cetola/reform-next-mirror/images/reform-next-cad-overview-ports.png

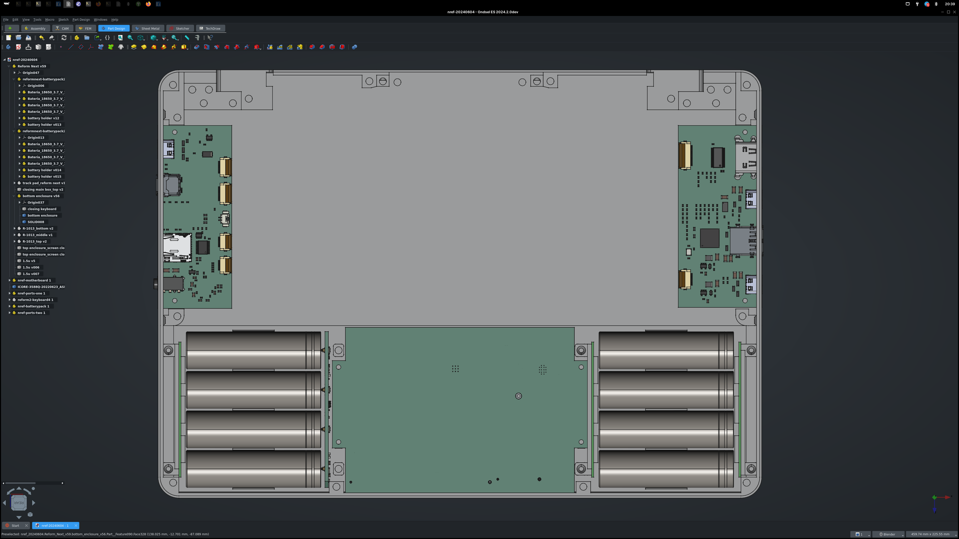
images/reform-next-cad-overview-ports.png
