cetola/reform-next-mirror/images/reform-next-ports-three-iso.png

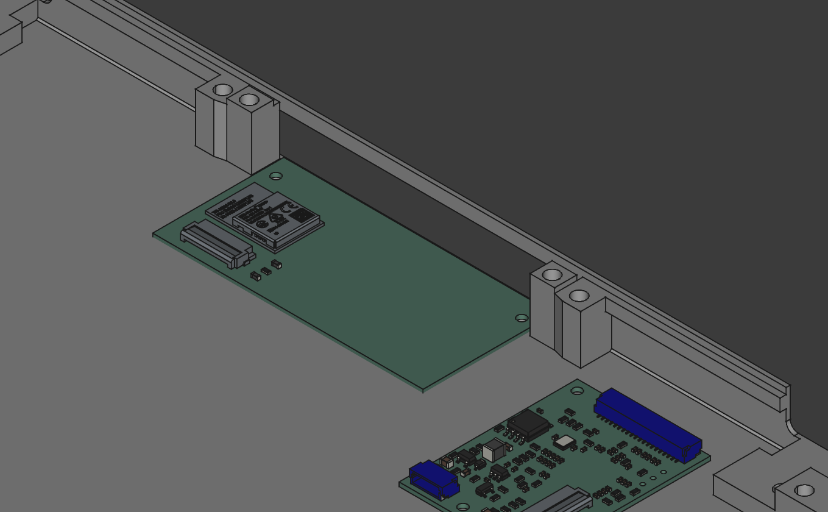
images/reform-next-ports-three-iso.png
