cetola/reform-next-mirror/images/reform-next-ports-two-with-kb.png

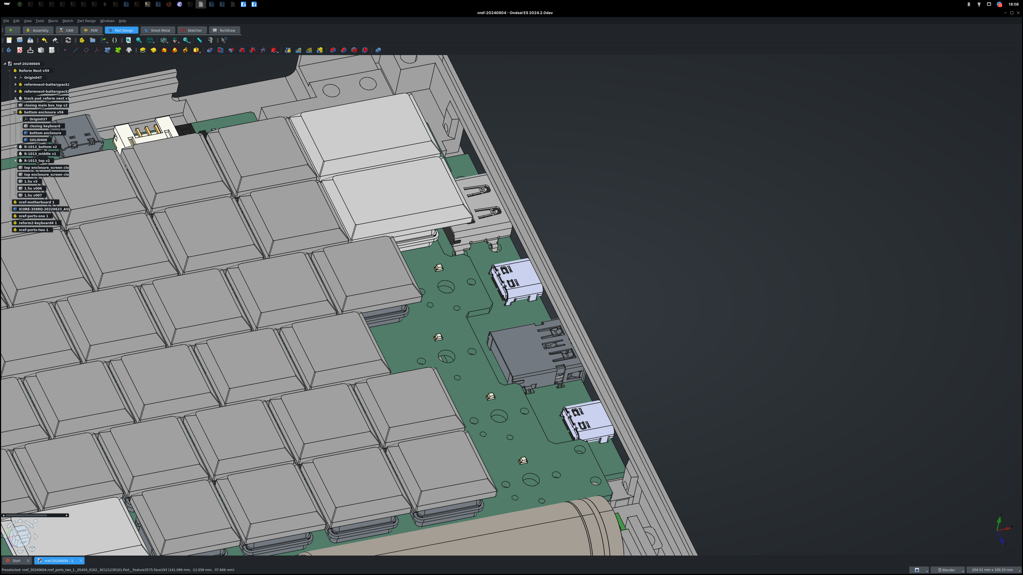
images/reform-next-ports-two-with-kb.png
