cetola/reform-next-mirror/nref-batterypack-v3/footprints/nref-battback-d1.png

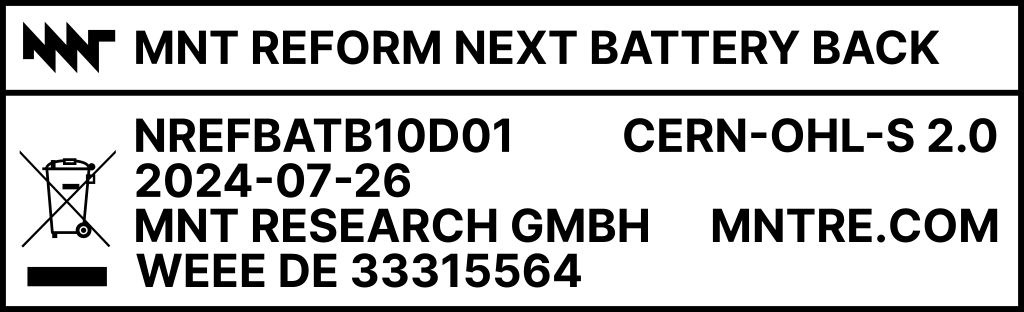
nref-batterypack-v3/footprints/nref-battback-d1.png
