cetola/reform-next-mirror/nref-batterypack-v3/footprints/nref-batttop-d3.png

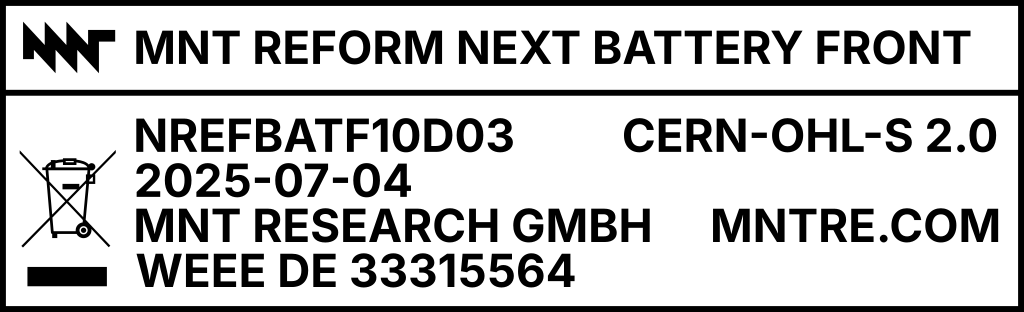
nref-batterypack-v3/footprints/nref-batttop-d3.png
