cetola/reform-next-mirror/reform-next-render.jpg

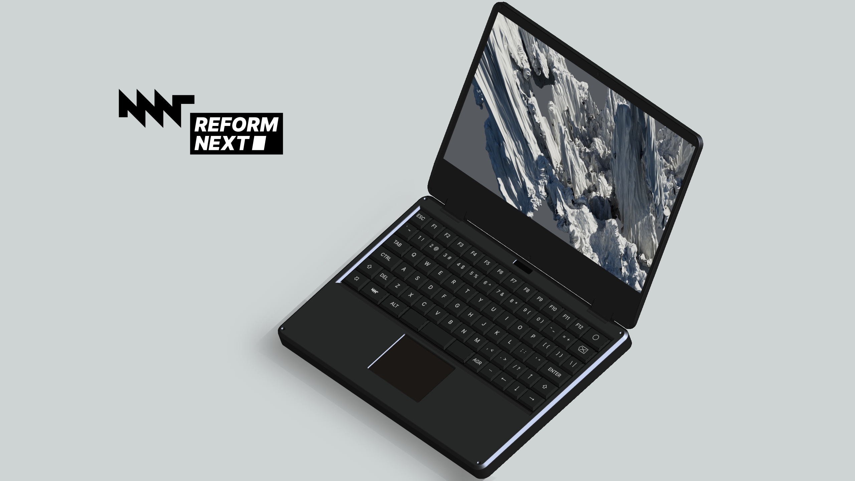
reform-next-render.jpg
