cetola/reform-next-mirror/case-proto-20240129/nref-case-20240201-assembly.FCStd

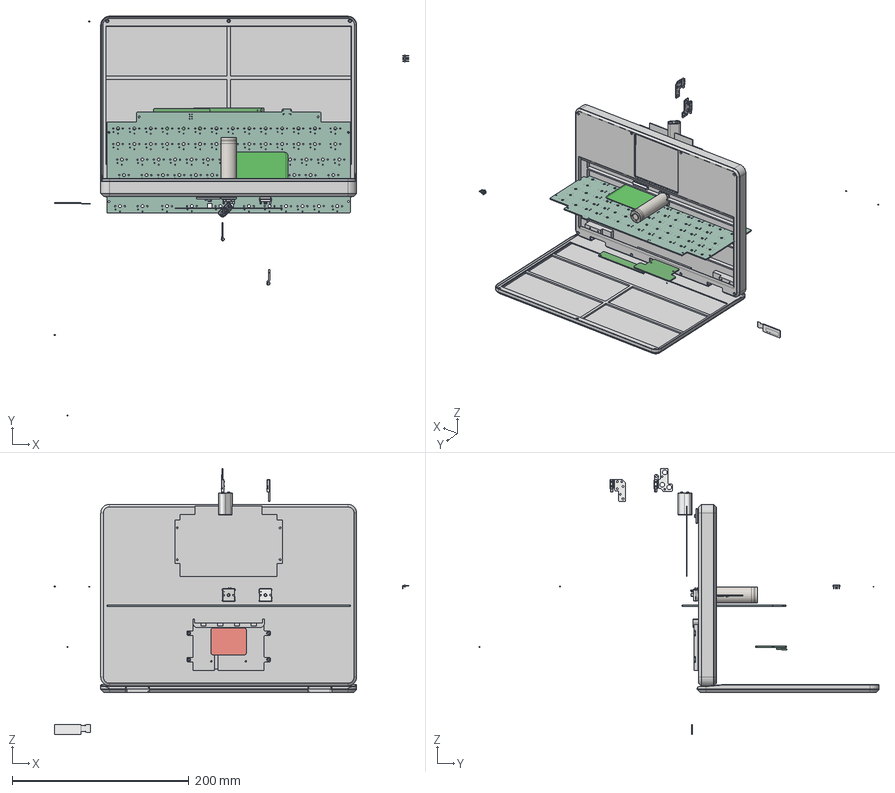
[picture p42: CAD file, 2024-02-22]
case-proto-20240129/nref-case-20240201-assembly.FCStd
402.3 x 452.9 x 301.7 mm
U-QFN-P0.5-7X7-48:1
sms-zz-219-r-1013-k:1
sms-zz-219-r-1013-k:002
sms-zz-219-r-1013-k:003
plastic battery hoder v5:1
battery pck pcb v4:1
trackingpad support_cnc:1
glass (1):1
GLUE AZOTEQ:1
GLUE SLA:1
C-0402:1
C-0603:1
R-0603:1
closing keyboard:1
bottom enclosure:1
top enclosure_screen closing v8:1
top enclosure_screen closing back v5:1
reform next motherboard v6:1
SOLID107 v1:1
COMPOUND019 v2:1
reform2-keyboard3 PCB:1
