cetola/reform-next-mirror/case-proto-20240129/bottom enclosure_2024.01.29.stl

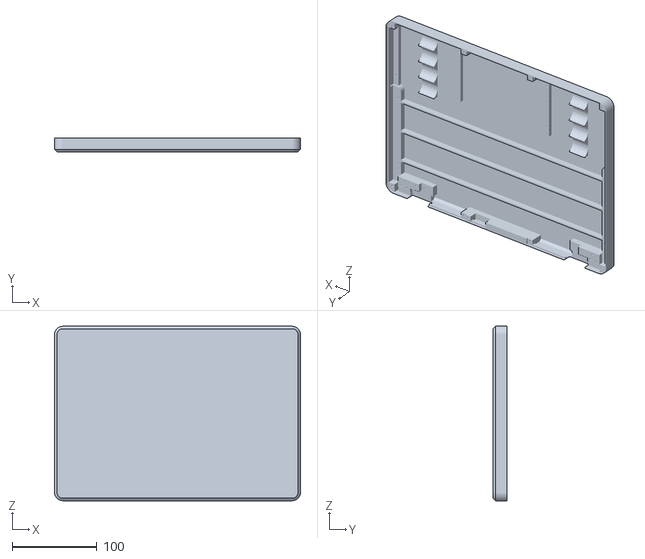
[picture p43: CAD file, 2024-02-22]
case-proto-20240129/bottom enclosure_2024.01.29.stl
290.0 x 16.5 x 205.8
