cetola/reform-next-mirror/hdmi-edp2/3d-models/SM06B-SRSS-TB.STEP

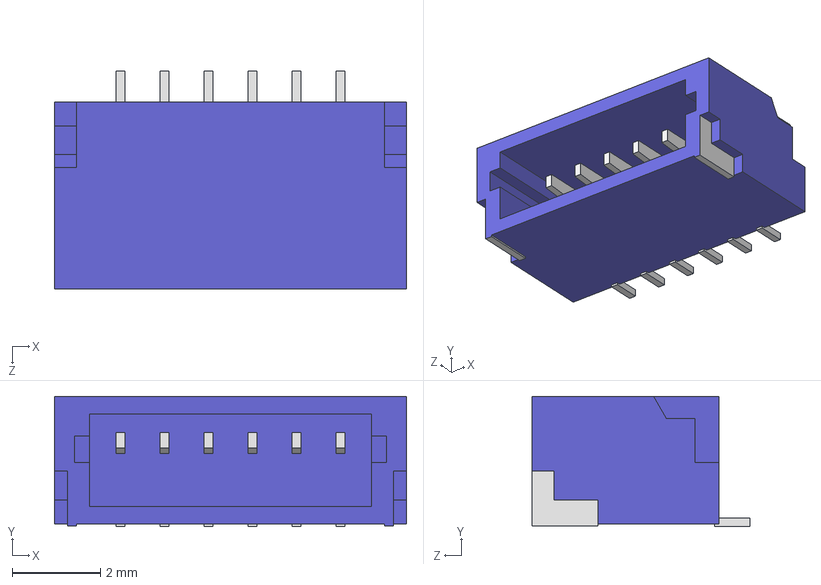
[picture p44: CAD file, 2024-04-29]
hdmi-edp2/3d-models/SM06B-SRSS-TB.STEP
8.00 x 2.96 x 4.95 mm
