cetola/reform-next-mirror/nref-batterypack-v3/3d-models/BAT-SMD_MY-FJ-115.step

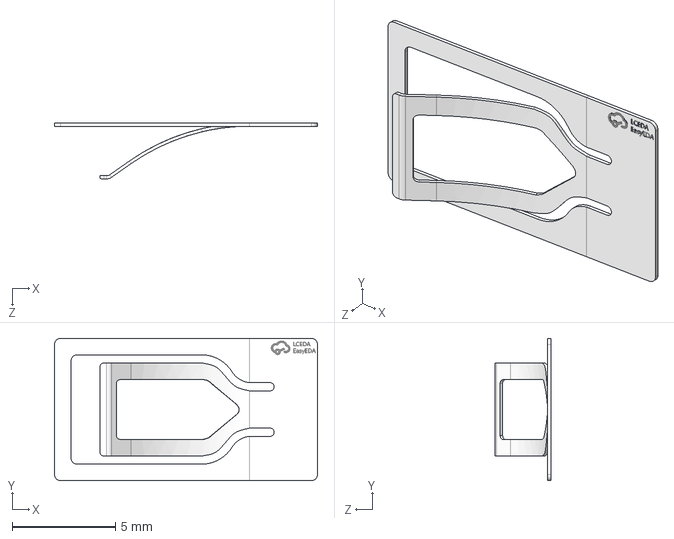
[picture p45: CAD file, 2026-09-02]
nref-batterypack-v3/3d-models/BAT-SMD_MY-FJ-115.step
12.7 x 6.90 x 2.70 mm
