cetola/reform-next-mirror/nref-camera-adapter/3d-models/SM20B-SRSS-TB.STEP

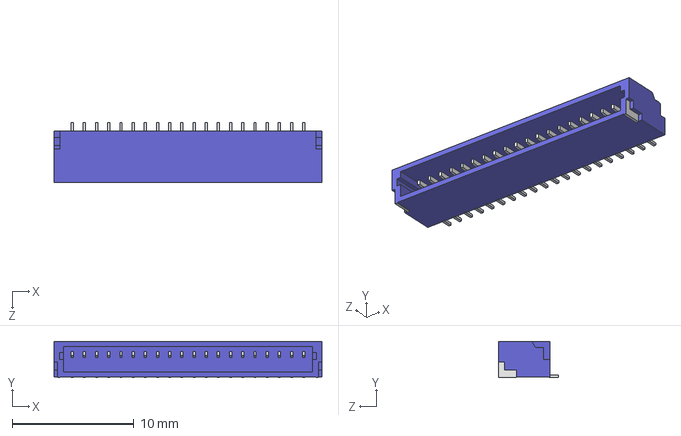
[picture p46: CAD file, 2024-04-29]
nref-camera-adapter/3d-models/SM20B-SRSS-TB.STEP
22.0 x 2.96 x 4.95 mm
