cetola/reform-next-mirror/nref-camera/3dmodels/PW0014A.stp

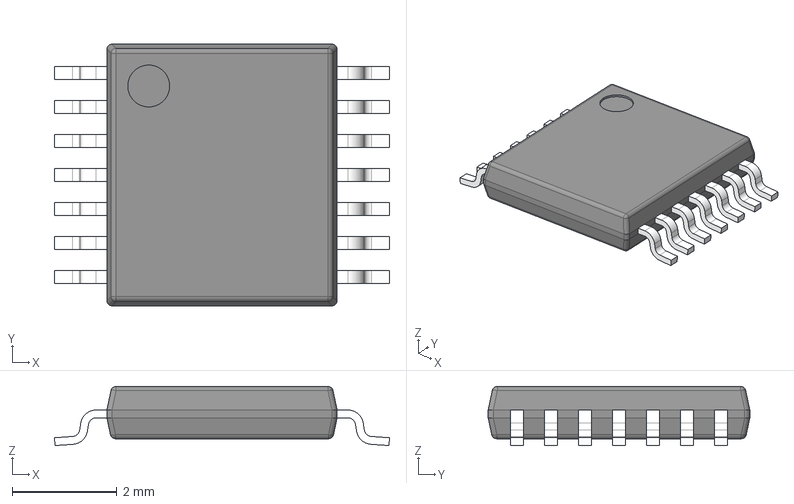
[picture p47: CAD file, 2024-08-22]
nref-camera/3dmodels/PW0014A.stp
6.40 x 5.00 x 1.13 mm
BODY-TSSOP
LEAD-TSSOP x 14
PIN1
