cetola/reform-next-mirror/nref-motherboard/3d-models/BQ25792/Part.step

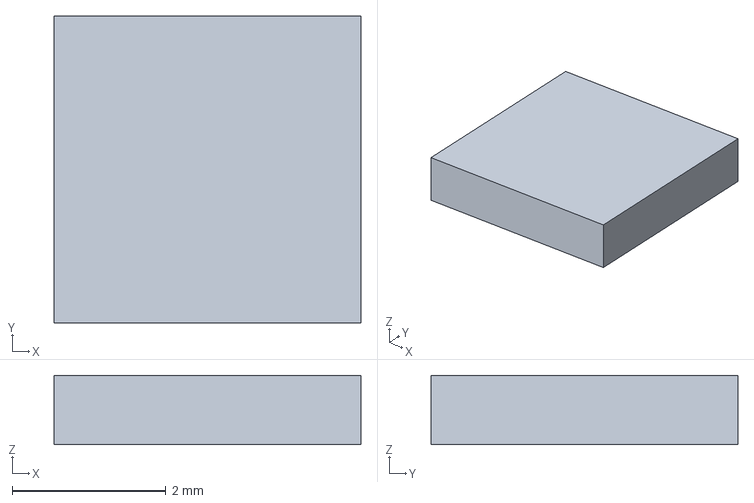
[picture p48: CAD file, 2025-02-27]
nref-motherboard/3d-models/BQ25792/Part.step
4.00 x 4.00 x 0.9 mm
