cetola/reform-next-mirror/nref-motherboard/3d-models/SM03B-SRSS-TB_LF__SN_.stp

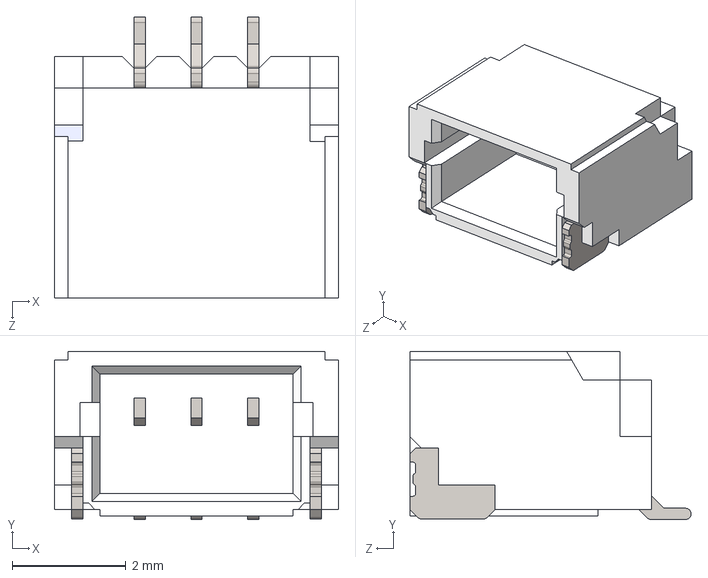
[picture p49: CAD file, 2026-05-07]
nref-motherboard/3d-models/SM03B-SRSS-TB_LF__SN_.stp
5.00 x 2.96 x 4.95 mm
