cetola/reform-next-mirror/nref-ports-one/3d-models/HX5084NLT.stp

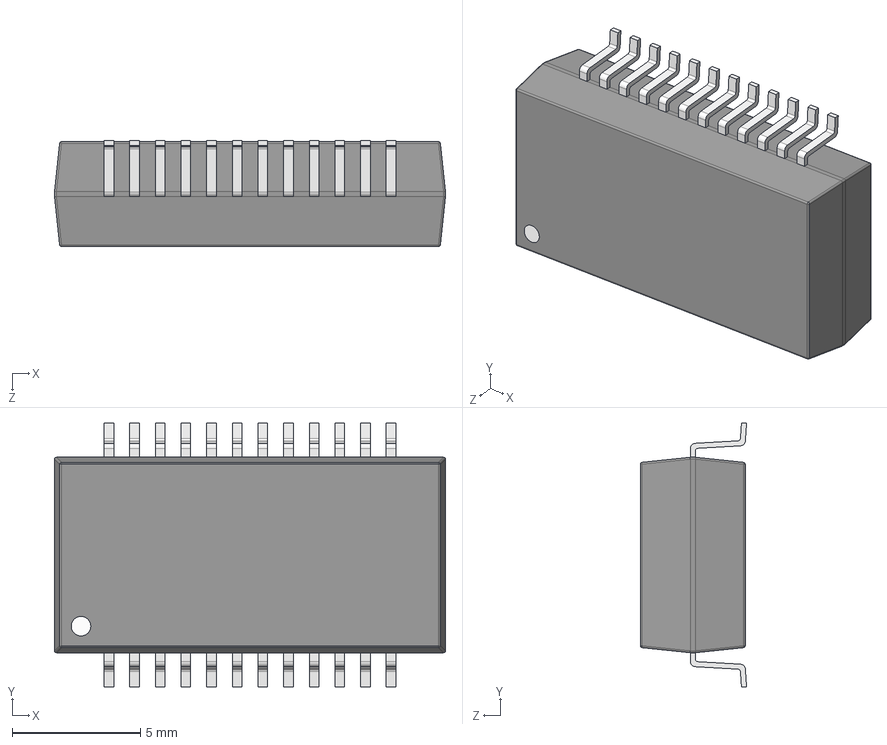
[picture p50: CAD file, 2026-09-02]
nref-ports-one/3d-models/HX5084NLT.stp
15.2 x 10.3 x 4.14 mm
