cetola/reform-next-mirror/nref-ports-two/3d-models/USB-A-SMD_HC-USB3.0-C225-P.step

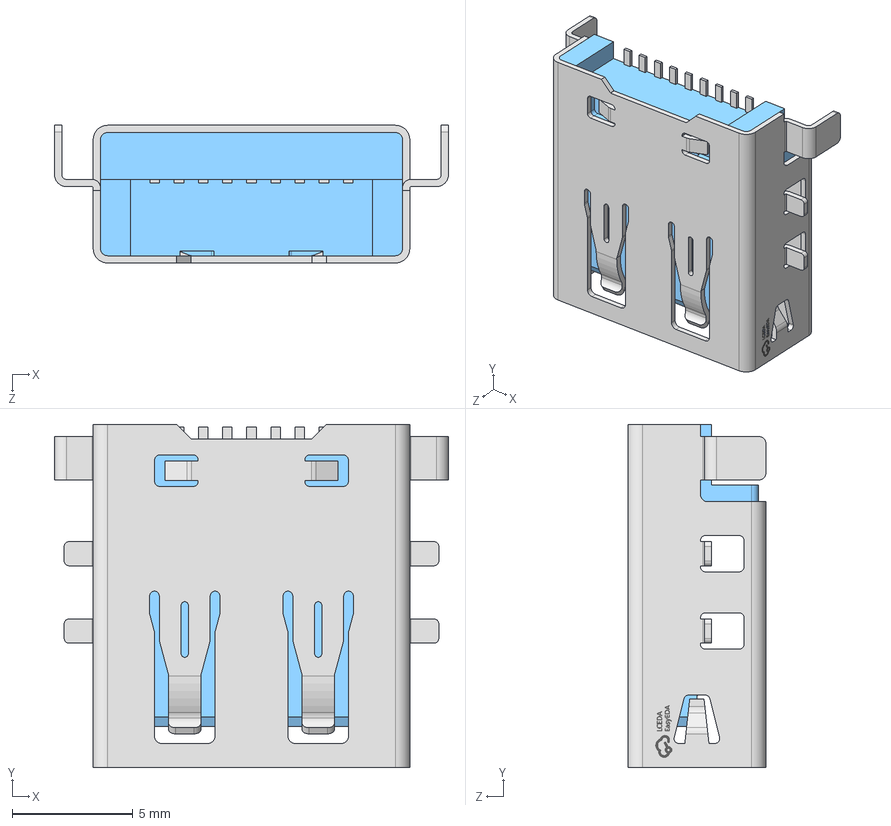
[picture p51: CAD file, 2026-07-24]
nref-ports-two/3d-models/USB-A-SMD_HC-USB3.0-C225-P.step
16.3 x 14.2 x 5.71 mm
