cetola/reform-next-mirror/nref-trackpad-mount/nref-20260419-hexplug.stl

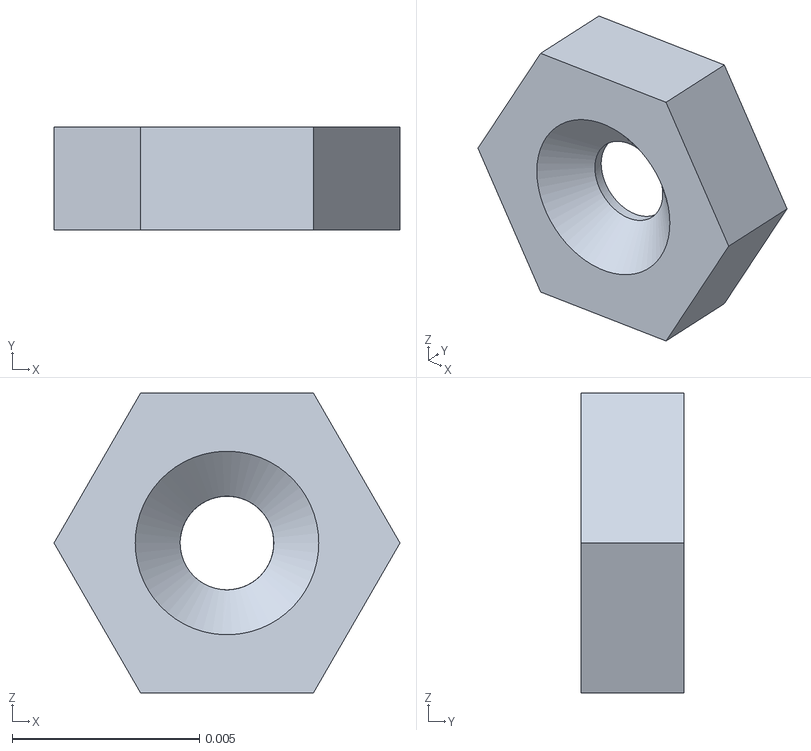
[picture p52: CAD file, 2026-08-20]
nref-trackpad-mount/nref-20260419-hexplug.stl
0.00924 x 0.00275 x 0.008
