cetola/reform-next-mirror/nref-trackpad/3d-models/nref_keycap_2024.08.20.step

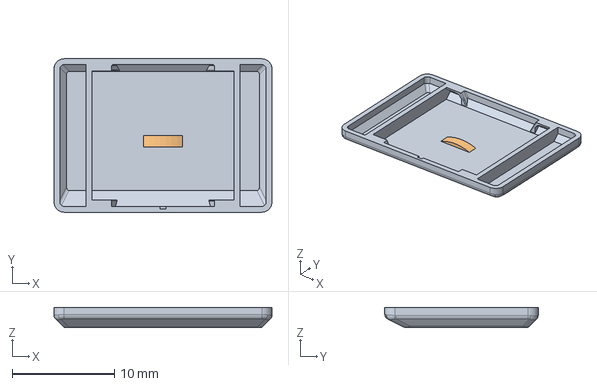
[picture p53: CAD file, 2024-08-22]
nref-trackpad/3d-models/nref_keycap_2024.08.20.step
21.3 x 15.0 x 2.00 mm
