cetola/reform-next-mirror/nref-trackpad/nref-trackpad-mount-20241202.stl

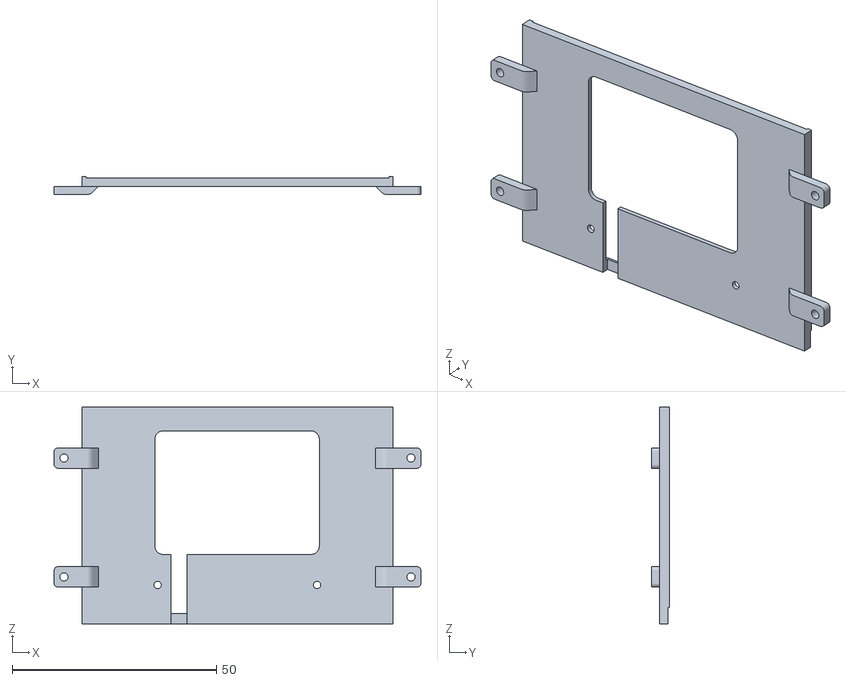
[picture p54: CAD file, 2024-12-27]
nref-trackpad/nref-trackpad-mount-20241202.stl
89.8 x 4.44 x 53.1
