cetola/reform-next-mirror/nref-usb3-redriver/3d-models/RGE0024C.stp

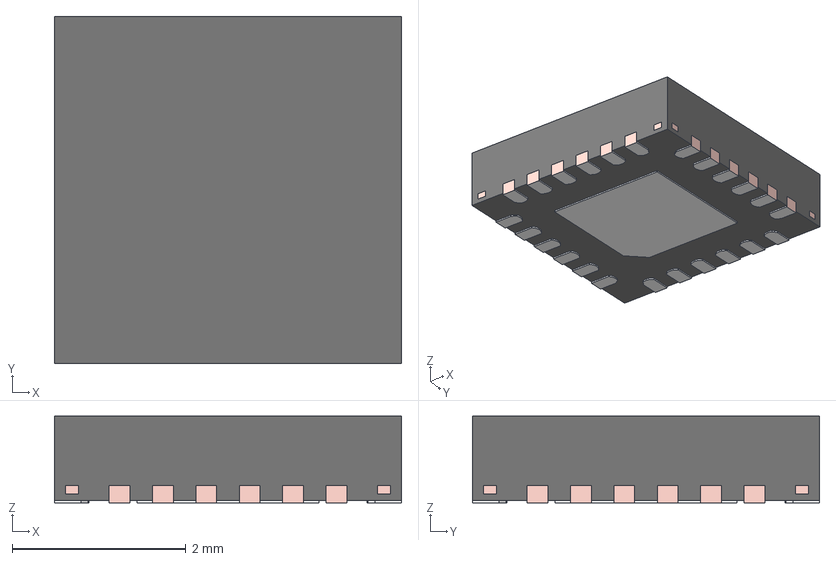
[picture p55: CAD file, 2025-09-24]
nref-usb3-redriver/3d-models/RGE0024C.stp
4.00 x 4.00 x 1.00 mm
FRAME
