cetola/reform-next-mirror/nref-wifi-m2/3d-models/User Library-PCIe_M_2_Key-E_2230_RF.STEP

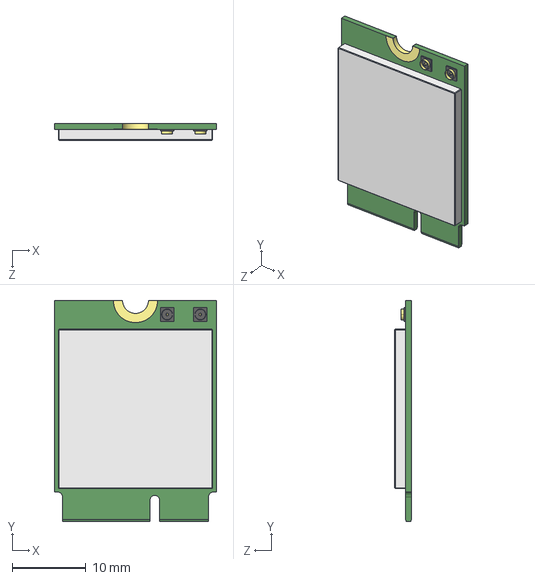
[picture p56: CAD file, 2025-09-24]
nref-wifi-m2/3d-models/User Library-PCIe_M_2_Key-E_2230_RF.STEP
22.0 x 30.0 x 2.30 mm
