cetola/reform-next-mirror/nref-batterypack-v3/3d-models/2036-3-57-15-00-00-03-0.stp

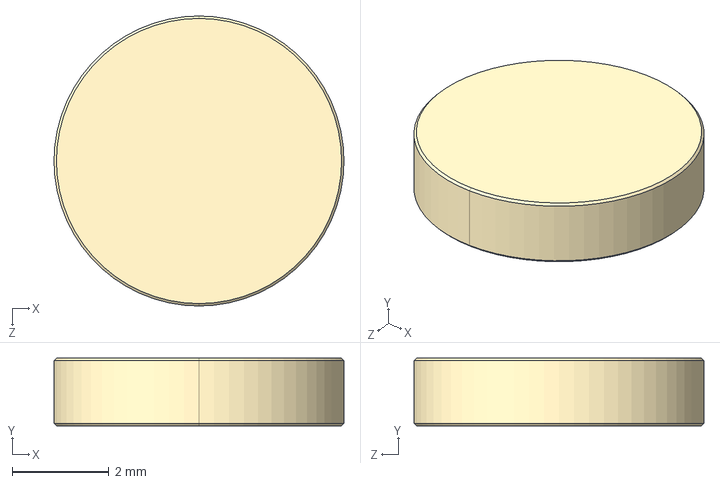
[picture p58: CAD file, 2026-09-02]
nref-batterypack-v3/3d-models/2036-3-57-15-00-00-03-0.stp
5.99 x 1.40 x 5.99 mm
