cetola/reform-next-mirror/nref-camera/3dmodels/WLCSP-6_2x3_0.8x1.2mm.STEP

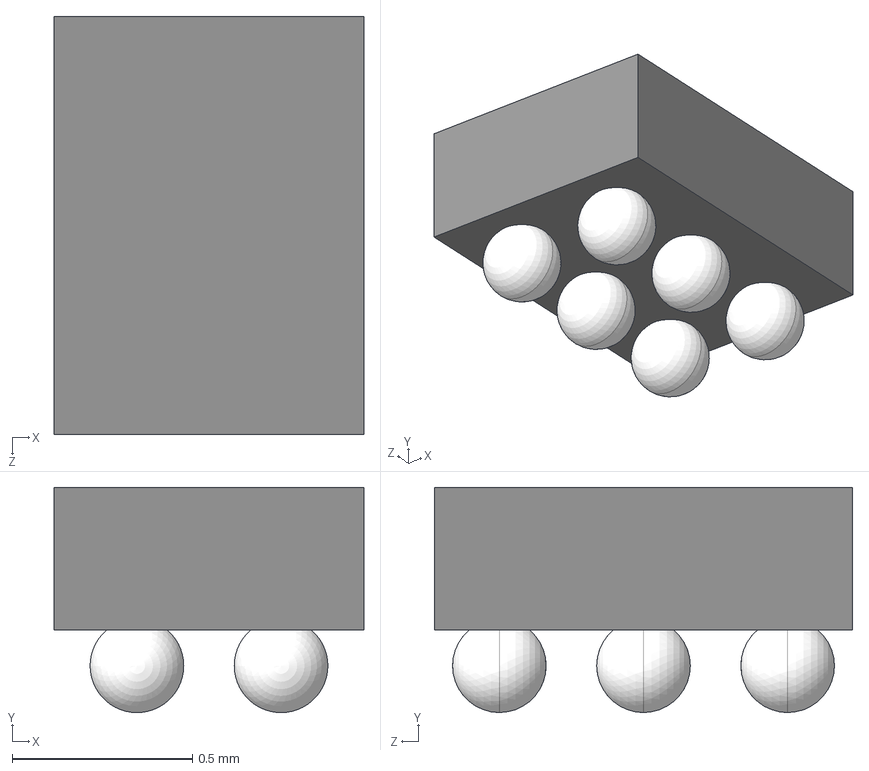
[picture p59: CAD file, 2024-08-15]
nref-camera/3dmodels/WLCSP-6_2x3_0.8x1.2mm.STEP
0.86 x 0.625 x 1.16 mm
