cetola/reform-next-mirror/nref-motherboard/3d-models/SM04B-SRSS-TB.STEP

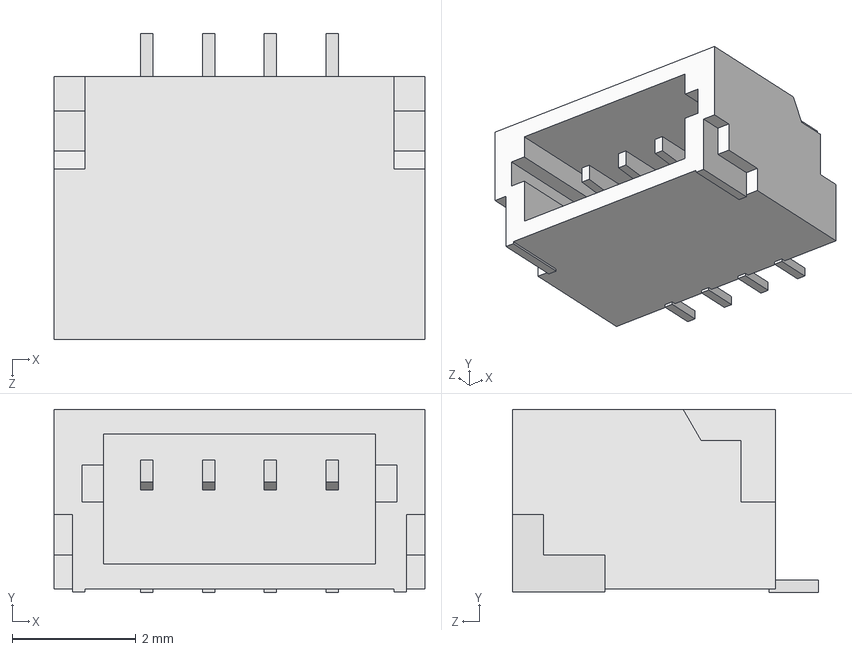
[picture p60: CAD file, 2026-05-07]
nref-motherboard/3d-models/SM04B-SRSS-TB.STEP
6.00 x 2.96 x 4.95 mm
