cetola/reform-next-mirror/nref-ports-two/3d-models/FPC-SMD_L15.6-W5.4-H2.0-AFC07-S20ECC-00.step

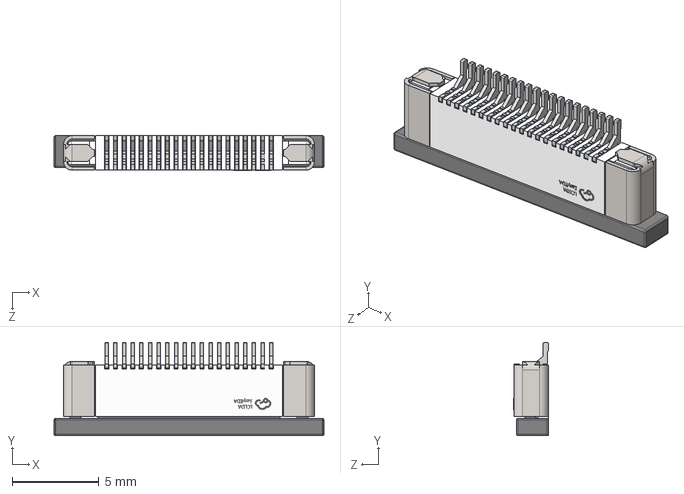
[picture p61: CAD file, 2026-07-24]
nref-ports-two/3d-models/FPC-SMD_L15.6-W5.4-H2.0-AFC07-S20ECC-00.step
15.6 x 5.40 x 2.01 mm
