cetola/reform-next-mirror/nref-wifi-m2/3d-models/c-2199119-4-c-3d.stp

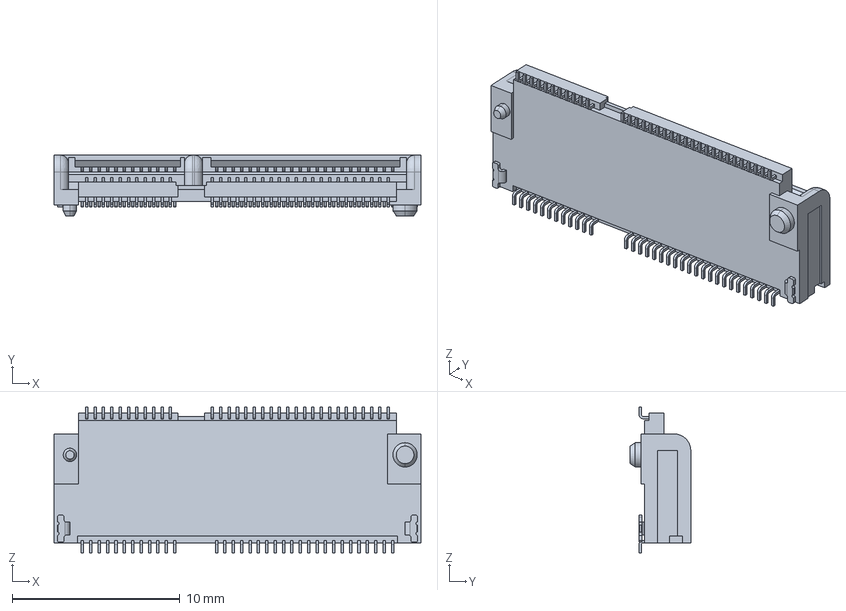
[picture p62: CAD file, 2025-09-24]
nref-wifi-m2/3d-models/c-2199119-4-c-3d.stp
21.9 x 3.62 x 8.70 mm
