cetola/reform-next-mirror/nref-batterypack-v3/3d-models/L4CA0612LR015FNR.stp

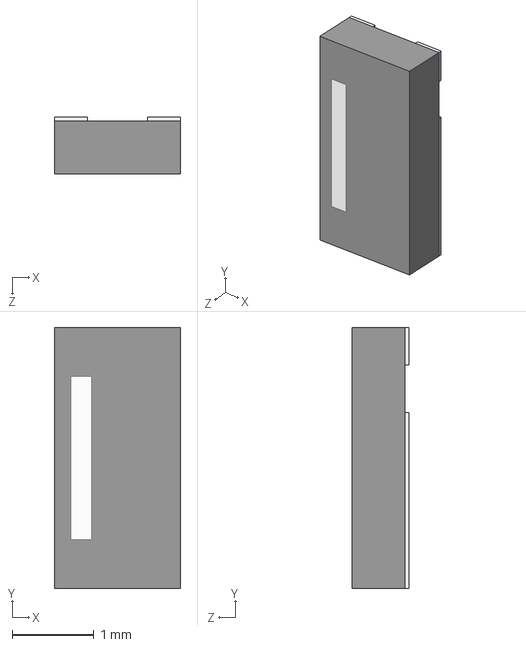
[picture p64: CAD file, 2025-09-24]
nref-batterypack-v3/3d-models/L4CA0612LR015FNR.stp
1.55 x 3.20 x 0.7 mm
