cetola/reform-next-mirror/nref-camera/3dmodels/K3D-DX07S024WJ3-V2_JAE_Proprietary.STEP

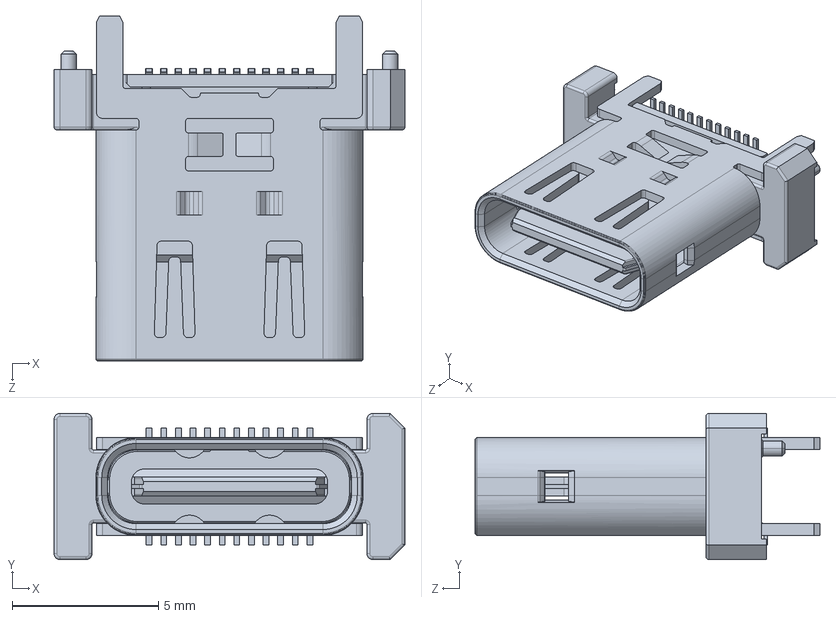
[picture p65: CAD file, 2024-08-15]
nref-camera/3dmodels/K3D-DX07S024WJ3-V2_JAE_Proprietary.STEP
12.0 x 5.00 x 11.8 mm
