cetola/reform-next-mirror/nref-ports-one/3d-models/PCA9557RGVR.stp

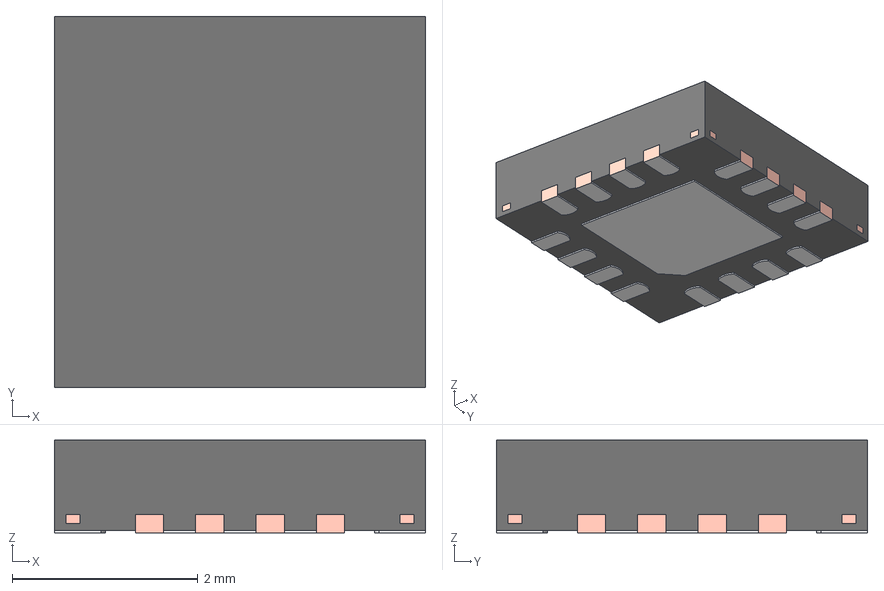
[picture p66: CAD file, 2025-11-12]
nref-ports-one/3d-models/PCA9557RGVR.stp
4.00 x 4.00 x 1.00 mm
FRAME
PIN1_AREA
