cetola/reform-next-mirror/nref-ports-two/3d-models/SFV20R-2STE1HLF.step

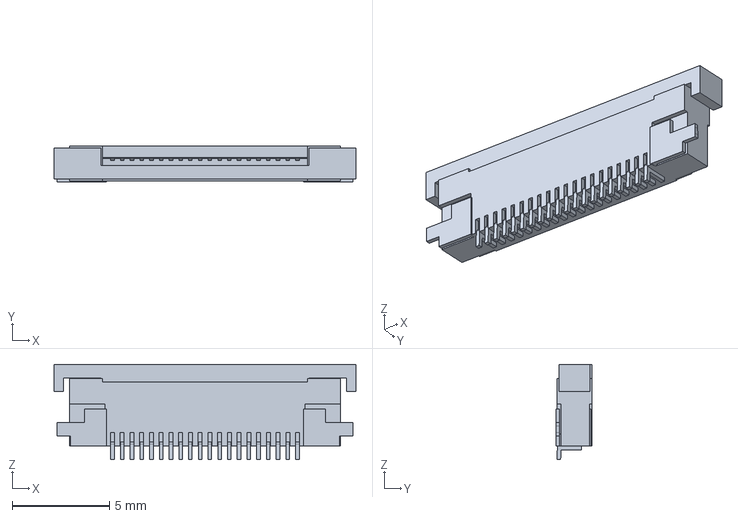
[picture p67: CAD file, 2025-11-19]
nref-ports-two/3d-models/SFV20R-2STE1HLF.step
15.5 x 1.87 x 4.90 mm
