cetola/reform-next-mirror/nref-batterypack-v3/3d-models/S1741-46R.stp

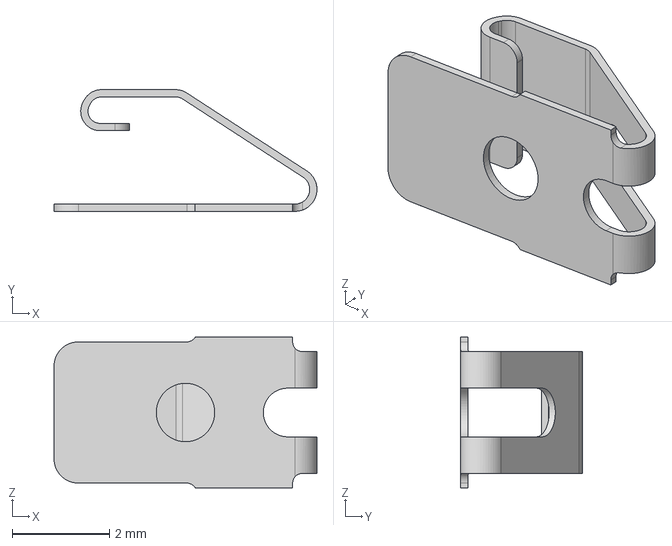
[picture p68: CAD file, 2025-09-24]
nref-batterypack-v3/3d-models/S1741-46R.stp
5.40 x 2.50 x 3.10 mm
