cetola/reform-next-mirror/nref-camera/3dmodels/YFP4.step

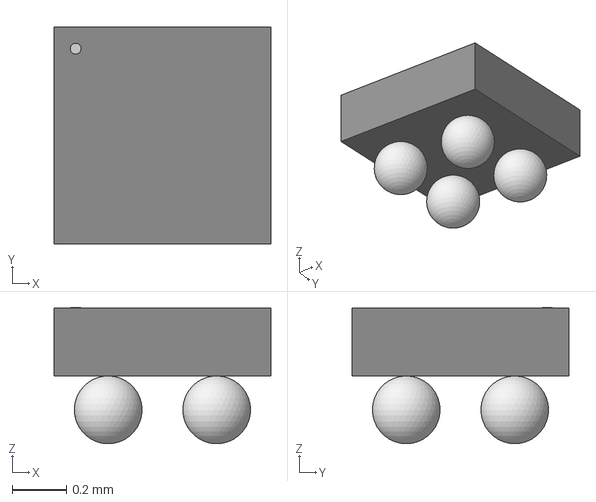
[picture p69: CAD file, 2024-08-15]
nref-camera/3dmodels/YFP4.step
0.8 x 0.8 x 0.503 mm
