cetola/reform-next-mirror/nref-motherboard/3d-models/AOTA-B201610S3R3-101-T.stp

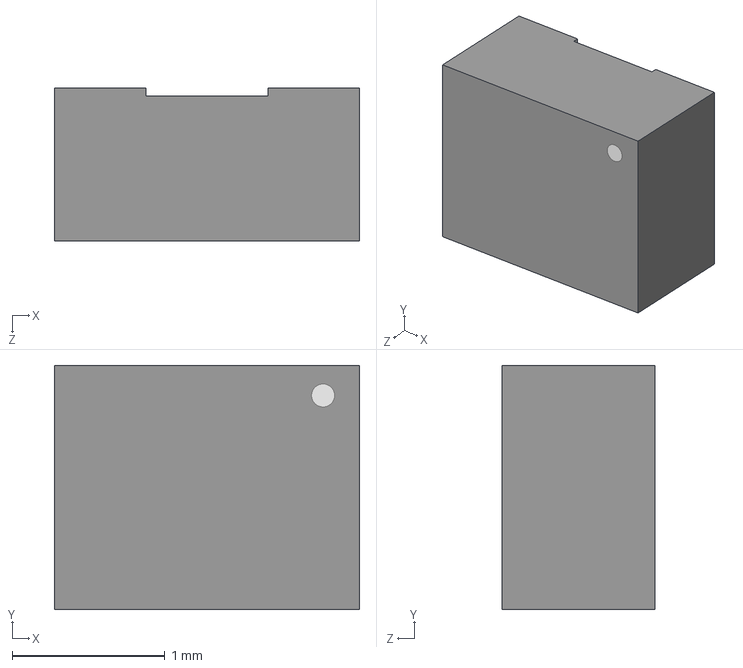
[picture p70: CAD file, 2026-05-07]
nref-motherboard/3d-models/AOTA-B201610S3R3-101-T.stp
2.00 x 1.60 x 1.00 mm
