cetola/reform-next-mirror/nref-ports-one/3d-models/B3U-3000P--3DModel-STEP-56544.STEP

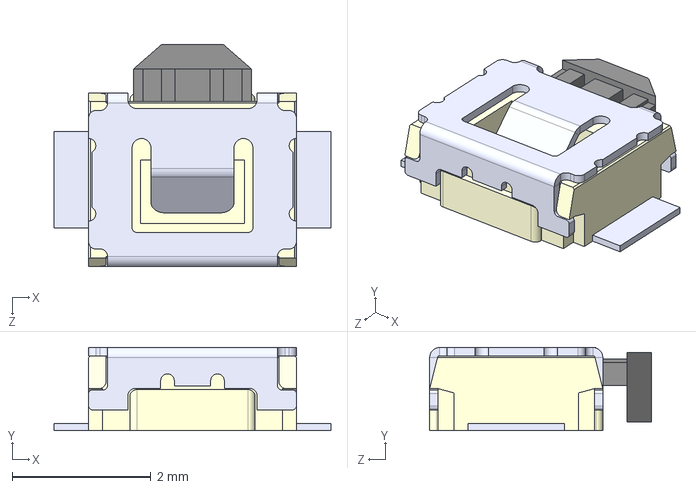
[picture p71: CAD file, 2025-10-31]
nref-ports-one/3d-models/B3U-3000P--3DModel-STEP-56544.STEP
4.00 x 1.20 x 3.20 mm
