cetola/reform-next-mirror/nref-ports-two/3d-models/EQCO5X31C0-I_6NX.stp

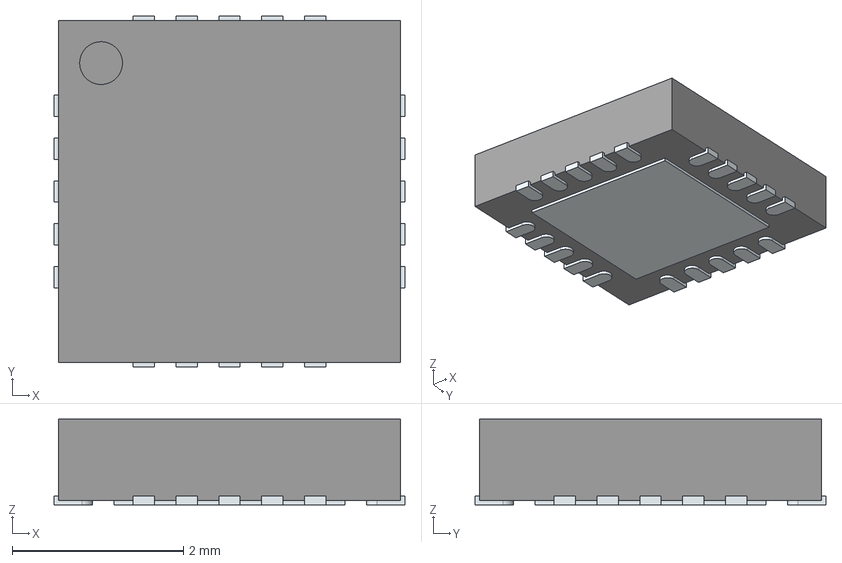
[picture p72: CAD file, 2025-10-31]
nref-ports-two/3d-models/EQCO5X31C0-I_6NX.stp
4.10 x 4.10 x 1.00 mm
ThermalPin
PinsArrayLR
PinsArrayTB
