cetola/reform-next-mirror/case-proto-20240129/top enclosure_screen closing back_2024.01.29.stl

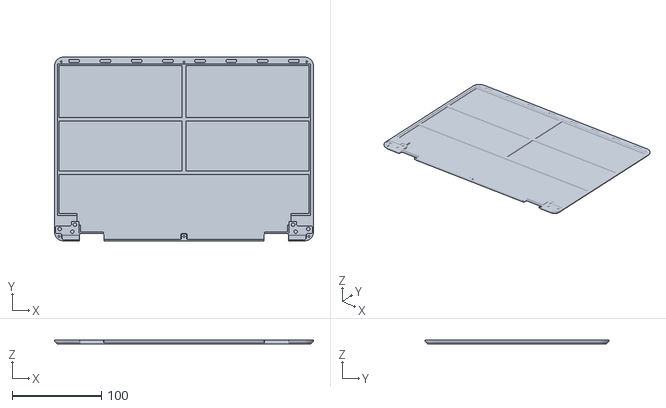
[picture p73: CAD file, 2024-02-22]
case-proto-20240129/top enclosure_screen closing back_2024.01.29.stl
290.0 x 205.8 x 4.50
