cetola/reform-next-mirror/nref-camera/3dmodels/Nexperia-WLCSP5_2-1-2_0.77x1.17mm.step

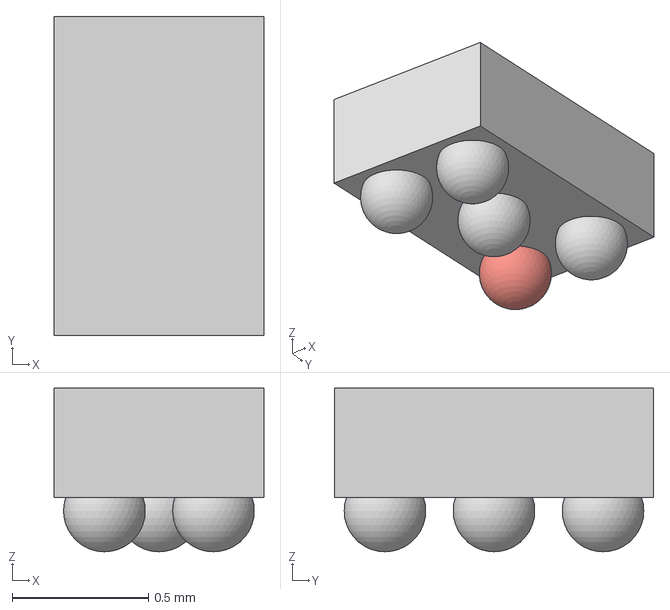
[picture p74: CAD file, 2024-08-15]
nref-camera/3dmodels/Nexperia-WLCSP5_2-1-2_0.77x1.17mm.step
0.77 x 1.17 x 0.6 mm
