cetola/reform-next-mirror/nref-motherboard/3d-models/SSD.STEP

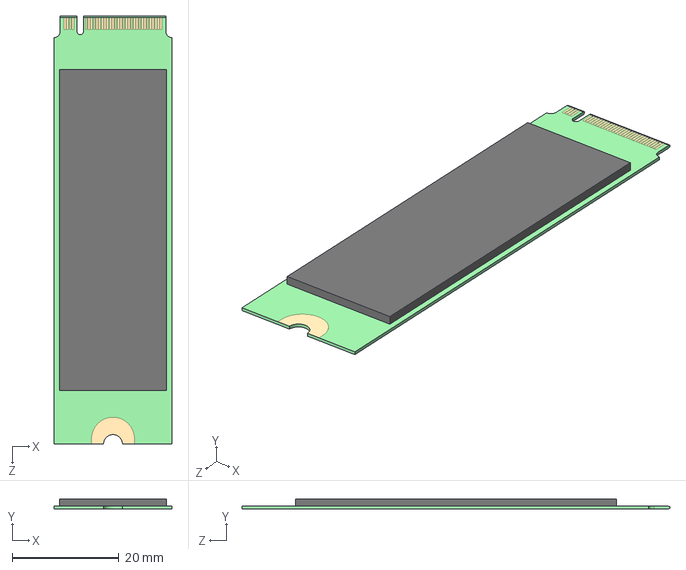
[picture p75: CAD file, 2026-05-07]
nref-motherboard/3d-models/SSD.STEP
22.0 x 1.86 x 80.0 mm
