cetola/reform-next-mirror/nref-ports-one/3d-models/YBG0028_TEX.step

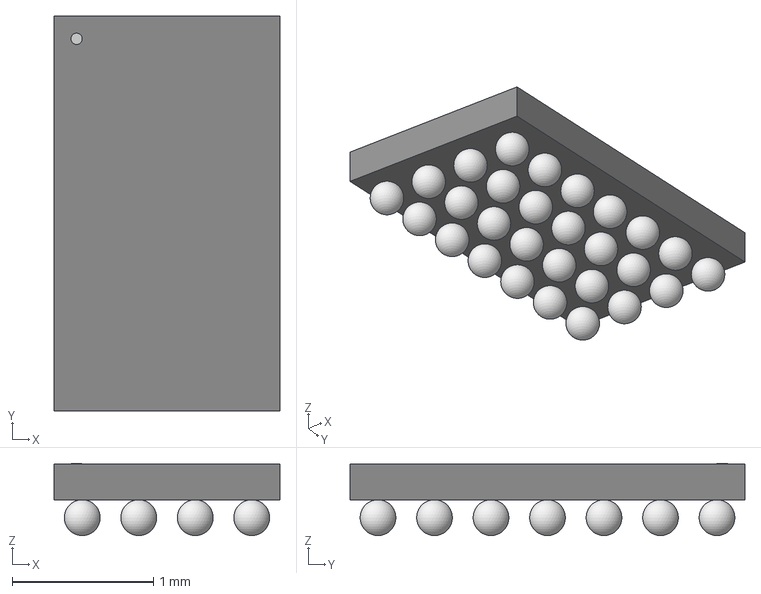
[picture p76: CAD file, 2025-10-31]
nref-ports-one/3d-models/YBG0028_TEX.step
1.60 x 2.79 x 0.511 mm
