cetola/reform-next-mirror/nref-ports-two/3d-models/HD3SS3220IRNHT.step

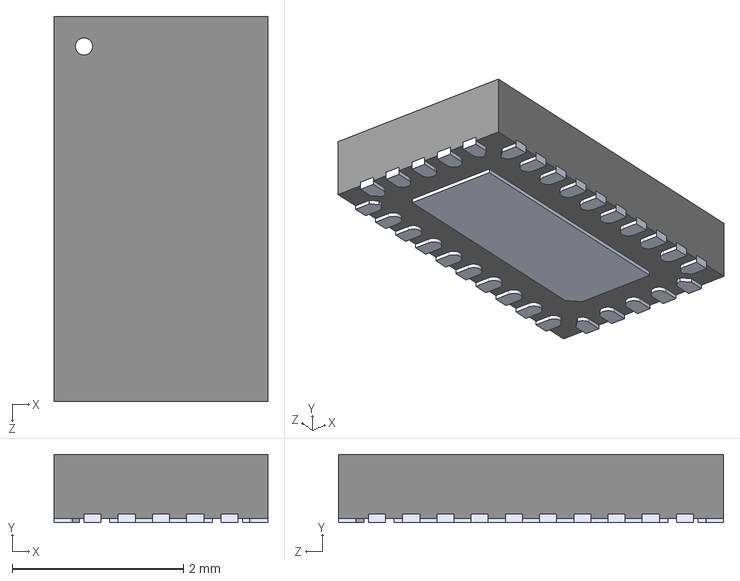
[picture p77: CAD file, 2024-06-14]
nref-ports-two/3d-models/HD3SS3220IRNHT.step
2.50 x 0.8 x 4.50 mm
