cetola/reform-next-mirror/case-proto-20240129/closing keyboard_2024.01.29.stl

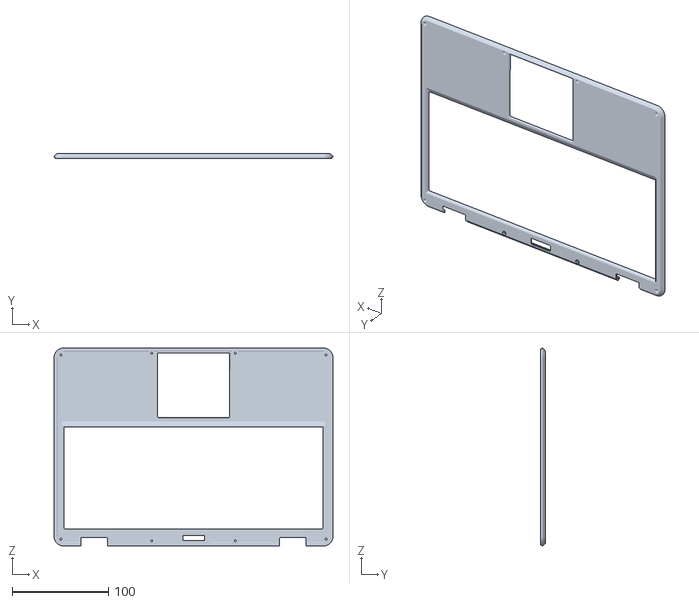
[picture p78: CAD file, 2024-02-22]
case-proto-20240129/closing keyboard_2024.01.29.stl
290.0 x 5.00 x 205.8
