cetola/reform-next-mirror/nref-batterypack-v3/3d-models/S70-332002045R.stp

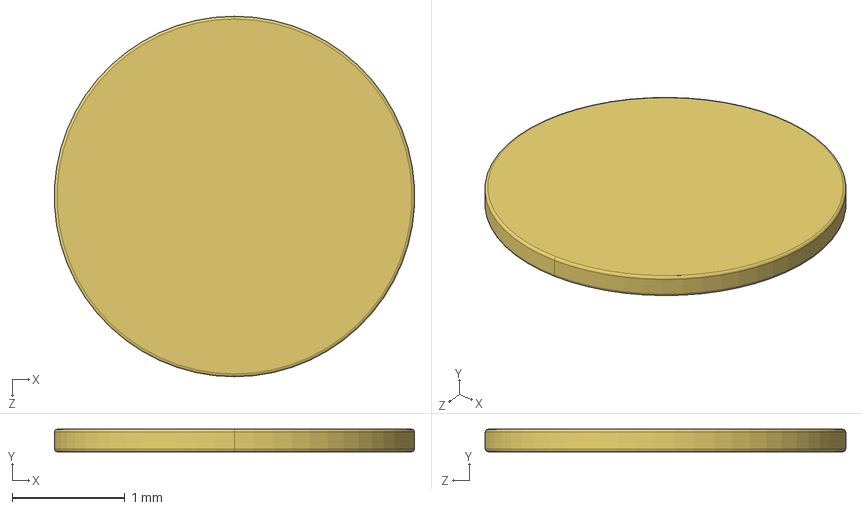
[picture p79: CAD file, 2025-09-24]
nref-batterypack-v3/3d-models/S70-332002045R.stp
3.20 x 0.2 x 3.20 mm
