cetola/reform-next-mirror/nref-camera/3dmodels/CYUSB3064-BZXI.STEP

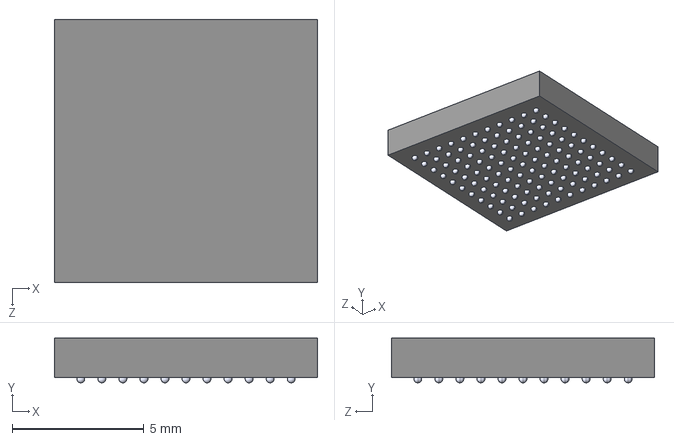
[picture p80: CAD file, 2024-08-15]
nref-camera/3dmodels/CYUSB3064-BZXI.STEP
10.0 x 1.70 x 10.0 mm
