cetola/reform-next-mirror/nref-ports-one/3d-models/RKS0020A.stp

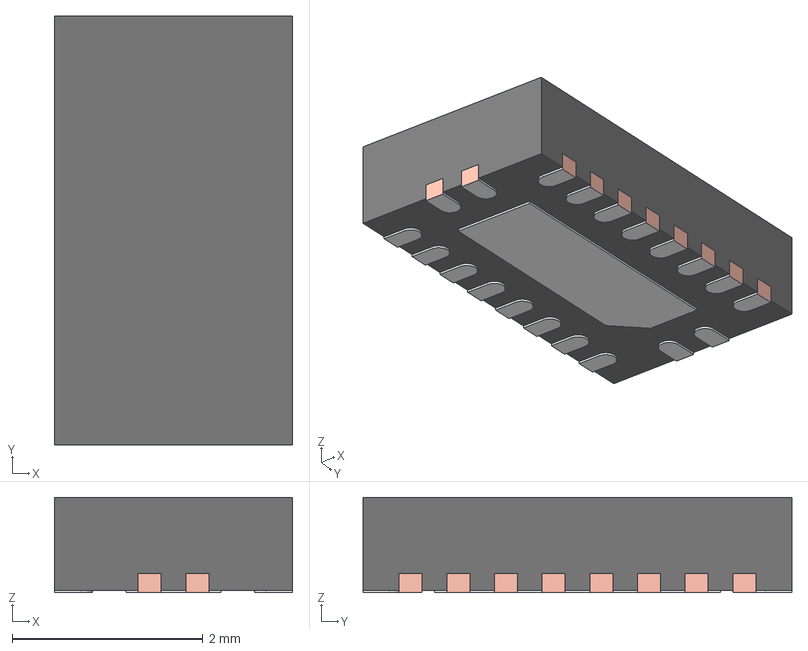
[picture p82: CAD file, 2024-08-15]
nref-ports-one/3d-models/RKS0020A.stp
2.50 x 4.50 x 1.00 mm
BODY-QFN
FRAME-RKS0020A
PIN1-ID
