cetola/reform-next-mirror/nref-ports-two/3d-models/HD09-19-MSMT-TR.stp

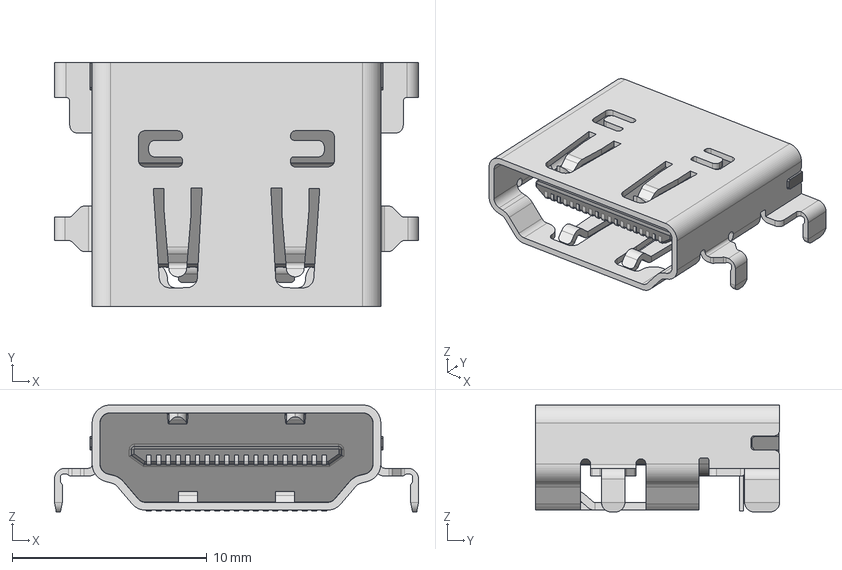
[picture p83: CAD file, 2024-06-11]
nref-ports-two/3d-models/HD09-19-MSMT-TR.stp
18.7 x 12.6 x 5.50 mm
