cetola/reform-next-mirror/nref-batterypack-v3/3d-models/BM07B-SRSS-TB.STEP

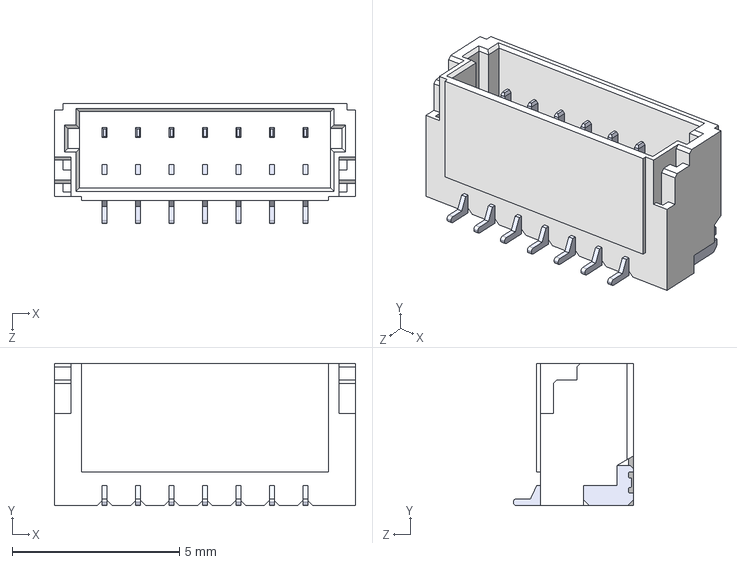
[picture p84: CAD file, 2025-09-24]
nref-batterypack-v3/3d-models/BM07B-SRSS-TB.STEP
9.00 x 4.25 x 3.60 mm
