cetola/reform-next-mirror/nref-camera/3dmodels/USB4115-03-C.stp

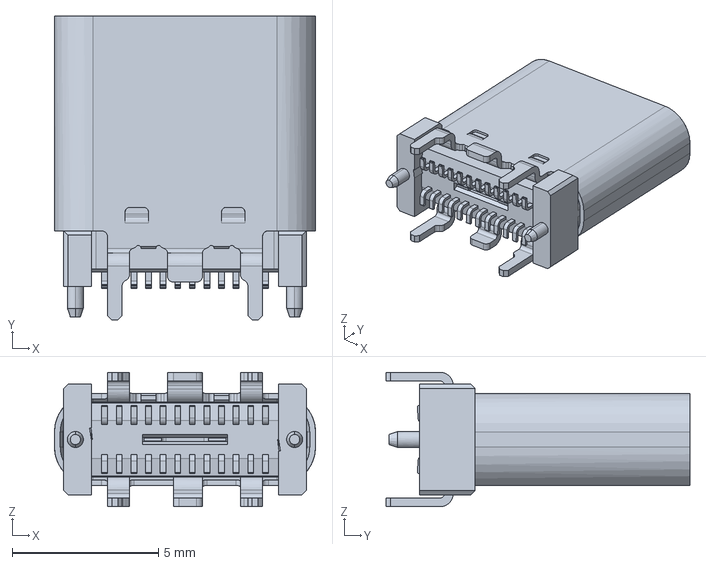
[picture p85: CAD file, 2024-08-15]
nref-camera/3dmodels/USB4115-03-C.stp
8.94 x 10.4 x 4.60 mm
