cetola/reform-next-mirror/nref-motherboard/3d-models/SM02B-SRSS-TB.STEP

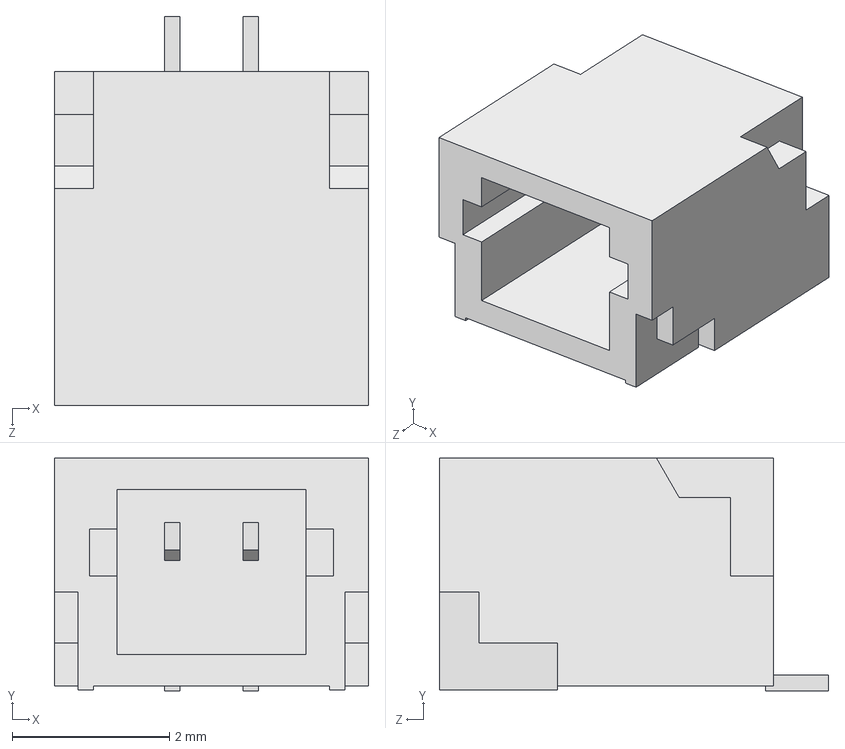
[picture p86: CAD file, 2026-05-07]
nref-motherboard/3d-models/SM02B-SRSS-TB.STEP
4.00 x 2.96 x 4.95 mm
