cetola/reform-next-mirror/nref-ports-one/3d-models/FUSB302BMPX.STEP

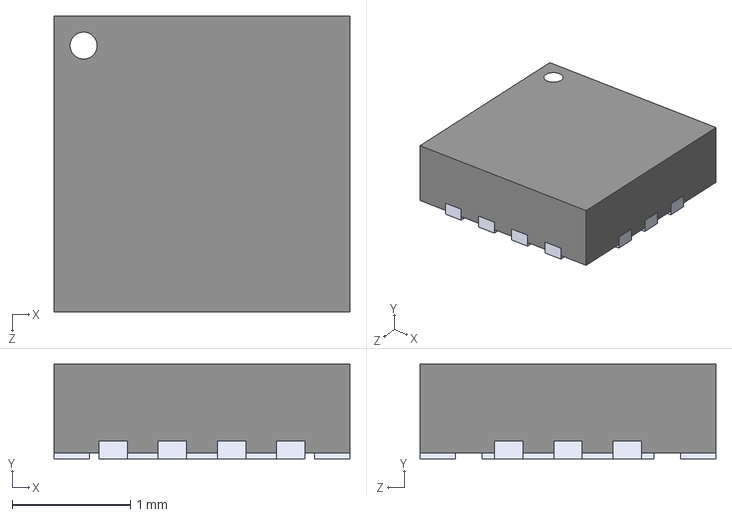
[picture p87: CAD file, 2024-06-14]
nref-ports-one/3d-models/FUSB302BMPX.STEP
2.50 x 0.8 x 2.50 mm
