cetola/reform-next-mirror/nref-ports-two/3d-models/CUI_DEVICES_SJ-43614-SMT-TR.step

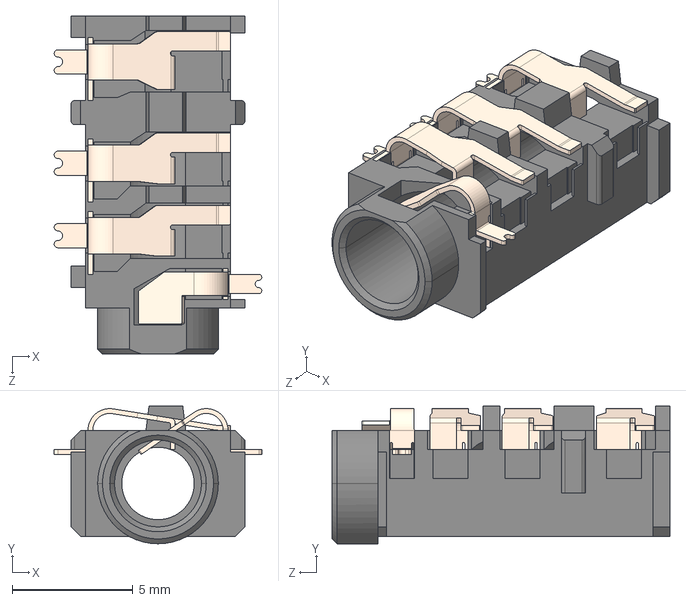
[picture p88: CAD file, 2024-06-11]
nref-ports-two/3d-models/CUI_DEVICES_SJ-43614-SMT-TR.step
8.60 x 5.70 x 14.0 mm
