cetola/reform-next-mirror/nref-motherboard/3d-models/SSD-2280-D2-M-B.STEP

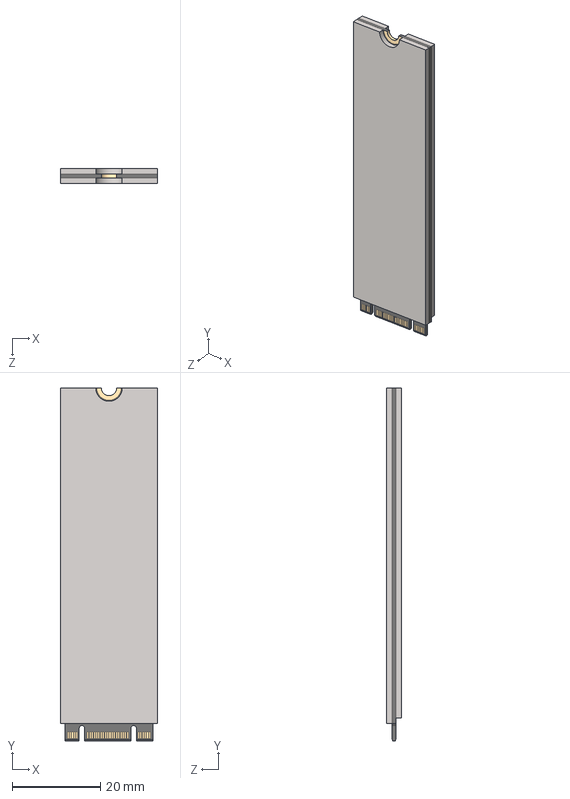
[picture p89: CAD file, 2026-05-07]
nref-motherboard/3d-models/SSD-2280-D2-M-B.STEP
22.0 x 80.0 x 3.50 mm
