cetola/reform-next-mirror/nref-ports-two/3d-models/CUI_DEVICES_SJ2-3593D-SMT-TR.step

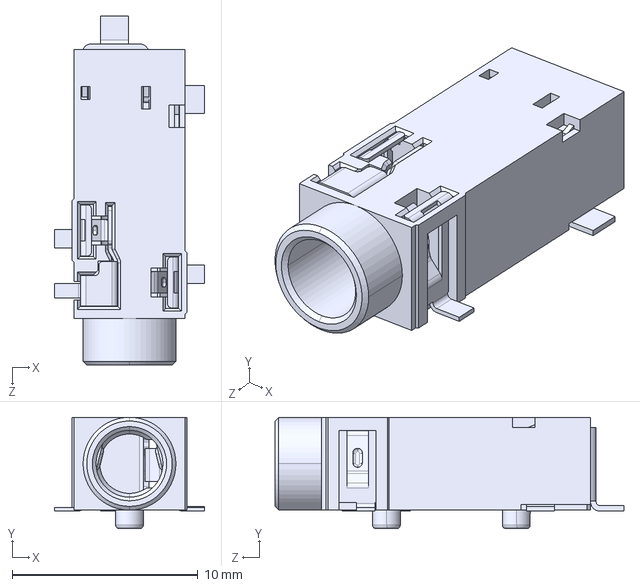
[picture p90: CAD file, 2024-06-11]
nref-ports-two/3d-models/CUI_DEVICES_SJ2-3593D-SMT-TR.step
8.10 x 6.00 x 18.8 mm
