cetola/reform-next-mirror/nref-camera/3dmodels/BGA_1R1YKAR_TEX.step

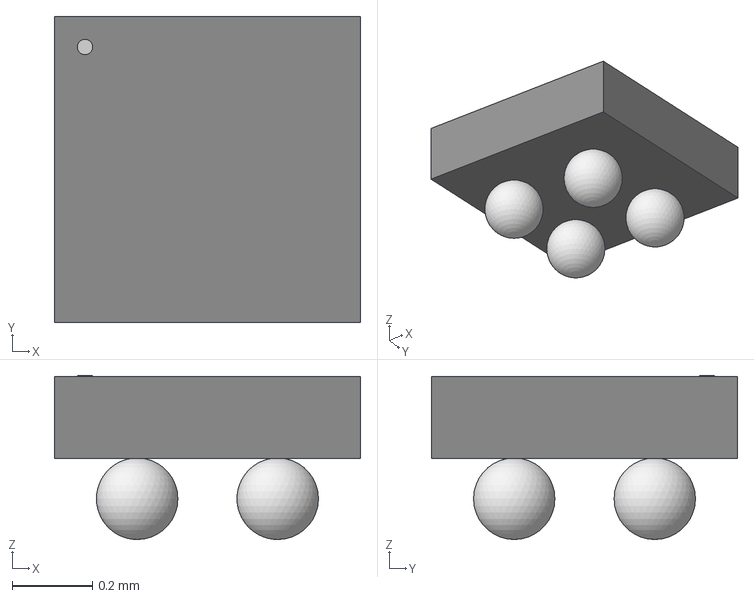
[picture p91: CAD file, 2024-08-15]
nref-camera/3dmodels/BGA_1R1YKAR_TEX.step
0.762 x 0.762 x 0.409 mm
