cetola/reform-next-mirror/nref-motherboard/3d-models/SM09B-SRSS-TB.STEP

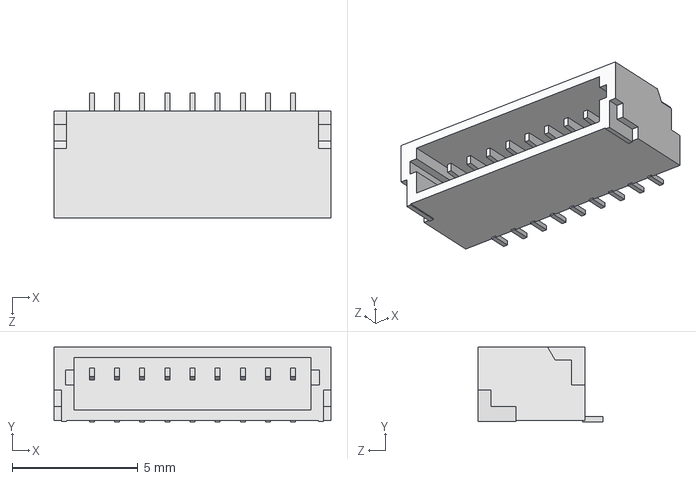
[picture p92: CAD file, 2026-05-07]
nref-motherboard/3d-models/SM09B-SRSS-TB.STEP
11.0 x 2.96 x 4.95 mm
