cetola/reform-next-mirror/nref-ports-two/3d-models/DM3AT-SF-PEJM5.stp

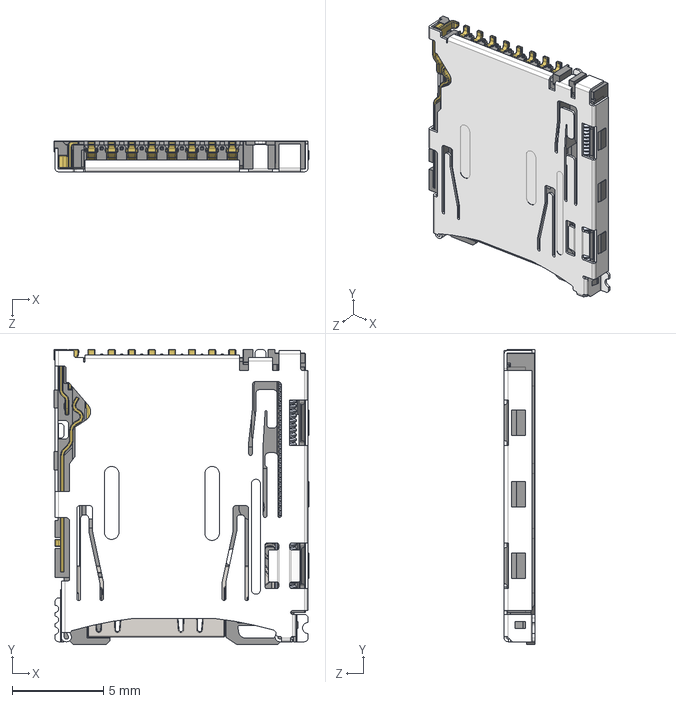
[picture p93: CAD file, 2024-06-11]
nref-ports-two/3d-models/DM3AT-SF-PEJM5.stp
13.9 x 16.2 x 1.68 mm
