cetola/reform-next-mirror/nref-batterypack-v3/3d-models/S7131-45R.stp

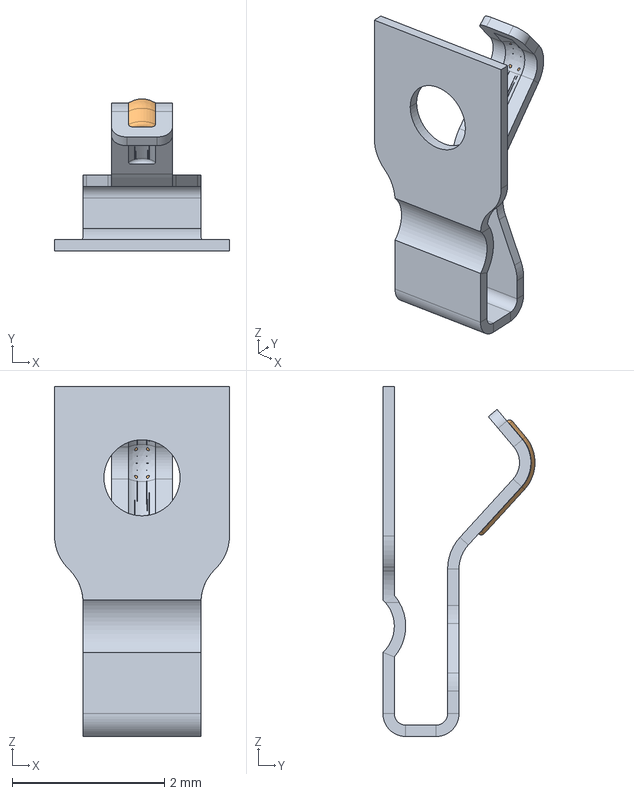
[picture p94: CAD file, 2024-02-22]
nref-batterypack-v3/3d-models/S7131-45R.stp
2.30 x 2.00 x 4.60 mm
