cetola/reform-next-mirror/nref-camera/3dmodels/YZP6.step

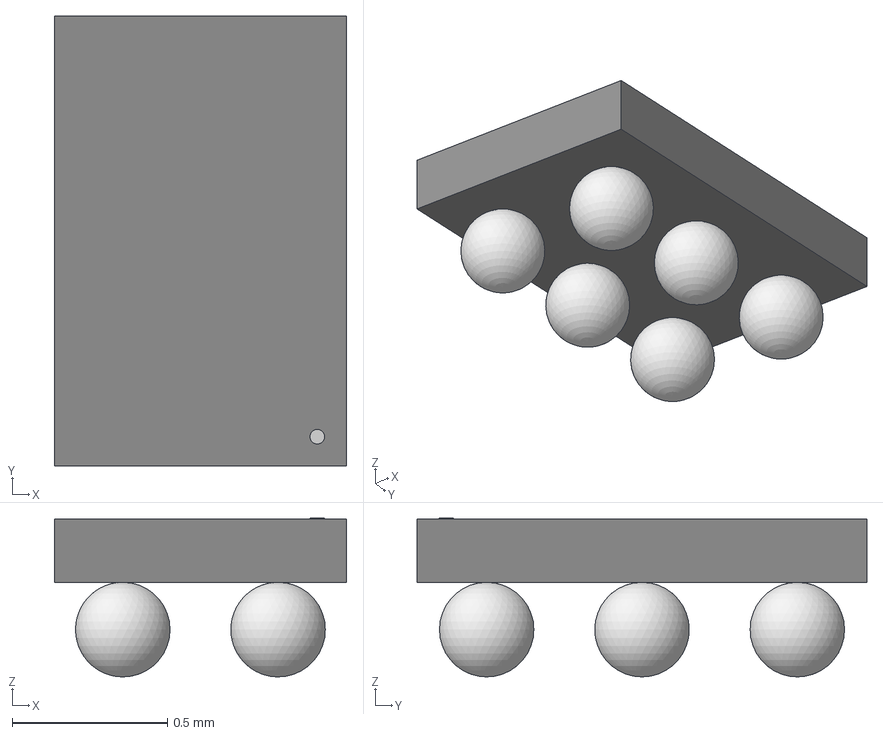
[picture p95: CAD file, 2024-08-15]
nref-camera/3dmodels/YZP6.step
0.94 x 1.45 x 0.511 mm
