cetola/reform-next-mirror/nref-motherboard/3d-models/RP2350_QFN60.step

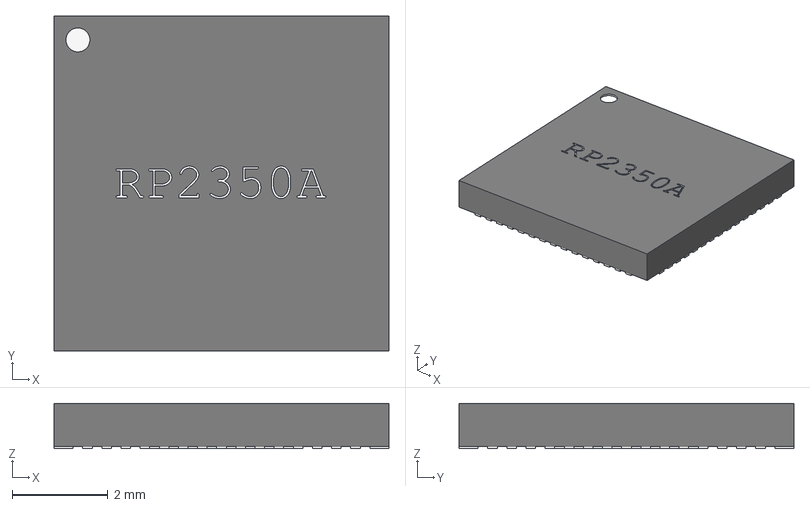
[picture p96: CAD file, 2025-03-06]
nref-motherboard/3d-models/RP2350_QFN60.step
7.00 x 7.00 x 0.95 mm
