cetola/reform-next-mirror/nref-ports-one/3d-models/IND_TAIYO_NRH3012_TAY.step

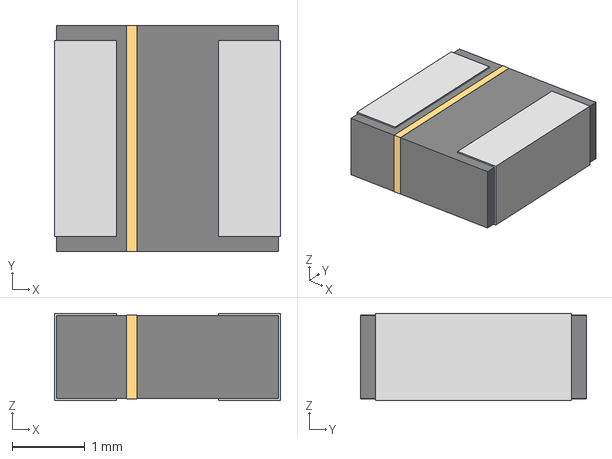
[picture p97: CAD file, 2024-02-22]
nref-ports-one/3d-models/IND_TAIYO_NRH3012_TAY.step
3.10 x 3.10 x 1.19 mm
