cetola/reform-next-mirror/nref-camera/3dmodels/ECS-1618.STEP

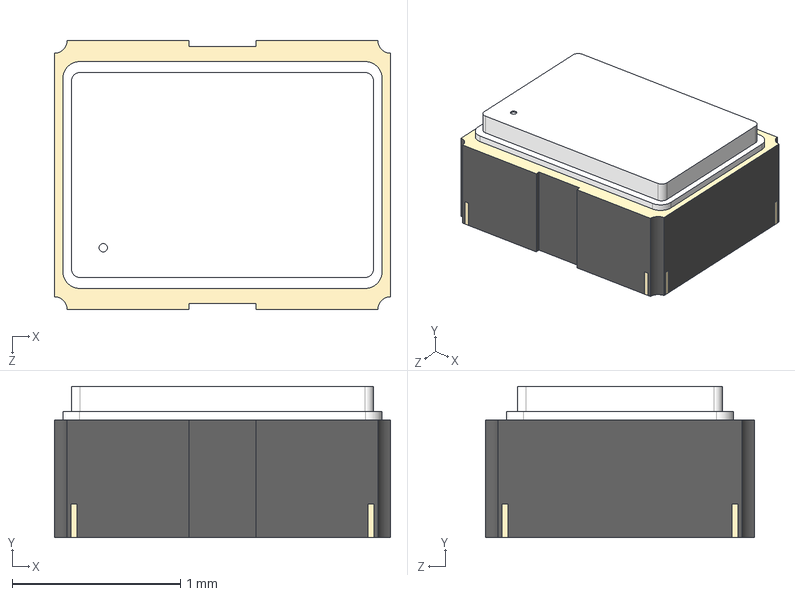
[picture p98: CAD file, 2024-08-15]
nref-camera/3dmodels/ECS-1618.STEP
2.00 x 0.9 x 1.60 mm
