cetola/reform-next-mirror/nref-motherboard/3d-models/EAST1616RGBA3.step

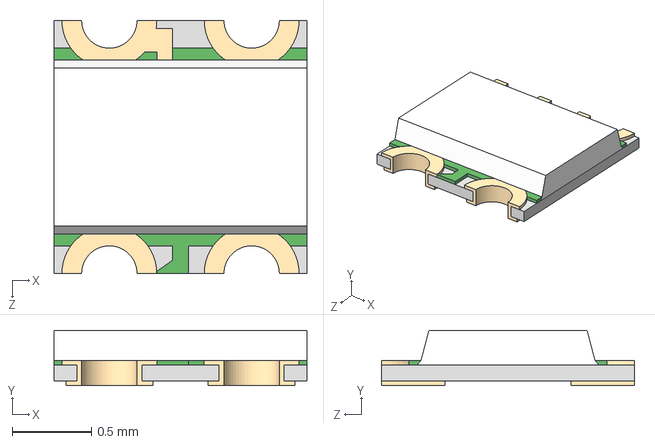
[picture p99: CAD file, 2025-03-06]
nref-motherboard/3d-models/EAST1616RGBA3.step
1.60 x 0.35 x 1.60 mm
