cetola/reform-next-mirror/nref-ports-one/3d-models/TLV320AIC3100IRHBR.STEP

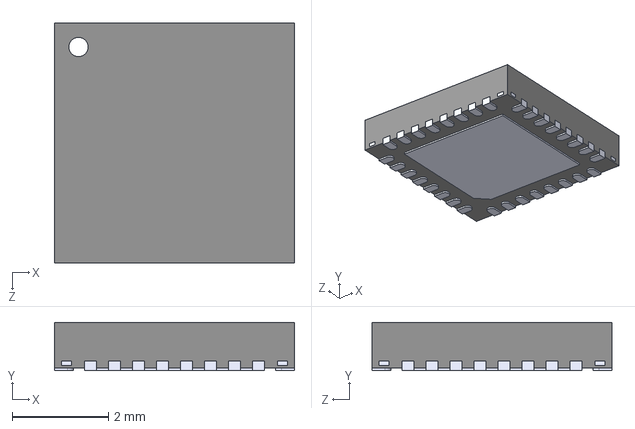
[picture p100: CAD file, 2024-02-22]
nref-ports-one/3d-models/TLV320AIC3100IRHBR.STEP
5.00 x 1.00 x 5.00 mm
