cetola/reform-next-mirror/nref-camera/3dmodels/WLCSP-8_1.58x1.63x0.35mm_Layout3x5_P0.35x0.4mm_Ball0.25mm_Pad0.25mm_NSMD.step

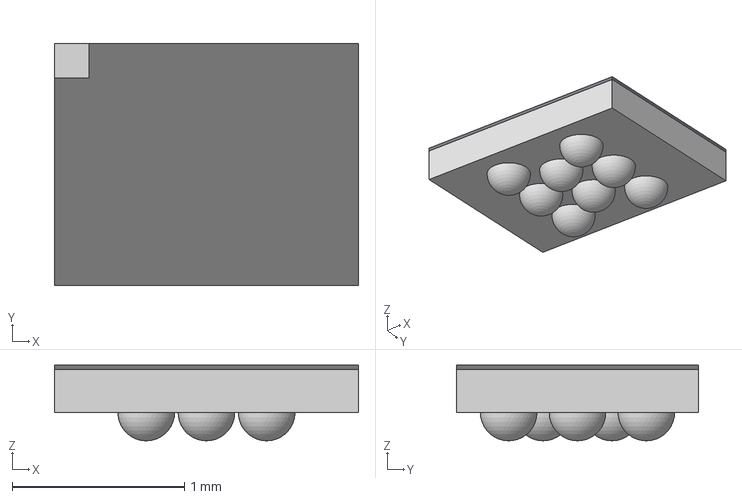
[picture p101: CAD file, 2024-08-15]
nref-camera/3dmodels/WLCSP-8_1.58x1.63x0.35mm_Layout3x5_P0.35x0.4mm_Ball0.25mm_Pad0.25mm_NSMD.step
1.77 x 1.40 x 0.44 mm
