cetola/reform-next-mirror/nref-ports-two/3d-models/WE-692122030100.stp

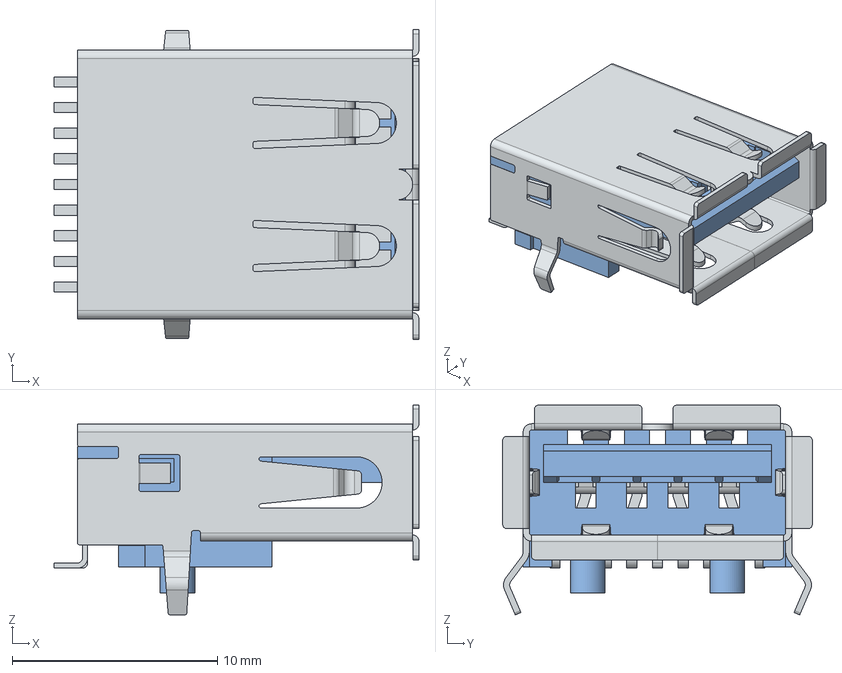
[picture p102: CAD file, 2024-05-27]
nref-ports-two/3d-models/WE-692122030100.stp
17.8 x 15.1 x 10.2 mm
pin1
pin3
pin7 x 2
pin2
pin4
pin5
pin6 x 2
Shielding
Housing
