cetola/reform-next-mirror/nref-camera/3dmodels/DQN0004A.stp

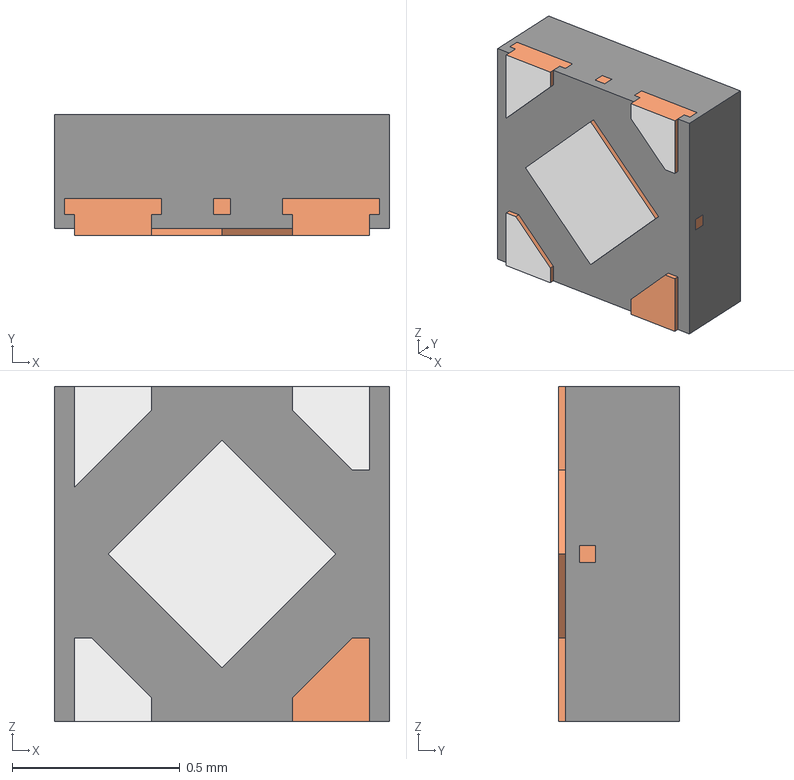
[picture p103: CAD file, 2024-08-15]
nref-camera/3dmodels/DQN0004A.stp
1.00 x 0.36 x 1.00 mm
MOLD-SNB04A
FRAME-SNB04A
