cetola/reform-next-mirror/nref-motherboard/3d-models/SM12B-SRSS-TB.STEP

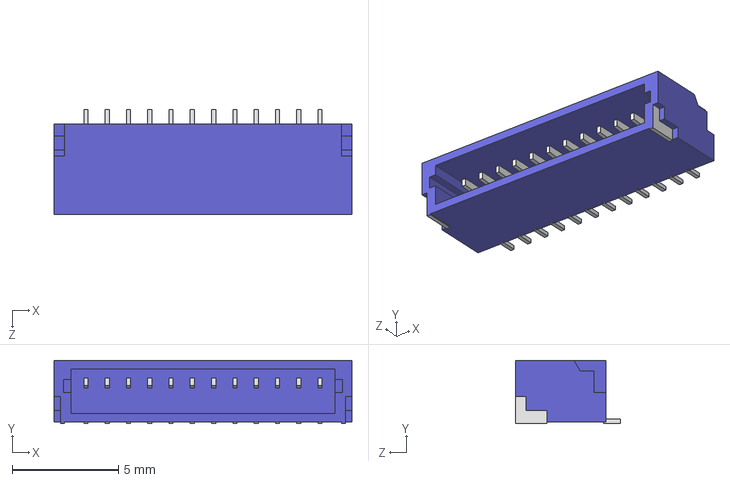
[picture p104: CAD file, 2024-04-29]
nref-motherboard/3d-models/SM12B-SRSS-TB.STEP
14.0 x 2.96 x 4.95 mm
