cetola/reform-next-mirror/nref-ports-two/3d-models/CM2020-00TR--3DModel-STEP-56544.STEP

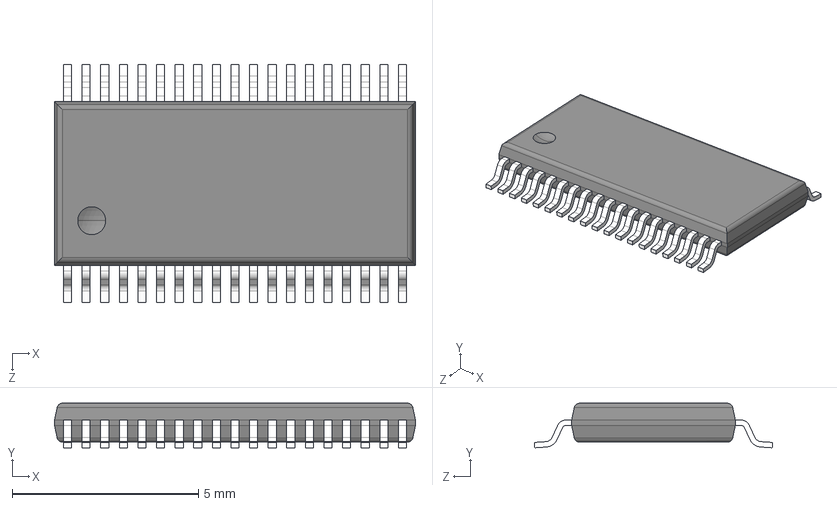
[picture p105: CAD file, 2024-02-22]
nref-ports-two/3d-models/CM2020-00TR--3DModel-STEP-56544.STEP
9.70 x 1.20 x 6.40 mm
