cetola/reform-next-mirror/nref-motherboard/3d-models/SM10B-SRSS-TB.STEP

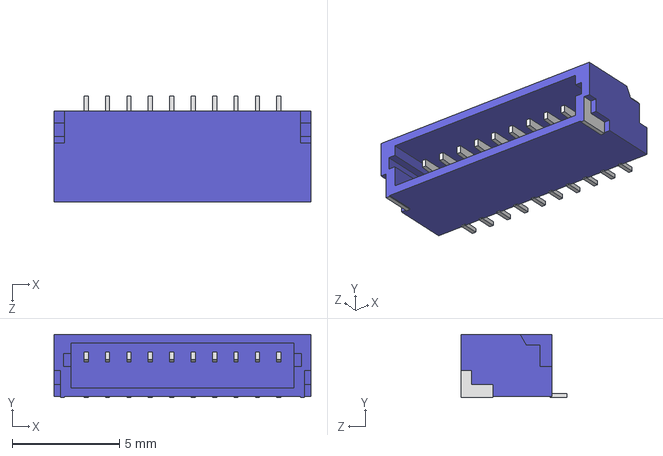
[picture p106: CAD file, 2024-04-29]
nref-motherboard/3d-models/SM10B-SRSS-TB.STEP
12.0 x 2.96 x 4.95 mm
