cetola/reform-next-mirror/nref-motherboard/3d-models/USB2412-DZK.step

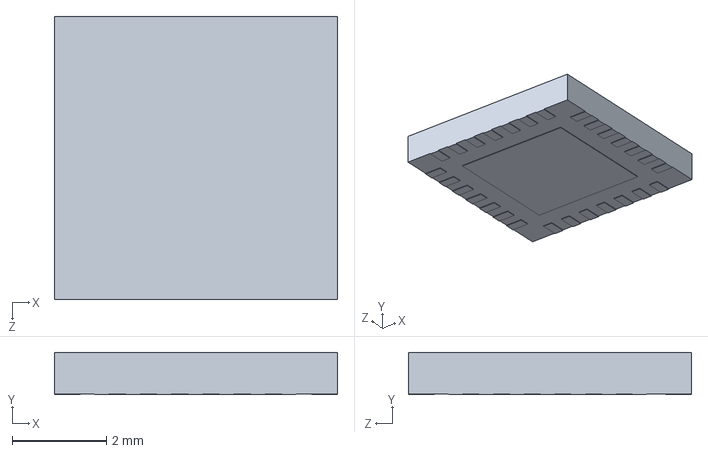
[picture p107: CAD file, 2024-04-29]
nref-motherboard/3d-models/USB2412-DZK.step
6.00 x 0.9 x 6.00 mm
