cetola/reform-next-mirror/nref-motherboard/3d-models/FH12-20S-0.5SH.stp

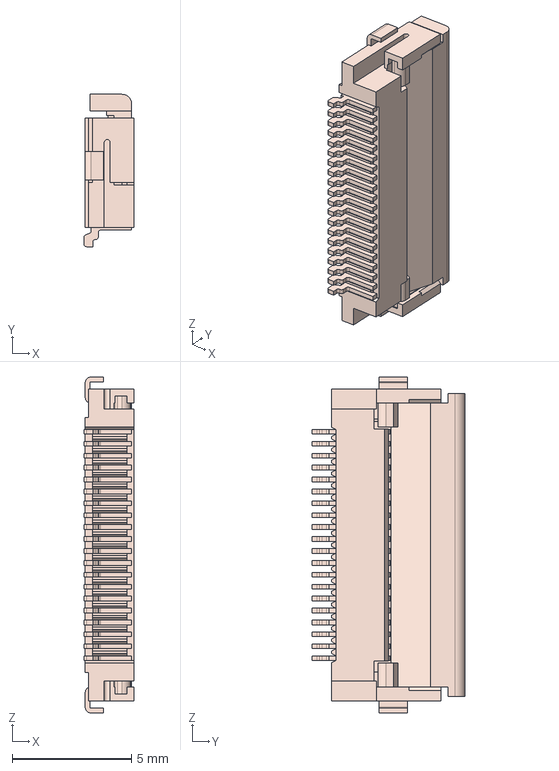
[picture p108: CAD file, 2024-04-29]
nref-motherboard/3d-models/FH12-20S-0.5SH.stp
2.10 x 6.40 x 14.1 mm
