cetola/reform-next-mirror/nref-motherboard/3d-models/FH12-14S-0.5SH.stp

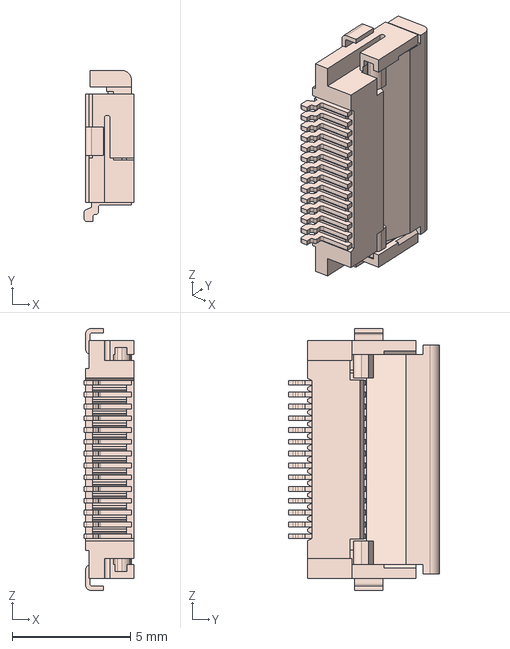
[picture p109: CAD file, 2024-04-29]
nref-motherboard/3d-models/FH12-14S-0.5SH.stp
2.10 x 6.40 x 11.1 mm
