cetola/reform-next-mirror/nref-motherboard/3d-models/FH12-12S-0.5SH.stp

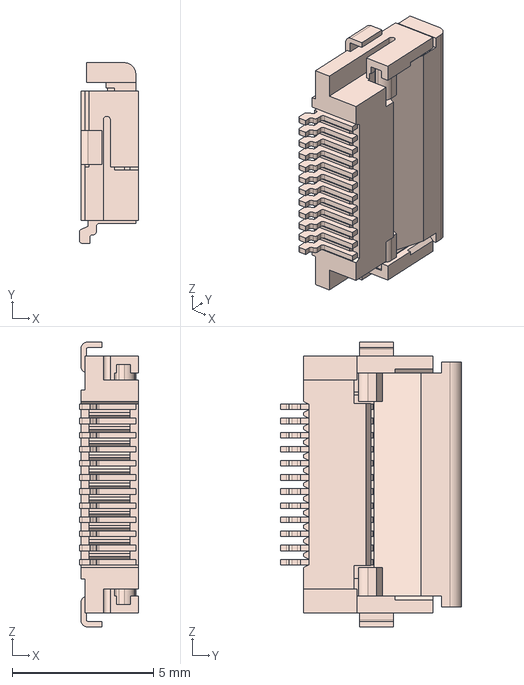
[picture p111: CAD file, 2024-04-29]
nref-motherboard/3d-models/FH12-12S-0.5SH.stp
2.10 x 6.40 x 10.1 mm
