cetola/reform-next-mirror/nref-motherboard/3d-models/S9B-PH-SM4-TB.stp

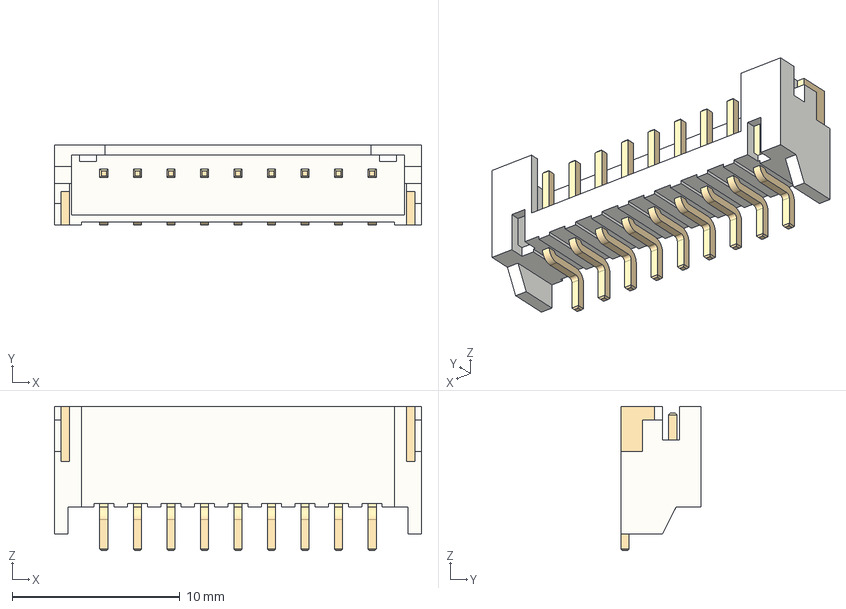
[picture p112: CAD file, 2024-02-22]
nref-motherboard/3d-models/S9B-PH-SM4-TB.stp
21.9 x 4.80 x 8.60 mm
