cetola/reform-next-mirror/nref-motherboard/3d-models/CUI_SJ-43516-SMT-TR.step

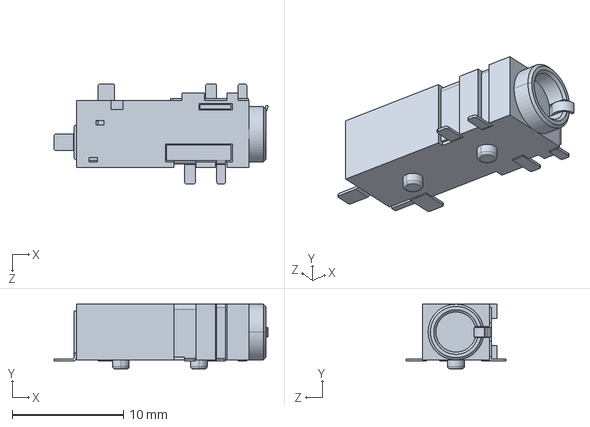
[picture p113: CAD file, 2024-02-22]
nref-motherboard/3d-models/CUI_SJ-43516-SMT-TR.step
19.2 x 5.80 x 9.00 mm
