cetola/reform-next-mirror/nref-motherboard/3d-models/c-2199337-5-a-3d.stp

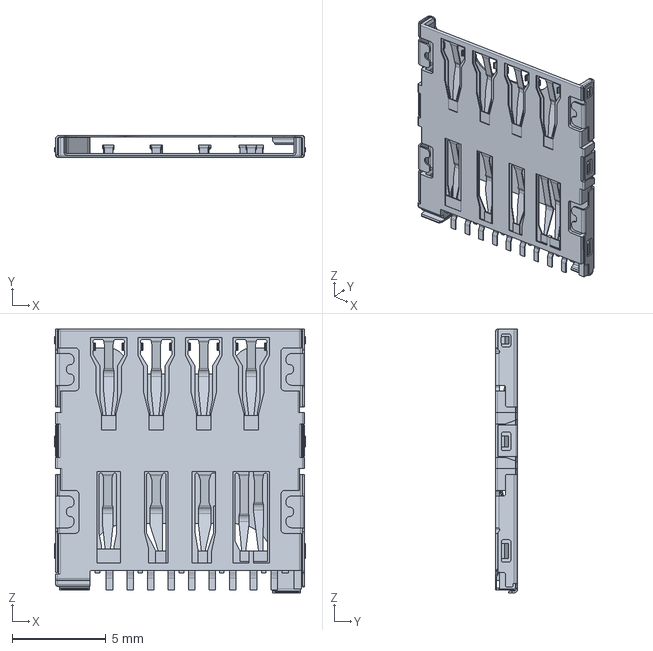
[picture p114: CAD file, 2024-02-22]
nref-motherboard/3d-models/c-2199337-5-a-3d.stp
13.4 x 1.20 x 14.1 mm
