cetola/reform-next-mirror/nref-motherboard/3d-models/keystone-PN54.STEP

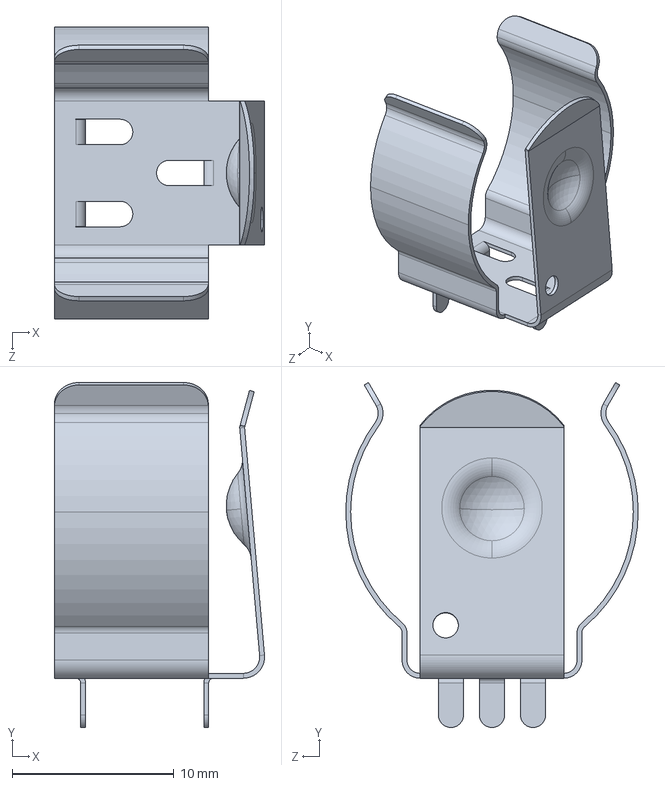
[picture p115: CAD file, 2024-02-22]
nref-motherboard/3d-models/keystone-PN54.STEP
13.0 x 21.4 x 18.1 mm
