cetola/reform-next-mirror/nref-motherboard/3d-models/c-1717254-1-d1-3d.stp

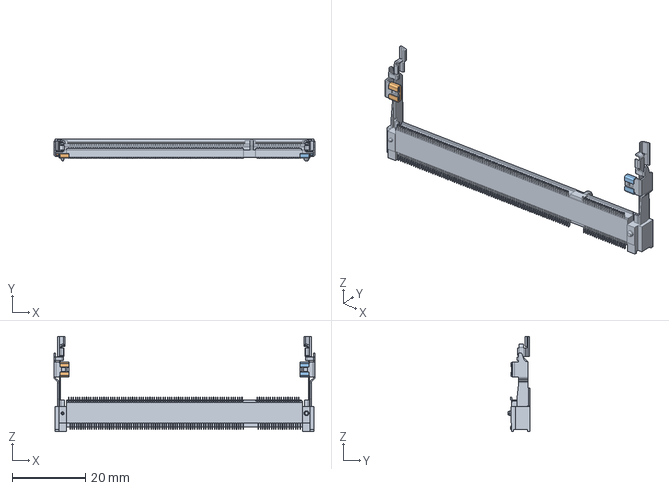
[picture p117: CAD file, 2024-02-22]
nref-motherboard/3d-models/c-1717254-1-d1-3d.stp
71.5 x 5.90 x 26.0 mm
