cetola/reform-next-mirror/nref-motherboard/3d-models/19-337-R6GHBHC-A01-2T.STEP

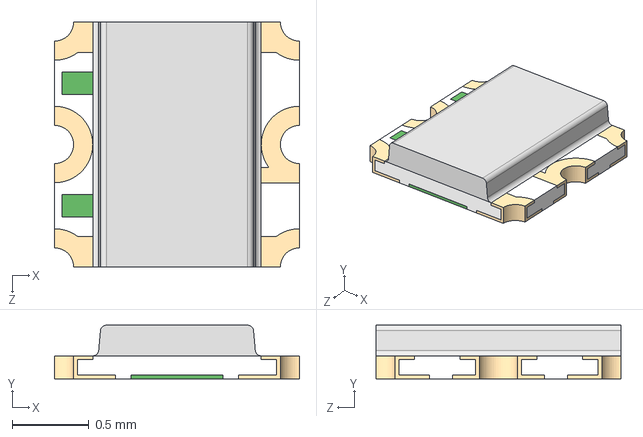
[picture p118: CAD file, 2024-02-22]
nref-motherboard/3d-models/19-337-R6GHBHC-A01-2T.STEP
1.60 x 0.35 x 1.60 mm
