cetola/reform-next-mirror/nref-motherboard/3d-models/KMR221GLFS.step

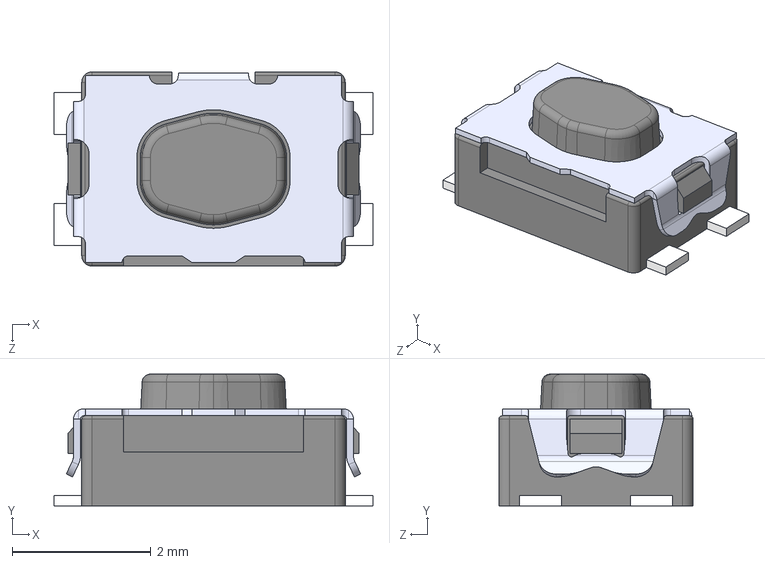
[picture p119: CAD file, 2024-02-22]
nref-motherboard/3d-models/KMR221GLFS.step
4.60 x 1.90 x 2.80 mm
