cetola/reform-next-mirror/nref-motherboard/3d-models/c-1-2199230-5-b2-3d.stp

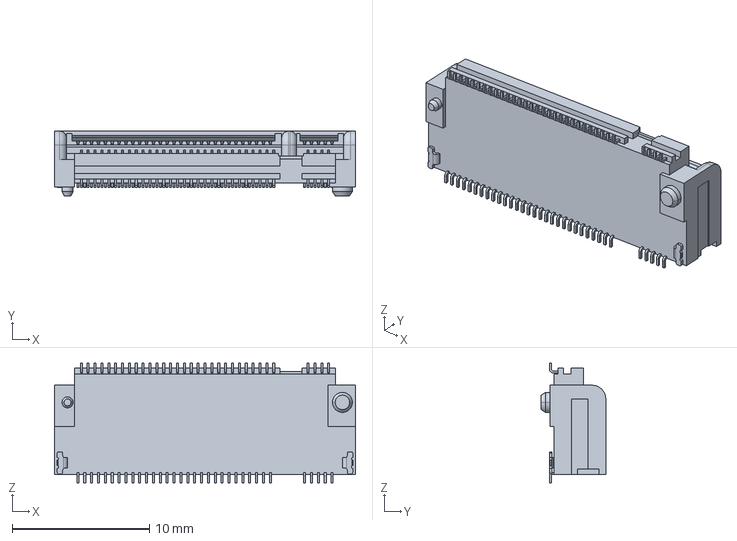
[picture p120: CAD file, 2024-02-22]
nref-motherboard/3d-models/c-1-2199230-5-b2-3d.stp
21.9 x 4.70 x 8.70 mm
