cetola/reform-next-mirror/nref-motherboard/3d-models/SM02B-SRSS-TB-LF--SN---3DModel-STEP-56544.STEP

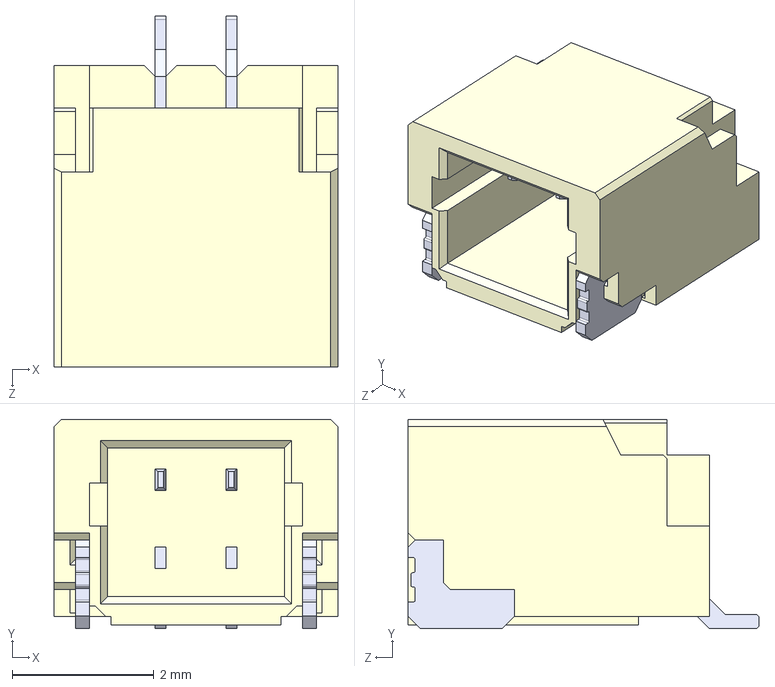
[picture p122: CAD file, 2024-02-22]
nref-motherboard/3d-models/SM02B-SRSS-TB-LF--SN---3DModel-STEP-56544.STEP
4.00 x 2.95 x 4.95 mm
