cetola/reform-next-mirror/nref-motherboard/3d-models/IHLP4040DZ (2.2-100uH).STEP

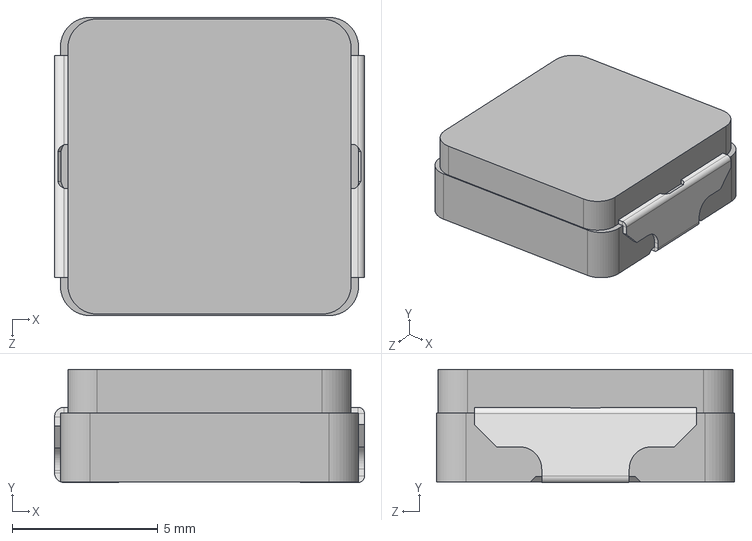
[picture p123: CAD file, 2024-02-22]
nref-motherboard/3d-models/IHLP4040DZ (2.2-100uH).STEP
10.6 x 3.87 x 10.2 mm
