cetola/reform-next-mirror/nref-motherboard/3d-models/DM3CS-SF.stp

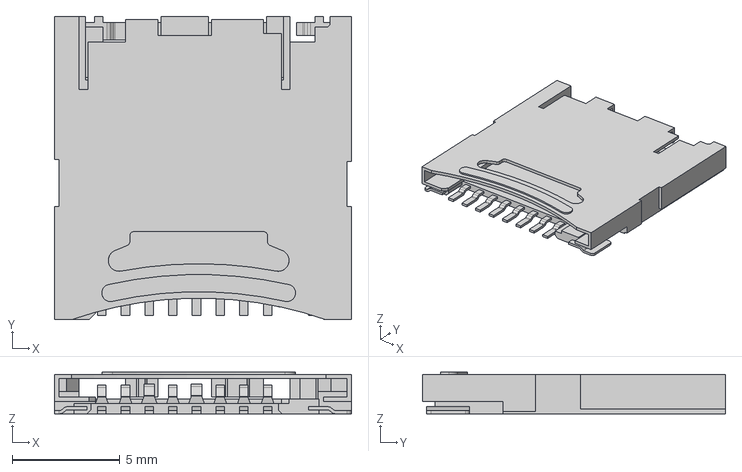
[picture p124: CAD file, 2024-02-22]
nref-motherboard/3d-models/DM3CS-SF.stp
13.8 x 14.1 x 1.93 mm
