cetola/reform-next-mirror/nref-motherboard/3d-models/SON95P300X300X80-7N.step

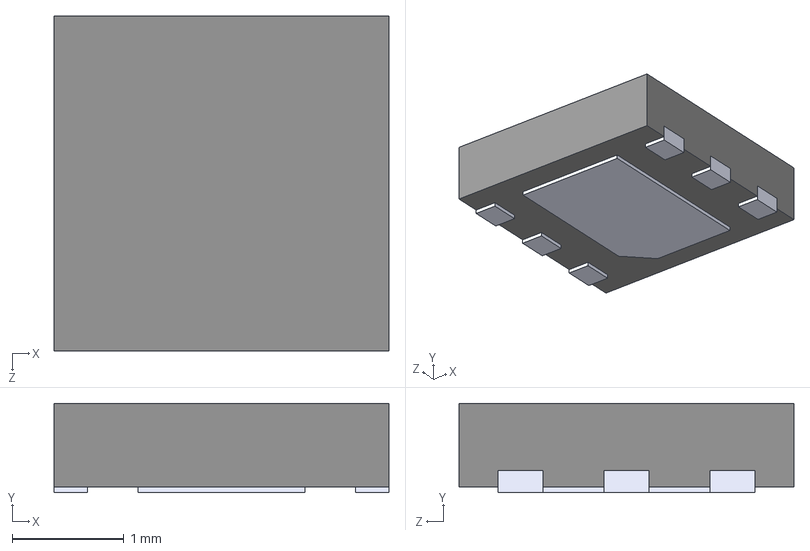
[picture p126: CAD file, 2024-02-22]
nref-motherboard/3d-models/SON95P300X300X80-7N.step
3.00 x 0.8 x 3.00 mm
