cetola/reform-next-mirror/nref-motherboard/3d-models/SOD-128.step

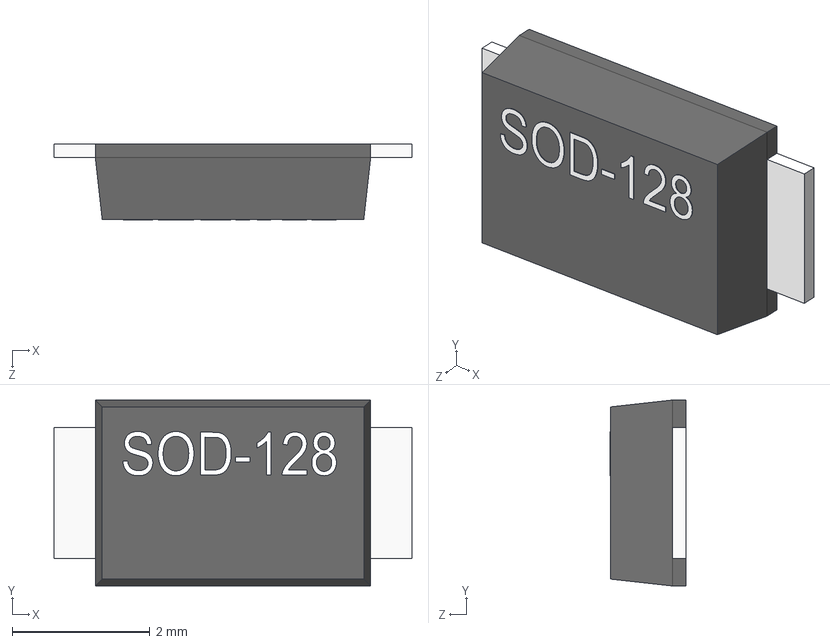
[picture p127: CAD file, 2024-02-22]
nref-motherboard/3d-models/SOD-128.step
5.20 x 2.70 x 1.11 mm
