cetola/reform-next-mirror/nref-motherboard/3d-models/SM05B-SRSS-TB(LF)(SN)--3DModel-STEP-418109.STEP

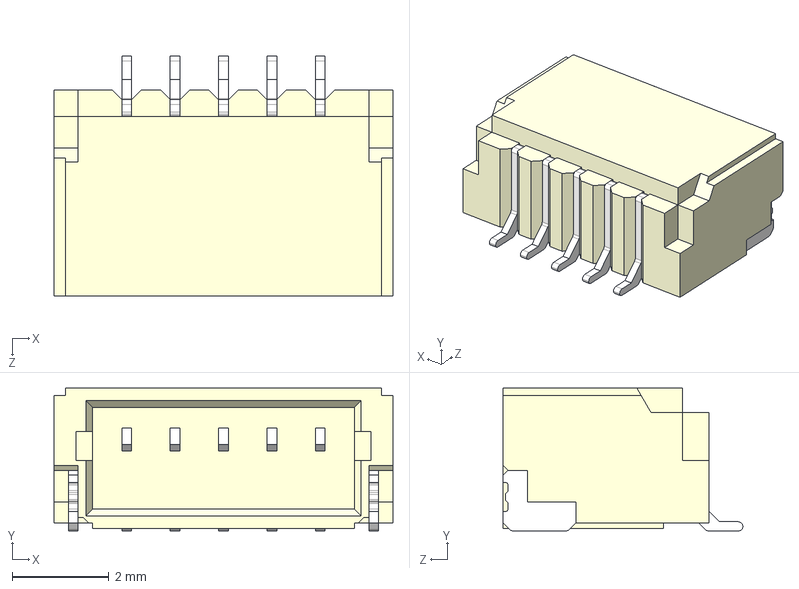
[picture p128: CAD file, 2024-02-22]
nref-motherboard/3d-models/SM05B-SRSS-TB(LF)(SN)--3DModel-STEP-418109.STEP
7.00 x 2.95 x 4.95 mm
