cetola/reform-next-mirror/nref-motherboard/3d-models/User Library-VQFN-100 12X12 40P.STEP

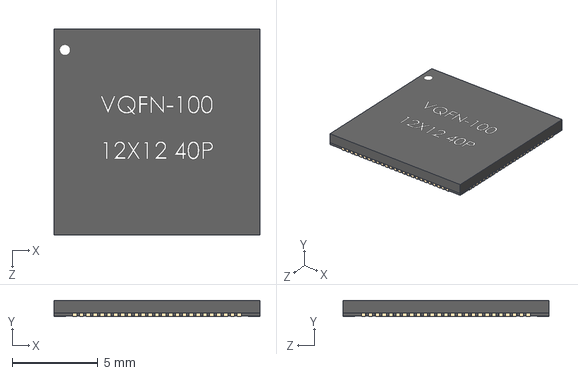
[picture p129: CAD file, 2024-02-22]
nref-motherboard/3d-models/User Library-VQFN-100 12X12 40P.STEP
12.0 x 0.951 x 12.0 mm
