cetola/reform-next-mirror/nref-motherboard/3d-models/TYPE-C-31-M-12--3DModel-STEP-56544.STEP

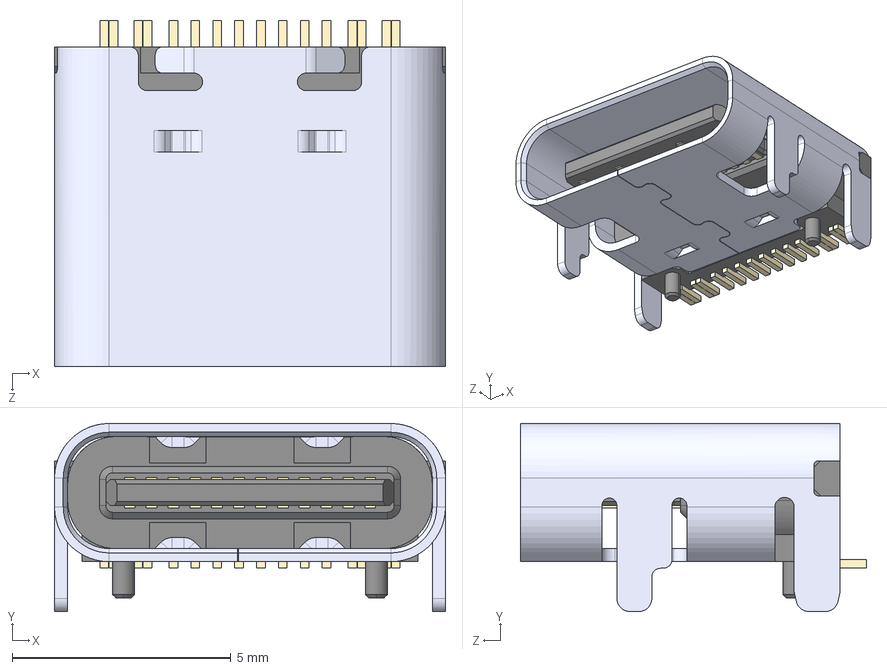
[picture p130: CAD file, 2024-02-22]
nref-motherboard/3d-models/TYPE-C-31-M-12--3DModel-STEP-56544.STEP
8.94 x 4.30 x 7.90 mm
