cetola/reform-next-mirror/nref-motherboard/3d-models/HTQFP-80.stp

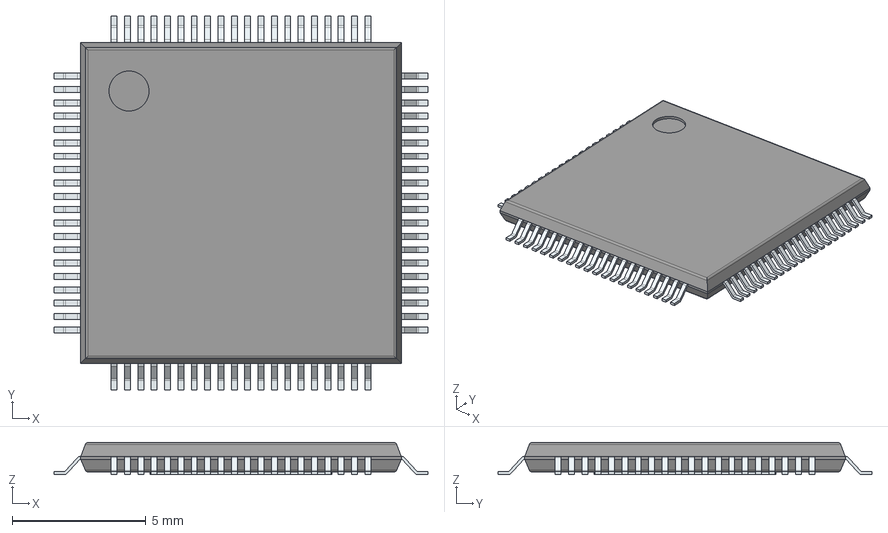
[picture p131: CAD file, 2024-02-22]
nref-motherboard/3d-models/HTQFP-80.stp
14.0 x 14.0 x 1.20 mm
PinsArrayLR
PinsArrayTB
ThermalPad
