cetola/reform-next-mirror/nref-motherboard/3d-models/3-2328724-1.step

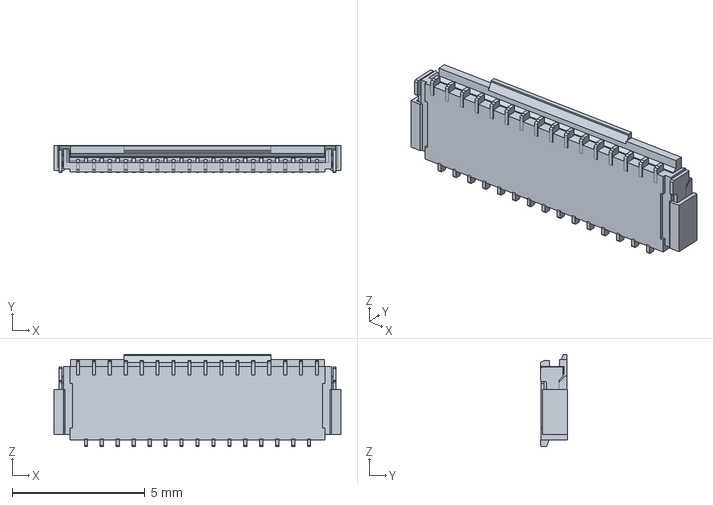
[picture p133: CAD file, 2024-02-22]
nref-motherboard/3d-models/3-2328724-1.step
10.8 x 1.00 x 3.48 mm
