cetola/reform-next-mirror/nref-motherboard/3d-models/Amphenol_-_12401548E4#2A.step

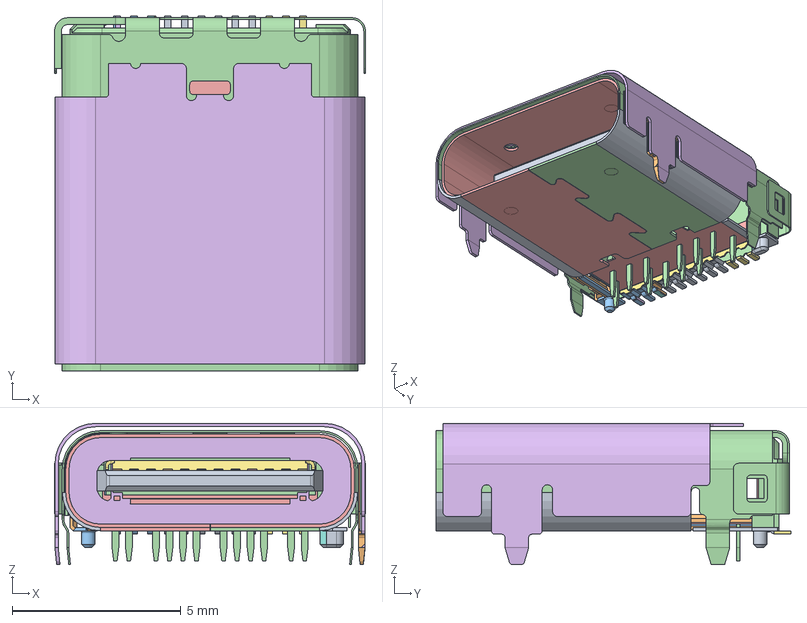
[picture p134: CAD file, 2024-02-22]
nref-motherboard/3d-models/Amphenol_-_12401548E4#2A.step
9.20 x 10.5 x 4.18 mm
