cetola/reform-next-mirror/nref-motherboard/3d-models/SRP6060FA-100M.stp

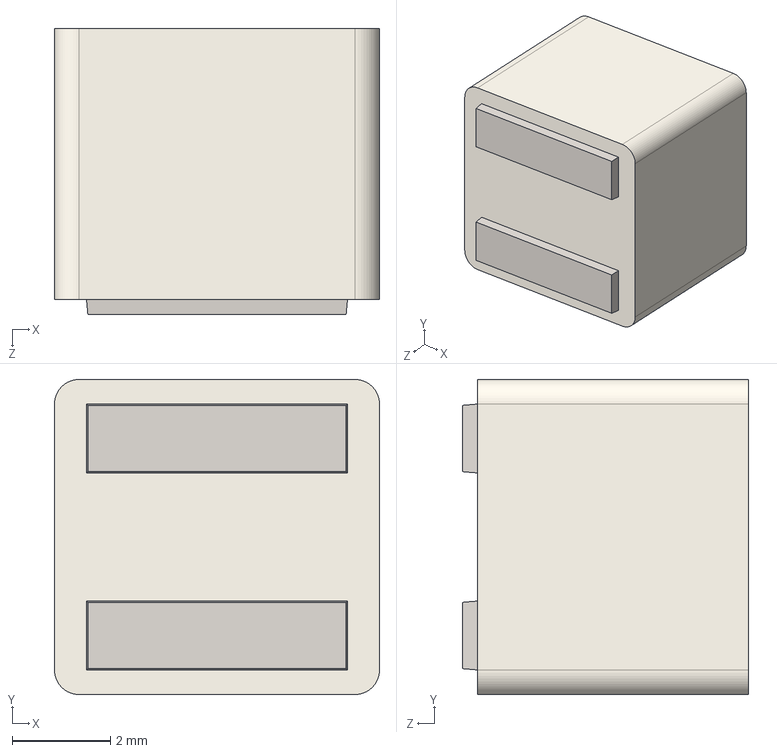
[picture p135: CAD file, 2024-02-22]
nref-motherboard/3d-models/SRP6060FA-100M.stp
6.60 x 6.40 x 5.80 mm
