cetola/reform-next-mirror/nref-motherboard/3d-models/FH12-33S-0.5SH.stp

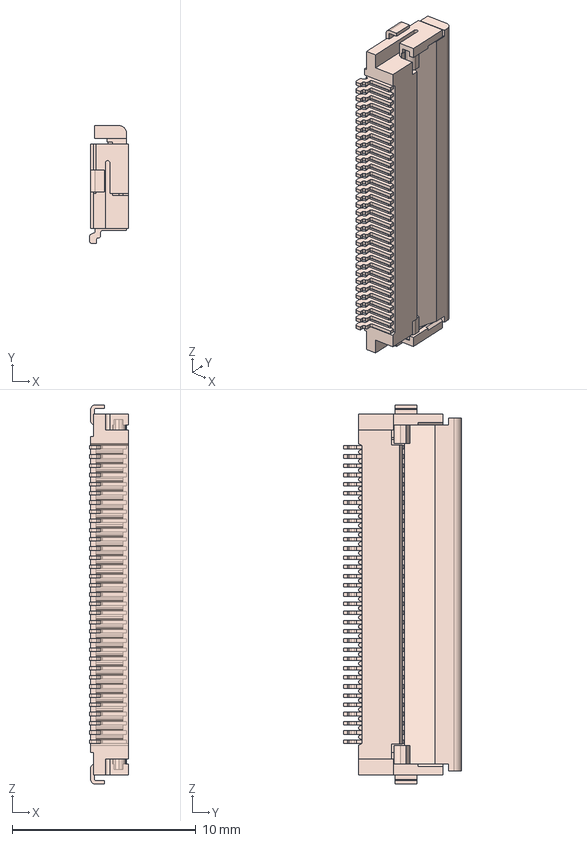
[picture p136: CAD file, 2024-02-22]
nref-motherboard/3d-models/FH12-33S-0.5SH.stp
2.10 x 6.40 x 20.6 mm
