cetola/reform-next-mirror/nref-motherboard/3d-models/ssfv33r_1stlf.stp

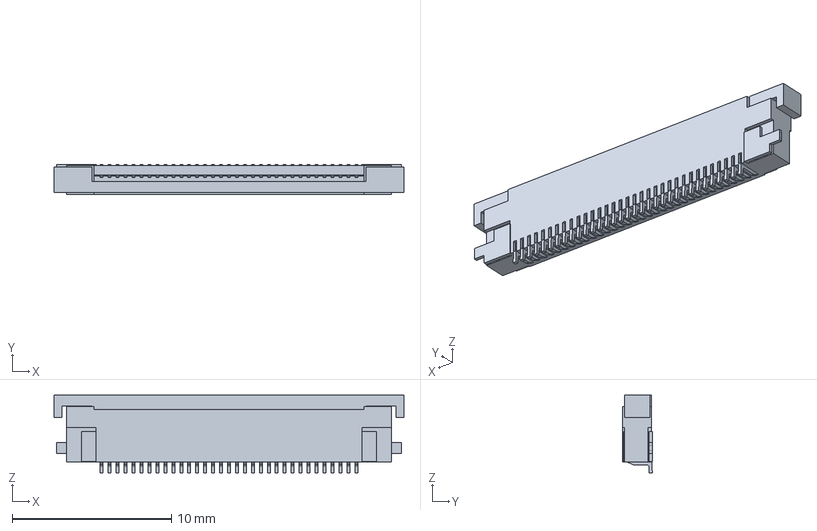
[picture p137: CAD file, 2024-02-22]
nref-motherboard/3d-models/ssfv33r_1stlf.stp
22.0 x 1.87 x 4.90 mm
