cetola/reform-next-mirror/nref-motherboard/3d-models/MP23ABS1TR.obj

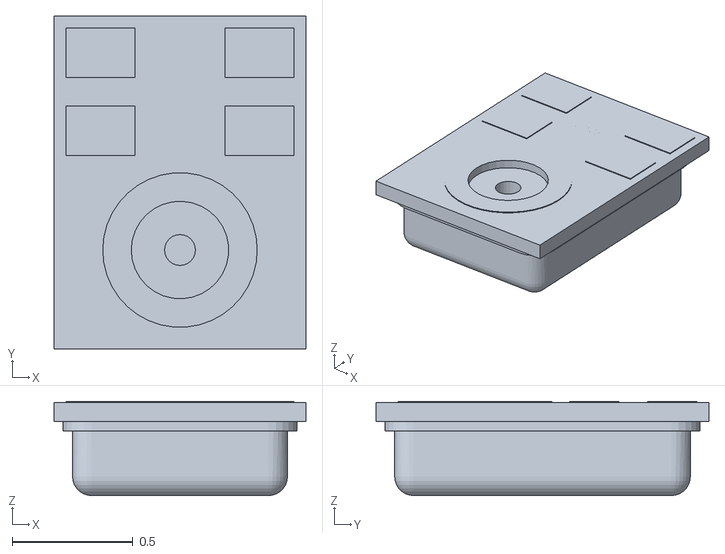
[picture p138: CAD file, 2024-02-22]
nref-motherboard/3d-models/MP23ABS1TR.obj
1.04 x 1.38 x 0.39
