cetola/reform-next-mirror/nref-motherboard/3d-models/BK-879.STEP

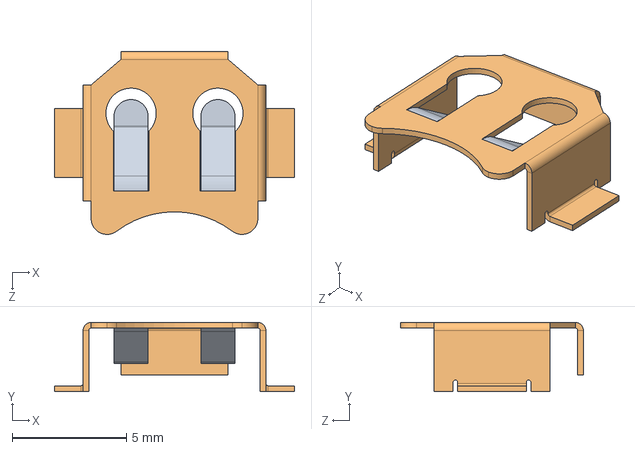
[picture p139: CAD file, 2024-02-22]
nref-motherboard/3d-models/BK-879.STEP
10.5 x 3.02 x 8.00 mm
