cetola/reform-next-mirror/nref-motherboard/3d-models/S4B-PH-SM4-TB.stp

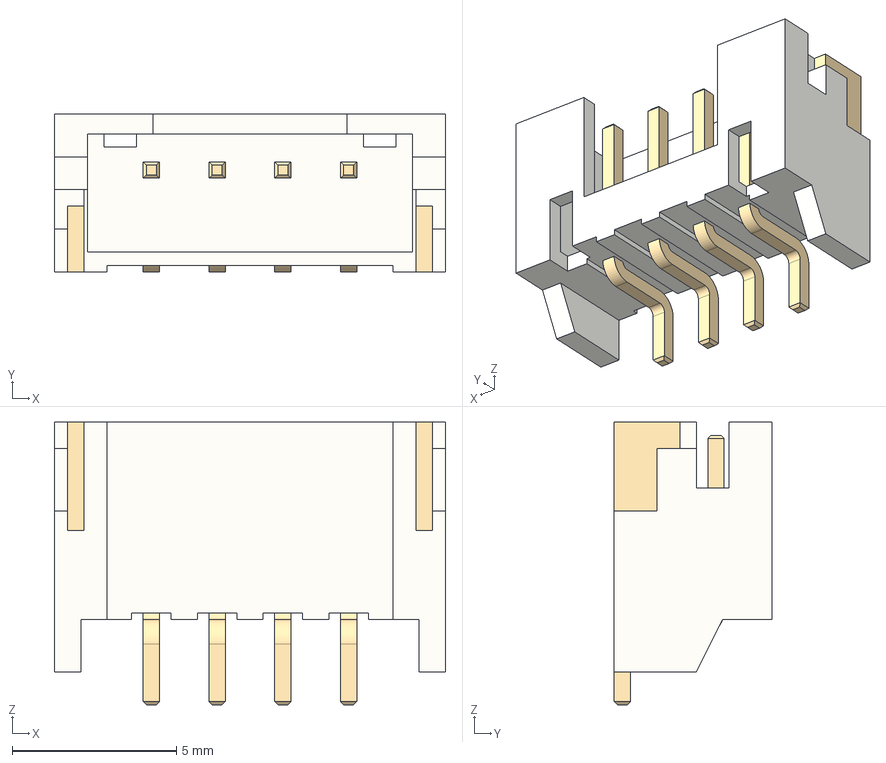
[picture p140: CAD file, 2024-02-22]
nref-motherboard/3d-models/S4B-PH-SM4-TB.stp
11.9 x 4.80 x 8.60 mm
