cetola/reform-next-mirror/nref-motherboard/3d-models/SM04B-SRSS-TB(LF)(SN)--3DModel-STEP-56544.STEP

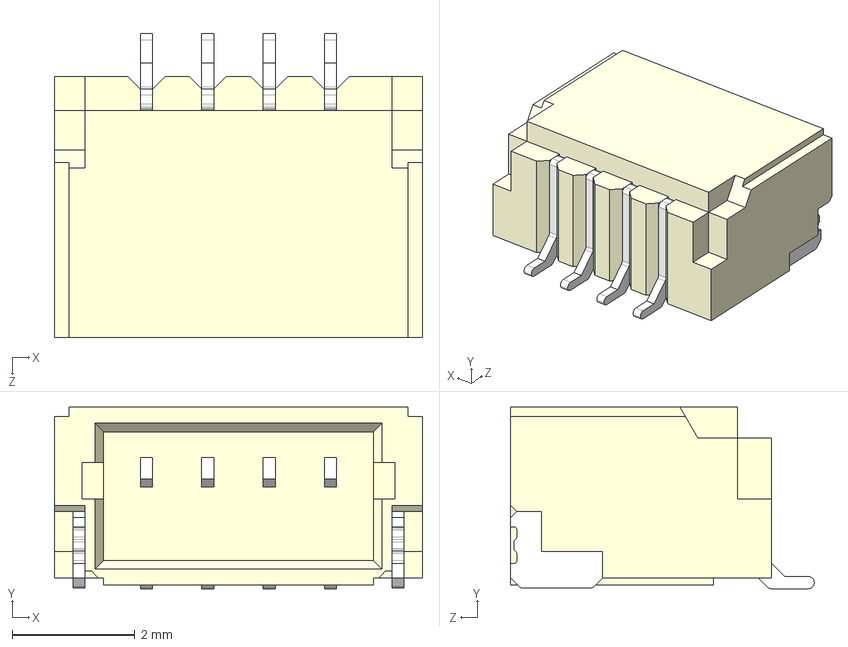
[picture p141: CAD file, 2024-02-22]
nref-motherboard/3d-models/SM04B-SRSS-TB(LF)(SN)--3DModel-STEP-56544.STEP
6.00 x 2.96 x 4.95 mm
