cetola/reform-next-mirror/nref-motherboard/3d-models/DM3AT-SF-PEJM5--3DModel-STEP-56544.STEP

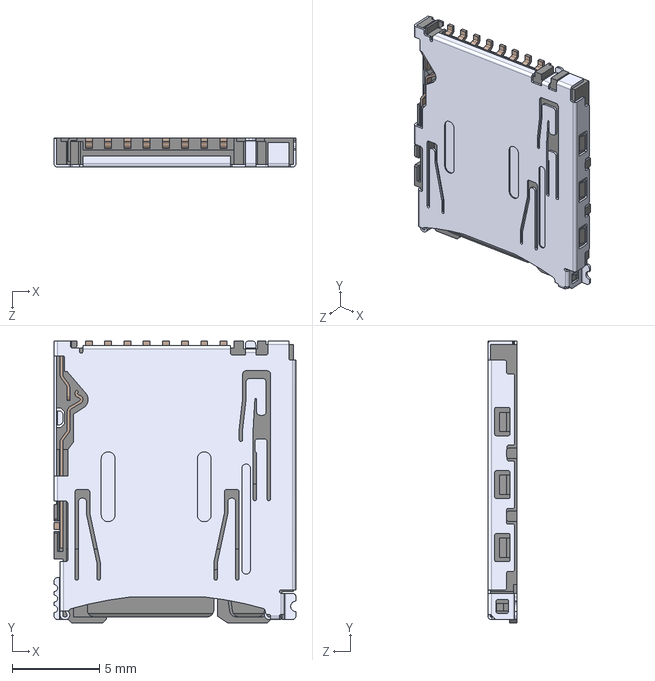
[picture p142: CAD file, 2024-02-22]
nref-motherboard/3d-models/DM3AT-SF-PEJM5--3DModel-STEP-56544.STEP
13.8 x 16.2 x 1.68 mm
