cetola/reform-next-mirror/nref-motherboard/3d-models/3215-crystal.step

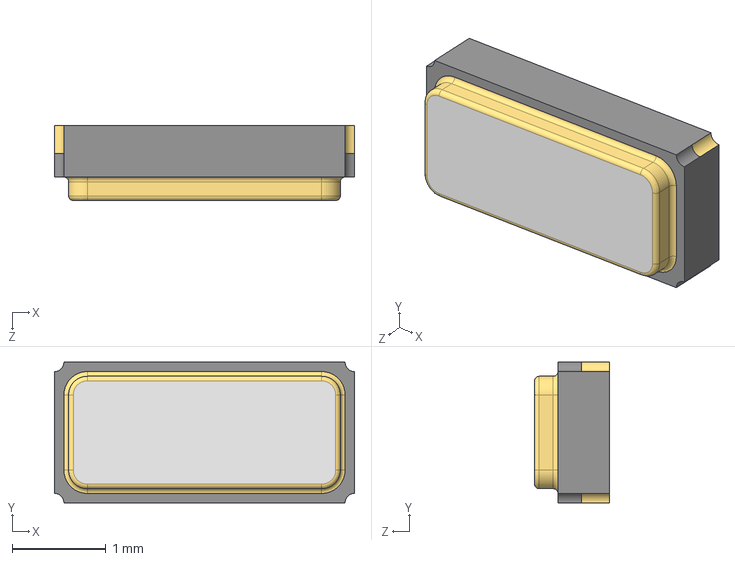
[picture p143: CAD file, 2024-02-22]
nref-motherboard/3d-models/3215-crystal.step
3.20 x 1.50 x 0.8 mm
