cetola/reform-next-mirror/nref-motherboard/3d-models/NVMFD5C446NT1G.step

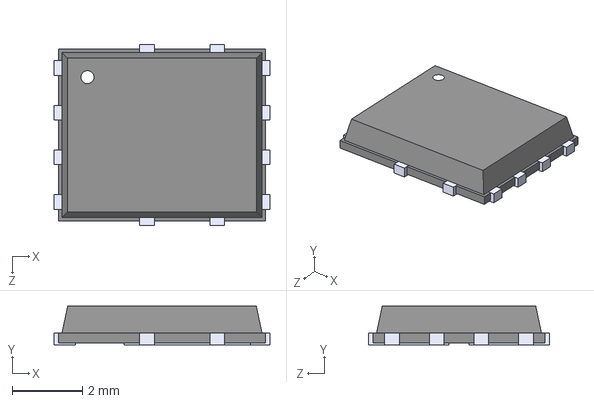
[picture p144: CAD file, 2024-02-22]
nref-motherboard/3d-models/NVMFD5C446NT1G.step
6.15 x 1.10 x 5.15 mm
