cetola/reform-next-mirror/nref-motherboard/3d-models/p36-2.stp

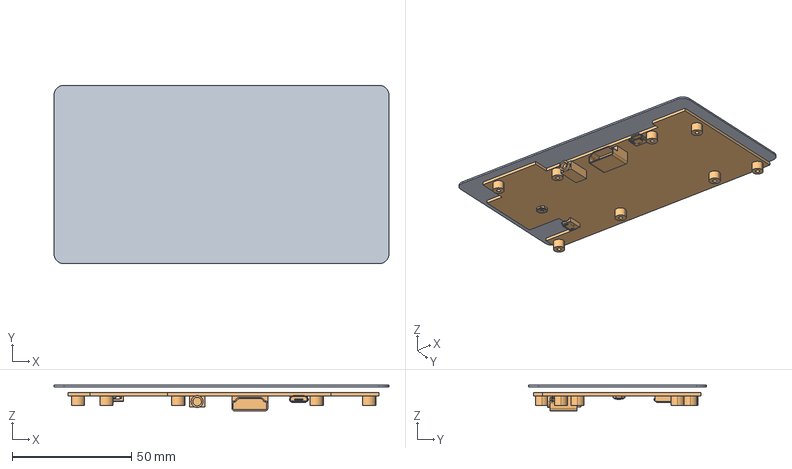
[picture p145: CAD file, 2024-02-22]
nref-motherboard/3d-models/p36-2.stp
140.4 x 74.8 x 10.8 mm
