cetola/reform-next-mirror/nref-motherboard/3d-models/JXD-G2406S.obj

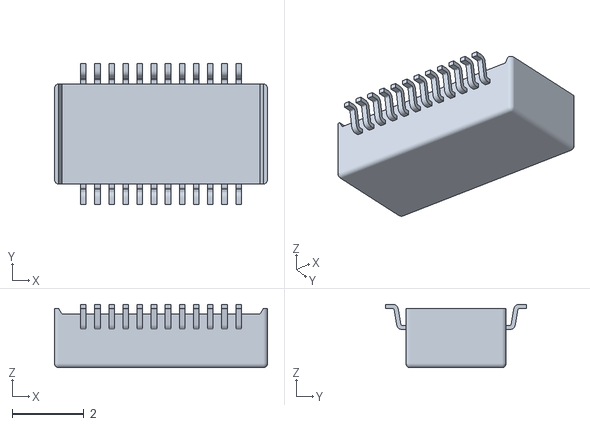
[picture p146: CAD file, 2024-02-22]
nref-motherboard/3d-models/JXD-G2406S.obj
5.94 x 3.94 x 1.77
