cetola/reform-next-mirror/(list of files, cad)

Other CAD files:
nref-motherboard/3d-models/SM06B-SRSS-TB.STEP
nref-wifi-m2/3d-models/c-2199119-7-c-3d.stp
nref-ports-one/3d-models/SM02B-SRSS-TB.STEP
nref-ports-one/3d-models/SM09B-SRSS-TB.STEP
nref-batterypack-v3/3d-models/SM07B-SRSS-TB.STEP
nref-motherboard/3d-models/C-1-2199230-5-blk.step
nref-motherboard/3d-models/DM3CS-SFb.stp
hdmi-edp2/3d-models/467650301.stp
nref-batterypack-v3/3d-models/18650-d18mm.step
nref-batterypack-v3/3d-models/BQ76905RGRR.step
nref-batterypack-v3/3d-models/BQ76922RSNR.stp
nref-batterypack-v3/3d-models/CSD87501L.stp
nref-batterypack-v3/3d-models/s1741-46r.stp
nref-batterypack/3d-models/s7271-45r.stp
nref-camera/3dmodels/68712414522 (rev1).stp
nref-motherboard/3d-models/10102166A812A.stp
nref-motherboard/3d-models/1747981-1.step
nref-motherboard/3d-models/2199230-5.step
nref-motherboard/3d-models/480995701.stp
nref-motherboard/3d-models/679105700.stp
nref-motherboard/3d-models/78800-0001.step
nref-motherboard/3d-models/9774010243R.stp
nref-motherboard/3d-models/BQ25756RRVR.step
nref-motherboard/3d-models/LM62460QRPHRQ1.step
nref-ports-one/3d-models/634108150321.step
nref-ports-two/3d-models/09452812561.stp
nref-ports-two/3d-models/105450-0101.step
nref-ports-two/3d-models/692121230100.step
nref-ports-two/3d-models/7498111120R.step
nref-usb3-redriver/3d-models/48393-0001.stp
nref-usb3-redriver/3d-models/692121230100.stp
nref-usb3-redriver/3d-models/692122030100.stp
nref-wifi-m2/3d-models/TPS62086RLTR.step
