cetola/reform-next-mirror/nref-cables/MNT24082901.pdf

# ROHS Compliant

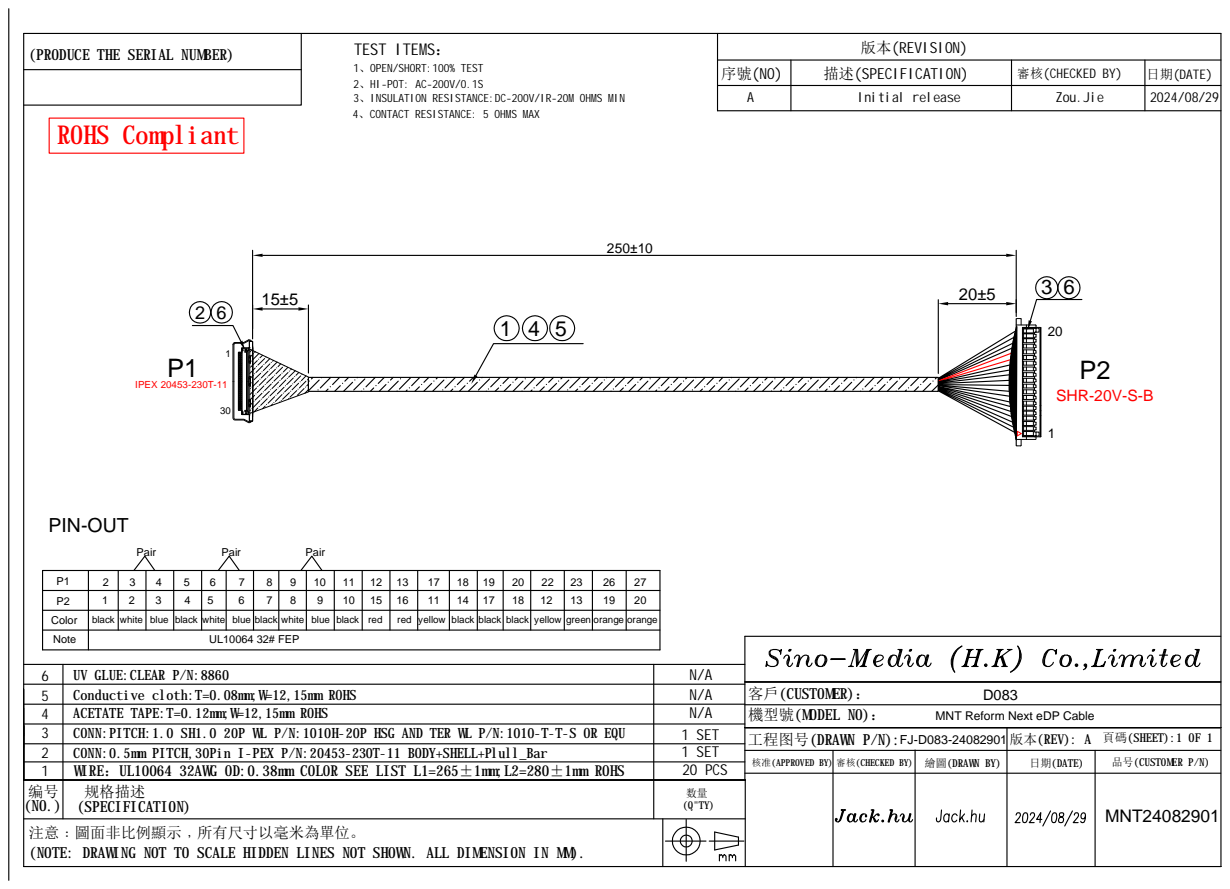
[picture p147: page 1]
PIN-OUT; Color; Pair; black; white; blue; red; yellow; green; orange; SHR-20V-S-B; IPEX 20453-230T-11; 描述(SPECIFICATION); 版本(REVISION); 審核(CHECKED BY); 日期(DATE); Initial release; Zou.Jie; TEST ITEMS：; Note; UL10064 32# FEP

(PRODUCE THE SERIAL NUMBER)

1、OPEN/SHORT:100% TEST
2、HI-POT: AC-200V/0.1S
3、INSULATION RESISTANCE:DC-200V/IR-20M OHMS MIN
4、CONTACT RESISTANCE: 5 OHMS MAX

6 UV GLUE:CLEAR P/N:8860 5 4 ACETATE TAPE:T=0.12mm;W=12,15mm ROHS | Conductive cloth:T=0.08mm;W=12,15mm ROHS | N/A N/A N/A

客戶(CUSTOMER)：
機型號(MODEL NO)：
工程图号(DRAWN P/N):

MNT Reform Next eDP Cable

3 2 1 | CONN:PITCH:1.0 SH1.0 20P WL P/N:1010H-20P HSG AND TER WL P/N:1010-T-T-S OR EQU WIRE：UL10064 32AWG OD:0.38mm COLOR SEE LIST L1=265±1mm;L2=280±1mm ROHS | 1 SET 1 SET 20 PCS
核准(APPROVED BY) 審核(CHECKED BY) | 繪圖(DRAWN BY) 日期(DATE) | 品号(CUSTOMER P/N) CONN:0.5mm PITCH,30Pin I-PEX P/N:20453-230T-11 BODY+SHELL+Plull_Bar

版本(REV): A 頁碼(SHEET):1 OF 1

编号 规格描述 (NO.) (SPECIFICATION) | | 数量 (Q"TY)

MNT24082901

注意﹕圖面非比例顯示﹐所有尺寸以毫米為單位。 (NOTE: DRAWING NOT TO SCALE HIDDEN LINES NOT SHOWN. ALL DIMENSION IN MM).
