cetola/reform-next-mirror/nref-cables/FJ-MNT-24092502.pdf

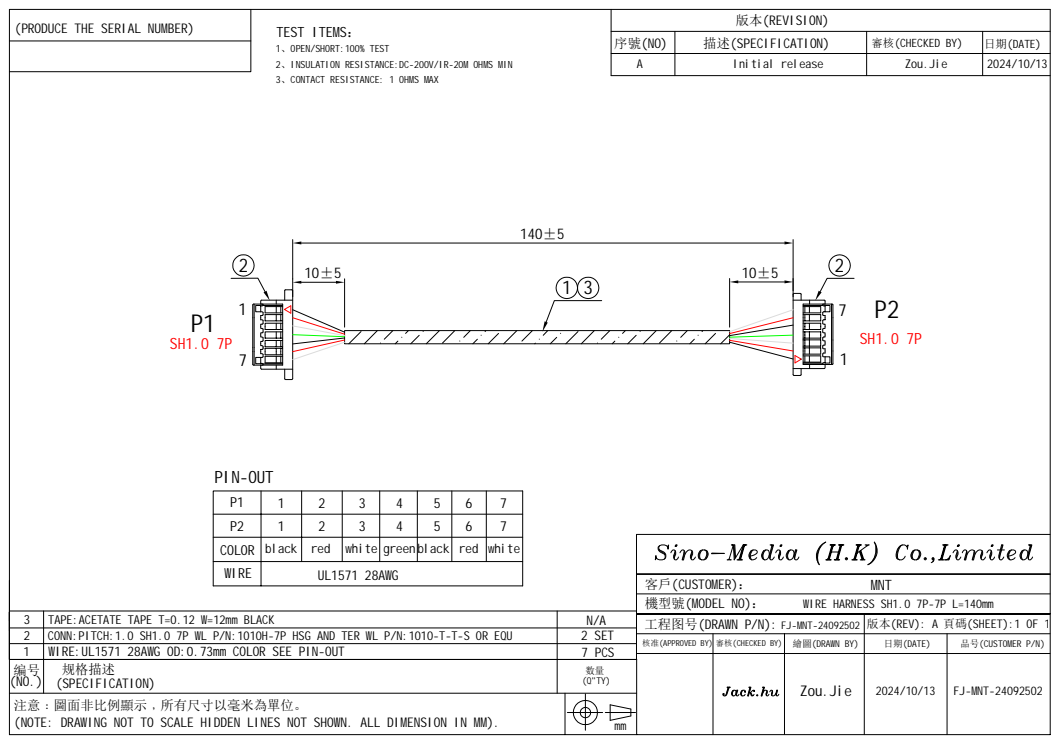
[picture p149: page 1]
(NOTE: DRAWING NOT TO SCALE HIDDEN LINES NOT SHOWN. ALL DIMENSION IN MM).; MNT; 描述(SPECIFICATION); 版本(REVISION); 審核(CHECKED BY); 日期(DATE); Initial release; Zou.Jie; WIRE HARNESS SH1.0 7P-7P L=140mm; PIN-OUT; WIRE; COLOR; black; UL1571 28AWG; red; white; green

(PRODUCE THE SERIAL NUMBER)

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

客戶(CUSTOMER)：
機型號(MODEL NO)：

3 TAPE:ACETATE TAPE T=0.12 W=12mm BLACK 2 1 | | N/A 2 SET 7 PCS | 工程图号(DRAWN P/N): FJ-MNT-24092502 版本(REV): A 頁碼(SHEET):1 OF 1
核准(APPROVED BY) 審核(CHECKED BY) | 繪圖(DRAWN BY) 日期(DATE) | 品号(CUSTOMER P/N) CONN:PITCH:1.0 SH1.0 7P WL P/N:1010H-7P HSG AND TER WL P/N:1010-T-T-S OR EQU WIRE:UL1571 28AWG OD:0.73mm COLOR SEE PIN-OUT

编号 规格描述 (NO.) (SPECIFICATION) | 数量 (Q"TY)

Zou.Jie 2024/10/13 | FJ-MNT-24092502

注意﹕圖面非比例顯示﹐所有尺寸以毫米為單位。
