cetola/reform-next-mirror/nref-cables/FJ-MNT-24092508-2pin-batt-95mm.pdf

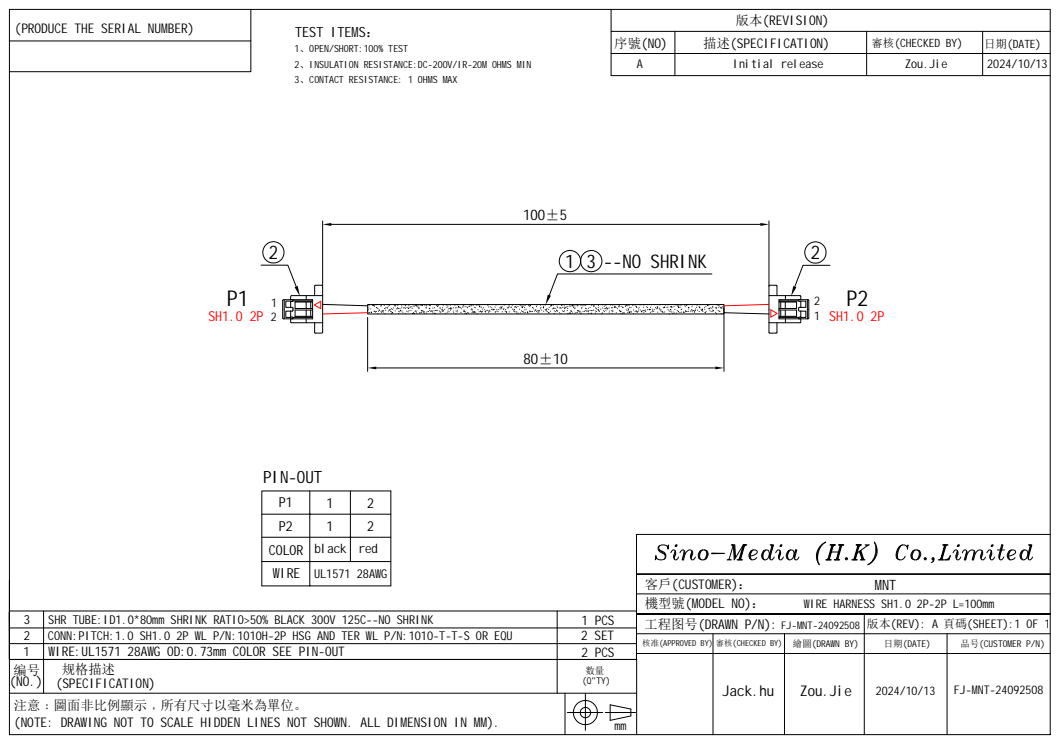
[picture p152: page 1]
(NOTE: DRAWING NOT TO SCALE HIDDEN LINES NOT SHOWN. ALL DIMENSION IN MM).; MNT; 描述(SPECIFICATION); 版本(REVISION); 審核(CHECKED BY); 日期(DATE); Initial release; Zou.Jie; WIRE HARNESS SH1.0 2P-2P L=100mm; PIN-OUT; WIRE; COLOR; black; UL1571 28AWG; red; 3、CONTACT RESISTANCE: 1 OHMS MAX; --NO SHRINK

(PRODUCE THE SERIAL NUMBER)

TEST ITEMS：
1、OPEN/SHORT:100% TEST
2、INSULATION RESISTANCE:DC-200V/IR-20M OHMS MIN

客戶(CUSTOMER)：
機型號(MODEL NO)：

3 SHR TUBE:ID1.0*80mm SHRINK RATIO>50% BLACK 300V 125C--NO SHRINK 2 1 | | 1 PCS 2 SET 2 PCS | 工程图号(DRAWN P/N): FJ-MNT-24092508 版本(REV): A 頁碼(SHEET):1 OF 1
核准(APPROVED BY) 審核(CHECKED BY) | 繪圖(DRAWN BY) 日期(DATE) | 品号(CUSTOMER P/N) CONN:PITCH:1.0 SH1.0 2P WL P/N:1010H-2P HSG AND TER WL P/N:1010-T-T-S OR EQU WIRE:UL1571 28AWG OD:0.73mm COLOR SEE PIN-OUT

编号 规格描述 (NO.) (SPECIFICATION) | 数量 (Q"TY)

Jack.hu | Zou.Jie 2024/10/13 | FJ-MNT-24092508

注意﹕圖面非比例顯示﹐所有尺寸以毫米為單位。
