cetola/reform-next-mirror/nref-cables/to-redo/FJ-MNT-24092507-3pin-unk.pdf

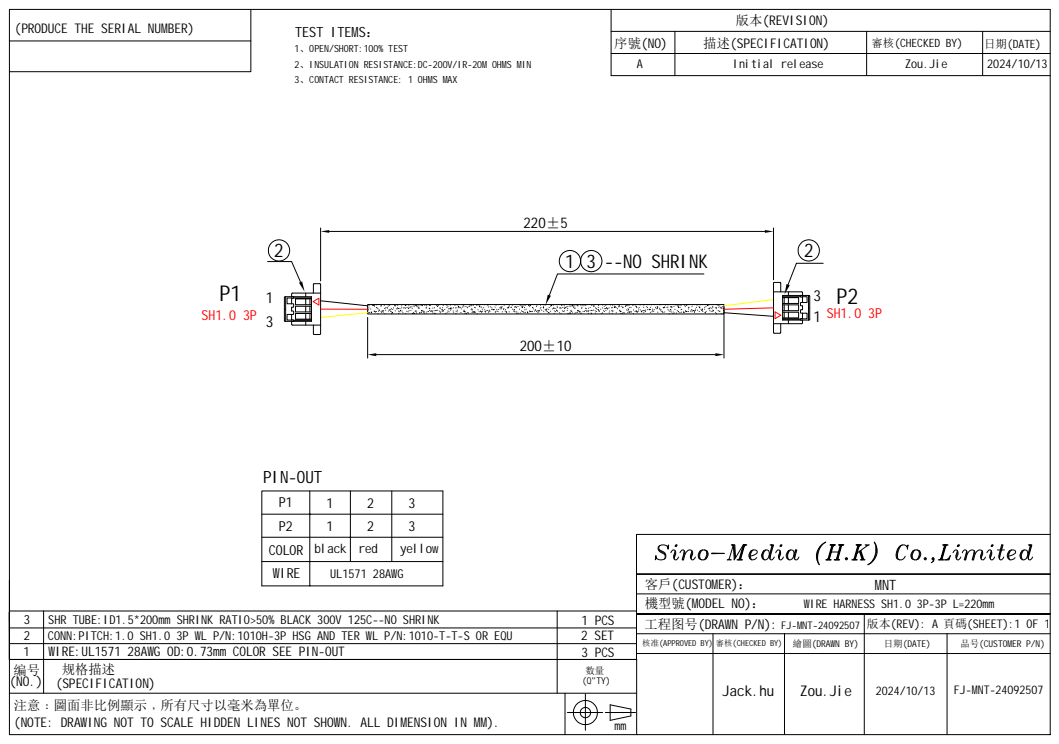
[picture p153: page 1]
(NOTE: DRAWING NOT TO SCALE HIDDEN LINES NOT SHOWN. ALL DIMENSION IN MM).; MNT; 描述(SPECIFICATION); 版本(REVISION); 審核(CHECKED BY); 日期(DATE); Initial release; Zou.Jie; WIRE HARNESS SH1.0 3P-3P L=220mm; PIN-OUT; WIRE; COLOR; black; UL1571 28AWG; red; yellow; 2 --NO SHRINK

(PRODUCE THE SERIAL NUMBER)

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

客戶(CUSTOMER)：
機型號(MODEL NO)：

3 SHR TUBE:ID1.5*200mm SHRINK RATIO>50% BLACK 300V 125C--NO SHRINK 2 1 | | 1 PCS 2 SET 3 PCS | 工程图号(DRAWN P/N): FJ-MNT-24092507 版本(REV): A 頁碼(SHEET):1 OF 1
核准(APPROVED BY) 審核(CHECKED BY) | 繪圖(DRAWN BY) 日期(DATE) | 品号(CUSTOMER P/N) CONN:PITCH:1.0 SH1.0 3P WL P/N:1010H-3P HSG AND TER WL P/N:1010-T-T-S OR EQU WIRE:UL1571 28AWG OD:0.73mm COLOR SEE PIN-OUT

编号 规格描述 (NO.) (SPECIFICATION) | 数量 (Q"TY)

Jack.hu | Zou.Jie 2024/10/13 | FJ-MNT-24092507

注意﹕圖面非比例顯示﹐所有尺寸以毫米為單位。
