cetola/reform-next-mirror/nref-motherboard/nref-motherboard.kicad_pcb

## KiCad design nref-motherboard/nref-motherboard.kicad_pcb (2026-09-02)

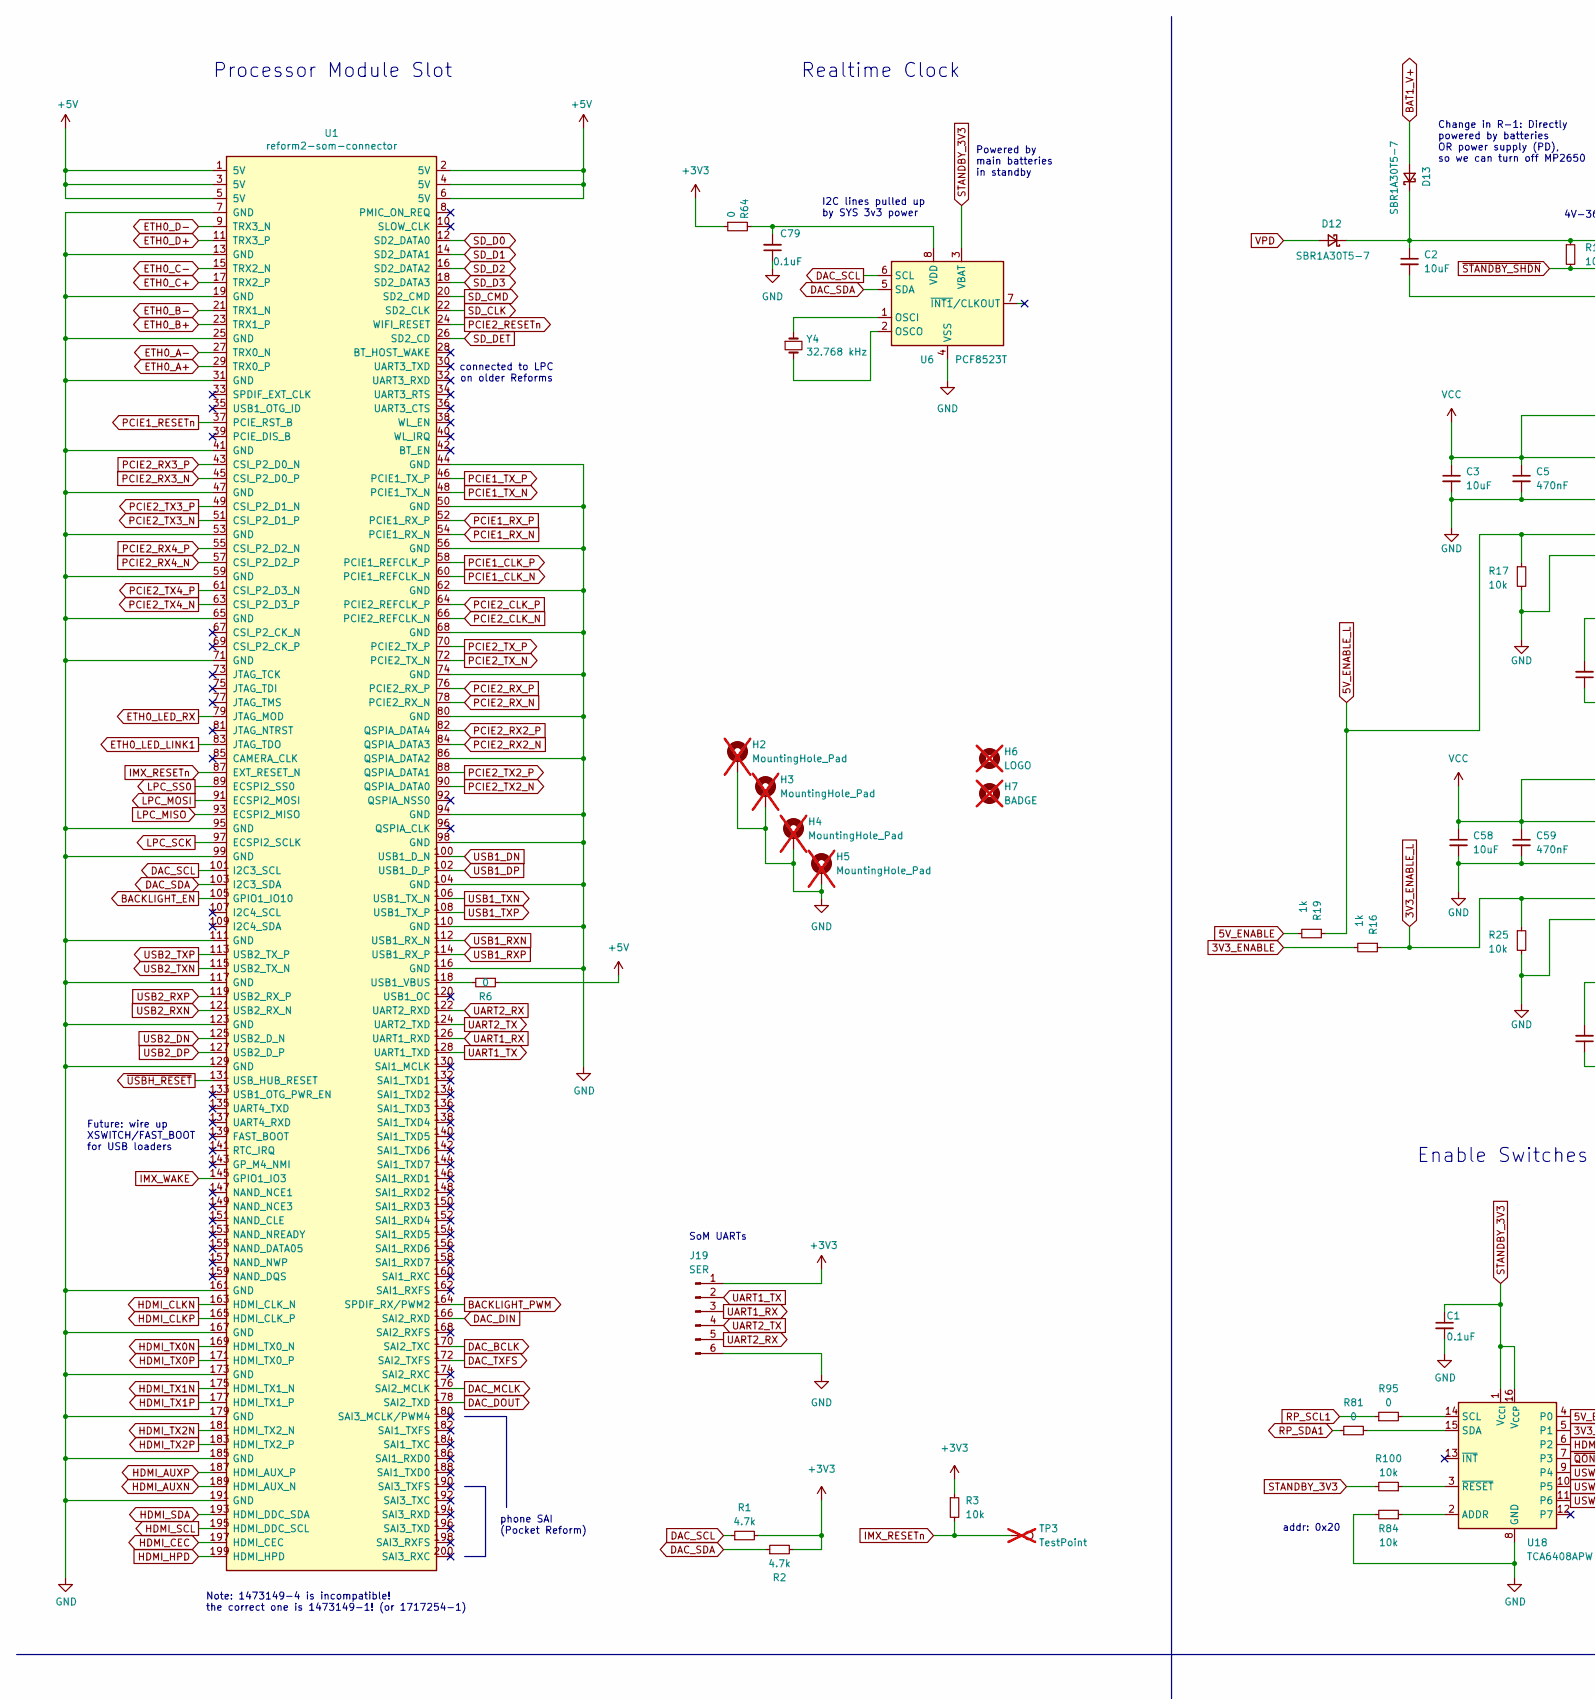
[picture p155: schematic nref-motherboard.kicad_sch, MNT Reform Next Mainboard, part in row 1, column 1]

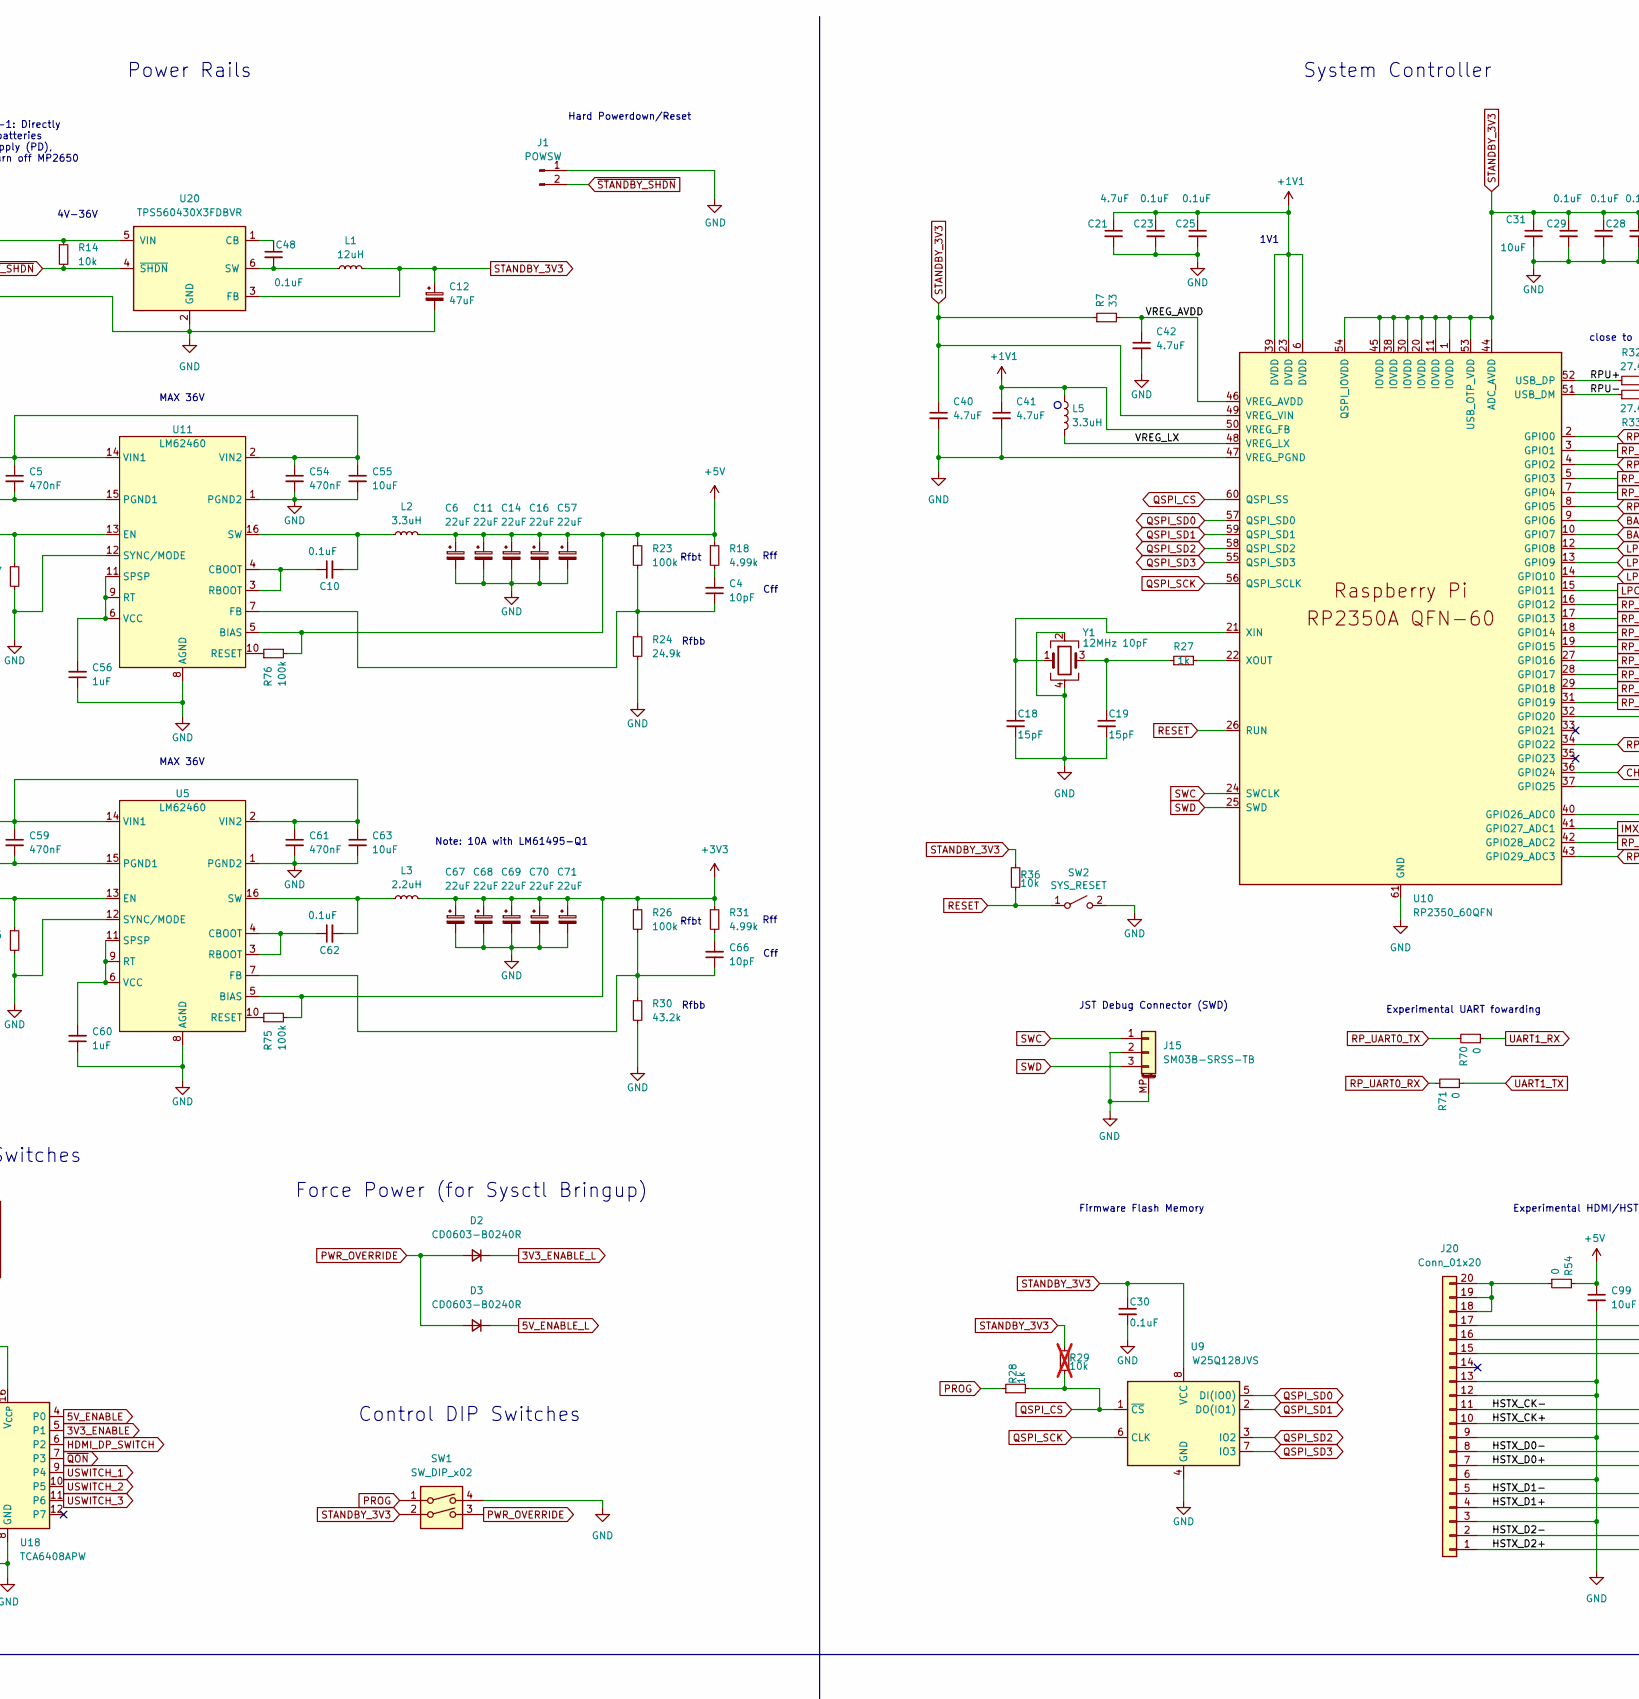
[picture p156: schematic nref-motherboard.kicad_sch, MNT Reform Next Mainboard, part in row 1, column 2]

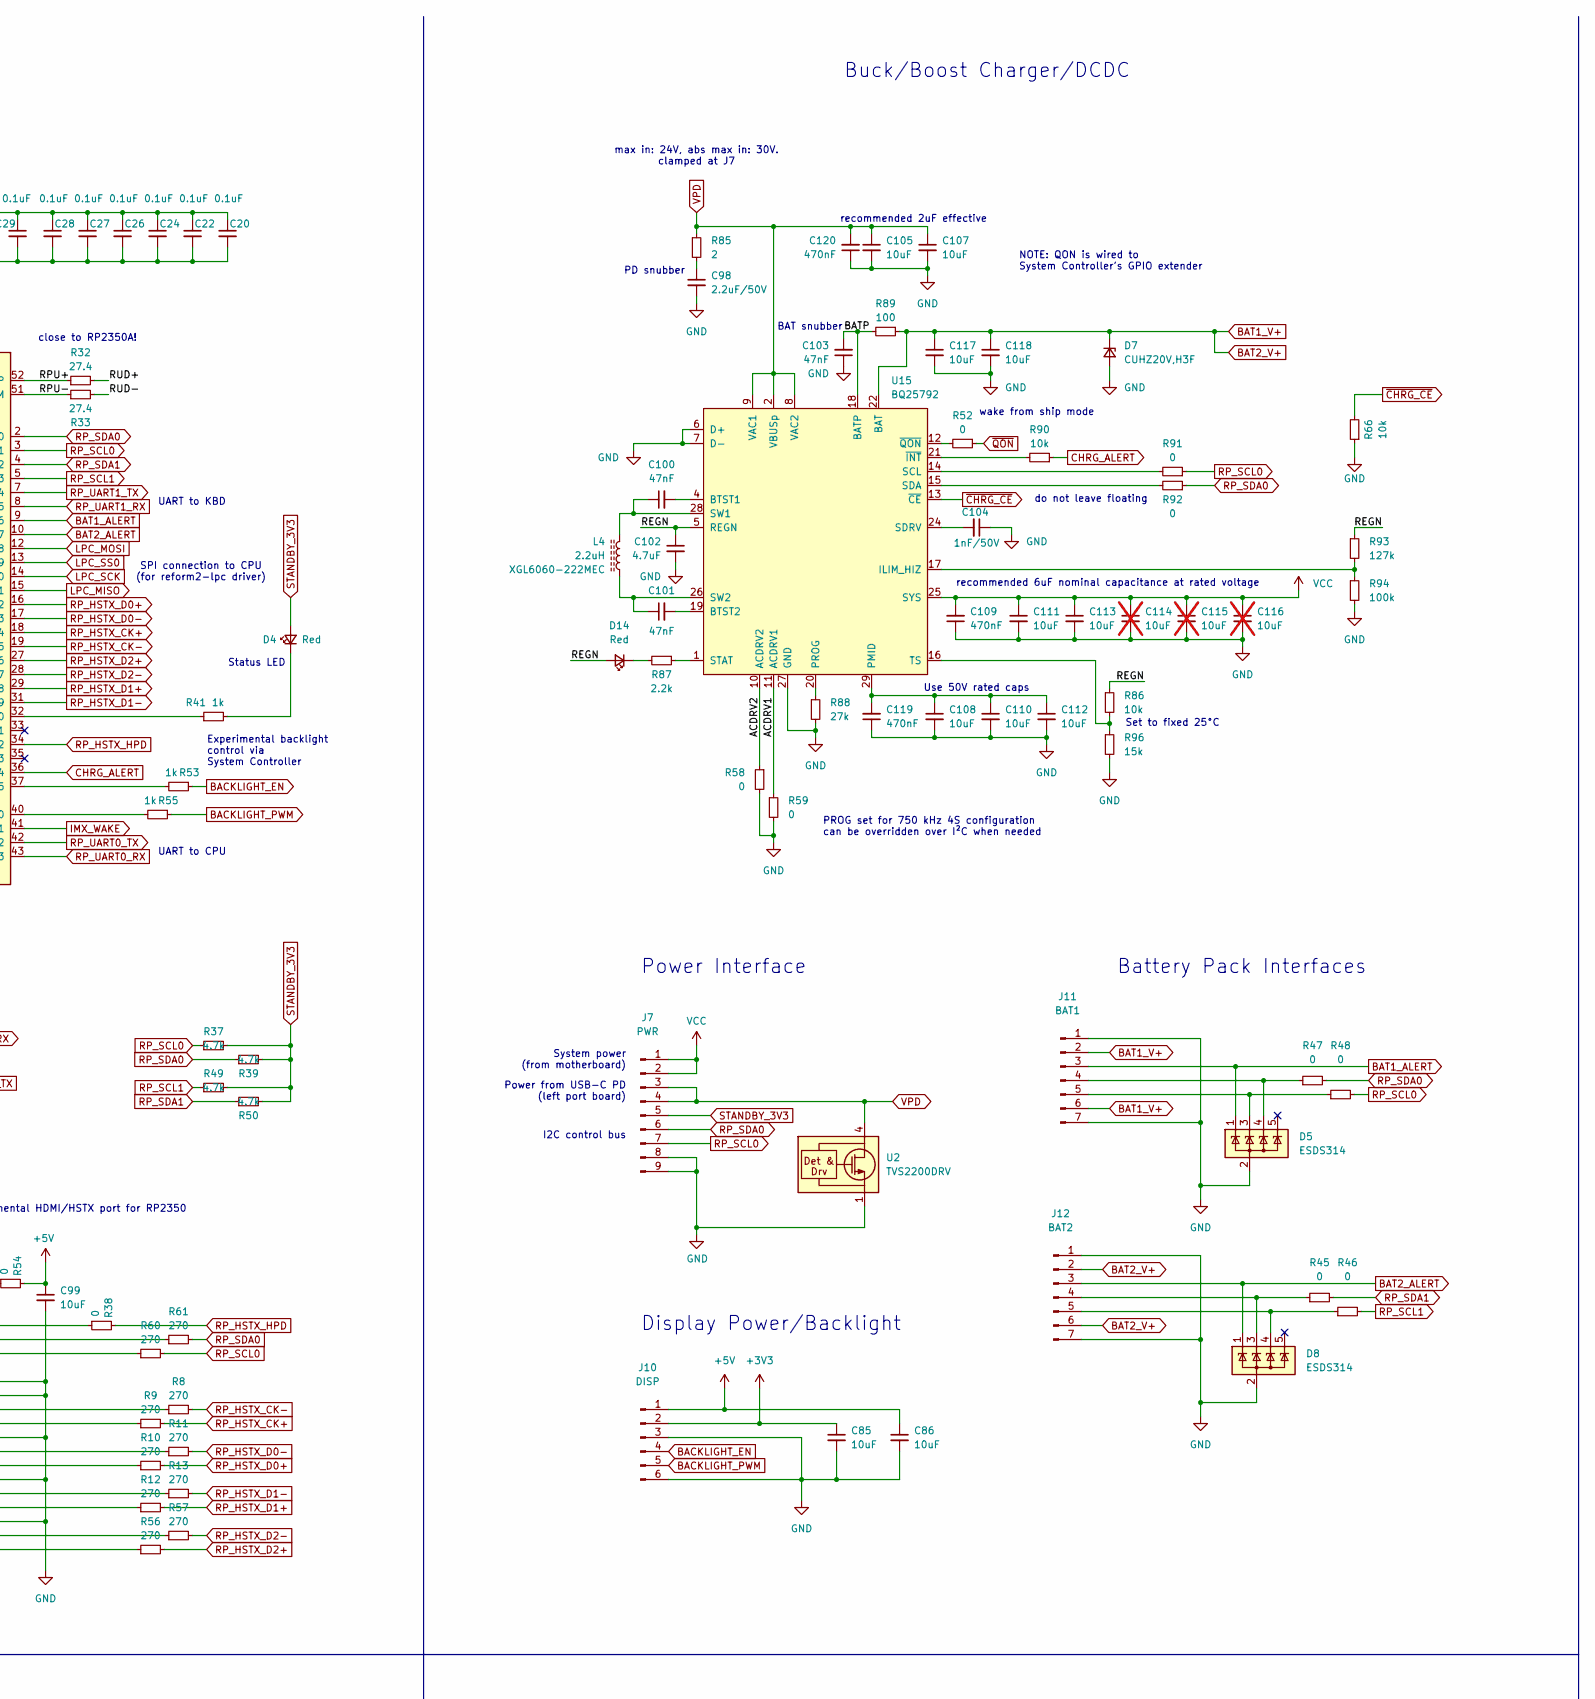
[picture p157: schematic nref-motherboard.kicad_sch, MNT Reform Next Mainboard, part in row 1, column 3]

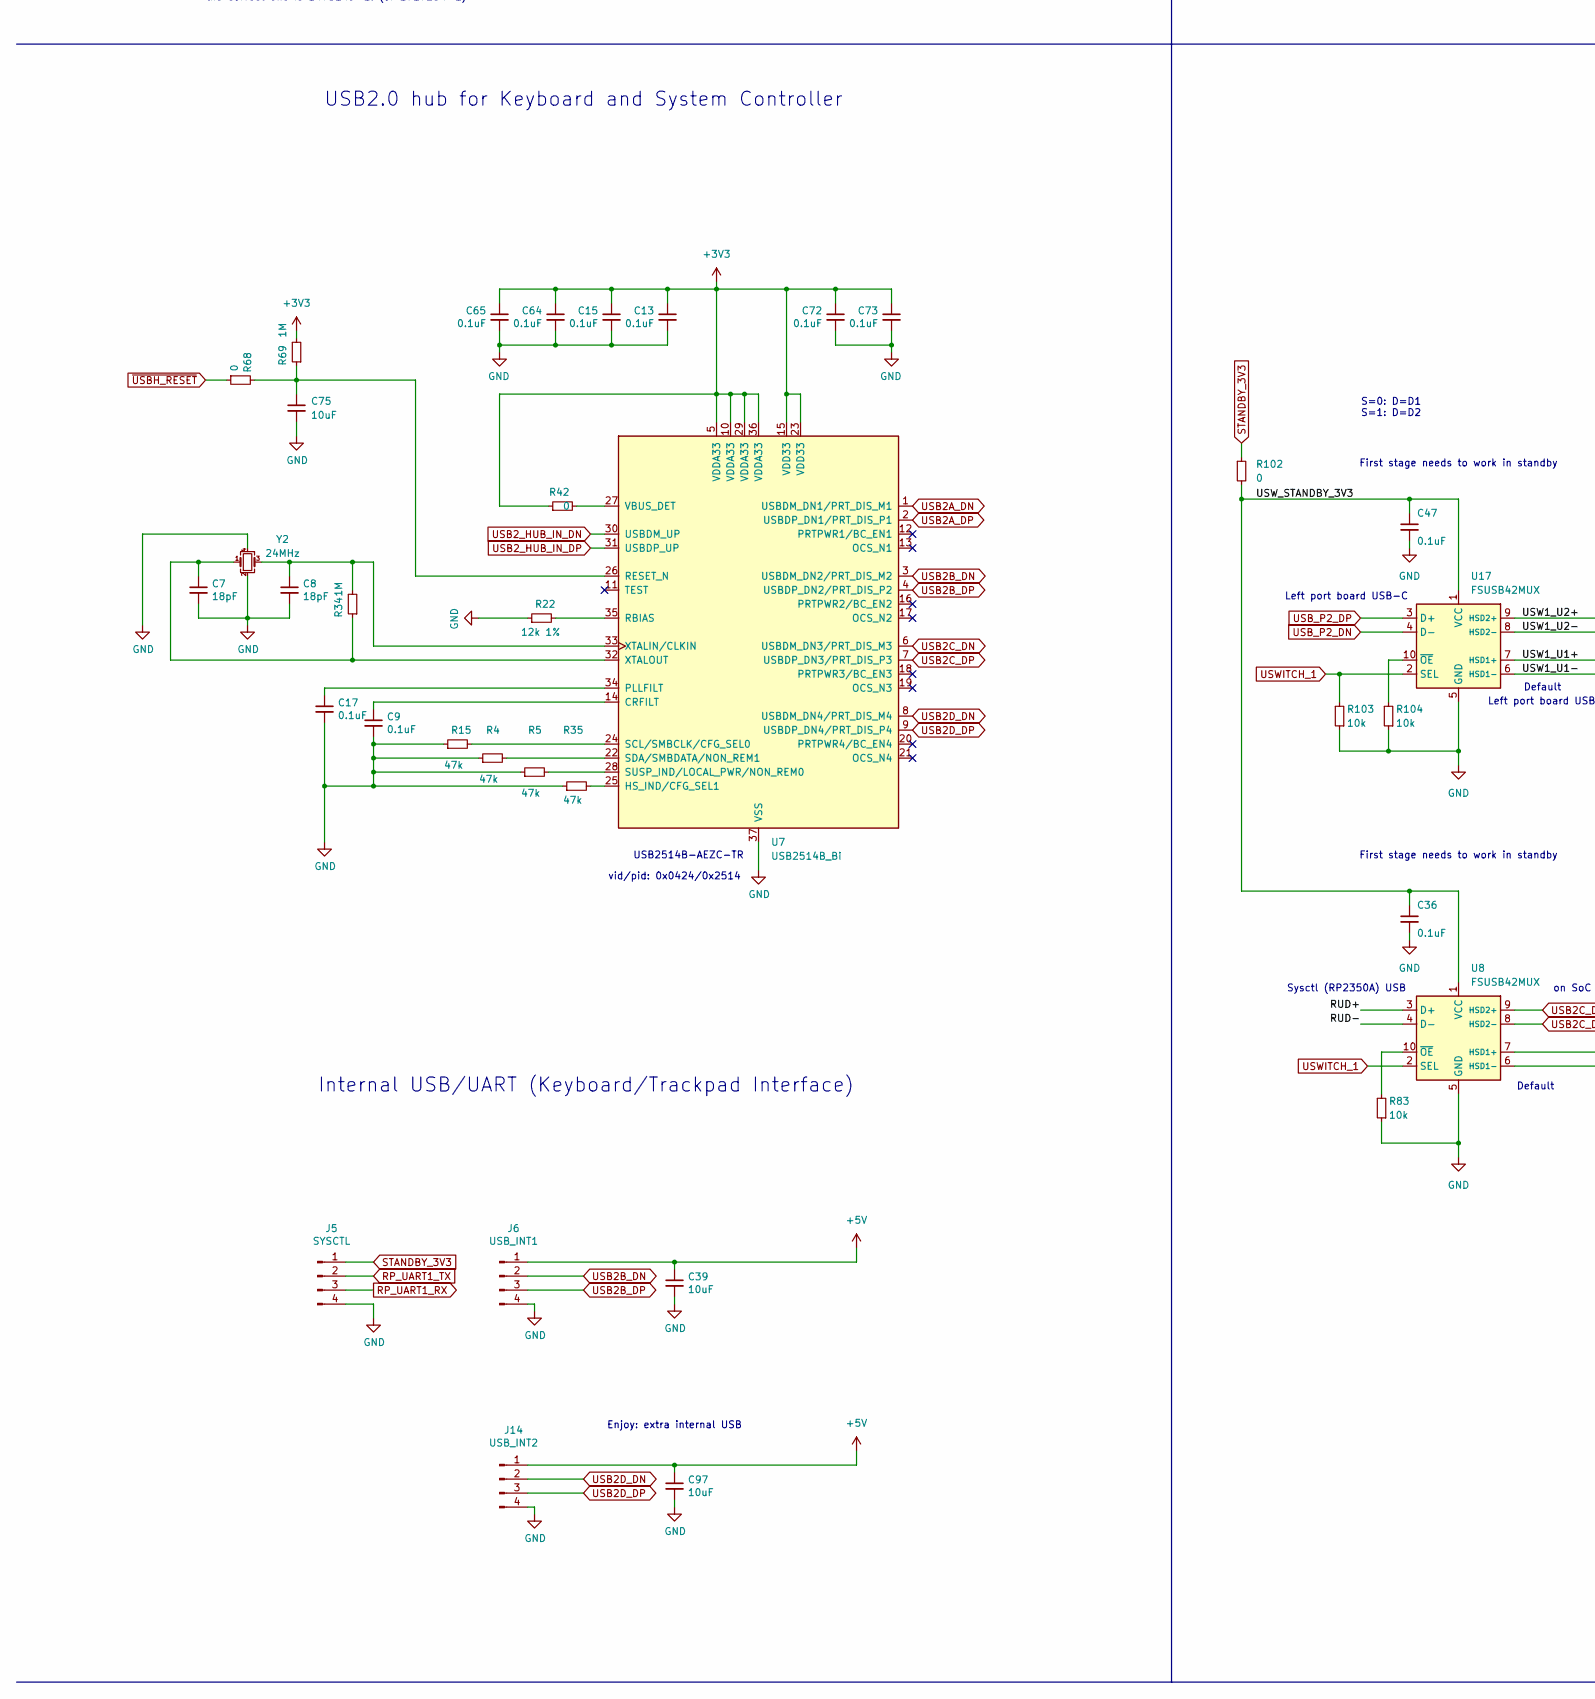
[picture p158: schematic nref-motherboard.kicad_sch, MNT Reform Next Mainboard, part in row 2, column 1]

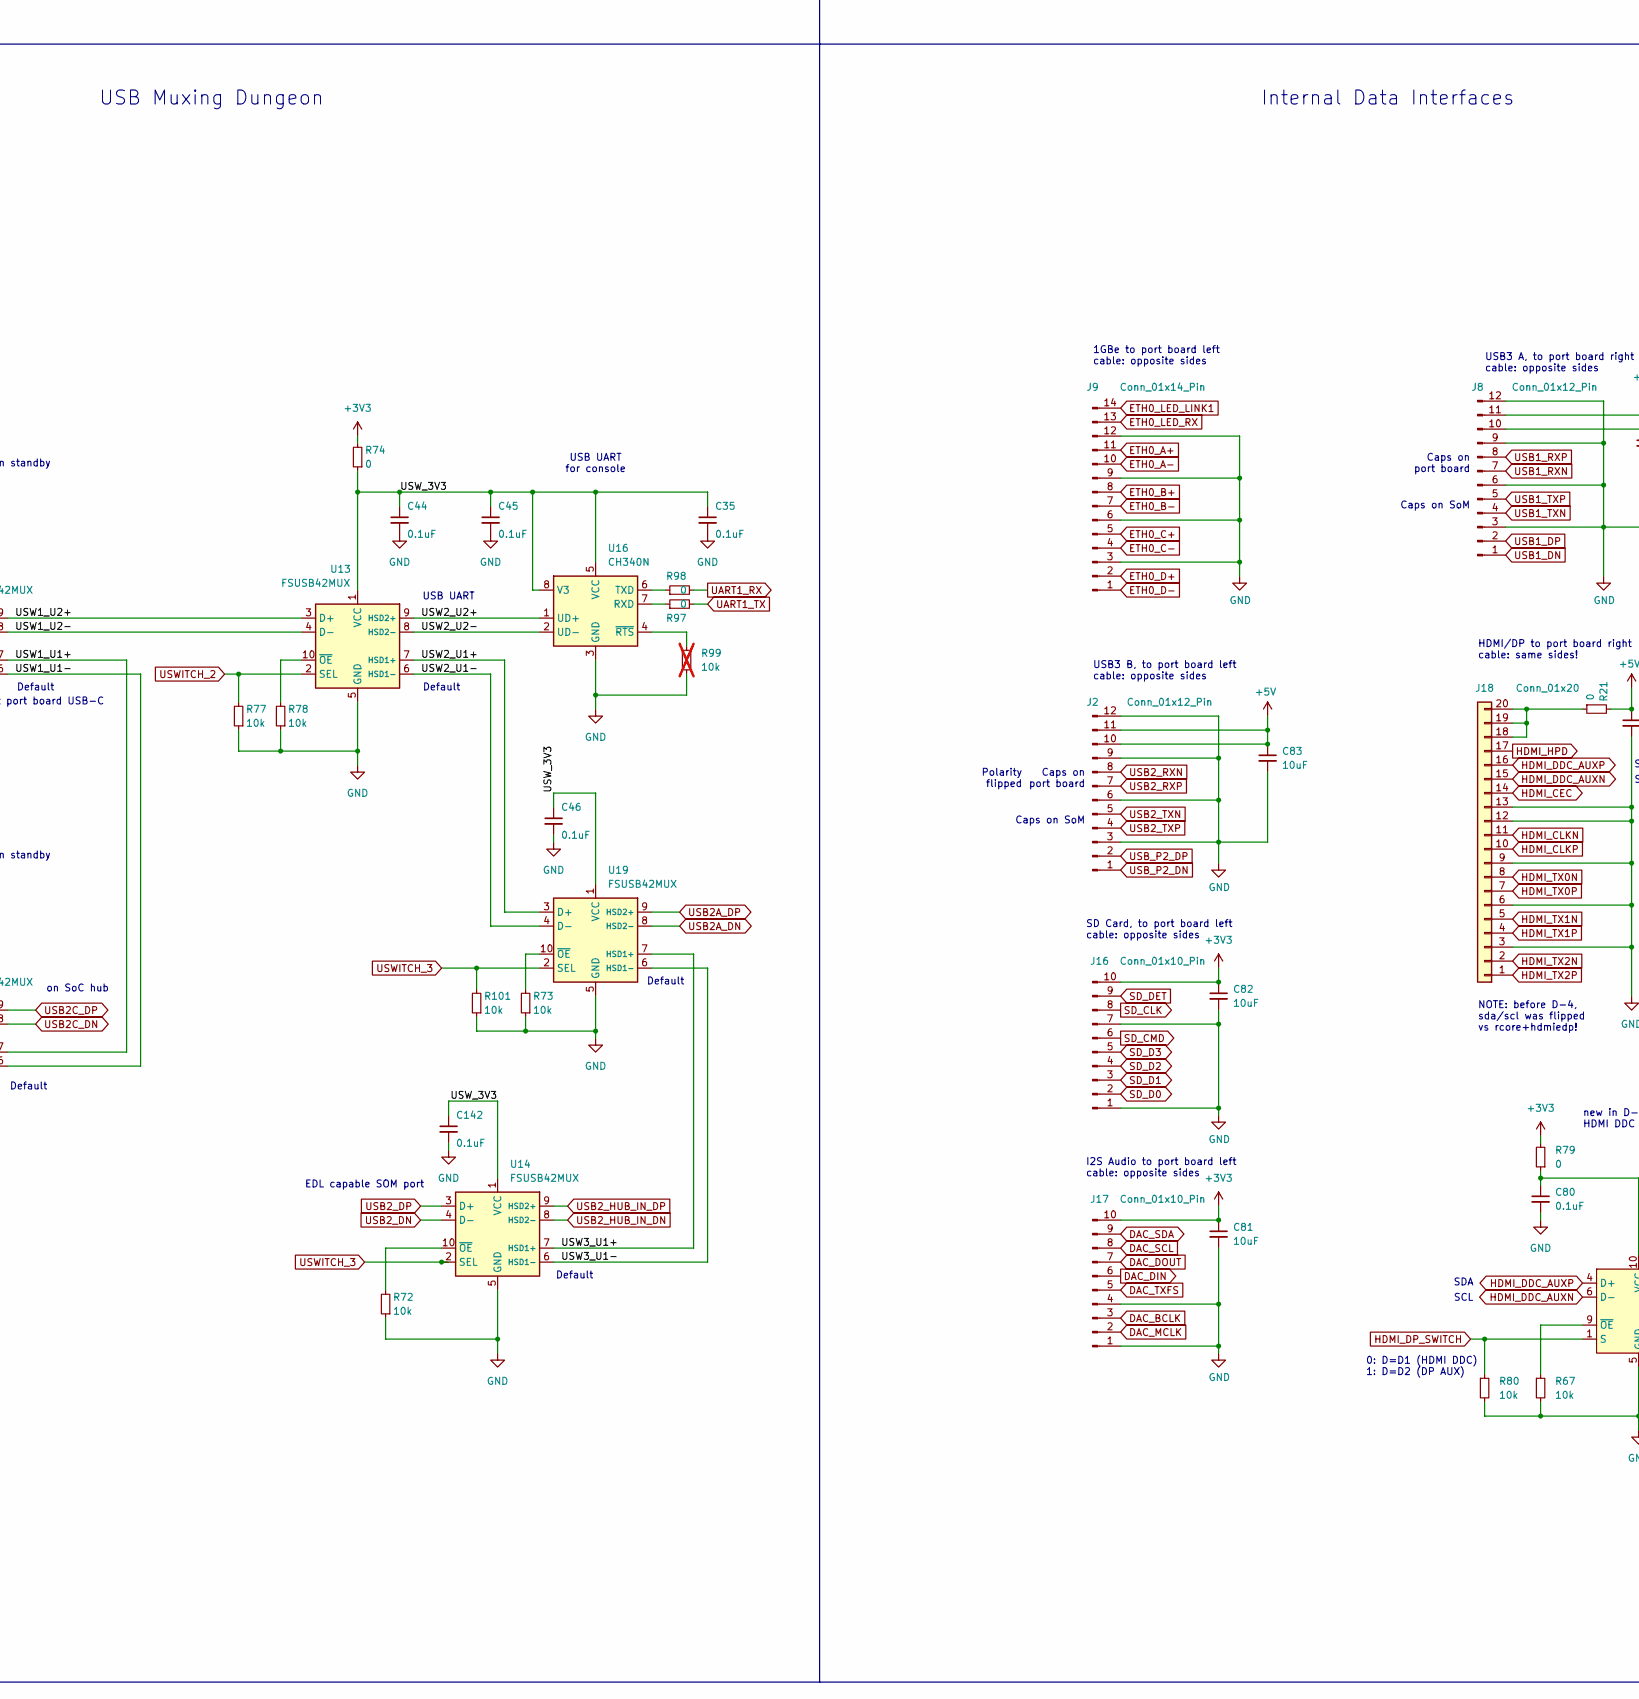
[picture p159: schematic nref-motherboard.kicad_sch, MNT Reform Next Mainboard, part in row 2, column 2]

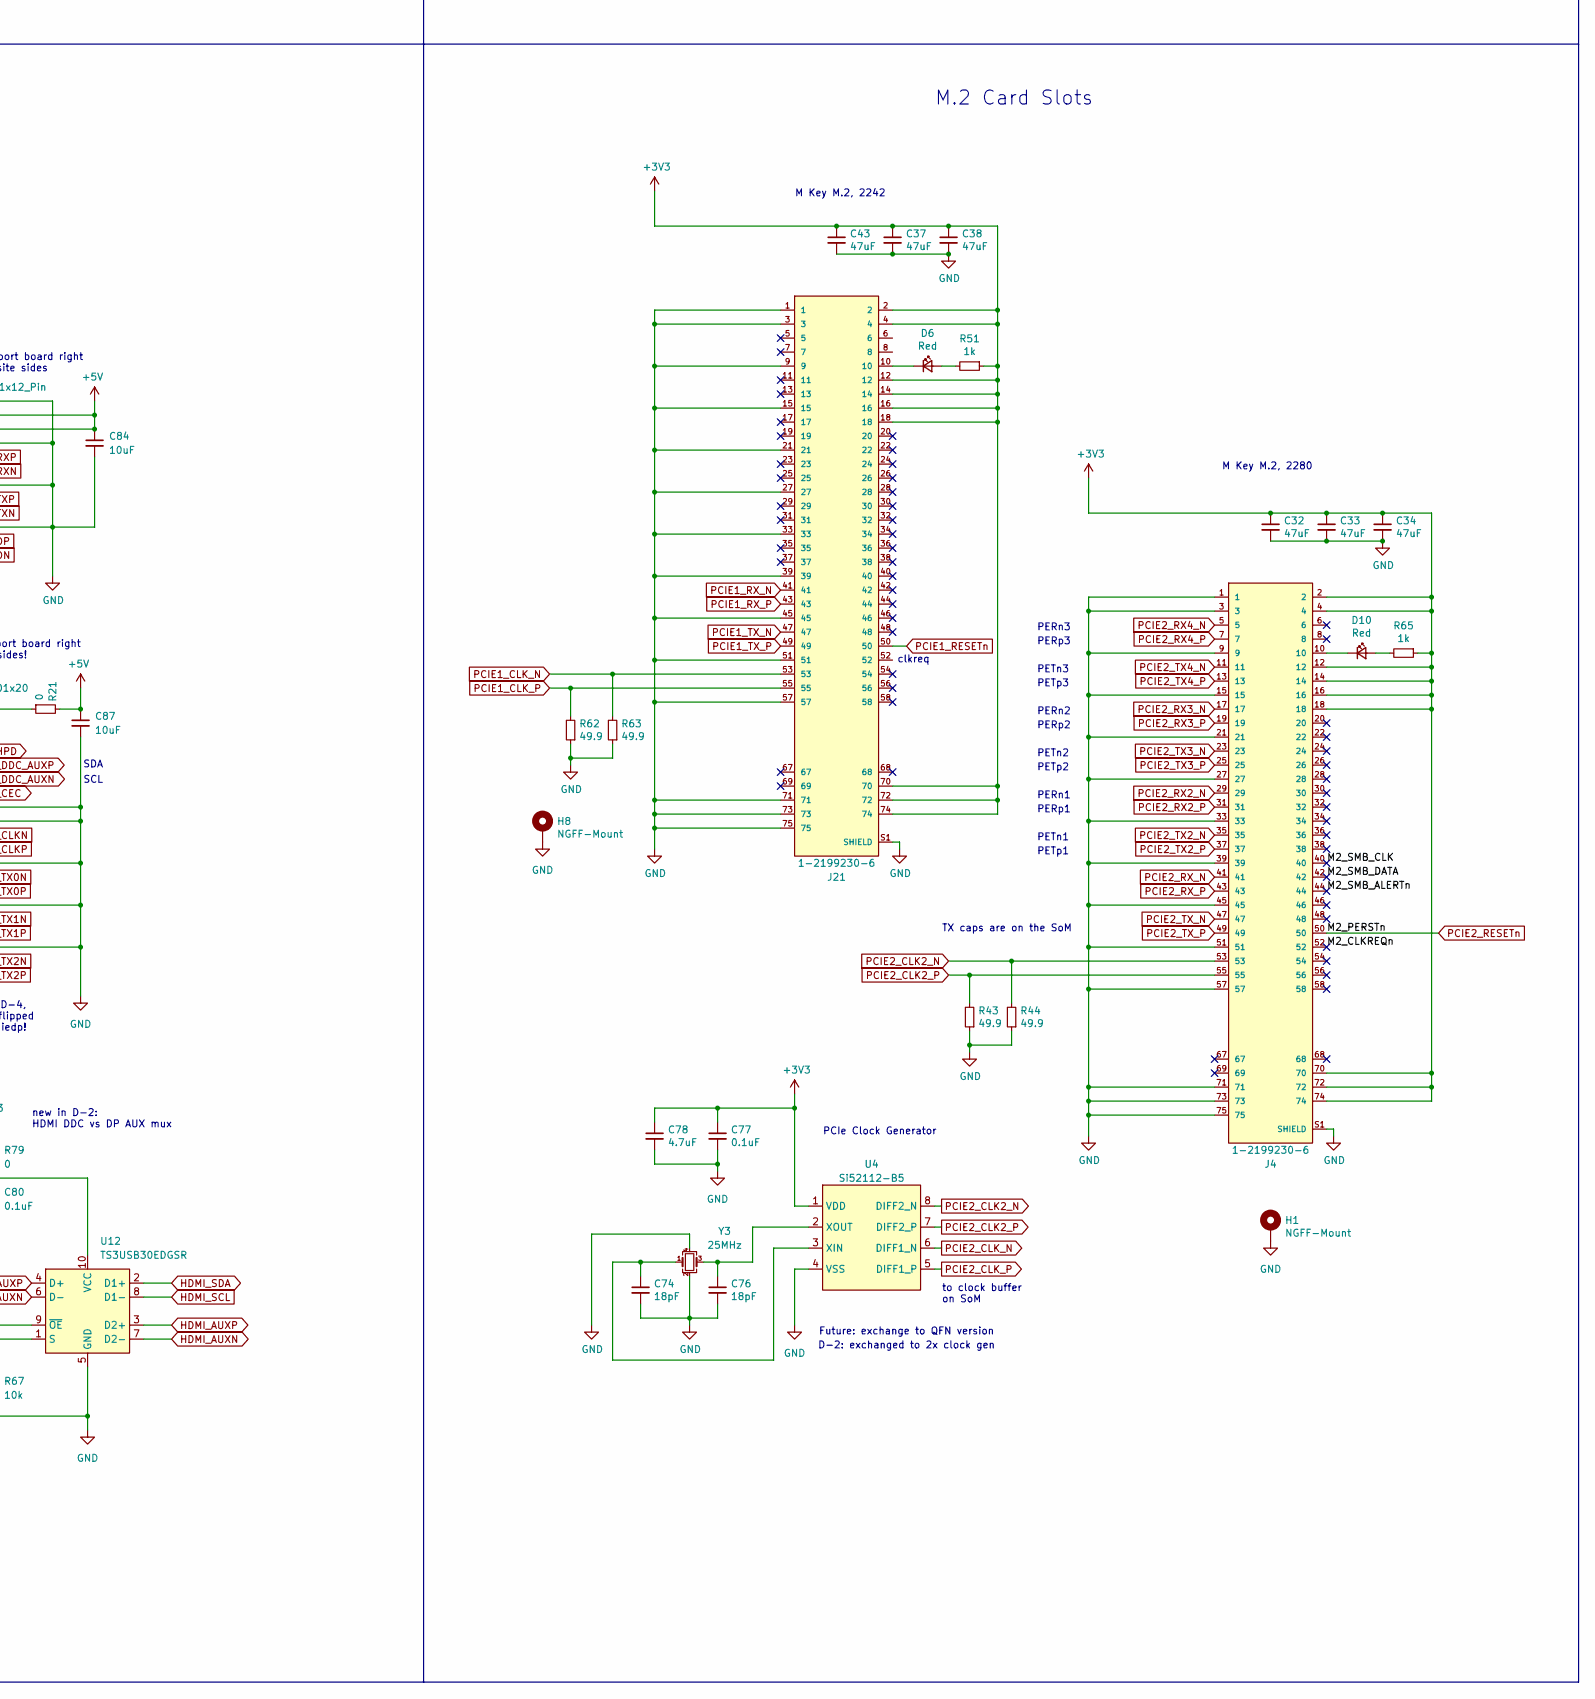
[picture p160: schematic nref-motherboard.kicad_sch, MNT Reform Next Mainboard, part in row 2, column 3]

Parts:
C1, C9, C10, C13, C15, C17, C20, C22, C23, C24, C25, C26, C27, C28, C29, C30, C35, C36, C44, C45, C46, C47, C48, C62, C64, C65, C72, C73, C77, C79, C80, C142: 0.1uF; C_0402_1005Metric; LCSC C1525
C2, C3, C31, C39, C55, C58, C63, C75, C81, C82, C83, C84, C85, C86, C87, C97, C99: 10uF; C_0603_1608Metric; LCSC C92487
C4, C66: 10pF; C_0402_1005Metric; LCSC C32949
C5, C54, C59, C61: 470nF; C_0603_1608Metric; LCSC C170149
C6, C11, C14, C16, C57, C67, C68, C69, C70, C71: 22uF; C_0603_1608Metric; LCSC C361061
C7, C8, C74, C76: 18pF; C_0402_1005Metric; LCSC C1549
C12, C32, C33, C34, C37, C38, C43: 47uF; C_0603_1608Metric; LCSC C140782
C18, C19: 15pF; C_0603_1608Metric; LCSC C1644
C21, C41: 4.7uF; C_0603_1608Metric; LCSC C19666
C40, C42, C78, C102: 4.7uF; C_0402_1005Metric; LCSC C23733
C56, C60: 1uF; C_0402_1005Metric; LCSC C52923
C98: 2.2uF/50V; C_1206_3216Metric; LCSC C50254
C100, C101, C103: 47nF; C_0402_1005Metric; LCSC C272875
C104: 1nF/50V; C_0402_1005Metric; LCSC C1523
C105, C107, C108, C110, C112, C117, C118: 10uF; C_0805_2012Metric; LCSC C440198
C109, C119, C120: 470nF; C_0402_1005Metric; LCSC C437527
C111, C113: 10uF; C_1206_3216Metric; LCSC C13585
C114, C115, C116: 10uF; C_0603_1608Metric; not fitted
D2, D3: CD0603-B0240R; D_0603_1608Metric; LCSC C3312582
D4, D6, D10, D14: Red; LED_0603_1608Metric; LCSC C83242
D5, D8: ESDS314; SOT-23-5; LCSC C1847859
D7: CUHZ20V,H3F; D_SOD-323; LCSC C2857019
D12, D13: SBR1A30T5-7; D_SOD-323; LCSC C53100376
H1, H8: NGFF-Mount; WA-SMSI-M2; LCSC C22431324
H2, H3, H4, H5: MountingHole_Pad; MountingHole_2.5mm_Pad; not fitted
H6: LOGO; nref-logo; not fitted
H7: BADGE; nref-motherboard-badge; not fitted
J1: POWSW; JST_SH_SM02B-SRSS-TB_1x02-1MP_P1.00mm_Horizontal; LCSC C160402
J2, J8: Conn_01x12_Pin; Hirose_FH12-12S-0.5SH_1x12-1MP_P0.50mm_Horizontal; LCSC C2906115
J4, J21: 1-2199230-6; TE_1-2199230-6; LCSC C4710843
J5: SYSCTL; JST_SH_SM04B-SRSS-TB_1x04-1MP_P1.00mm_Horizontal; LCSC C160404
J6: USB_INT1; JST_SH_SM04B-SRSS-TB_1x04-1MP_P1.00mm_Horizontal; LCSC C160404
J7: PWR; JST_SH_SM09B-SRSS-TB_1x09-1MP_P1.00mm_Horizontal; LCSC C160408
J9: Conn_01x14_Pin; Hirose_FH12-14S-0.5SH_1x14-1MP_P0.50mm_Horizontal; LCSC C2906116
J10: DISP; JST_SH_SM06B-SRSS-TB_1x06-1MP_P1.00mm_Horizontal; LCSC C160405
J11: BAT1; JST_SH_SM07B-SRSS-TB_1x07-1MP_P1.00mm_Horizontal; LCSC C160406
J12: BAT2; JST_SH_SM07B-SRSS-TB_1x07-1MP_P1.00mm_Horizontal; LCSC C160406
J14: USB_INT2; JST_SH_SM04B-SRSS-TB_1x04-1MP_P1.00mm_Horizontal; LCSC C160404
J15: SM03B-SRSS-TB; JST_SH_SM03B-SRSS-TB_1x03-1MP_P1.00mm_Horizontal; LCSC C160403
J16, J17: Conn_01x10_Pin; Hirose_FH12-10S-0.5SH_1x10-1MP_P0.50mm_Horizontal; LCSC C2906114
J18, J20: Conn_01x20; Hirose_FH12-20S-0.5SH_1x20-1MP_P0.50mm_Horizontal; LCSC C2906119
J19: SER; JST_SH_SM06B-SRSS-TB_1x06-1MP_P1.00mm_Horizontal; LCSC C160405
L1: 12uH; L_Taiyo-Yuden_NR-30xx; LCSC C167758
L2: 3.3uH; L_Coilcraft_XAL6060-XXX; LCSC C3040366
L3: 2.2uH; L_Coilcraft_XAL6060-XXX; LCSC C167218
L4: 2.2uH; L_Coilcraft_XAL6060-XXX; MPN XGL6060-222MEC; LCSC C3911671
L5: 3.3uH; L_pol_2016; LCSC C42411119
R1, R2, R37, R39, R49, R50: 4.7k; R_0402_1005Metric; LCSC C25900
R3, R14, R17, R25, R36, R66, R67, R72, R73, R77, R78, R80, R83, R84, R86, R90, R100, R101, R103, R104: 10k; R_0402_1005Metric; LCSC C25744
R4, R5, R15, R35: 47k; R_0402_1005Metric; LCSC C25792
R6, R21, R38, R42, R45, R46, R47, R48, R52, R54, R58, R59, R64, R68, R70, R71, R74, R79, R81, R91, R92, R95, R97, R98, R102: 0; R_0402_1005Metric; LCSC C17168
R7: 33; R_0402_1005Metric; LCSC C25105
R8, R9, R10, R11, R12, R13, R56, R57, R60, R61: 270; R_0402_1005Metric; LCSC C25099
R16, R19, R27, R28, R41, R51, R53, R55, R65: 1k; R_0402_1005Metric; LCSC C11702
R18, R31: 4.99k; R_0402_1005Metric; LCSC C25903
R22: 12k 1%; R_0402_1005Metric; LCSC C25752
R23, R26, R75, R76: 100k; R_0402_1005Metric; LCSC C25741
R24: 24.9k; R_0402_1005Metric; LCSC C25874
R29: 10k; R_0402_1005Metric; LCSC C60490; not fitted
R30: 43.2k; R_0402_1005Metric; LCSC C25894
R32, R33: 27.4; R_0402_1005Metric; LCSC C31439
R34, R69: 1M; R_0402_1005Metric; LCSC C26083
R43, R44, R62, R63: 49.9; R_0402_1005Metric; LCSC C25120
R85: 2; R_0603_1608Metric; LCSC C22977
R87: 2.2k; R_0402_1005Metric; LCSC C25879
R88: 27k; R_0402_1005Metric; LCSC C25771
R89: 100; R_0402_1005Metric; LCSC C25076
R93: 127k; C_0603_1608Metric; LCSC C22869
R94: 100k; C_0603_1608Metric; LCSC C25803
R96: 15k; R_0402_1005Metric; LCSC C25756
R99: 10k; R_0402_1005Metric; LCSC C25744; not fitted
SW1: SW_DIP_x02; SW_DIP_SPSTx02_Slide_KingTek_DSHP02TJ_W5.25mm_P1.27mm_JPin; LCSC C3293149
SW2: SYS_RESET; SW_Push_1P1T_NO_CK_KMR2; LCSC C2689696
TP3: TestPoint; TestPoint_Pad_D1.0mm; not fitted
U1: reform2-som-connector; TE_1473149-4; LCSC C590722
U2: TVS2200DRV; WSON-6-1EP_2x2mm_P0.65mm_EP1x1.6mm; LCSC C523793
U4: Si52112-B5; TSSOP-8_4.4x3mm_P0.65mm; LCSC C1540577
U5, U11: LM62460; CONV_LM61495QRPHRQ1; LCSC C3198091
U6: PCF8523T; SOIC-8_3.9x4.9mm_P1.27mm; LCSC C2651516
U7: USB2514B_Bi; QFN-36-1EP_6x6mm_P0.5mm_EP3.7x3.7mm; LCSC C220807
U8, U13, U14, U17, U19: FSUSB42MUX; MSOP-10_3x3mm_P0.5mm; LCSC C11355
U9: W25Q128JVS; SOIC-8_5.23x5.23mm_P1.27mm; LCSC C179173
U10: RP2350_60QFN; RP2350-QFN-60-1EP_7x7_P0.4mm_EP3.4x3.4mm_ThermalVias; LCSC C42411118
U12: TS3USB30EDGSR; VSSOP-10_3x3mm_P0.5mm; LCSC C131998
U15: BQ25792; Texas_VQFN-HR_RQM_4x4mm_P0.40-0.45mm; LCSC C2862876
U16: CH340N; SOIC-8_3.9x4.9mm_P1.27mm; LCSC C2977777
U18: TCA6408APW; TSSOP-16_4.4x5mm_P0.65mm; LCSC C206177
U20: TPS560430X3FDBVR; SOT-23-6; LCSC C2071721
Y1: 12MHz 10pF; Crystal_SMD_3225-4Pin_3.2x2.5mm; LCSC C20625731
Y2: 24MHz; Crystal_SMD_3225-4Pin_3.2x2.5mm; LCSC C91744
Y3: 25MHz; Crystal_SMD_3225-4Pin_3.2x2.5mm; LCSC C2939753
Y4: 32.768 kHz; Crystal_SMD_3215-2Pin_3.2x1.5mm; LCSC C48615

Connections:
3V3_ENABLE: R16.2, U18.5 (P1)
3V3_ENABLE_L: D2.1 (K), R16.1, R25.1, U5.13 (EN)
5V_ENABLE: R19.2, U18.4 (P0)
5V_ENABLE_L: D3.1 (K), R17.1, R19.1, U11.13 (EN)
+1V1: C21.1, C23.1, C25.1, C41.1, L5.1, U10.6 (DVDD), U10.23 (DVDD), U10.39 (DVDD), U10.50 (VREG_FB)
+5V: C6.1, C11.1, C14.1, C16.1, C39.1, C57.1, C83.1, C84.1, C86.1, C87.1, C97.1, C99.1, J2.10, J2.11, J6.1, J8.10, J8.11, J10.1, J14.1, L2.2, R6.1, R18.1, R21.2, R23.1, R54.2, R76.2, U1.1 (5V), U1.2 (5V), U1.3 (5V), U1.4 (5V), U1.5 (5V), U1.6 (5V), U11.5 (BIAS)
/ACDRV1: R59.1, U15.11 (ACDRV1)
/ACDRV2: R58.1, U15.10 (ACDRV2)
/BATP: C103.2, R89.2, U15.18 (BATP)
/HSTX_CK+: J20.10, R9.1
/HSTX_CK-: J20.11, R8.1
/HSTX_D0+: J20.7, R10.1
/HSTX_D0-: J20.8, R11.1
/HSTX_D1+: J20.4, R12.1
/HSTX_D1-: J20.5, R13.1
/HSTX_D2+: J20.1, R56.1
/HSTX_D2-: J20.2, R57.1
/M2_CLKREQn: J4.52
/M2_SMB_ALERTn: J4.44
/M2_SMB_CLK: J4.40
/M2_SMB_DATA: J4.42
/REGN: C102.1, D14.2 (A), R86.1, R93.1, U15.5 (REGN)
/RPU+: R32.1, U10.52 (USB_DP)
/RPU-: R33.1, U10.51 (USB_DM)
/RUD+: R32.2, U8.3 (D+)
/RUD-: R33.2, U8.4 (D-)
/USW1_U1+: U8.7 (HSD1+), U17.7 (HSD1+)
/USW1_U1-: U8.6 (HSD1-), U17.6 (HSD1-)
/USW1_U2+: U13.3 (D+), U17.9 (HSD2+)
/USW1_U2-: U13.4 (D-), U17.8 (HSD2-)
/USW2_U1+: U13.7 (HSD1+), U19.3 (D+)
/USW2_U1-: U13.6 (HSD1-), U19.4 (D-)
/USW2_U2+: U13.9 (HSD2+), U16.1 (UD+)
/USW2_U2-: U13.8 (HSD2-), U16.2 (UD-)
/USW3_U1+: U14.7 (HSD1+), U19.7 (HSD1+)
/USW3_U1-: U14.6 (HSD1-), U19.6 (HSD1-)
/USW_STANDBY_3V3: C36.1, C47.1, R102.2, U8.1 (VCC), U17.1 (VCC)
/VREG_AVDD: C42.1, R7.2, U10.46 (VREG_AVDD)
/VREG_LX: L5.2, U10.48 (VREG_LX)
BACKLIGHT_EN: J10.4, R53.1, U1.105 (GPIO1_IO10)
BACKLIGHT_PWM: J10.5, R55.1, U1.164 (SPDIF_RX/PWM2)
BAT1_ALERT: D5.1 (K), J11.3, U10.9 (GPIO6)
BAT1_V+: C117.1, C118.1, D7.1 (K), D13.2 (A), J11.2, J11.6, J12.2, J12.6, R89.1, U15.22 (BAT), U15.23 (BAT)
BAT2_ALERT: D8.1 (K), J12.3, U10.10 (GPIO7)
CHRG_ALERT: R90.1, U10.36 (GPIO24)
DAC_BCLK: J17.3, U1.170 (SAI2_TXC)
DAC_DIN: J17.6, U1.166 (SAI2_RXD)
DAC_DOUT: J17.7, U1.178 (SAI2_TXD)
DAC_MCLK: J17.2, U1.176 (SAI2_MCLK)
DAC_SCL: J17.8, R1.1, U1.101 (I2C3_SCL), U6.6 (SCL)
DAC_SDA: J17.9, R2.1, U1.103 (I2C3_SDA), U6.5 (SDA)
DAC_TXFS: J17.5, U1.172 (SAI2_TXFS)
ETH0_A+: J9.11, U1.29 (TRX0_P)
ETH0_A-: J9.10, U1.27 (TRX0_N)
ETH0_B+: J9.8, U1.23 (TRX1_P)
ETH0_B-: J9.7, U1.21 (TRX1_N)
ETH0_C+: J9.5, U1.17 (TRX2_P)
ETH0_C-: J9.4, U1.15 (TRX2_N)
ETH0_D+: J9.2, U1.11 (TRX3_P)
ETH0_D-: J9.1, U1.9 (TRX3_N)
ETH0_LED_LINK1: J9.14, U1.83 (JTAG_TDO)
ETH0_LED_RX: J9.13, U1.79 (JTAG_MOD)
GND: C1.2, C2.2, C3.2, C5.2, C6.2, C7.2, C8.2, C9.2, C11.2, C12.2, C13.2, C14.2, C15.2, C16.2, C17.2, C18.2, C19.2, C20.2, C21.2, C22.2, C23.2, C24.2, C25.2, C26.2, C27.2, C28.2, C29.2, C30.2, C31.2, C32.2, C33.2, C34.2, C35.2, C36.2, C37.2, C38.2, C39.2, C40.2, C41.2, C42.2, C43.2, C44.2, C45.2, C46.2, C47.2, C54.2, C55.2, C56.1, C57.2, C58.2, C59.2, C60.1, C61.2, C63.2, C64.2, C65.2, C67.2, C68.2, C69.2, C70.2, C71.2, C72.2, C73.2, C74.2, C75.2, C76.2, C77.2, C78.2, C79.1, C80.2, C81.2, C82.2, C83.2, C84.2, C85.2, C86.2, C87.2, C97.2, C98.2, C99.2, C102.2, C103.1, C104.1, C105.2, C107.2, C108.2, C109.1, C110.2, C111.2, C112.2, C113.2, C114.2, C115.2, C116.2, C117.2, C118.2, C119.1, C120.1, C142.2, D5.2 (A), D7.2 (A), D8.2 (A), H1.1, H2.1, H3.1, H4.1, H5.1, H8.1, J1.1, J2.3, J2.6, J2.9, J2.12, J4.1, J4.3, J4.9, J4.15, J4.21, J4.27, J4.33, J4.39, J4.45, J4.51, J4.57, J4.71, J4.73, J4.75, J4.S1 (SHIELD), J4.S2 (SHIELD), J5.4, J6.4, J7.8, J7.9, J8.3, J8.6, J8.9, J8.12, J9.3, J9.6, J9.9, J9.12, J10.3, J10.6, J11.1, J11.7, J12.1, J12.7, J14.4, J15.2, J15.MP (MountPin), J16.1, J16.7, J17.1, J17.4, J18.3, J18.6, J18.9, J18.12, J18.13, J19.6, J20.3, J20.6, J20.9, J20.12, J20.13, J21.1, J21.3, J21.9, J21.15, J21.21, J21.27, J21.33, J21.39, J21.45, J21.51, J21.57, J21.71, J21.73, J21.75, J21.S1 (SHIELD), J21.S2 (SHIELD), R4.1, R5.1, R15.1, R17.2, R22.1, R24.2, R25.2, R30.2, R35.1, R43.1, R44.1, R58.2, R59.2, R62.1, R63.1, R66.1, R67.2, R72.1, R73.1, R77.1, R78.1, R80.2, R83.1, R84.2, R88.2, R94.2, R96.2, R99.2, R101.1, R103.1, R104.1, SW1.4, SW2.2 (B), U1.7 (GND), U1.13 (GND), U1.19 (GND), U1.25 (GND), U1.31 (GND), U1.41 (GND), U1.44 (GND), U1.47 (GND), U1.50 (GND), U1.53 (GND), U1.56 (GND), U1.59 (GND), U1.62 (GND), U1.65 (GND), U1.68 (GND), U1.71 (GND), U1.74 (GND), U1.80 (GND), U1.86 (QSPIA_DATA2), U1.94 (GND), U1.95 (GND), U1.98 (GND), U1.99 (GND), U1.104 (GND), U1.110 (GND), U1.111 (GND), U1.116 (GND), U1.117 (GND), U1.123 (GND), U1.129 (GND), U1.161 (GND), U1.167 (GND), U1.173 (GND), U1.179 (GND), U1.185 (GND), U1.191 (GND), U2.1 (GND), U2.2 (GND), U2.3 (GND), U2.7 (GND), U4.4 (VSS), U5.1 (PGND2), U5.8 (AGND), U5.12 (SYNC/MODE), U5.15 (PGND1), U6.4 (VSS), U7.37 (VSS), U8.5 (GND), U9.4 (GND), U10.47 (VREG_PGND), U10.61 (GND), U11.1 (PGND2), U11.8 (AGND), U11.12 (SYNC/MODE), U11.15 (PGND1), U12.5 (GND), U13.5 (GND), U14.5 (GND), U15.6 (D+), U15.7 (D-), U15.27 (GND), U16.3 (GND), U17.5 (GND), U18.8 (GND), U19.5 (GND), U20.2 (GND), Y1.2, Y1.4, Y2.2, Y2.4, Y3.2, Y3.4
HDMI_AUXN: U1.189 (HDMI_AUX_N), U12.7 (D2-)
HDMI_AUXP: U1.187 (HDMI_AUX_P), U12.3 (D2+)
HDMI_CEC: J18.14, U1.197 (HDMI_CEC)
HDMI_CLKN: J18.11, U1.163 (HDMI_CLK_N)
HDMI_CLKP: J18.10, U1.165 (HDMI_CLK_P)
HDMI_DDC_AUXN: J18.15, U12.6 (D-)
HDMI_DDC_AUXP: J18.16, U12.4 (D+)
HDMI_DP_SWITCH: R80.1, U12.1 (S), U18.6 (P2)
HDMI_HPD: J18.17, U1.199 (HDMI_HPD)
HDMI_SCL: U1.195 (HDMI_DDC_SCL), U12.8 (D1-)
HDMI_SDA: U1.193 (HDMI_DDC_SDA), U12.2 (D1+)
HDMI_TX0N: J18.8, U1.169 (HDMI_TX0_N)
HDMI_TX0P: J18.7, U1.171 (HDMI_TX0_P)
HDMI_TX1N: J18.5, U1.175 (HDMI_TX1_N)
HDMI_TX1P: J18.4, U1.177 (HDMI_TX1_P)
HDMI_TX2N: J18.2, U1.181 (HDMI_TX2_N)
HDMI_TX2P: J18.1, U1.183 (HDMI_TX2_P)
IMX_RESETn: R3.2, TP3.1, U1.87 (EXT_RESET_N)
IMX_WAKE: U1.145 (GPIO1_IO3), U10.41 (GPIO27_ADC1)
LPC_MISO: U1.93 (ECSPI2_MISO), U10.15 (GPIO11)
LPC_MOSI: U1.91 (ECSPI2_MOSI), U10.12 (GPIO8)
LPC_SCK: U1.97 (ECSPI2_SCLK), U10.14 (GPIO10)
LPC_SS0: U1.89 (ECSPI2_SS0), U10.13 (GPIO9)
unnamed: C4.2, R18.2
unnamed: C19.1, R27.1, Y1.3
unnamed: C66.2, R31.2
unnamed: C98.1, R85.2
unnamed: D4.1 (K), R41.2
unnamed: D6.2 (A), R51.2
unnamed: D6.1 (K), J21.10
unnamed: D10.2 (A), R65.2
unnamed: D10.1 (K), J4.10
unnamed: C2.1, D12.1 (K), D13.1 (K), R14.1, U20.5 (VIN)
unnamed: D14.1 (K), R87.2
unnamed: D5.4 (K), J11.4, R47.1
unnamed: D5.3 (K), J11.5, R48.1
unnamed: D8.3 (K), J12.4, R45.1
unnamed: D8.4 (K), J12.5, R46.1
unnamed: J18.18, J18.19, J18.20, R21.1
unnamed: J20.15, R60.1
unnamed: J20.16, R61.1
unnamed: J20.17, R38.1
unnamed: J20.18, J20.19, J20.20, R54.1
unnamed: R6.2, U1.118 (USB1_VBUS)
unnamed: C74.1, U4.3 (XIN), Y3.1
unnamed: C76.1, U4.2 (XOUT), Y3.3
unnamed: C62.1, U5.3 (RBOOT), U5.4 (CBOOT)
unnamed: C66.1, R26.2, R30.1, U5.7 (FB)
unnamed: R75.1, U5.10 (RESET)
unnamed: C60.2, U5.6 (VCC), U5.9 (RT), U5.11 (SPSP)
unnamed: C62.2, L3.1, U5.16 (SW)
unnamed: U6.1 (OSCI), Y4.1
unnamed: U6.2 (OSCO), Y4.2
unnamed: C79.2, R64.2, U6.8 (VDD)
unnamed: C9.1, U7.14 (CRFILT)
unnamed: R35.2, U7.25 (HS_IND/CFG_SEL1)
unnamed: C17.1, U7.34 (PLLFILT)
unnamed: R22.2, U7.35 (RBIAS)
unnamed: C75.1, R68.2, R69.1, U7.26 (RESET_N)
unnamed: R15.2, U7.24 (SCL/SMBCLK/CFG_SEL0)
unnamed: R4.2, U7.22 (SDA/SMBDATA/NON_REM1)
unnamed: R5.2, U7.28 (SUSP_IND/LOCAL_PWR/NON_REM0)
unnamed: R42.2, U7.27 (VBUS_DET)
unnamed: C8.1, R34.2, U7.33 (XTALIN/CLKIN), Y2.3
unnamed: C7.1, R34.1, U7.32 (XTALOUT), Y2.1
unnamed: R83.2, U8.10 (~OE)
unnamed: R41.1, U10.32 (GPIO20)
unnamed: R53.2, U10.37 (GPIO25)
unnamed: R55.2, U10.40 (GPIO26_ADC0)
unnamed: C18.1, U10.21 (XIN), Y1.1
unnamed: R27.2, U10.22 (XOUT)
unnamed: C10.1, U11.3 (RBOOT), U11.4 (CBOOT)
unnamed: C4.1, R23.2, R24.1, U11.7 (FB)
unnamed: R76.1, U11.10 (RESET)
unnamed: C56.2, U11.6 (VCC), U11.9 (RT), U11.11 (SPSP)
unnamed: C10.2, L2.1, U11.16 (SW)
unnamed: R67.1, U12.9 (~OE)
unnamed: R78.2, U13.10 (~OE)
unnamed: R72.2, U14.10 (~OE)
unnamed: C100.2, U15.4 (BTST1)
unnamed: C101.2, U15.19 (BTST2)
unnamed: R93.2, R94.1, U15.17 (ILIM_HIZ)
unnamed: C108.1, C110.1, C112.1, C119.2, U15.29 (PMID)
unnamed: R88.1, U15.20 (PROG)
unnamed: R91.2, U15.14 (SCL)
unnamed: R92.2, U15.15 (SDA)
unnamed: C104.2, U15.24 (SDRV)
unnamed: R87.1, U15.1 (STAT)
unnamed: C100.1, L4.2, U15.28 (SW1)
unnamed: C101.1, L4.1, U15.26 (SW2)
unnamed: R86.2, R96.1, U15.16 (TS)
unnamed: R90.2, U15.21 (~INT)
unnamed: R52.2, U15.12 (~QON)
unnamed: R97.1, U16.7 (RXD)
unnamed: R98.1, U16.6 (TXD)
unnamed: R99.1, U16.4 (~RTS)
unnamed: R104.2, U17.10 (~OE)
unnamed: R84.1, U18.2 (ADDR)
unnamed: R95.2, U18.14 (SCL)
unnamed: R81.2, U18.15 (SDA)
unnamed: R100.1, U18.3 (~RESET)
unnamed: R73.2, U19.10 (~OE)
unnamed: C48.1, U20.1 (CB)
unnamed: C48.2, L1.1, U20.6 (SW)
PCIE1_CLK_N: J21.53, R63.2, U1.60 (PCIE1_REFCLK_N)
PCIE1_CLK_P: J21.55, R62.2, U1.58 (PCIE1_REFCLK_P)
PCIE1_RESETn: J21.50, U1.37 (PCIE_RST_B)
PCIE1_RX_N: J21.41, U1.54 (PCIE1_RX_N)
PCIE1_RX_P: J21.43, U1.52 (PCIE1_RX_P)
PCIE1_TX_N: J21.47, U1.48 (PCIE1_TX_N)
PCIE1_TX_P: J21.49, U1.46 (PCIE1_TX_P)
PCIE2_CLK2_N: J4.53, R44.2, U4.8 (DIFF2_N)
PCIE2_CLK2_P: J4.55, R43.2, U4.7 (DIFF2_P)
PCIE2_CLK_N: U1.66 (PCIE2_REFCLK_N), U4.6 (DIFF1_N)
PCIE2_CLK_P: U1.64 (PCIE2_REFCLK_P), U4.5 (DIFF1_P)
PCIE2_RESETn: J4.50, U1.24 (WIFI_RESET)
PCIE2_RX2_N: J4.29, U1.84 (QSPIA_DATA3)
PCIE2_RX2_P: J4.31, U1.82 (QSPIA_DATA4)
PCIE2_RX3_N: J4.17, U1.45 (CSI_P2_D0_P)
PCIE2_RX3_P: J4.19, U1.43 (CSI_P2_D0_N)
PCIE2_RX4_N: J4.5, U1.57 (CSI_P2_D2_P)
PCIE2_RX4_P: J4.7, U1.55 (CSI_P2_D2_N)
PCIE2_RX_N: J4.41, U1.78 (PCIE2_RX_N)
PCIE2_RX_P: J4.43, U1.76 (PCIE2_RX_P)
PCIE2_TX2_N: J4.35, U1.90 (QSPIA_DATA0)
PCIE2_TX2_P: J4.37, U1.88 (QSPIA_DATA1)
PCIE2_TX3_N: J4.23, U1.51 (CSI_P2_D1_P)
PCIE2_TX3_P: J4.25, U1.49 (CSI_P2_D1_N)
PCIE2_TX4_N: J4.11, U1.63 (CSI_P2_D3_P)
PCIE2_TX4_P: J4.13, U1.61 (CSI_P2_D3_N)
PCIE2_TX_N: J4.47, U1.72 (PCIE2_TX_N)
PCIE2_TX_P: J4.49, U1.70 (PCIE2_TX_P)
PROG: R28.1, SW1.1
PWR_OVERRIDE: D2.2 (A), D3.2 (A), SW1.3
QSPI_CS: R28.2, R29.2, U9.1 (~CS), U10.60 (QSPI_SS)
QSPI_SCK: U9.6 (CLK), U10.56 (QSPI_SCLK)
QSPI_SD0: U9.5 (DI(IO0)), U10.57 (QSPI_SD0)
QSPI_SD1: U9.2 (DO(IO1)), U10.59 (QSPI_SD1)
QSPI_SD2: U9.3 (IO2), U10.58 (QSPI_SD2)
QSPI_SD3: U9.7 (IO3), U10.55 (QSPI_SD3)
RESET: R36.2, SW2.1 (A), U10.26 (RUN)
RP_HSTX_CK+: R9.2, U10.18 (GPIO14)
RP_HSTX_CK-: R8.2, U10.19 (GPIO15)
RP_HSTX_D0+: R10.2, U10.16 (GPIO12)
RP_HSTX_D0-: R11.2, U10.17 (GPIO13)
RP_HSTX_D1+: R12.2, U10.29 (GPIO18)
RP_HSTX_D1-: R13.2, U10.31 (GPIO19)
RP_HSTX_D2+: R56.2, U10.27 (GPIO16)
RP_HSTX_D2-: R57.2, U10.28 (GPIO17)
RP_HSTX_HPD: R38.2, U10.34 (GPIO22)
RP_SCL0: J7.7, R37.1, R48.2, R60.2, R91.1, U10.3 (GPIO1)
RP_SCL1: R46.2, R49.1, R95.1, U10.5 (GPIO3)
RP_SDA0: J7.6, R39.1, R47.2, R61.2, R92.1, U10.2 (GPIO0)
RP_SDA1: R45.2, R50.1, R81.1, U10.4 (GPIO2)
RP_UART0_RX: R71.2, U10.43 (GPIO29_ADC3)
RP_UART0_TX: R70.2, U10.42 (GPIO28_ADC2)
RP_UART1_RX: J5.3, U10.8 (GPIO5)
RP_UART1_TX: J5.2, U10.7 (GPIO4)
SD_CLK: J16.8, U1.22 (SD2_CLK)
SD_CMD: J16.6, U1.20 (SD2_CMD)
SD_D0: J16.2, U1.12 (SD2_DATA0)
SD_D1: J16.3, U1.14 (SD2_DATA1)
SD_D2: J16.4, U1.16 (SD2_DATA2)
SD_D3: J16.5, U1.18 (SD2_DATA3)
SD_DET: J16.9, U1.26 (SD2_CD)
STANDBY_3V3: C1.1, C12.1, C20.1, C22.1, C24.1, C26.1, C27.1, C28.1, C29.1, C30.1, C31.1, C40.1, D4.2 (A), J5.1, J7.5, L1.2, R7.1, R29.1, R36.1, R37.2, R39.2, R49.2, R50.2, R100.2, R102.1, SW1.2, U6.3 (VBAT), U9.8 (VCC), U10.1 (IOVDD), U10.11 (IOVDD), U10.20 (IOVDD), U10.30 (IOVDD), U10.38 (IOVDD), U10.44 (ADC_AVDD), U10.45 (IOVDD), U10.49 (VREG_VIN), U10.53 (USB_OTP_VDD), U10.54 (QSPI_IOVDD), U18.1 (V_{CCI}), U18.16 (V_{CCP}), U20.3 (FB)
SWC: J15.1, U10.24 (SWCLK)
SWD: J15.3, U10.25 (SWD)
UART1_RX: J19.3, R70.1, R98.2, U1.126 (UART1_RXD)
UART1_TX: J19.2, R71.1, R97.2, U1.128 (UART1_TXD)
UART2_RX: J19.5, U1.122 (UART2_RXD)
UART2_TX: J19.4, U1.124 (UART2_TXD)
USB1_DN: J8.1, U1.100 (USB1_D_N)
USB1_DP: J8.2, U1.102 (USB1_D_P)
USB1_RXN: J8.7, U1.112 (USB1_RX_N)
USB1_RXP: J8.8, U1.114 (USB1_RX_P)
USB1_TXN: J8.4, U1.106 (USB1_TX_N)
USB1_TXP: J8.5, U1.108 (USB1_TX_P)
USB2A_DN: U7.1 (USBDM_DN1/PRT_DIS_M1), U19.8 (HSD2-)
USB2A_DP: U7.2 (USBDP_DN1/PRT_DIS_P1), U19.9 (HSD2+)
USB2B_DN: J6.2, U7.3 (USBDM_DN2/PRT_DIS_M2)
USB2B_DP: J6.3, U7.4 (USBDP_DN2/PRT_DIS_P2)
USB2C_DN: U7.6 (USBDM_DN3/PRT_DIS_M3), U8.8 (HSD2-)
USB2C_DP: U7.7 (USBDP_DN3/PRT_DIS_P3), U8.9 (HSD2+)
USB2D_DN: J14.2, U7.8 (USBDM_DN4/PRT_DIS_M4)
USB2D_DP: J14.3, U7.9 (USBDP_DN4/PRT_DIS_P4)
USB2_DN: U1.125 (USB2_D_N), U14.4 (D-)
USB2_DP: U1.127 (USB2_D_P), U14.3 (D+)
USB2_HUB_IN_DN: U7.30 (USBDM_UP), U14.8 (HSD2-)
USB2_HUB_IN_DP: U7.31 (USBDP_UP), U14.9 (HSD2+)
USB2_RXN: J2.8, U1.121 (USB2_RX_N)
USB2_RXP: J2.7, U1.119 (USB2_RX_P)
USB2_TXN: J2.5, U1.115 (USB2_TX_N)
USB2_TXP: J2.4, U1.113 (USB2_TX_P)
USB_P2_DN: J2.1, U17.4 (D-)
USB_P2_DP: J2.2, U17.3 (D+)
USWITCH_1: R103.2, U8.2 (SEL), U17.2 (SEL), U18.9 (P4)
USWITCH_2: R77.2, U13.2 (SEL), U18.10 (P5)
USWITCH_3: R101.2, U14.2 (SEL), U18.11 (P6), U19.2 (SEL)
VCC: C3.1, C5.1, C54.1, C55.1, C58.1, C59.1, C61.1, C63.1, C109.2, C111.1, C113.1, C114.1, C115.1, C116.1, J7.1, J7.2, U5.2 (VIN2), U5.14 (VIN1), U11.2 (VIN2), U11.14 (VIN1), U15.25 (SYS)
VPD: C105.1, C107.1, C120.2, D12.2 (A), J7.3, J7.4, R85.1, U2.4 (IN), U2.5 (IN), U2.6 (IN), U15.2 (VBUSp), U15.3 (VBUSp), U15.8 (VAC2), U15.9 (VAC1)
~CHRG_CE: R66.2, U15.13 (~CE)
~QON: R52.1, U18.7 (P3)
~STANDBY_SHDN: J1.2, R14.2, U20.4 (~SHDN)
~USBH_RESET: R68.1, U1.131 (USB_HUB_RESET)

Notes on the sheet:
Power Rails
Sysctl (RP2350A) USB
PERn3
vid/pid: 0x0424/0x2514
PETn3
SoM UARTs
Rff
PETp3
clkreq
Enable Switches
USB Muxing Dungeon
USB UART
to clock buffer on SoM
close to RP2350A!
EDL capable SOM port
PERp2
recommended 6uF nominal capacitance at rated voltage
on SoC hub
0: D=D1 (HDMI DDC) 1: D=D2 (DP AUX)
Caps on SoM
Experimental backlight control via System Controller
phone SAI (Pocket Reform)
Display Power/Backlight
NOTE: QON is wired to System Controller's GPIO extender
Buck/Boost Charger/DCDC
Realtime Clock
I2C control bus
Rfbt
SCL
SD Card, to port board left cable: opposite sides
PROG set for 750 kHz 4S configuration can be overridden over I²C when needed
UART to KBD
SDA
Cff
S=0: D=D1 S=1: D=D2
new in D-2: HDMI DDC vs DP AUX mux
I2S Audio to port board left cable: opposite sides
addr: 0x20
PD snubber
Hard Powerdown/Reset
Enjoy: extra internal USB
TX caps are on the SoM
MAX 36V
Note: 1473149-4 is incompatible! the correct one is 1473149-1! (or 1717254-1)
Caps on port board
Power Interface
PERp3
USB3 B, to port board left cable: opposite sides
Experimental HDMI/HSTX port for RP2350
USB3 A, to port board right cable: opposite sides
1V1
PERn1
NOTE: before D-4, sda/scl was flipped vs rcore+hdmiedp!
wake from ship mode
Left port board USB-C
M.2 Card Slots
Internal Data Interfaces
Rfbb
First stage needs to work in standby
Firmware Flash Memory
PERn2
Experimental UART fowarding
Note: 10A with LM61495-Q1
PETp1
HDMI/DP to port board right cable: same sides!
I2C lines pulled up by SYS 3v3 power
max in: 24V, abs max in: 30V. clamped at J7
BAT snubber
M Key M.2, 2280
Force Power (for Sysctl Bringup)
Status LED
PETn2
do not leave floating
Future: exchange to QFN version
System power (from motherboard)
SPI connection to CPU (for reform2-lpc driver)
4V-36V
Future: wire up XSWITCH/FAST_BOOT for USB loaders
Processor Module Slot
USB2514B-AEZC-TR
connected to LPC on older Reforms
Default
Control DIP Switches
M Key M.2, 2242
Power from USB-C PD (left port board)
Use 50V rated caps
Powered by main batteries in standby
Set to fixed 25°C
JST Debug Connector (SWD)
Polarity flipped
USB2.0 hub for Keyboard and System Controller
System Controller
Internal USB/UART (Keyboard/Trackpad Interface)
recommended 2uF effective
PERp1
Battery Pack Interfaces
PCIe Clock Generator
1GBe to port board left cable: opposite sides
USB UART for console
UART to CPU
PETp2
Change in R-1: Directly powered by batteries OR power supply (PD), so we can turn off MP2650
PETn1
D-2: exchanged to 2x clock gen

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
