cetola/reform-next-mirror/nref-motherboard/nref-motherboard.kicad_pcb

## KiCad design nref-motherboard/nref-motherboard.kicad_pcb (continued)

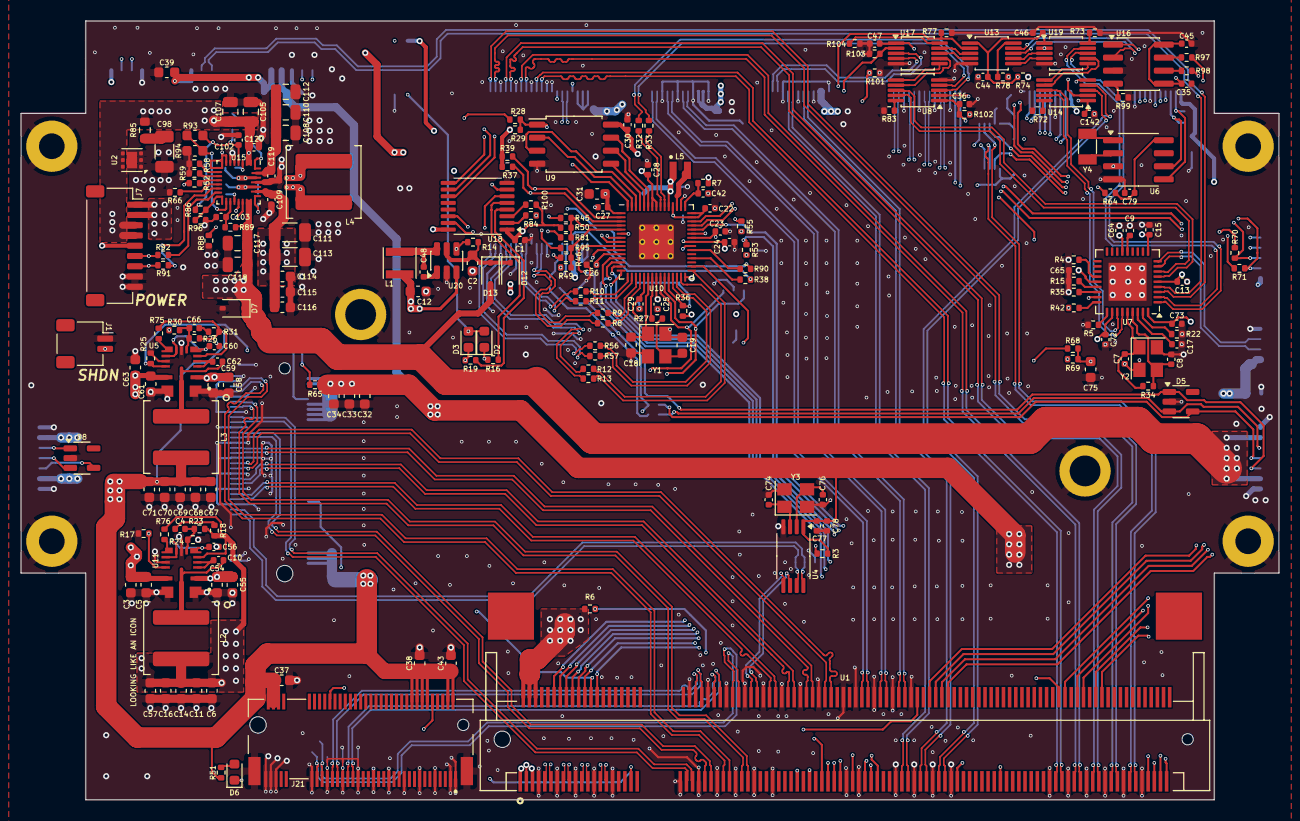
[picture p161: board nref-motherboard.kicad_pcb from above]

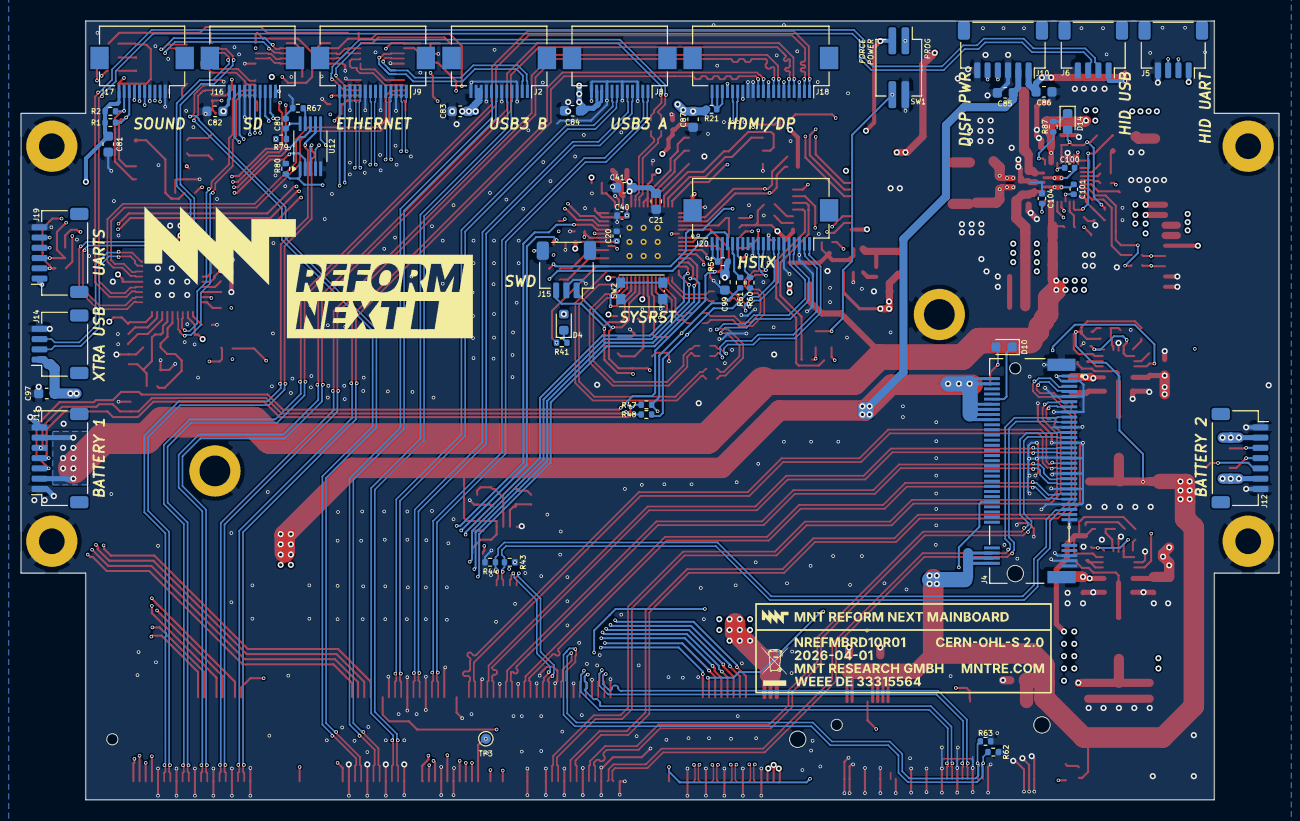
[picture p162: board nref-motherboard.kicad_pcb from below]

Board: 6 copper layers, 122.6 x 75.9 mm, 276 parts (60 on the bottom side), 267 nets.
