cetola/reform-next-mirror/nref-batterypack-v3/nref-batterypack-backside.kicad_pcb

## KiCad design nref-batterypack-v3/nref-batterypack-backside.kicad_pcb (2026-09-02)

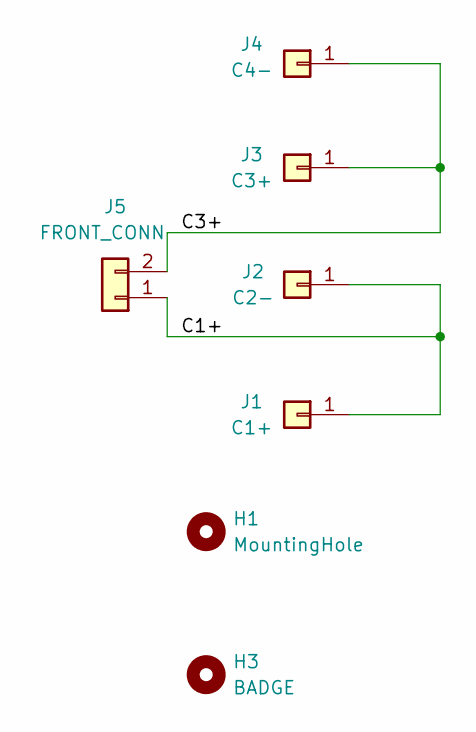
[picture p163: schematic nref-batterypack-backside.kicad_sch]

Parts:
H1: MountingHole; MountingHole_2.2mm_M2
H3: BADGE; nref-battback-badge
J1: C1+; Mill-Max_2036-X-57; MPN 2036-3-57-15-00-00-03-0; LCSC C20777560
J2: C2-; MYOUNG_MY-FJ-115; MPN MY-FJ-115II-R; LCSC C5457098
J3: C3+; Mill-Max_2036-X-57; MPN 2036-3-57-15-00-00-03-0; LCSC C20777560
J4: C4-; MYOUNG_MY-FJ-115; MPN MY-FJ-115II-R; LCSC C5457098
J5: FRONT_CONN; JST_SH_SM02B-SRSS-TB_1x02-1MP_P1.00mm_Horizontal; MPN SM02B-SRSS-TB; LCSC C160402

Connections:
/C1+: J1.1 (Pin_1_1), J2.1 (Pin_1_1), J5.1
/C3+: J3.1 (Pin_1_1), J4.1 (Pin_1_1), J5.2

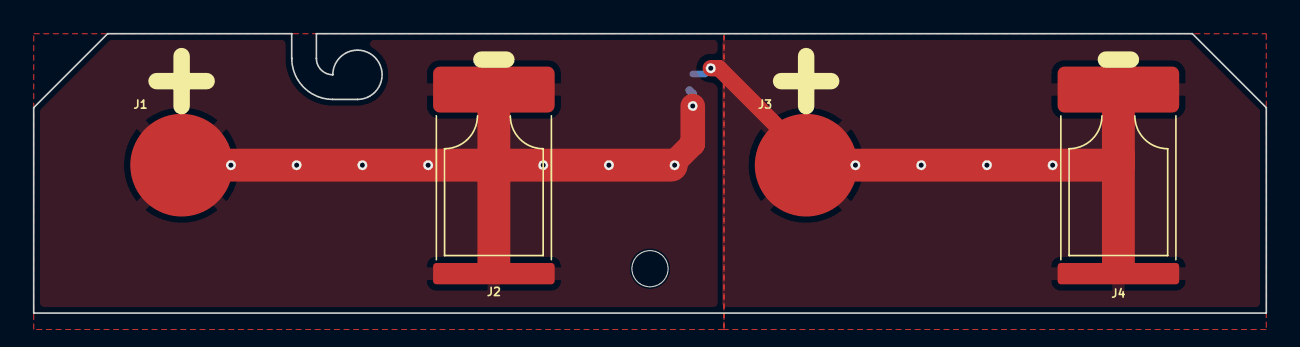
[picture p164: board nref-batterypack-backside.kicad_pcb from above]

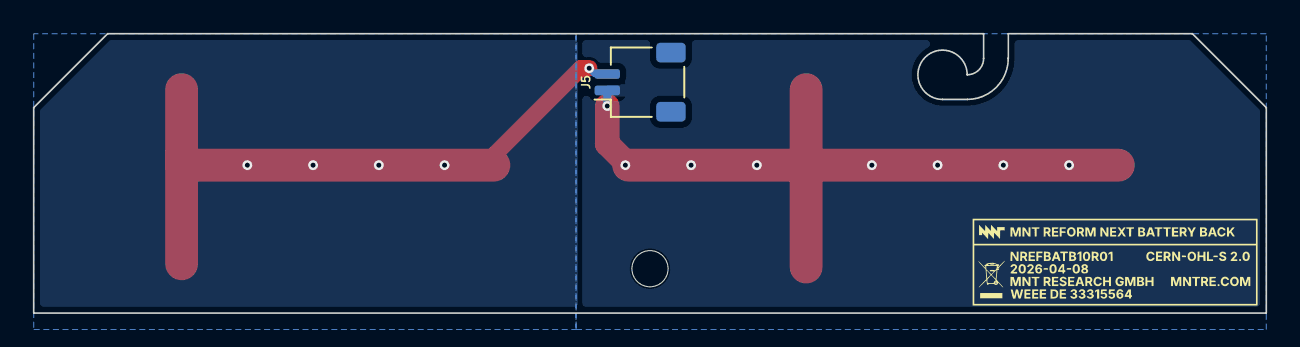
[picture p165: board nref-batterypack-backside.kicad_pcb from below]

Board: 4 copper layers, 75.0 x 17.0 mm, 7 parts (2 on the bottom side), 2 nets.
