cetola/reform-next-mirror/nref-wifi-m2/nref-wifi-m2.kicad_pcb

## KiCad design nref-wifi-m2/nref-wifi-m2.kicad_pcb (2026-09-02)

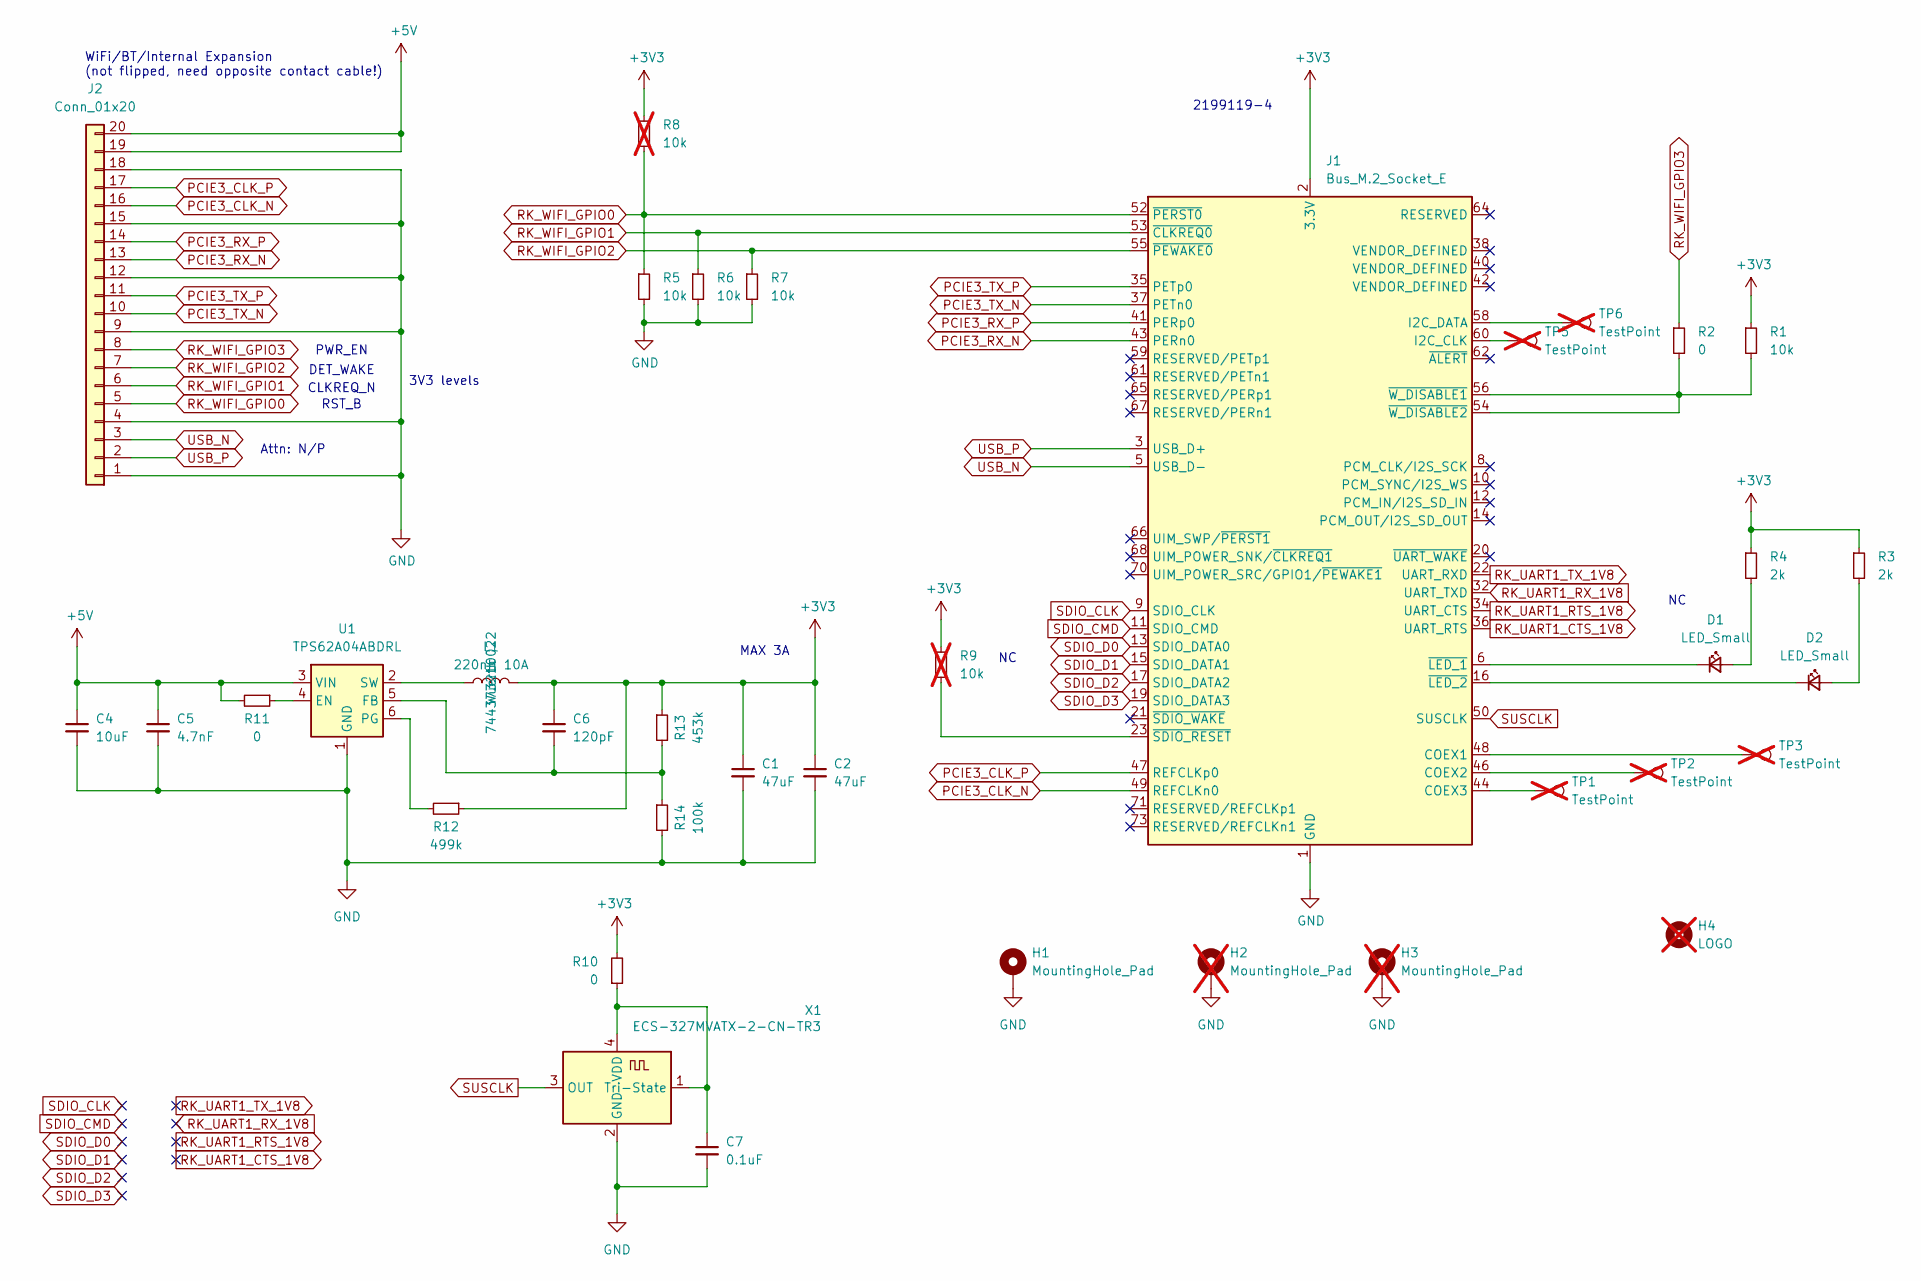
[picture p166: schematic nref-wifi-m2.kicad_sch]

Parts:
C1, C2: 47uF; C_1210_3225Metric; LCSC C84494
C4: 10uF; C_1210_3225Metric; LCSC C39232
C5: 4.7nF; C_0603_1608Metric; LCSC C85980
C6: 120pF; C_0603_1608Metric; LCSC C18438
C7: 0.1uF; C_0603_1608Metric; LCSC C77058
D1, D2: LED_Small; LED_0603_1608Metric; LCSC C5875723
H1: MountingHole_Pad; Mounting_Wuerth_WA-SMSI-M2_H1.5mm_9774015243; LCSC C22431324
H2, H3: MountingHole_Pad; MountingHole_2.2mm_M2_DIN965_Pad; not fitted
H4: LOGO; nref-wifi-m2-badge; not fitted
J1: Bus_M.2_Socket_E; TE_2199119-4; LCSC C5163551
J2: Conn_01x20; Hirose_FH12-20S-0.5SH_1x20-1MP_P0.50mm_Horizontal; LCSC C596730
L1: 220nH 10A; IND-SMD_L3.0-W3.0_FTC303020D; LCSC C5832405
R1, R5, R6, R7: 10k; R_0603_1608Metric; LCSC C25804
R2, R10, R11: 0; R_0603_1608Metric; LCSC C21189
R3, R4: 2k; R_0603_1608Metric; LCSC C22975
R8, R9: 10k; R_0603_1608Metric; LCSC C25804; not fitted
R12: 499k; R_0603_1608Metric; LCSC C26751
R13: 453k; R_0603_1608Metric; LCSC C25818
R14: 100k; R_0603_1608Metric; LCSC C25803
TP1, TP2, TP3, TP5, TP6: TestPoint; TestPoint_Pad_D1.0mm; not fitted
U1: TPS62A04ABDRL; SOT-563; LCSC C41447443
X1: ECS-327MVATX-2-CN-TR3; Oscillator_SMD_ECS_2520MV-xxx-xx-4Pin_2.5x2.0mm; LCSC C2901603

Connections:
+3V3: C1.1, C2.1, C6.1, J1.2 (3.3V), J1.4 (3.3V), J1.72 (3.3V), J1.74 (3.3V), L1.2, R1.1, R3.1, R4.1, R8.1, R9.1, R10.2, R12.1, R13.1
+5V: C4.1, C5.1, J2.19, J2.20, R11.2, U1.3 (VIN)
GND: C1.2, C2.2, C4.2, C5.2, C7.2, H1.1, H2.1, H3.1, J1.1 (GND), J1.7 (GND), J1.18 (GND), J1.33 (GND), J1.39 (GND), J1.45 (GND), J1.51 (GND), J1.57 (GND), J1.63 (GND), J1.69 (GND), J1.75 (GND), J2.1, J2.4, J2.9, J2.12, J2.15, J2.18, R5.2, R6.2, R7.2, R14.2, U1.1 (GND), X1.2 (GND)
unnamed: D1.2 (A), R4.2
unnamed: D1.1 (K), J1.6 (~LED_1)
unnamed: D2.2 (A), R3.2
unnamed: D2.1 (K), J1.16 (~LED_2)
unnamed: J1.48 (COEX1), TP3.1
unnamed: J1.46 (COEX2), TP2.1
unnamed: J1.44 (COEX3), TP1.1
unnamed: J1.60 (I2C_CLK), TP5.1
unnamed: J1.58 (I2C_DATA), TP6.1
unnamed: J1.23 (~SDIO_RESET), R9.2
unnamed: J1.54 (~W_DISABLE2), J1.56 (~W_DISABLE1), R1.2, R2.2
unnamed: R11.1, U1.4 (EN)
unnamed: C6.2, R13.2, R14.1, U1.5 (FB)
unnamed: R12.2, U1.6 (PG)
unnamed: L1.1, U1.2 (SW)
unnamed: C7.1, R10.1, X1.1 (Tri-State), X1.4 (VDD)
PCIE3_CLK_N: J1.49 (REFCLKn0), J2.16
PCIE3_CLK_P: J1.47 (REFCLKp0), J2.17
PCIE3_RX_N: J1.43 (PERn0), J2.13
PCIE3_RX_P: J1.41 (PERp0), J2.14
PCIE3_TX_N: J1.37 (PETn0), J2.10
PCIE3_TX_P: J1.35 (PETp0), J2.11
RK_UART1_CTS_1V8: J1.36 (UART_RTS)
RK_UART1_RTS_1V8: J1.34 (UART_CTS)
RK_UART1_RX_1V8: J1.32 (UART_TXD)
RK_UART1_TX_1V8: J1.22 (UART_RXD)
RK_WIFI_GPIO0: J1.52 (~PERST0), J2.5, R5.1, R8.2
RK_WIFI_GPIO1: J1.53 (~CLKREQ0), J2.6, R6.1
RK_WIFI_GPIO2: J1.55 (~PEWAKE0), J2.7, R7.1
RK_WIFI_GPIO3: J2.8, R2.1
SDIO_CLK: J1.9 (SDIO_CLK)
SDIO_CMD: J1.11 (SDIO_CMD)
SDIO_D0: J1.13 (SDIO_DATA0)
SDIO_D1: J1.15 (SDIO_DATA1)
SDIO_D2: J1.17 (SDIO_DATA2)
SDIO_D3: J1.19 (SDIO_DATA3)
SUSCLK: J1.50 (SUSCLK), X1.3 (OUT)
USB_N: J1.5 (USB_D-), J2.3
USB_P: J1.3 (USB_D+), J2.2

Notes on the sheet:
3V3 levels
RST_B
PWR_EN
2199119-4
WiFi/BT/Internal Expansion (not flipped, need opposite contact cable!)
MAX 3A
DET_WAKE
CLKREQ_N
Attn: N/P

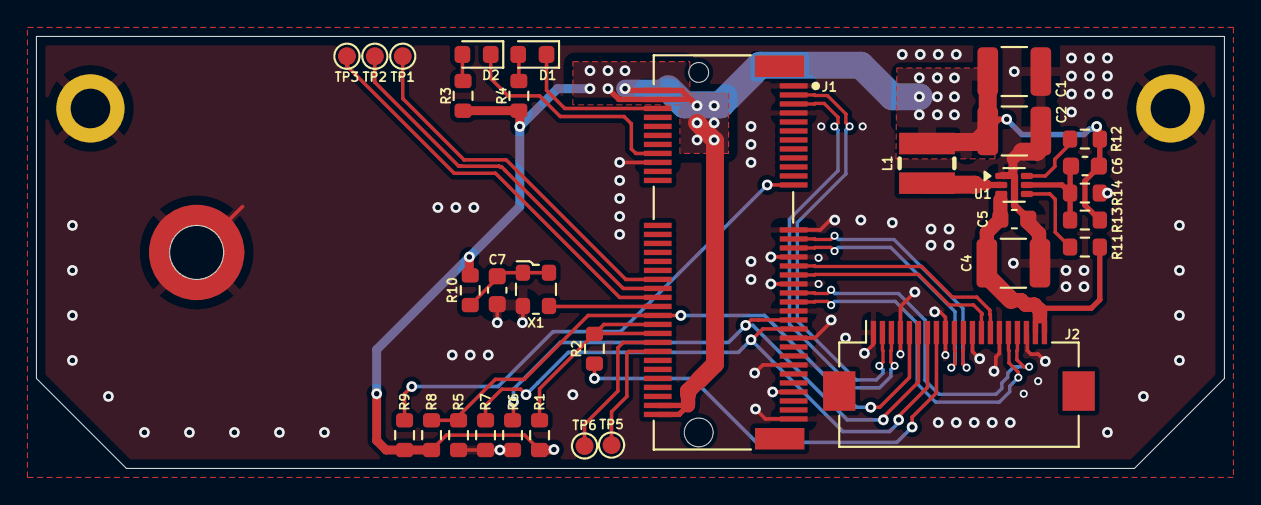
[picture p167: board nref-wifi-m2.kicad_pcb from above]

Board: 4 copper layers, 66.0 x 24.0 mm, 36 parts (1 on the bottom side), 32 nets.
