cetola/reform-next-mirror/nref-batterypack-v3/nref-batterypack.kicad_pcb

## KiCad design nref-batterypack-v3/nref-batterypack.kicad_pcb (2026-09-02)

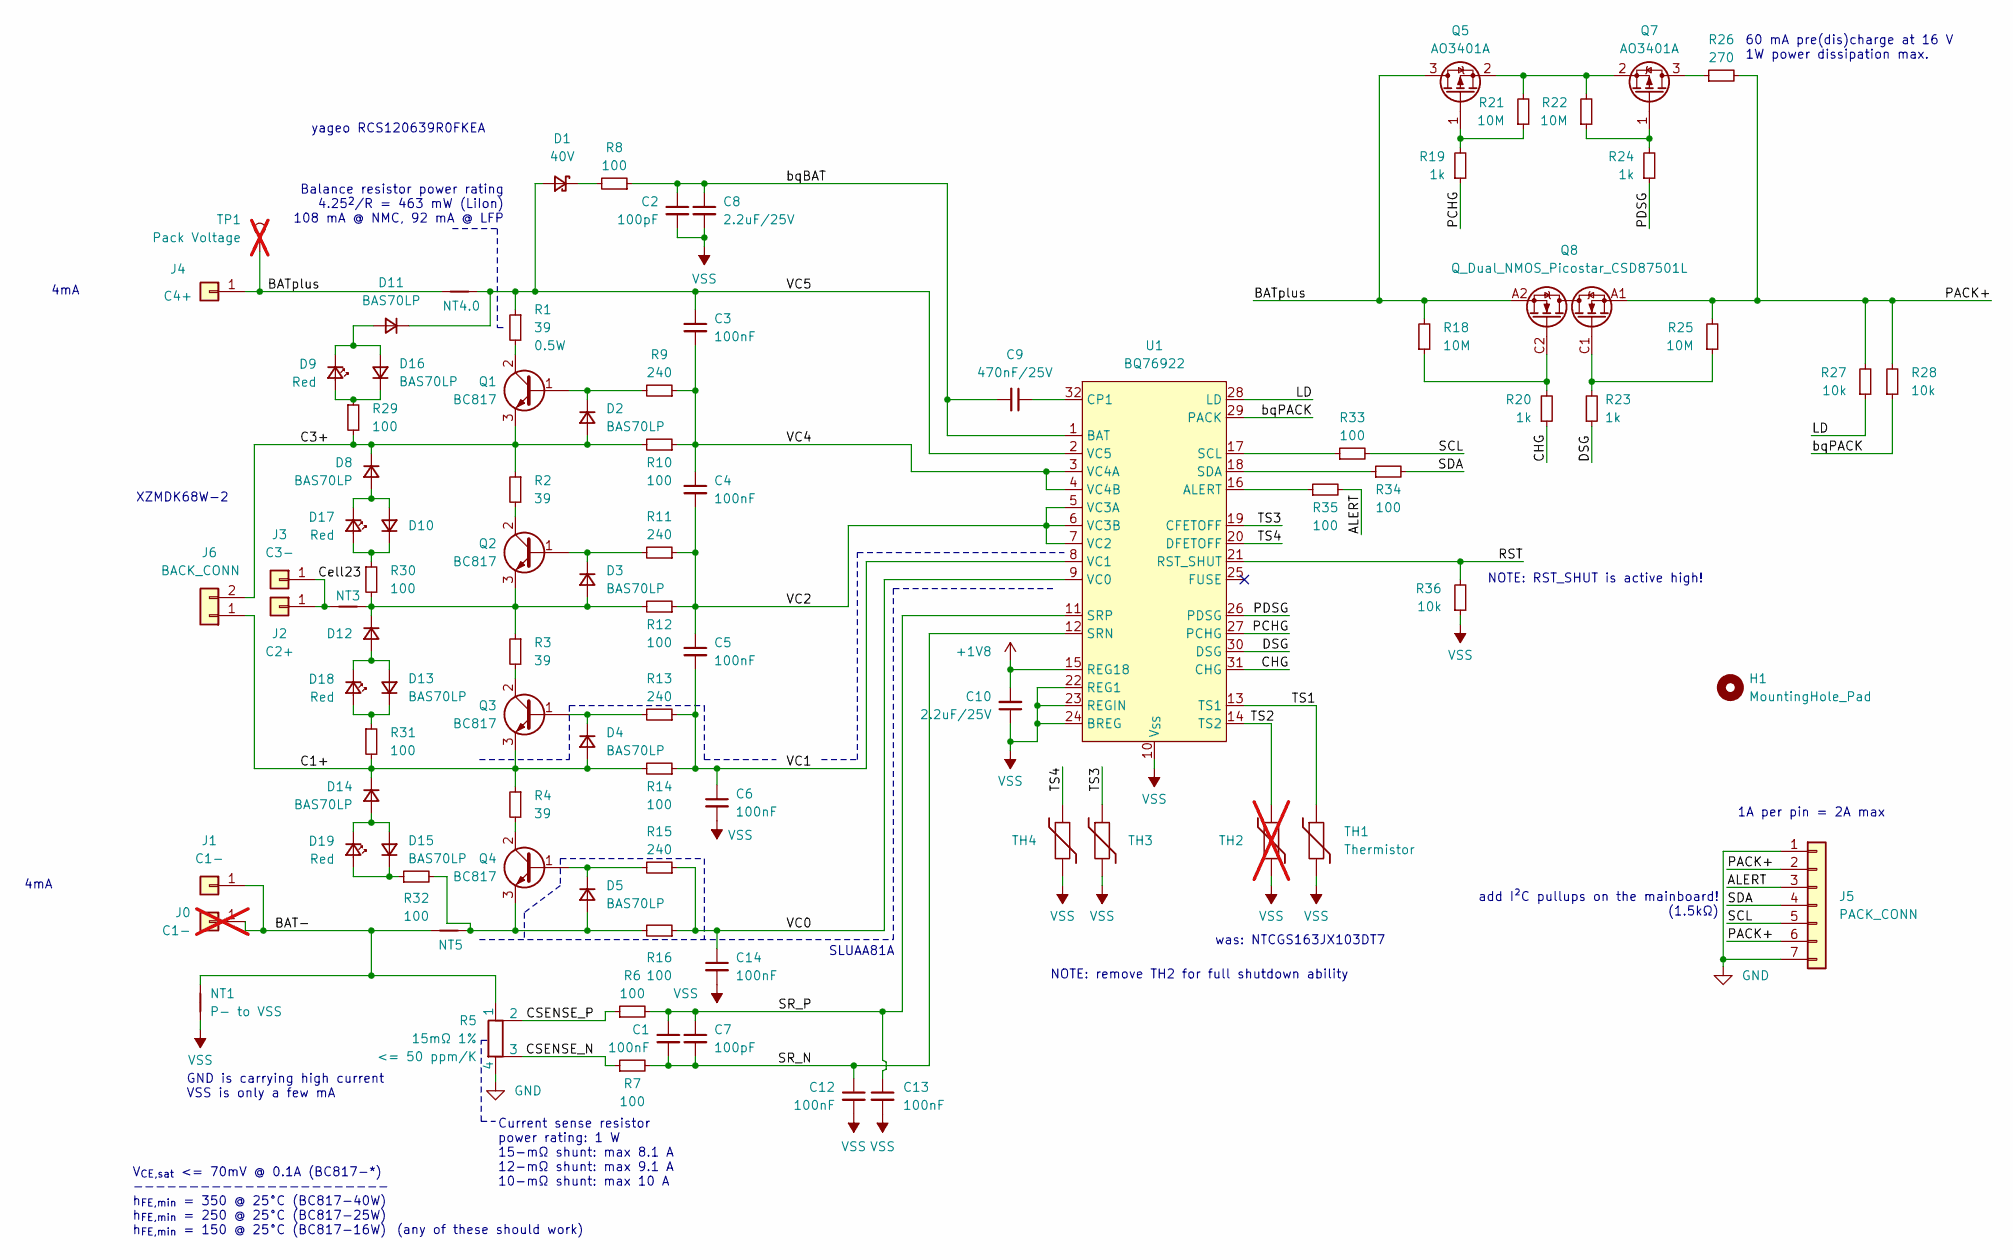
[picture p168: schematic nref-batterypack.kicad_sch]

Parts:
C1, C3, C4, C5, C6, C12, C13, C14: 100nF; C_0402_1005Metric; MPN CL05B104KO5NNNC; LCSC C1525
C2, C7: 100pF; C_0402_1005Metric; MPN 0402CG101J500NT; LCSC C1546
C8, C10: 2.2uF/25V; C_0402_1005Metric; MPN GRM155R61E225ME15D; LCSC C72203
C9: 470nF/25V; C_0402_1005Metric; MPN CL05A474KA5NNNC; LCSC C92361
D1: 40V; D_SOD-323; MPN B1040WS; LCSC C22466375
D2, D3, D4, D5, D8, D10, D11, D12, D13, D14, D15, D16: BAS70LP; D_SOD-882; MPN BAS70LP-7B; LCSC C134385
D9, D17, D18, D19: Red; LED_0402_1005Metric; MPN NCD0402R1; LCSC C130719
H1: MountingHole_Pad; MountingHole_2.2mm_M2
J0: C1-; TestPoint_Pad_D1.0mm; MPN DNP; not fitted
J1: C1-; MYOUNG_MY-FJ-115; MPN MY-FJ-115; LCSC C5457098
J2: C2+; Mill-Max_2036-X-57; MPN 2036-3-57-15-00-00-03-0; LCSC C20777560
J3: C3-; MYOUNG_MY-FJ-115; MPN MY-FJ-115; LCSC C5457098
J4: C4+; Mill-Max_2036-X-57; MPN 2036-3-57-15-00-00-03-0; LCSC C20777560
J5: PACK_CONN; JST_SH_BM07B-SRSS-TB_1x07-1MP_P1.00mm_Vertical; MPN BM07B-SRSS-TB; LCSC C160393
J6: BACK_CONN; JST_SH_SM02B-SRSS-TB_1x02-1MP_P1.00mm_Horizontal; MPN SM02B-SRSS-TB; LCSC C160402
NT1: P- to VSS; NetTie-2_SMD_Pad0.5mm; MPN DNP
NT3, NT5: NetTie-2_SMD_Pad0.5mm; MPN DNP
NT4.0: P- to GND; NetTie-2_SMD_Pad0.5mm; MPN DNP
Q1, Q2, Q3, Q4: BC817; SOT-23; MPN BC817-25LT1G; LCSC C12766
Q5, Q7: AO3401A; SOT-23; MPN AO3401A; LCSC C15127
Q8: Q_Dual_NMOS_Picostar_CSD87501L; TI_PICOSTAR_LGA-10_3.37x1.47mm_P0.65mm; MPN CSD87501L; LCSC C2841784
R1, R2, R3, R4: 39; R_1206_3216Metric; MPN FRP1206J390 TS; LCSC C5713422
R5: 15mΩ 1%; R_Shunt_Kelvin_Littlefuse_L4CA; MPN PE0612FKF070R015L; LCSC C6142742
R6, R7, R8, R10, R12, R14, R16, R29, R30, R31, R32, R33, R34, R35: 100; R_0402_1005Metric; MPN 0402WGF1000TCE; LCSC C25076
R9, R11, R13, R15: 240; R_0402_1005Metric; MPN RC0402FR-07240RL; LCSC C114755
R18, R21, R22, R25: 10M; R_0402_1005Metric; MPN RC0402FR-0710ML; LCSC C138067
R19, R20, R23, R24: 1k; R_0402_1005Metric; MPN 0402WGF1001TCE; LCSC C11702
R26: 270; R_1812_4532Metric; MPN GR1812J270RT4G00; LCSC C49656236
R27, R28, R36: 10k; R_0402_1005Metric; MPN 0402WGF1002TCE; LCSC C25744
TH1, TH3, TH4: Thermistor; R_0402_1005Metric; MPN CMFX 103F3435; LCSC C2889040
TH2: Thermistor; R_0402_1005Metric; MPN NTCGS103JX103DT7; LCSC C24890359; not fitted
TP1: Pack Voltage; TestPoint_Pad_1.0x1.0mm; MPN DNP; not fitted
U1: BQ76922; Texas_RSN_WQFN-32-1EP_4x4mm_P0.4mm_EP2.8x2.8mm; MPN BQ76922; LCSC C33651534

Connections:
+1V8: C10.2, U1.15 (REG18)
/ALERT: J5.3, R35.2
/BAT-: J0.1 (Pin_1_1), J1.1 (Pin_1_1), NT1.2, NT5.2, R5.1
/BATplus: J4.1 (Pin_1_1), NT4.0.2, Q5.3 (D), Q8.A2 (S2), Q8.B2 (S2), Q8.D2 (S2), Q8.E2 (S2), R18.2, TP1.1 (1_1)
/C1+: D4.2 (A), D14.1 (K), J6.1, Q3.3 (E), R4.1, R14.2, R31.2
/C3+: D2.2 (A), D8.1 (K), J6.2, Q1.3 (E), R2.1, R10.2, R29.2
/CHG: R20.1, U1.31 (CHG)
/CSENSE_N: R5.3, R7.1
/CSENSE_P: R5.2, R6.1
/Cell23: J2.1 (Pin_1_1), J3.1 (Pin_1_1), NT3.2
/DSG: R23.1, U1.30 (DSG)
/LD: R27.1, U1.28 (LD)
/PACK+: J5.2, J5.6, Q8.A1 (S1), Q8.B1 (S1), Q8.D1 (S1), Q8.E1 (S1), R25.2, R26.2, R27.2, R28.2
/PCHG: R19.1, U1.27 (PCHG)
/PDSG: R24.1, U1.26 (PDSG)
/RST: R36.2, U1.21 (RST_SHUT)
/SCL: J5.5, R33.2
/SDA: J5.4, R34.2
/SR_N: C1.2, C7.2, C12.1, R7.2, U1.12 (SRN)
/SR_P: C1.1, C7.1, C13.1, R6.2, U1.11 (SRP)
/TS1: TH1.1, U1.13 (TS1)
/TS2: TH2.1, U1.14 (TS2)
/TS3: TH3.1, U1.19 (CFETOFF)
/TS4: TH4.1, U1.20 (DFETOFF)
/VC0: C14.1, R15.1, R16.1, U1.9 (VC0)
/VC1: C5.2, C6.1, R13.1, R14.1, U1.8 (VC1)
/VC2: C4.2, C5.1, R11.1, R12.1, U1.5 (VC3A), U1.6 (VC3B), U1.7 (VC2)
/VC4: C3.2, C4.1, R9.1, R10.1, U1.3 (VC4A), U1.4 (VC4B)
/VC5: C3.1, D1.2 (A), D11.1 (K), NT4.0.1, R1.1, U1.2 (VC5)
/bqBAT: C2.1, C8.1, C9.2, R8.1, U1.1 (BAT)
/bqPACK: R28.1, U1.29 (PACK)
GND: J5.1, J5.7, R5.4
unnamed: D1.1 (K), R8.2
unnamed: D2.1 (K), Q1.1 (B), R9.2
unnamed: D3.1 (K), Q2.1 (B), R11.2
unnamed: D4.1 (K), Q3.1 (B), R13.2
unnamed: D5.2 (A), NT5.1, Q4.3 (E), R16.2, R32.2
unnamed: D5.1 (K), Q4.1 (B), R15.2
unnamed: D8.2 (A), D10.2 (A), D17.1 (K)
unnamed: D10.1 (K), D17.2 (A), R30.1
unnamed: D9.1 (K), D11.2 (A), D16.2 (A)
unnamed: D12.2 (A), D13.2 (A), D18.1 (K)
unnamed: D3.2 (A), D12.1 (K), NT3.1, Q2.3 (E), R3.1, R12.2, R30.2
unnamed: D13.1 (K), D18.2 (A), R31.1
unnamed: D14.2 (A), D15.2 (A), D19.1 (K)
unnamed: D15.1 (K), D19.2 (A), R32.1
unnamed: D9.2 (A), D16.1 (K), R29.1
unnamed: Q1.2 (C), R1.2
unnamed: Q2.2 (C), R2.2
unnamed: Q3.2 (C), R3.2
unnamed: Q4.2 (C), R4.2
unnamed: Q5.1 (G), R19.2, R21.1
unnamed: Q5.2 (S), Q7.2 (S), R21.2, R22.2
unnamed: Q7.3 (D), R26.1
unnamed: Q7.1 (G), R22.1, R24.2
unnamed: Q8.C1 (G1), R23.2, R25.1
unnamed: Q8.C2 (G2), R18.1, R20.2
unnamed: R35.1, U1.16 (ALERT)
unnamed: C9.1, U1.32 (CP1)
unnamed: R33.1, U1.17 (SCL)
unnamed: R34.1, U1.18 (SDA)
VSS: C2.2, C6.2, C8.2, C10.1, C12.2, C13.2, C14.2, NT1.1, R36.1, TH1.2, TH2.2, TH3.2, TH4.2, U1.10 (V_{SS}), U1.22 (REG1), U1.23 (REGIN), U1.24 (BREG), U1.33 (EP)

Notes on the sheet:
4mA
NOTE: RST_SHUT is active high!
GND is carrying high current VSS is only a few mA
XZMDK68W-2
NOTE: remove TH2 for full shutdown ability
was: NTCGS163JX103DT7
V_{CE,sat} <= 70mV @ 0.1A (BC817-*) ----------------------- h_{FE,min} = 350 @ 25°C (BC817-40W) h_{FE,min} = 250 @ 25°C (BC817-25W) h_{FE,min} = 150 @ 25°C (BC817-16W)
(any of these should work)
1A per pin = 2A max
60 mA pre(dis)charge at 16 V 1W power dissipation max.
Current sense resistor power rating: 1 W 15-mΩ shunt: max 8.1 A 12-mΩ shunt: max 9.1 A 10-mΩ shunt: max 10 A
add I²C pullups on the mainboard! (1.5kΩ)
yageo RCS120639R0FKEA
Balance resistor power rating 4.25^{2}/R = 463 mW (LiIon) 108 mA @ NMC, 92 mA @ LFP
SLUAA81A

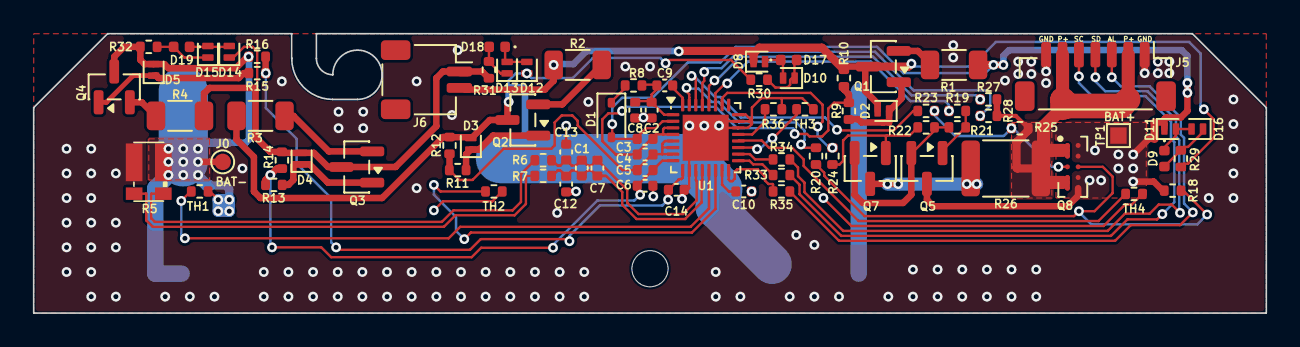
[picture p169: board nref-batterypack.kicad_pcb from above]

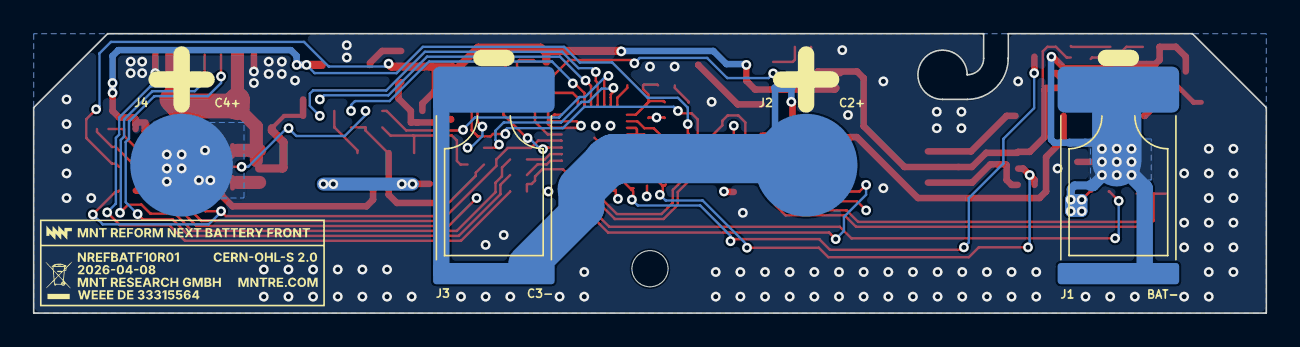
[picture p170: board nref-batterypack.kicad_pcb from below]

Board: 4 copper layers, 75.0 x 17.0 mm, 90 parts (7 on the bottom side), 62 nets.
