cetola/reform-next-mirror/nref-flex/nref-flex-eth/nref-flex-eth.kicad_pcb

## KiCad design nref-flex/nref-flex-eth/nref-flex-eth.kicad_pcb (2026-09-02)

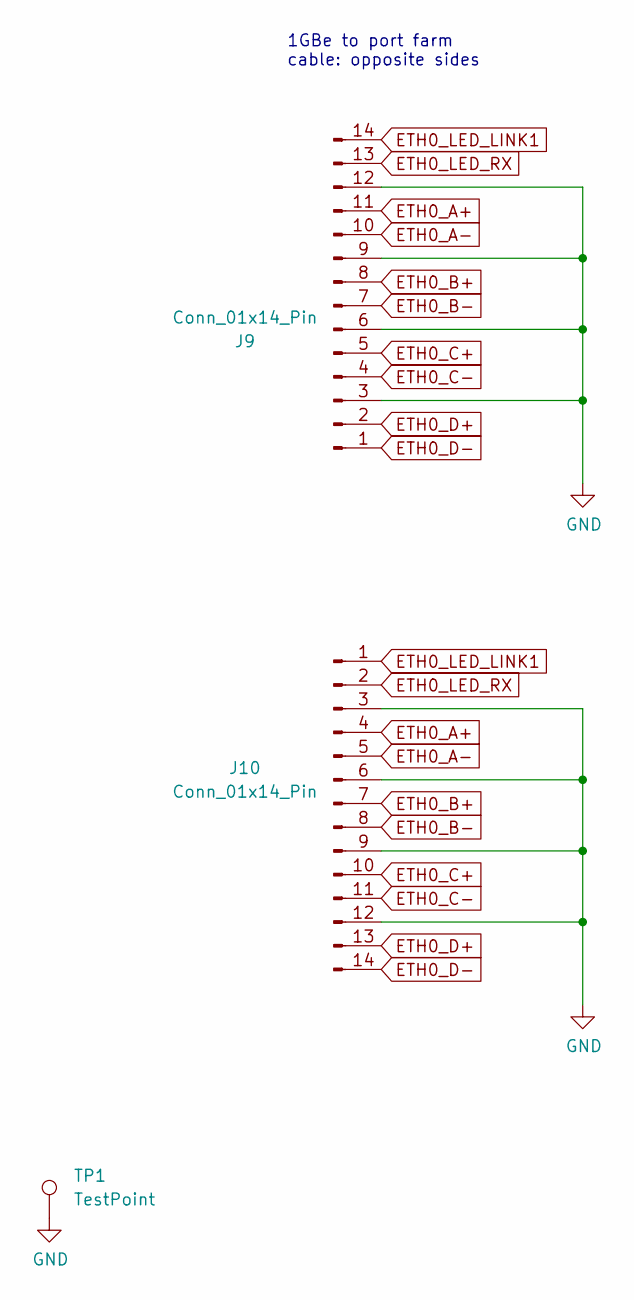
[picture p171: schematic nref-flex-eth.kicad_sch]

Parts:
J9, J10: Conn_01x14_Pin; Hirose_FH12-14S-0.5SH_1x14-1MP_P0.50mm_Horizontal
TP1: TestPoint; TestPoint_Pad_D1.0mm

Connections:
ETH0_A+: J9.11, J10.4
ETH0_A-: J9.10, J10.5
ETH0_B+: J9.8, J10.7
ETH0_B-: J9.7, J10.8
ETH0_C+: J9.5, J10.10
ETH0_C-: J9.4, J10.11
ETH0_D+: J9.2, J10.13
ETH0_D-: J9.1, J10.14
ETH0_LED_LINK1: J9.14, J10.1
ETH0_LED_RX: J9.13, J10.2
GND: J9.3, J9.6, J9.9, J9.12, J10.3, J10.6, J10.9, J10.12, TP1.1

Notes on the sheet:
1GBe to port farm cable: opposite sides

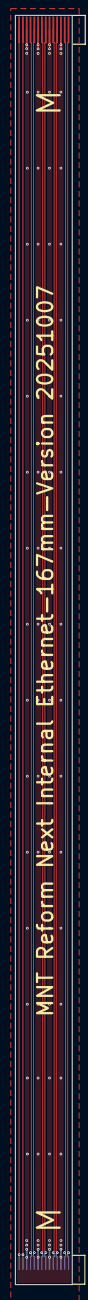
[picture p172: board nref-flex-eth.kicad_pcb from above]

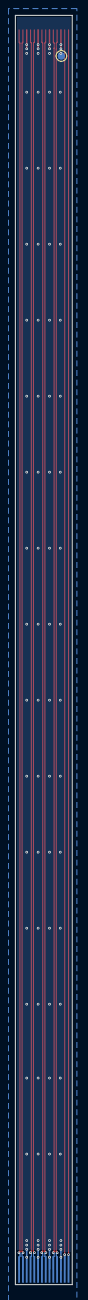
[picture p173: board nref-flex-eth.kicad_pcb from below]

Board: 2 copper layers, 7.5 x 167.0 mm, 3 parts (2 on the bottom side), 11 nets.
