cetola/reform-next-mirror/nref-trackpad-sensor/Trackpad_IQS9150.kicad_pcb

## KiCad design nref-trackpad-sensor/Trackpad_IQS9150.kicad_pcb (2026-09-02)

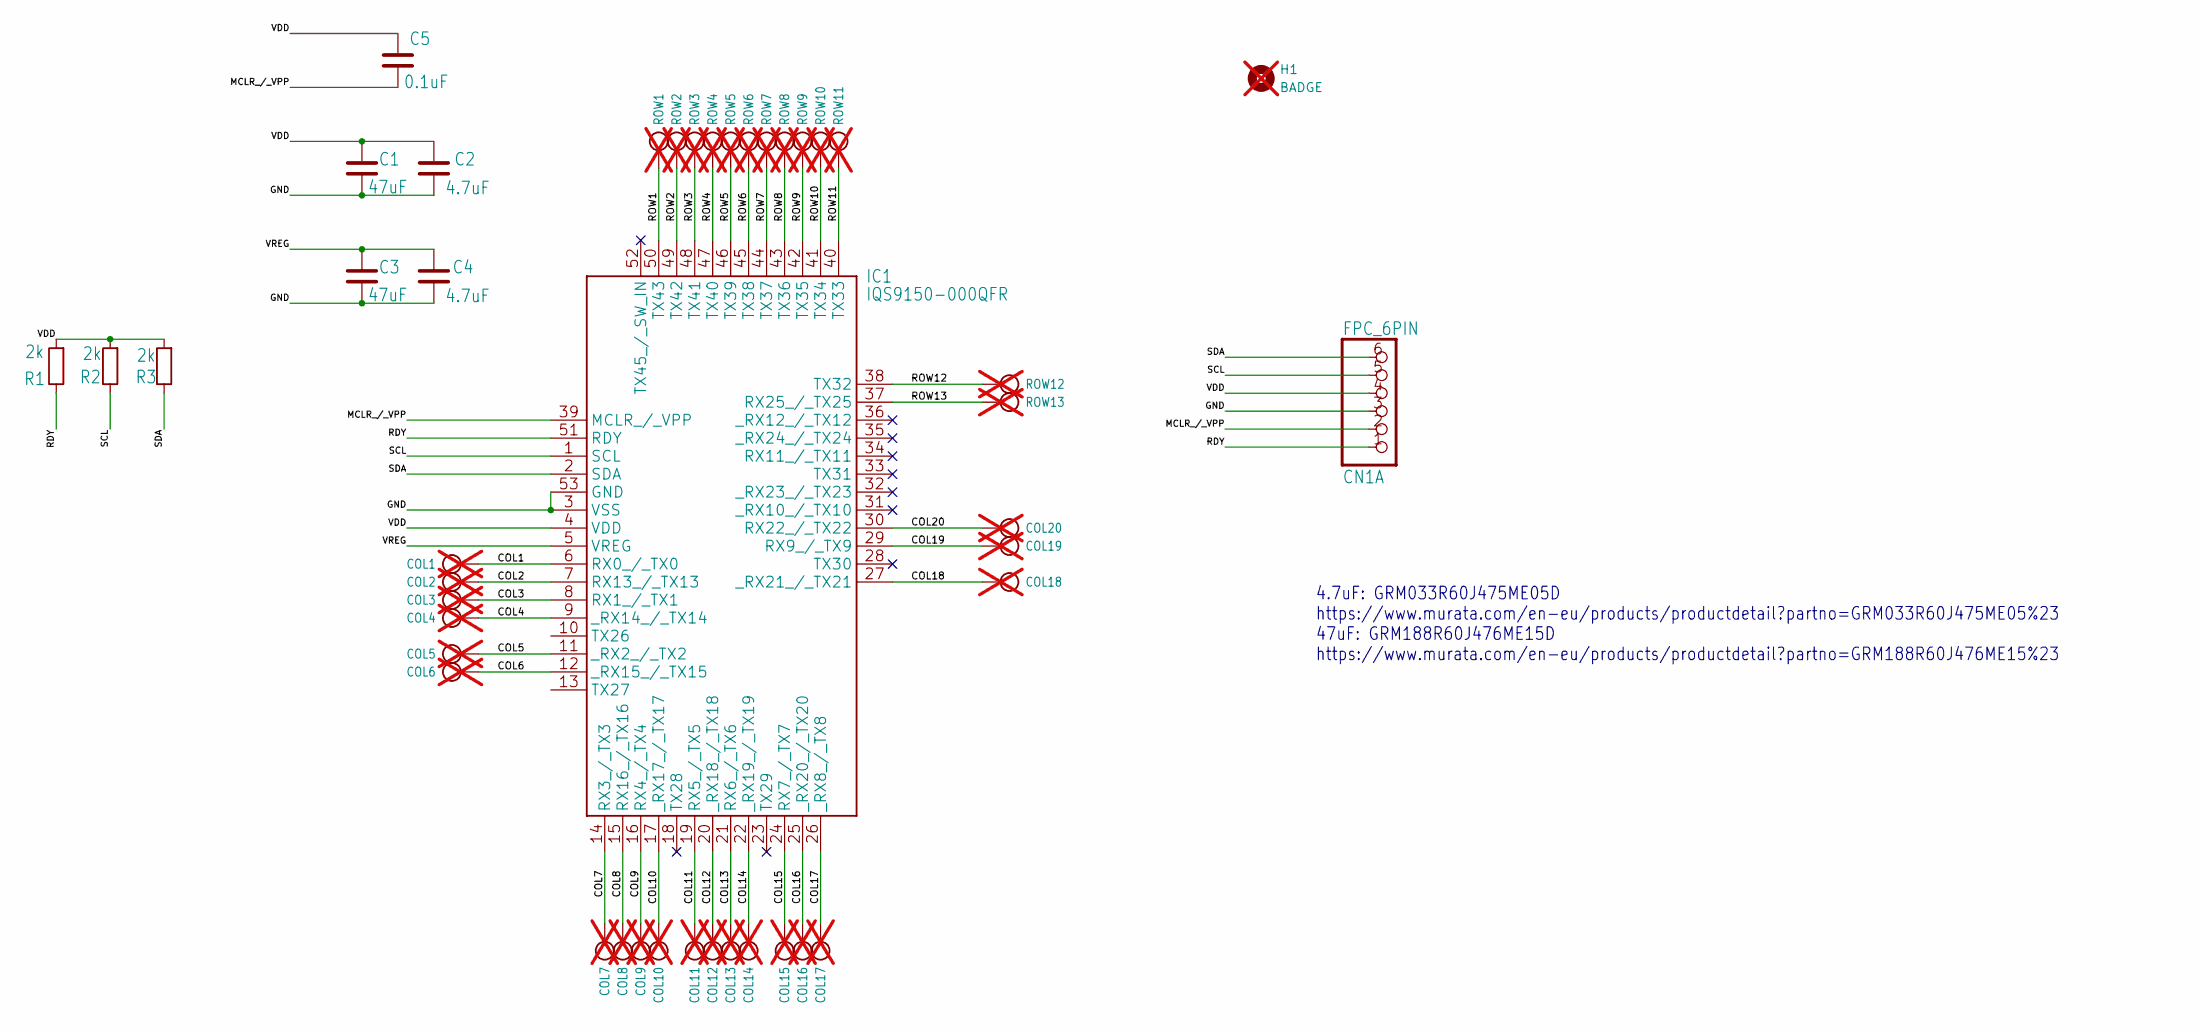
[picture p174: schematic Trackpad_IQS9150_1.kicad_sch]

Parts:
C1, C3: 47uF; C_0603_1608Metric; MPN GRM188R60J476ME15D; LCSC C140782
C2, C4: 4.7uF; C_0402_1005Metric; MPN CL05A475MP5NRNC; LCSC C23733
C5: 0.1uF; C_0402_1005Metric; MPN CL05B104KO5NNNC; LCSC C1525
CN1: FPC_6PIN; Hirose_FH12-6S-0.5SH_1x06-1MP_P0.50mm_Horizontal; MPN FH12-6S-0.5SH(55); LCSC C202118
COL1, COL2, COL3, COL4, COL5, COL6, COL7, COL8, COL9, COL10, COL11, COL12, COL13, COL14, COL15, COL16, COL17, COL18, COL19, COL20: TESTPOINTPAD_0_5MM; PAD_0_5MM; not fitted
H1: BADGE; nref-tpsensor-badge; not fitted
IC1: IQS9150-000QFR; IQS9150000QFR; MPN IQS9150-000QFR; LCSC C34066848
R1, R2, R3: 2k; R_0402_1005Metric; MPN 0402WGF2001TCE; LCSC C4109
ROW1, ROW2, ROW3, ROW4, ROW5, ROW6, ROW7, ROW8, ROW9, ROW10, ROW11, ROW12, ROW13: TESTPOINTPAD_0_5MM; PAD_0_5MM; not fitted

Connections:
/Trackpad_IQS9150_1/COL1: COL1.P1 (P1_P1), IC1.6 (RX0_/_TX0)
/Trackpad_IQS9150_1/COL2: COL2.P1 (P1_P1), IC1.7 (RX13_/_TX13)
/Trackpad_IQS9150_1/COL3: COL3.P1 (P1_P1), IC1.8 (RX1_/_TX1)
/Trackpad_IQS9150_1/COL4: COL4.P1 (P1_P1), IC1.9 (_RX14_/_TX14)
/Trackpad_IQS9150_1/COL5: COL5.P1 (P1_P1), IC1.11 (_RX2_/_TX2)
/Trackpad_IQS9150_1/COL6: COL6.P1 (P1_P1), IC1.12 (_RX15_/_TX15)
/Trackpad_IQS9150_1/COL7: COL7.P1 (P1_P1), IC1.14 (RX3_/_TX3)
/Trackpad_IQS9150_1/COL8: COL8.P1 (P1_P1), IC1.15 (RX16_/_TX16)
/Trackpad_IQS9150_1/COL9: COL9.P1 (P1_P1), IC1.16 (RX4_/_TX4)
/Trackpad_IQS9150_1/COL10: COL10.P1 (P1_P1), IC1.17 (_RX17_/_TX17)
/Trackpad_IQS9150_1/COL11: COL11.P1 (P1_P1), IC1.19 (RX5_/_TX5)
/Trackpad_IQS9150_1/COL12: COL12.P1 (P1_P1), IC1.20 (_RX18_/_TX18)
/Trackpad_IQS9150_1/COL13: COL13.P1 (P1_P1), IC1.21 (RX6_/_TX6)
/Trackpad_IQS9150_1/COL14: COL14.P1 (P1_P1), IC1.22 (_RX19_/_TX19)
/Trackpad_IQS9150_1/COL15: COL15.P1 (P1_P1), IC1.24 (RX7_/_TX7)
/Trackpad_IQS9150_1/COL16: COL16.P1 (P1_P1), IC1.25 (_RX20_/_TX20)
/Trackpad_IQS9150_1/COL17: COL17.P1 (P1_P1), IC1.26 (_RX8_/_TX8)
/Trackpad_IQS9150_1/COL18: COL18.P1 (P1_P1), IC1.27 (_RX21_/_TX21)
/Trackpad_IQS9150_1/COL19: COL19.P1 (P1_P1), IC1.29 (RX9_/_TX9)
/Trackpad_IQS9150_1/COL20: COL20.P1 (P1_P1), IC1.30 (RX22_/_TX22)
/Trackpad_IQS9150_1/GND: C1.2, C2.2, C3.2, C4.2, CN1.3, IC1.3 (VSS), IC1.53 (GND)
/Trackpad_IQS9150_1/MCLR_/_VPP: C5.2, CN1.2, IC1.39 (MCLR_/_VPP)
/Trackpad_IQS9150_1/RDY: CN1.1, IC1.51 (RDY), R1.1
/Trackpad_IQS9150_1/ROW1: IC1.50 (TX43), ROW1.P1 (P1_P1)
/Trackpad_IQS9150_1/ROW2: IC1.49 (TX42), ROW2.P1 (P1_P1)
/Trackpad_IQS9150_1/ROW3: IC1.48 (TX41), ROW3.P1 (P1_P1)
/Trackpad_IQS9150_1/ROW4: IC1.47 (TX40), ROW4.P1 (P1_P1)
/Trackpad_IQS9150_1/ROW5: IC1.46 (TX39), ROW5.P1 (P1_P1)
/Trackpad_IQS9150_1/ROW6: IC1.45 (TX38), ROW6.P1 (P1_P1)
/Trackpad_IQS9150_1/ROW7: IC1.44 (TX37), ROW7.P1 (P1_P1)
/Trackpad_IQS9150_1/ROW8: IC1.43 (TX36), ROW8.P1 (P1_P1)
/Trackpad_IQS9150_1/ROW9: IC1.42 (TX35), ROW9.P1 (P1_P1)
/Trackpad_IQS9150_1/ROW10: IC1.41 (TX34), ROW10.P1 (P1_P1)
/Trackpad_IQS9150_1/ROW11: IC1.40 (TX33), ROW11.P1 (P1_P1)
/Trackpad_IQS9150_1/ROW12: IC1.38 (TX32), ROW12.P1 (P1_P1)
/Trackpad_IQS9150_1/ROW13: IC1.37 (RX25_/_TX25), ROW13.P1 (P1_P1)
/Trackpad_IQS9150_1/SCL: CN1.5, IC1.1 (SCL), R2.1
/Trackpad_IQS9150_1/SDA: CN1.6, IC1.2 (SDA), R3.1
/Trackpad_IQS9150_1/VDD: C1.1, C2.1, C5.1, CN1.4, IC1.4 (VDD), R1.2, R2.2, R3.2
/Trackpad_IQS9150_1/VREG: C3.1, C4.1, IC1.5 (VREG)

Notes on the sheet:
4.7uF: GRM033R60J475ME05D https://www.murata.com/en-eu/products/productdetail?partno=GRM033R60J475ME05%23 47uF: GRM188R60J476ME15D https://www.murata.com/en-eu/products/productdetail?partno=GRM188R60J476ME15%23
