cetola/reform-next-mirror/nref-trackpad-sensor/Trackpad_IQS9150.kicad_pcb

## KiCad design nref-trackpad-sensor/Trackpad_IQS9150.kicad_pcb (continued)

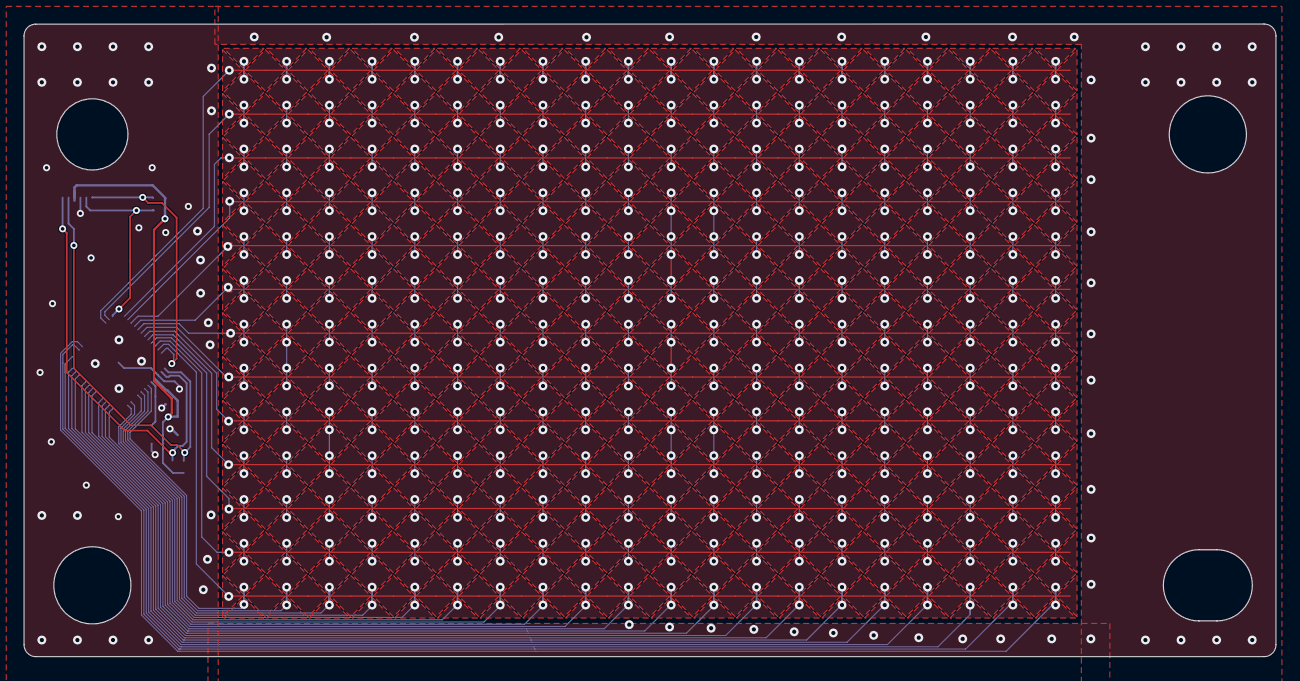
[picture p175: board Trackpad_IQS9150.kicad_pcb from above]

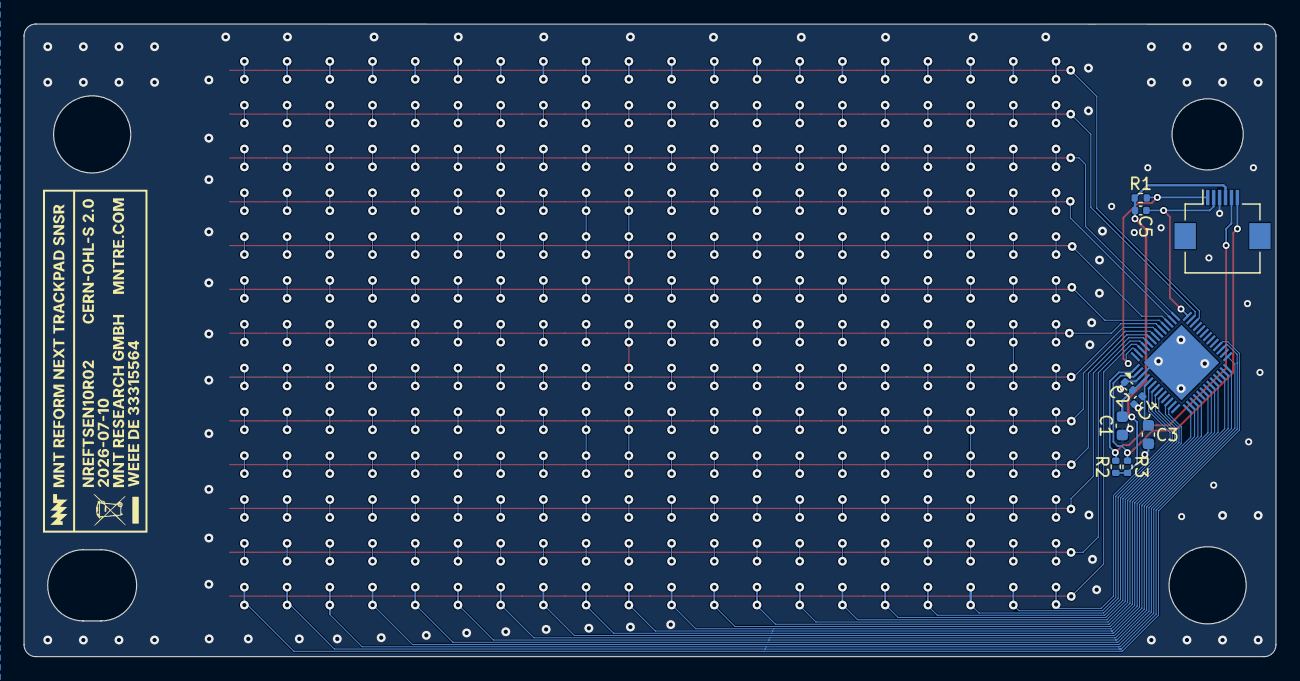
[picture p176: board Trackpad_IQS9150.kicad_pcb from below]

Board: 2 copper layers, 105.5 x 53.3 mm, 44 parts (31 on the bottom side), 40 nets.
