cetola/reform-next-mirror/nref-ports-one/nref-ports-one.kicad_pcb

## KiCad design nref-ports-one/nref-ports-one.kicad_pcb (2026-09-02)

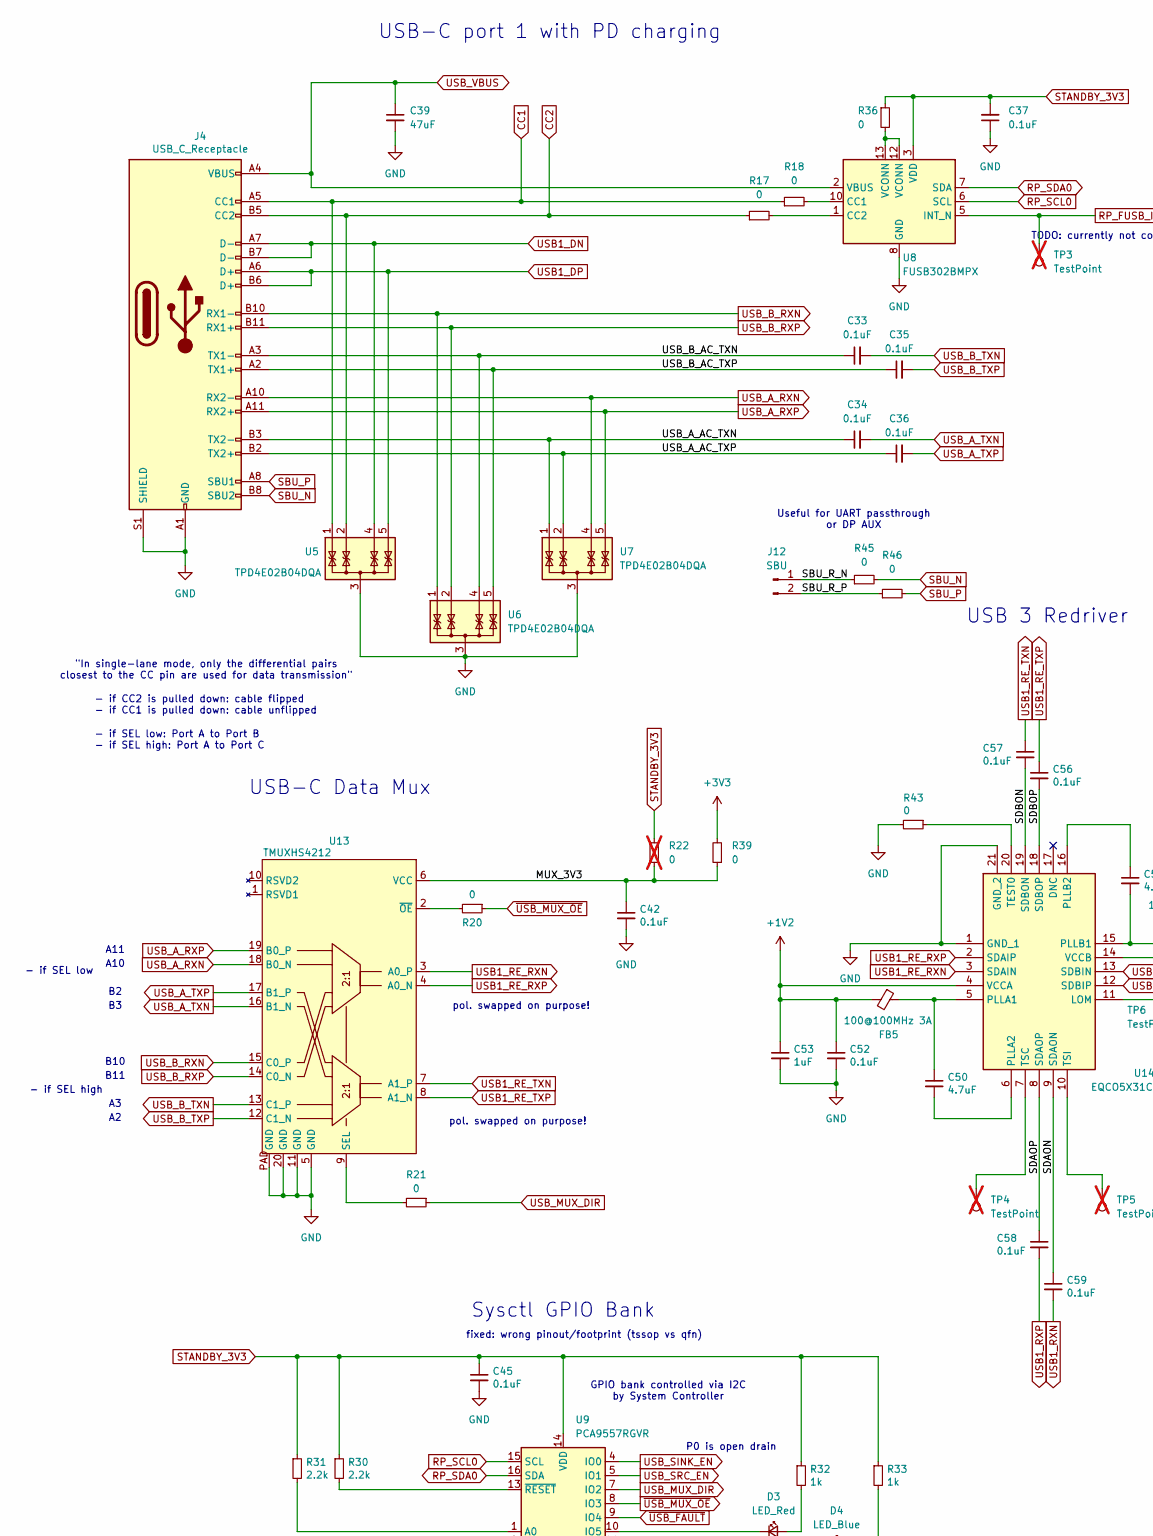
[picture p177: schematic nref-ports-one.kicad_sch, part in row 1, column 1]

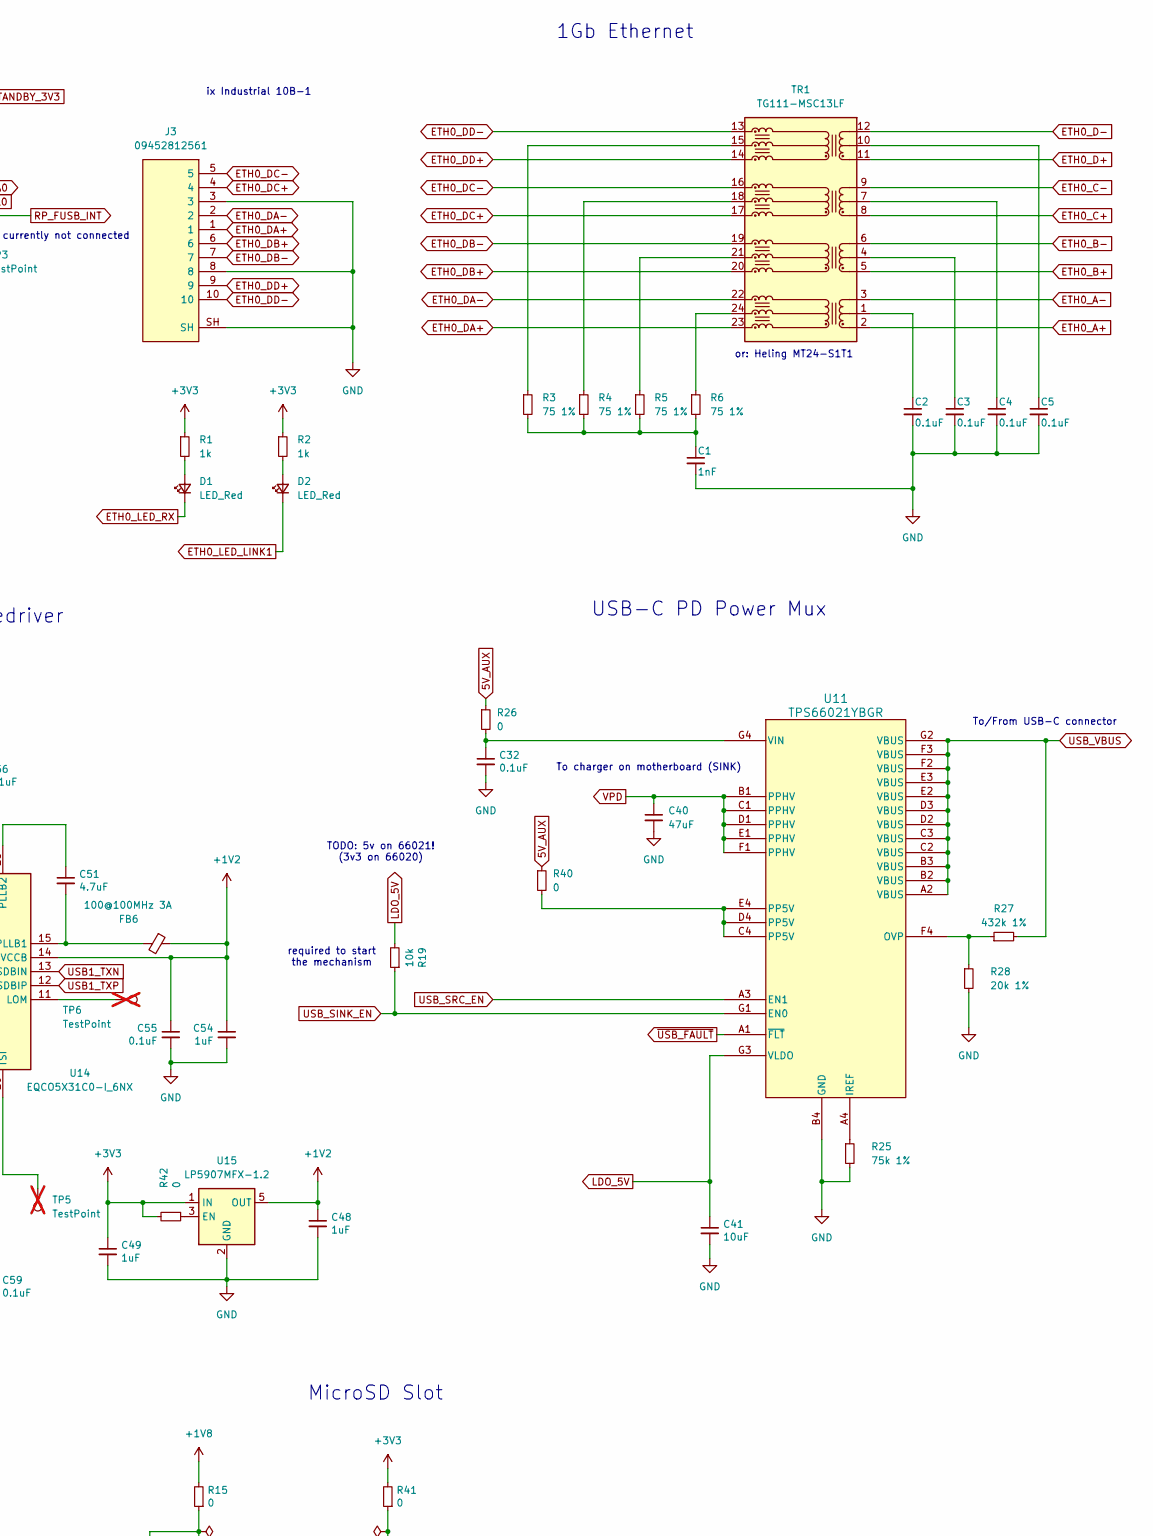
[picture p178: schematic nref-ports-one.kicad_sch, part in row 1, column 2]

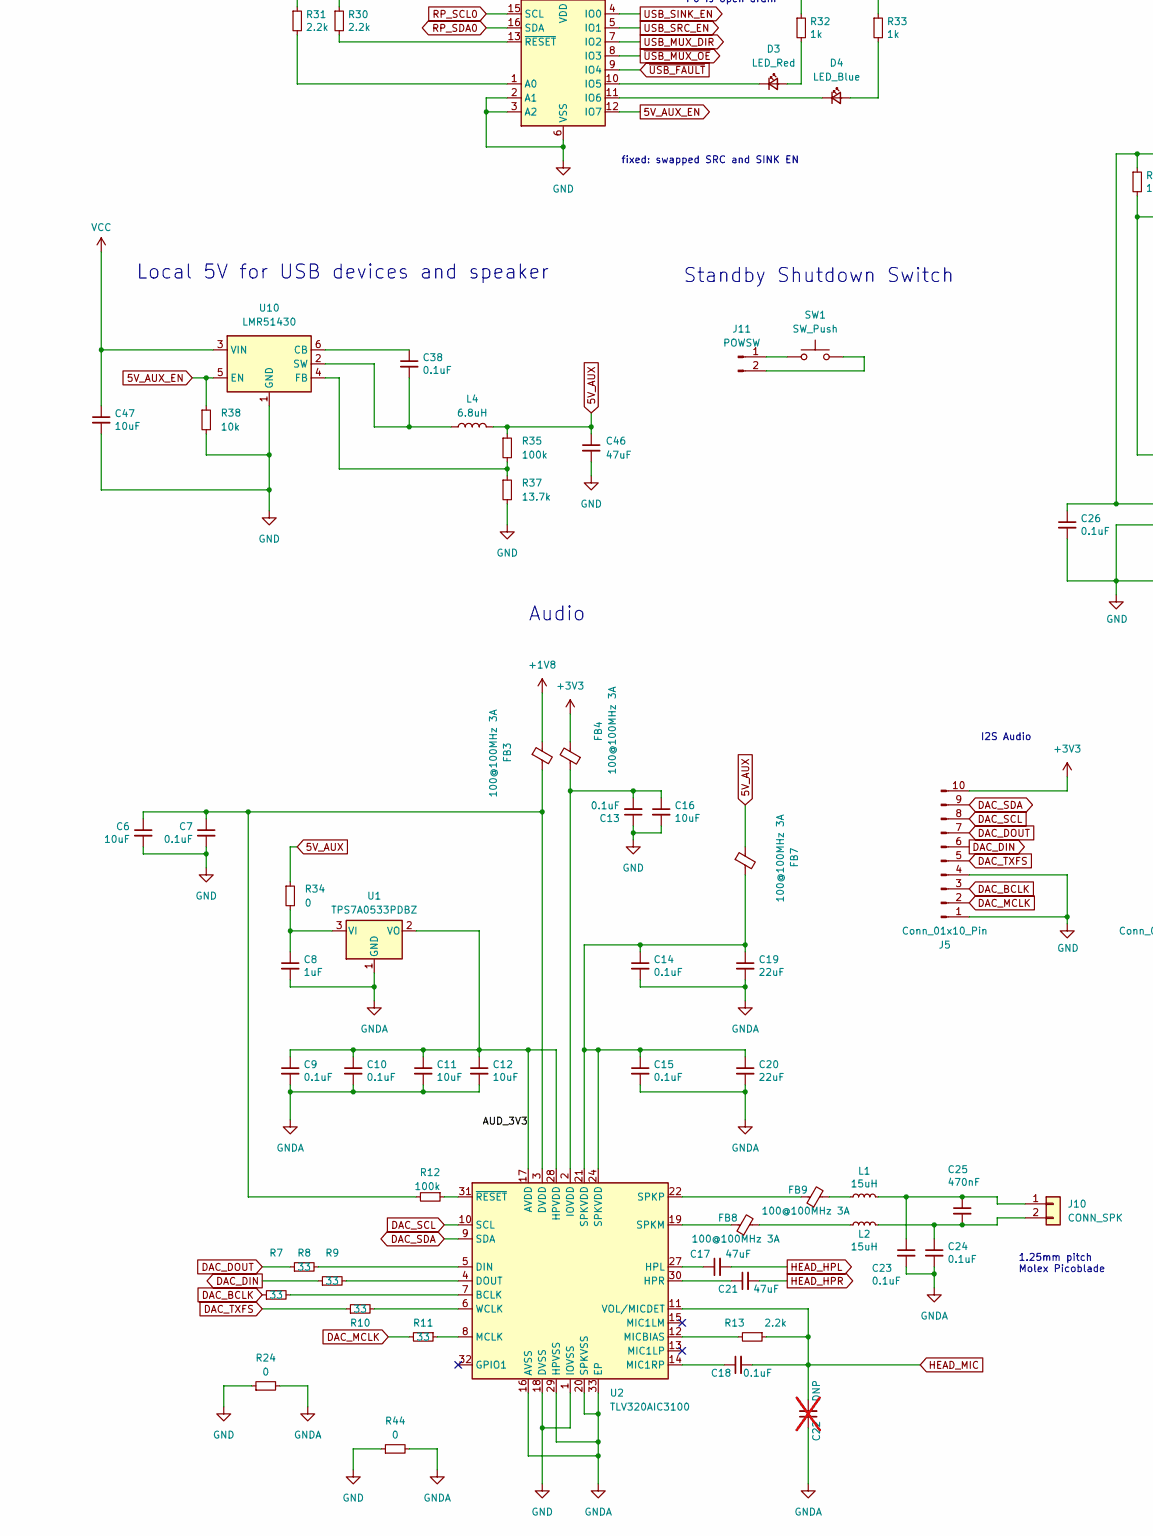
[picture p179: schematic nref-ports-one.kicad_sch, part in row 2, column 1]

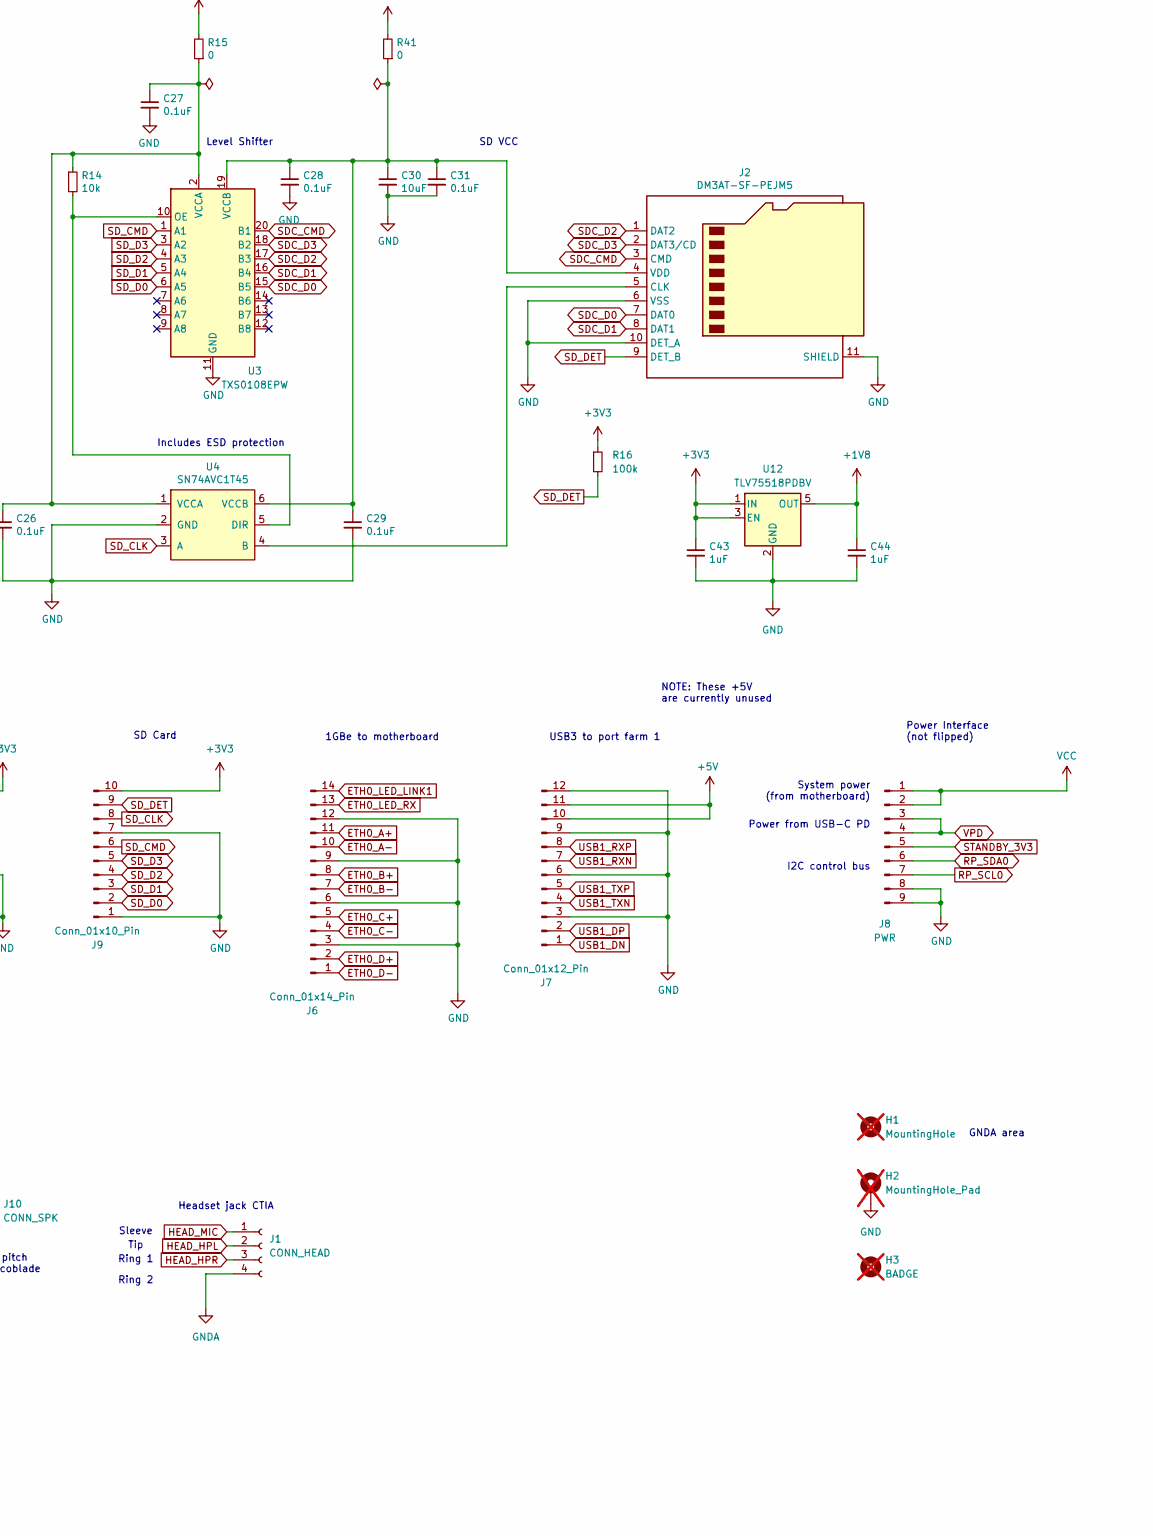
[picture p180: schematic nref-ports-one.kicad_sch, part in row 2, column 2]

Parts:
C1: 1nF; C_0402_1005Metric; LCSC C1523
C2, C3, C4, C5, C7, C9, C10, C13, C14, C15, C18, C23, C24, C26, C27, C28, C29, C31, C32, C33, C34, C35, C36, C37, C38, C42, C45, C52, C55, C56, C57, C58, C59: 0.1uF; C_0402_1005Metric; LCSC C1525
C6, C11, C12, C16, C30, C41, C47: 10uF; C_0603_1608Metric; LCSC C96446
C8, C43, C44, C48, C49, C53, C54: 1uF; C_0402_1005Metric; LCSC C52923
C17, C21, C39, C40, C46: 47uF; C_1210_3225Metric; LCSC C90142
C19, C20: 22uF; C_0805_2012Metric; LCSC C29277
C22: DNP; C_0402_1005Metric; LCSC C1525; not fitted
C25: 470nF; C_0402_1005Metric; LCSC C47339
C50, C51: 4.7uF; C_0402_1005Metric; LCSC C307423
D1, D2, D3: LED_Red; LED_0603_1608Metric; LCSC C965799
D4: LED_Blue; LED_0603_1608Metric; LCSC C965807
FB3, FB4, FB5, FB6, FB7, FB8, FB9: 100@100MHz 3A; L_0402_1005Metric; LCSC C76891
H1: MountingHole; MountingHole_2.2mm_M2; not fitted
H2: MountingHole_Pad; MountingHole_2.2mm_M2_Pad; not fitted
H3: BADGE; nref-ports-one-badge; not fitted
J1: CONN_HEAD; CUI_SJ-43614-SMT; LCSC C4992770
J2: DM3AT-SF-PEJM5; microSD_HC_Hirose_DM3AT-SF-PEJM5; LCSC C114218
J3: 09452812561; LCSC C19193264
J4: USB_C_Receptacle; USB_C_Receptacle_Molex_105450-0101; LCSC C134092
J5, J9: Conn_01x10_Pin; Hirose_FH12-10S-0.5SH_1x10-1MP_P0.50mm_Horizontal; LCSC C506791
J6: Conn_01x14_Pin; Hirose_FH12-14S-0.5SH_1x14-1MP_P0.50mm_Horizontal; LCSC C5378715
J7: Conn_01x12_Pin; Hirose_FH12-12S-0.5SH_1x12-1MP_P0.50mm_Horizontal; LCSC C88360
J8: PWR; JST_SH_SM09B-SRSS-TB_1x09-1MP_P1.00mm_Horizontal; LCSC C160408
J10: CONN_SPK; Molex_PicoBlade_53261-0271_1x02-1MP_P1.25mm_Horizontal; LCSC C177225
J11: POWSW; JST_SH_SM02B-SRSS-TB_1x02-1MP_P1.00mm_Horizontal; LCSC C160402
J12: SBU; JST_SH_SM02B-SRSS-TB_1x02-1MP_P1.00mm_Horizontal; LCSC C160402
L1, L2: 15uH; L_Taiyo-Yuden_NR-30xx; LCSC C497563
L4: 6.8uH; L_Taiyo-Yuden_NR-30xx; LCSC C7423322
R1, R2, R32, R33: 1k; R_0402_1005Metric; LCSC C11702
R3, R4, R5, R6: 75 1%; R_0402_1005Metric; LCSC C413061
R7, R8, R9, R10, R11: 33; R_0402_1005Metric; LCSC C25105
R12, R16, R35: 100k; R_0402_1005Metric; LCSC C25741
R13, R30, R31: 2.2k; R_0402_1005Metric; LCSC C25879
R14, R19, R38: 10k; R_0402_1005Metric; LCSC C25744
R15, R17, R18, R20, R21, R24, R26, R34, R36, R39, R41, R42, R43, R44, R45, R46: 0; R_0402_1005Metric; LCSC C17168
R22: 0; R_0402_1005Metric; LCSC C17168; not fitted
R25: 75k 1%; R_0402_1005Metric; LCSC C25798
R27: 432k 1%; R_0402_1005Metric; LCSC C227078
R28: 20k 1%; R_0402_1005Metric; LCSC C93942
R37: 13.7k; R_0402_1005Metric; LCSC C25854
R40: 0; R_0603_1608Metric; LCSC C21189
SW1: SW_Push; SW_SPST_B3U-3000P; LCSC C963349
TP3, TP4, TP5, TP6: TestPoint; TestPoint_Pad_D1.0mm; not fitted
TR1: TG111-MSC13LF; Transformer_Ethernet_HALO_TG111-MSC13; LCSC C501477
U1: TPS7A0533PDBZ; SOT-23; LCSC C42411811
U2: TLV320AIC3100; VQFN-32-1EP_5x5mm_P0.5mm_EP3.5x3.5mm; LCSC C478458
U3: TXS0108EPW; TSSOP-20_4.4x6.5mm_P0.65mm; LCSC C17206
U4: SN74AVC1T45; SOT-23-6; LCSC C131978
U5, U6, U7: TPD4E02B04DQA; USON-10_2.5x1.0mm_P0.5mm; LCSC C2841426
U8: FUSB302BMPX; WQFN-14-1EP_2.5x2.5mm_P0.5mm_EP1.45x1.45mm; LCSC C132291
U9: PCA9557RGVR; Texas_RSA_VQFN-16-1EP_4x4mm_P0.65mm_EP2.7x2.7mm; LCSC C2669728
U10: LMR51430; SOT-23-6; LCSC C5185863
U11: TPS66021YBGR; YBG0028_TEX; LCSC C1855766
U12: TLV75518PDBV; SOT-23-5; LCSC C2877863
U13: TMUXHS4212; Texas-VQFN20_2.5x4.5mm_RKS; MPN TMUXHS4212RKSR; LCSC C2869871
U14: EQCO5X31C0-I_6NX; QFN50P400X400X100-21N-D; Mouser Part Number 494-EQCO5X31C0-I/6NX
U15: LP5907MFX-1.2; SOT-23-5; LCSC C73478

Connections:
5V_AUX: C46.1, FB7.1, L4.2, R26.1, R34.1, R35.1, R40.1
5V_AUX_EN: R38.1, U9.12 (IO7), U10.5 (EN)
+1V2: C48.1, C52.1, C53.1, C54.1, C55.1, FB5.2, FB6.1, U14.4 (VCCA), U14.14 (VCCB), U15.5 (OUT)
+1V8: C44.1, FB3.1, R15.2, U12.5 (OUT)
+3V3: C43.1, C49.1, FB4.2, J5.10, J9.10, R1.1, R2.1, R16.1, R39.2, R41.2, R42.2, U12.1 (IN), U12.3 (EN), U15.1 (IN)
+5V: J7.10, J7.11
/AUD_3V3: C9.1, C10.1, C11.1, C12.1, U1.2 (VO), U2.17 (AVDD), U2.28 (HPVDD)
/MUX_3V3: C42.1, R22.1, R39.1, U13.6 (VCC)
/SBU_R_N: J12.1, R45.1
/SBU_R_P: J12.2, R46.1
/SDAON: C59.1, U14.9 (SDAON)
/SDAOP: C58.1, U14.8 (SDAOP)
/SDBON: C57.2, U14.19 (SDBON)
/SDBOP: C56.2, U14.18 (SDBOP)
/USB_A_AC_TXN: C34.1, J4.B3 (TX2-), U7.1 (IO1), U7.10 (IO1)
/USB_A_AC_TXP: C36.1, J4.B2 (TX2+), U7.2 (IO2), U7.9 (IO2)
/USB_B_AC_TXN: C33.1, J4.A3 (TX1-), U6.4 (IO3), U6.7 (IO3)
/USB_B_AC_TXP: C35.1, J4.A2 (TX1+), U6.5 (IO4), U6.6 (IO4)
CC1: J4.A5 (CC1), R18.1, U5.1 (IO1), U5.10 (IO1)
CC2: J4.B5 (CC2), R17.1, U5.2 (IO2), U5.9 (IO2)
DAC_BCLK: J5.3, R7.1
DAC_DIN: J5.6, R9.1
DAC_DOUT: J5.7, R8.1
DAC_MCLK: J5.2, R11.2
DAC_SCL: J5.8, U2.10 (SCL)
DAC_SDA: J5.9, U2.9 (SDA)
DAC_TXFS: J5.5, R10.1
ETH0_A+: J6.11, TR1.2 (TD1+)
ETH0_A-: J6.10, TR1.3 (TD1-)
ETH0_B+: J6.8, TR1.5 (TD2+)
ETH0_B-: J6.7, TR1.6 (TD2-)
ETH0_C+: J6.5, TR1.8 (TD3+)
ETH0_C-: J6.4, TR1.9 (TD3-)
ETH0_D+: J6.2, TR1.11 (TD4+)
ETH0_D-: J6.1, TR1.12 (TD4-)
ETH0_DA+: J3.1, TR1.23 (MTX1+)
ETH0_DA-: J3.2, TR1.22 (MTX1-)
ETH0_DB+: J3.6, TR1.20 (MTX2+)
ETH0_DB-: J3.7, TR1.19 (MTX2-)
ETH0_DC+: J3.4, TR1.17 (MTX3+)
ETH0_DC-: J3.5, TR1.16 (MTX3-)
ETH0_DD+: J3.9, TR1.14 (MX4+)
ETH0_DD-: J3.10, TR1.13 (MX4-)
ETH0_LED_LINK1: D2.1 (K), J6.14
ETH0_LED_RX: D1.1 (K), J6.13
GND: C1.2, C2.2, C3.2, C4.2, C5.2, C6.2, C7.2, C13.1, C16.2, C26.2, C27.2, C28.2, C29.2, C30.2, C31.2, C32.2, C37.1, C39.2, C40.2, C41.2, C42.2, C43.2, C44.2, C45.2, C46.2, C47.2, C48.2, C49.2, C52.2, C53.2, C54.2, C55.2, H2.1, J2.6 (VSS), J2.10 (DET_A), J2.11 (SHIELD), J3.3, J3.8, J3.SH, J4.A1 (GND), J4.A12 (GND), J4.B1 (GND), J4.B12 (GND), J4.S1 (SHIELD), J5.1, J5.4, J6.3, J6.6, J6.9, J6.12, J7.3, J7.6, J7.9, J7.12, J8.8, J8.9, J9.1, J9.7, R24.1, R25.2, R28.2, R37.2, R38.2, R43.2, R44.1, U2.1 (IOVSS), U2.18 (DVSS), U3.11 (GND), U4.2 (GND), U5.3 (G), U5.8 (G), U6.3 (G), U6.8 (G), U7.3 (G), U7.8 (G), U8.8 (GND), U8.9 (GND), U8.15 (GND), U9.2 (A1), U9.3 (A2), U9.6 (VSS), U10.1 (GND), U11.B4 (GND), U12.2 (GND), U13.5 (GND), U13.11 (GND), U13.20 (GND), U13.PAD (GND), U14.1 (GND_1), U14.21 (GND_2), U15.2 (GND)
GNDA: C8.2, C9.2, C10.2, C11.2, C12.2, C14.2, C15.2, C19.2, C20.2, C22.1, C23.2, C24.2, J1.4, R24.2, R44.2, U1.1 (GND), U2.16 (AVSS), U2.20 (SPKVSS), U2.25 (SPKVSS), U2.29 (HPVSS), U2.33 (EP)
HEAD_HPL: C17.2, J1.2
HEAD_HPR: C21.2, J1.3
HEAD_MIC: C18.2, C22.2, J1.1, R13.1, U2.11 (VOL/MICDET)
LDO_5V: C41.1, R19.2, U11.G3 (VLDO)
unnamed: C1.1, R3.2, R4.2, R5.2, R6.2
unnamed: C14.1, C15.1, C19.1, C20.1, FB7.2, U2.21 (SPKVDD), U2.24 (SPKVDD)
unnamed: D1.2 (A), R1.2
unnamed: D2.2 (A), R2.2
unnamed: D3.2 (A), R32.2
unnamed: D3.1 (K), U9.10 (IO5)
unnamed: D4.2 (A), R33.2
unnamed: D4.1 (K), U9.11 (IO6)
unnamed: FB8.1, U2.19 (SPKM), U2.23 (SPKM)
unnamed: FB8.2, L2.1
unnamed: FB9.1, U2.22 (SPKP), U2.26 (SPKP)
unnamed: FB9.2, L1.1
unnamed: J2.5 (CLK), U4.4 (B)
unnamed: C28.1, C29.1, C30.1, C31.1, J2.4 (VDD), R41.1, U3.19 (VCCB), U4.6 (VCCB)
unnamed: C23.1, C25.1, J10.1, L1.2
unnamed: C24.1, C25.2, J10.2, L2.2
unnamed: J11.1, SW1.1
unnamed: J11.2, SW1.2
unnamed: R17.2, U8.1 (CC2), U8.14 (CC2)
unnamed: R18.2, U8.10 (CC1), U8.11 (CC1)
unnamed: R36.2, U8.12 (VCONN), U8.13 (VCONN)
unnamed: R40.2, U11.C4 (PP5V), U11.D4 (PP5V), U11.E4 (PP5V)
unnamed: R5.1, TR1.21 (MCT2)
unnamed: R4.1, TR1.18 (MCT3)
unnamed: R3.1, TR1.15 (MCT4)
unnamed: R6.1, TR1.24 (MTC1)
unnamed: C2.1, TR1.1 (TCT1)
unnamed: C3.1, TR1.4 (TCT2)
unnamed: C4.1, TR1.7 (TCT3)
unnamed: C5.1, TR1.10 (TCT4)
unnamed: C8.1, R34.2, U1.3 (VI)
unnamed: R7.2, U2.7 (BCLK)
unnamed: R8.2, U2.5 (DIN)
unnamed: R9.2, U2.4 (DOUT)
unnamed: C6.1, C7.1, FB3.2, R12.2, U2.3 (DVDD)
unnamed: C17.1, U2.27 (HPL)
unnamed: C21.1, U2.30 (HPR)
unnamed: C13.2, C16.1, FB4.1, U2.2 (IOVDD)
unnamed: R11.1, U2.8 (MCLK)
unnamed: C18.1, U2.14 (MIC1RP)
unnamed: R13.2, U2.12 (MICBIAS)
unnamed: R10.2, U2.6 (WCLK)
unnamed: R12.1, U2.31 (~RESET)
unnamed: R14.2, U3.10 (OE), U4.5 (DIR)
unnamed: C26.1, C27.1, R14.1, R15.1, U3.2 (VCCA), U4.1 (VCCA)
unnamed: R31.2, U9.1 (A0)
unnamed: R30.2, U9.13 (~RESET)
unnamed: C38.1, U10.6 (CB)
unnamed: R35.2, R37.1, U10.4 (FB)
unnamed: C38.2, L4.1, U10.2 (SW)
unnamed: R25.1, U11.A4 (IREF)
unnamed: R27.1, R28.1, U11.F4 (OVP)
unnamed: C32.1, R26.2, U11.G4 (VIN)
unnamed: R21.2, U13.9 (SEL)
unnamed: R20.2, U13.2 (~OE)
unnamed: TP6.1, U14.11 (LOM)
unnamed: C50.1, FB5.1, U14.5 (PLLA1)
unnamed: C50.2, U14.6 (PLLA2)
unnamed: C51.2, FB6.2, U14.15 (PLLB1)
unnamed: C51.1, U14.16 (PLLB2)
unnamed: R43.1, U14.20 (TEST0)
unnamed: TP4.1, U14.7 (TSC)
unnamed: TP5.1, U14.10 (TSI)
unnamed: R42.1, U15.3 (EN)
RP_FUSB_INT: TP3.1, U8.5 (INT_N)
RP_SCL0: J8.7, U8.6 (SCL), U9.15 (SCL)
RP_SDA0: J8.6, U8.7 (SDA), U9.16 (SDA)
SBU_N: J4.B8 (SBU2), R45.2
SBU_P: J4.A8 (SBU1), R46.2
SDC_CMD: J2.3 (CMD), U3.20 (B1)
SDC_D0: J2.7 (DAT0), U3.15 (B5)
SDC_D1: J2.8 (DAT1), U3.16 (B4)
SDC_D2: J2.1 (DAT2), U3.17 (B3)
SDC_D3: J2.2 (DAT3/CD), U3.18 (B2)
SD_CLK: J9.8, U4.3 (A)
SD_CMD: J9.6, U3.1 (A1)
SD_D0: J9.2, U3.6 (A5)
SD_D1: J9.3, U3.5 (A4)
SD_D2: J9.4, U3.4 (A3)
SD_D3: J9.5, U3.3 (A2)
SD_DET: J2.9 (DET_B), J9.9, R16.2
STANDBY_3V3: C37.2, C45.1, J8.5, R22.2, R30.1, R31.1, R32.1, R33.1, R36.1, U8.3 (VDD), U8.4 (VDD), U9.14 (VDD)
USB1_DN: J4.A7 (D-), J4.B7 (D-), J7.1, U5.4 (IO3), U5.7 (IO3)
USB1_DP: J4.A6 (D+), J4.B6 (D+), J7.2, U5.5 (IO4), U5.6 (IO4)
USB1_RE_RXN: U13.3 (A0_P), U14.3 (SDAIN)
USB1_RE_RXP: U13.4 (A0_N), U14.2 (SDAIP)
USB1_RE_TXN: C57.1, U13.7 (A1_P)
USB1_RE_TXP: C56.1, U13.8 (A1_N)
USB1_RXN: C59.2, J7.7
USB1_RXP: C58.2, J7.8
USB1_TXN: J7.4, U14.13 (SDBIN)
USB1_TXP: J7.5, U14.12 (SDBIP)
USB_A_RXN: J4.A10 (RX2-), U7.4 (IO3), U7.7 (IO3), U13.18 (B0_N)
USB_A_RXP: J4.A11 (RX2+), U7.5 (IO4), U7.6 (IO4), U13.19 (B0_P)
USB_A_TXN: C34.2, U13.16 (B1_N)
USB_A_TXP: C36.2, U13.17 (B1_P)
USB_B_RXN: J4.B10 (RX1-), U6.1 (IO1), U6.10 (IO1), U13.15 (C0_P)
USB_B_RXP: J4.B11 (RX1+), U6.2 (IO2), U6.9 (IO2), U13.14 (C0_N)
USB_B_TXN: C33.2, U13.13 (C1_P)
USB_B_TXP: C35.2, U13.12 (C1_N)
USB_MUX_DIR: R21.1, U9.7 (IO2)
USB_SINK_EN: R19.1, U9.4 (IO0), U11.G1 (EN0)
USB_SRC_EN: U9.5 (IO1), U11.A3 (EN1)
USB_VBUS: C39.1, J4.A4 (VBUS), J4.A9 (VBUS), J4.B4 (VBUS), J4.B9 (VBUS), R27.2, U8.2 (VBUS), U11.A2 (VBUS), U11.B2 (VBUS), U11.B3 (VBUS), U11.C2 (VBUS), U11.C3 (VBUS), U11.D2 (VBUS), U11.D3 (VBUS), U11.E2 (VBUS), U11.E3 (VBUS), U11.F2 (VBUS), U11.F3 (VBUS), U11.G2 (VBUS)
VCC: C47.1, J8.1, J8.2, U10.3 (VIN)
VPD: C40.1, J8.3, J8.4, U11.B1 (PPHV), U11.C1 (PPHV), U11.D1 (PPHV), U11.E1 (PPHV), U11.F1 (PPHV)
~USB_FAULT: U9.9 (IO4), U11.A1 (~FLT)
~USB_MUX_OE: R20.1, U9.8 (IO3)

Notes on the sheet:
1Gb Ethernet
required to start the mechanism
"In single-lane mode, only the differential pairs closest to the CC pin are used for data transmission"
TODO: 5v on 66021! (3v3 on 66020)
Power from USB-C PD
B10
Includes ESD protection
- if SEL low: Port A to Port B - if SEL high: Port A to Port C
GPIO bank controlled via I2C by System Controller
Standby Shutdown Switch
or: Heling MT24-S1T1
NOTE: These +5V are currently unused
USB-C port 1 with PD charging
Local 5V for USB devices and speaker
1GBe to motherboard
B11
1.25mm pitch Molex Picoblade
- if SEL high
Ring 1
Useful for UART passthrough or DP AUX
Audio
To/From USB-C connector
Sleeve
P0 is open drain
USB-C Data Mux
GNDA area
SD VCC
fixed: swapped SRC and SINK EN
TODO: currently not connected
SD Card
USB-C PD Power Mux
A10
Headset jack CTIA
Tip
- if CC2 is pulled down: cable flipped - if CC1 is pulled down: cable unflipped
Power Interface (not flipped)
Ring 2
pol. swapped on purpose!
Sysctl GPIO Bank
I2S Audio
fixed: wrong pinout/footprint (tssop vs qfn)
I2C control bus
To charger on motherboard (SINK)
MicroSD Slot
System power (from motherboard)
USB 3 Redriver
A11
Level Shifter
- if SEL low
USB3 to port farm 1
ix Industrial 10B-1

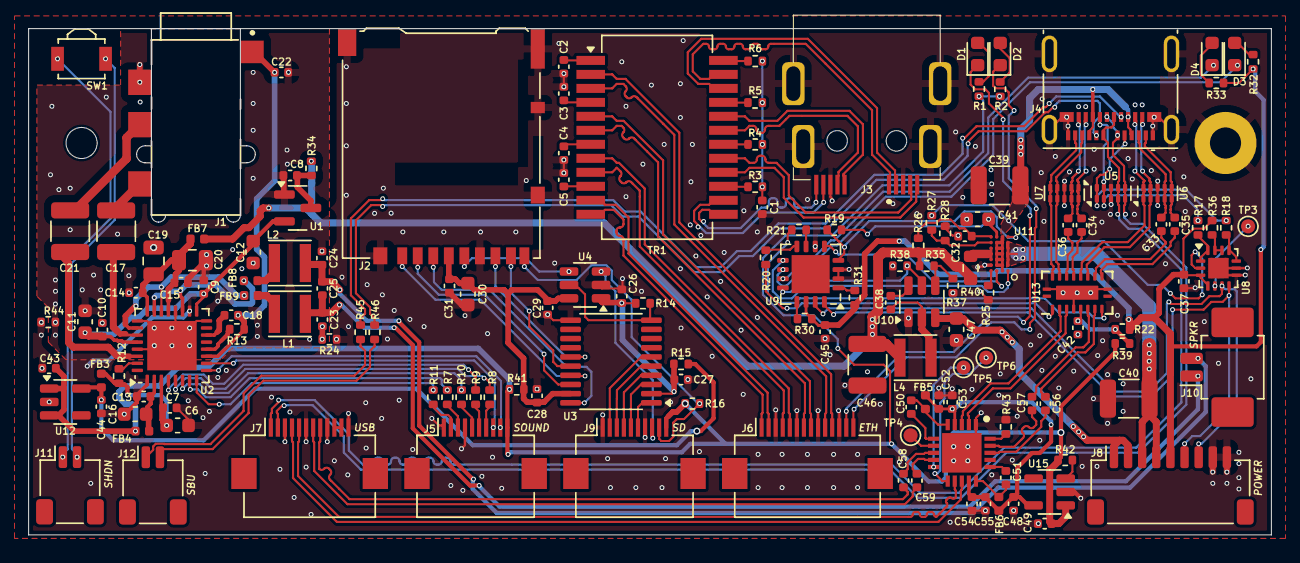
[picture p181: board nref-ports-one.kicad_pcb from above]

Board: 4 copper layers, 88.0 x 35.8 mm, 153 parts (1 on the bottom side), 159 nets.
