cetola/reform-next-mirror/nref-ports-two/nref-ports-two.kicad_pcb

## KiCad design nref-ports-two/nref-ports-two.kicad_pcb (2026-09-02)

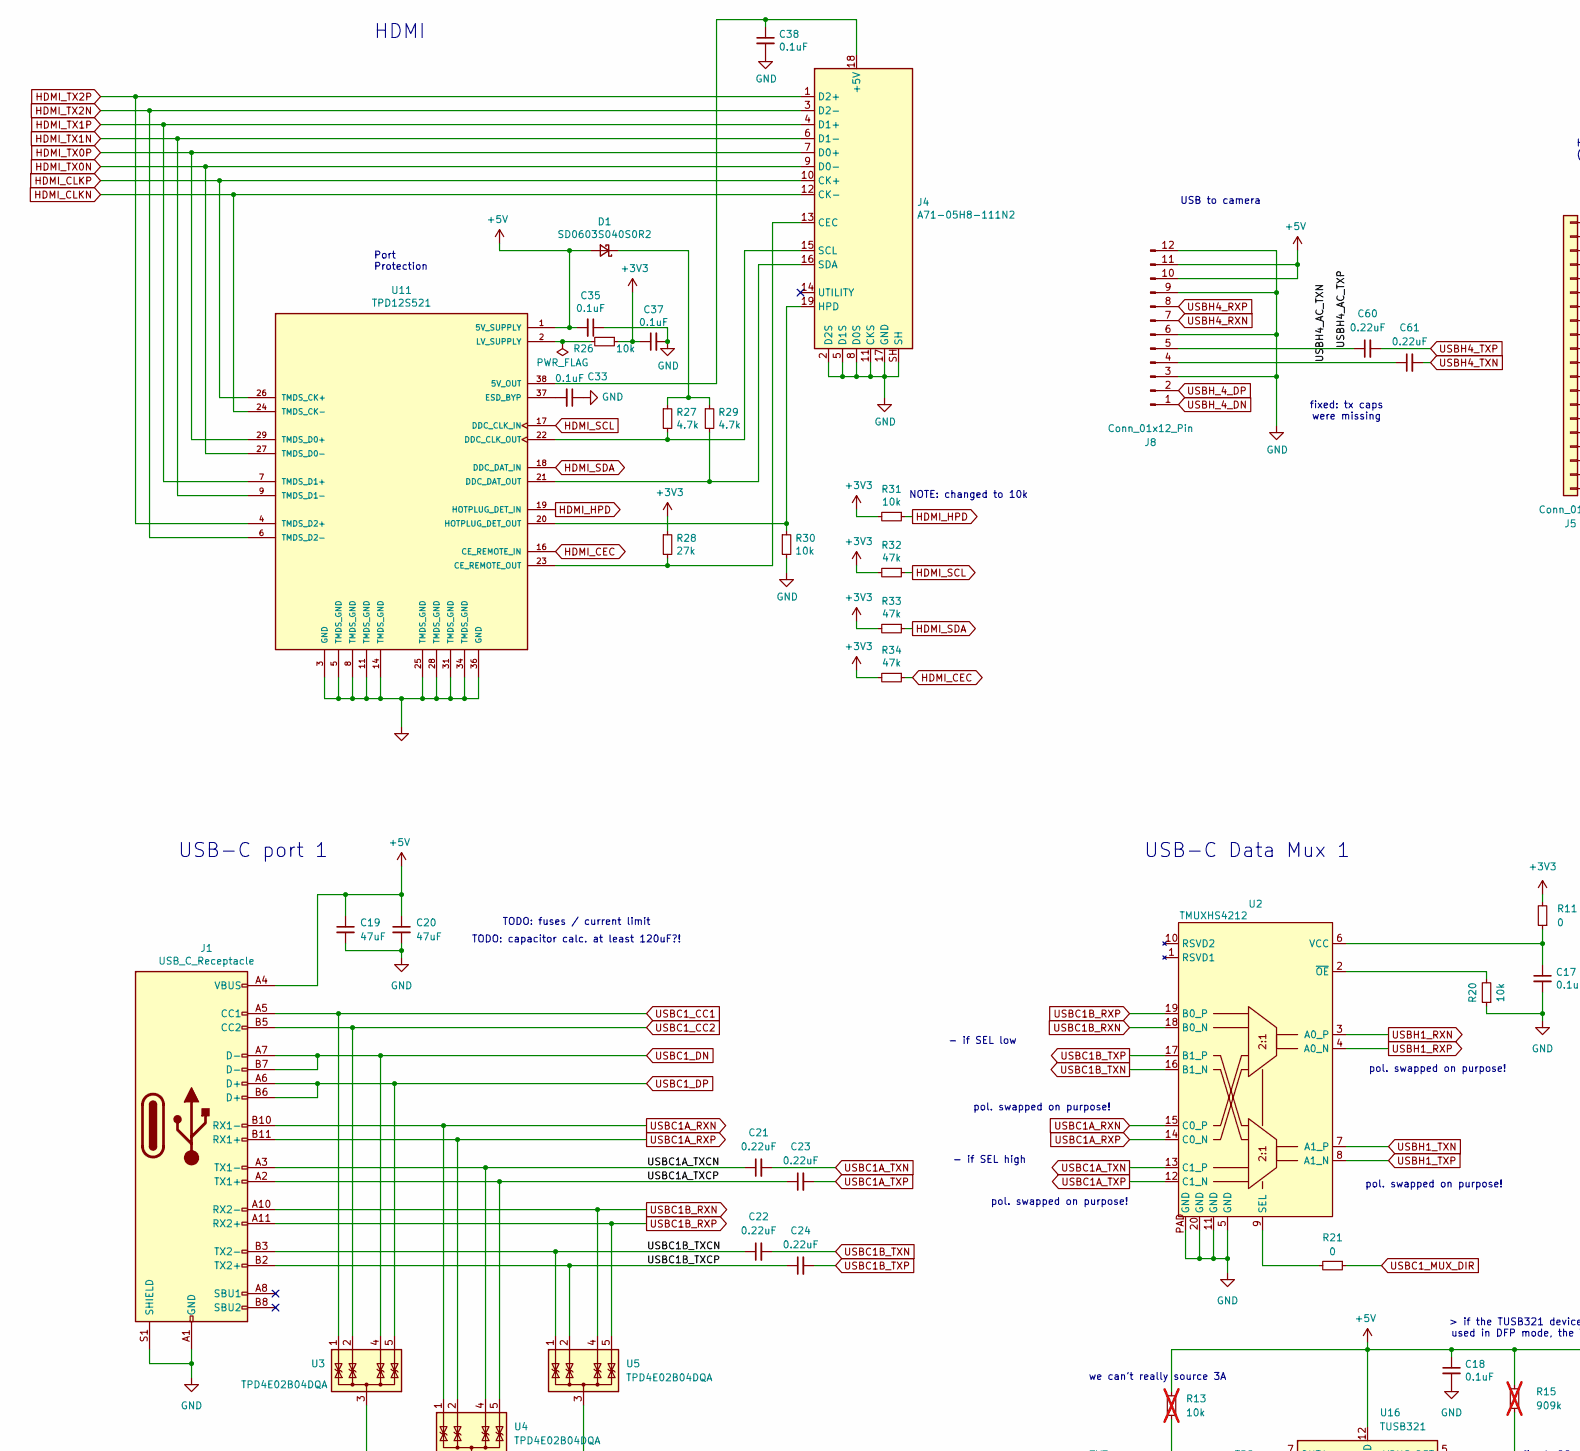
[picture p182: schematic nref-ports-two.kicad_sch, MNT Reform Next Port Board Two, part in row 1, column 1]

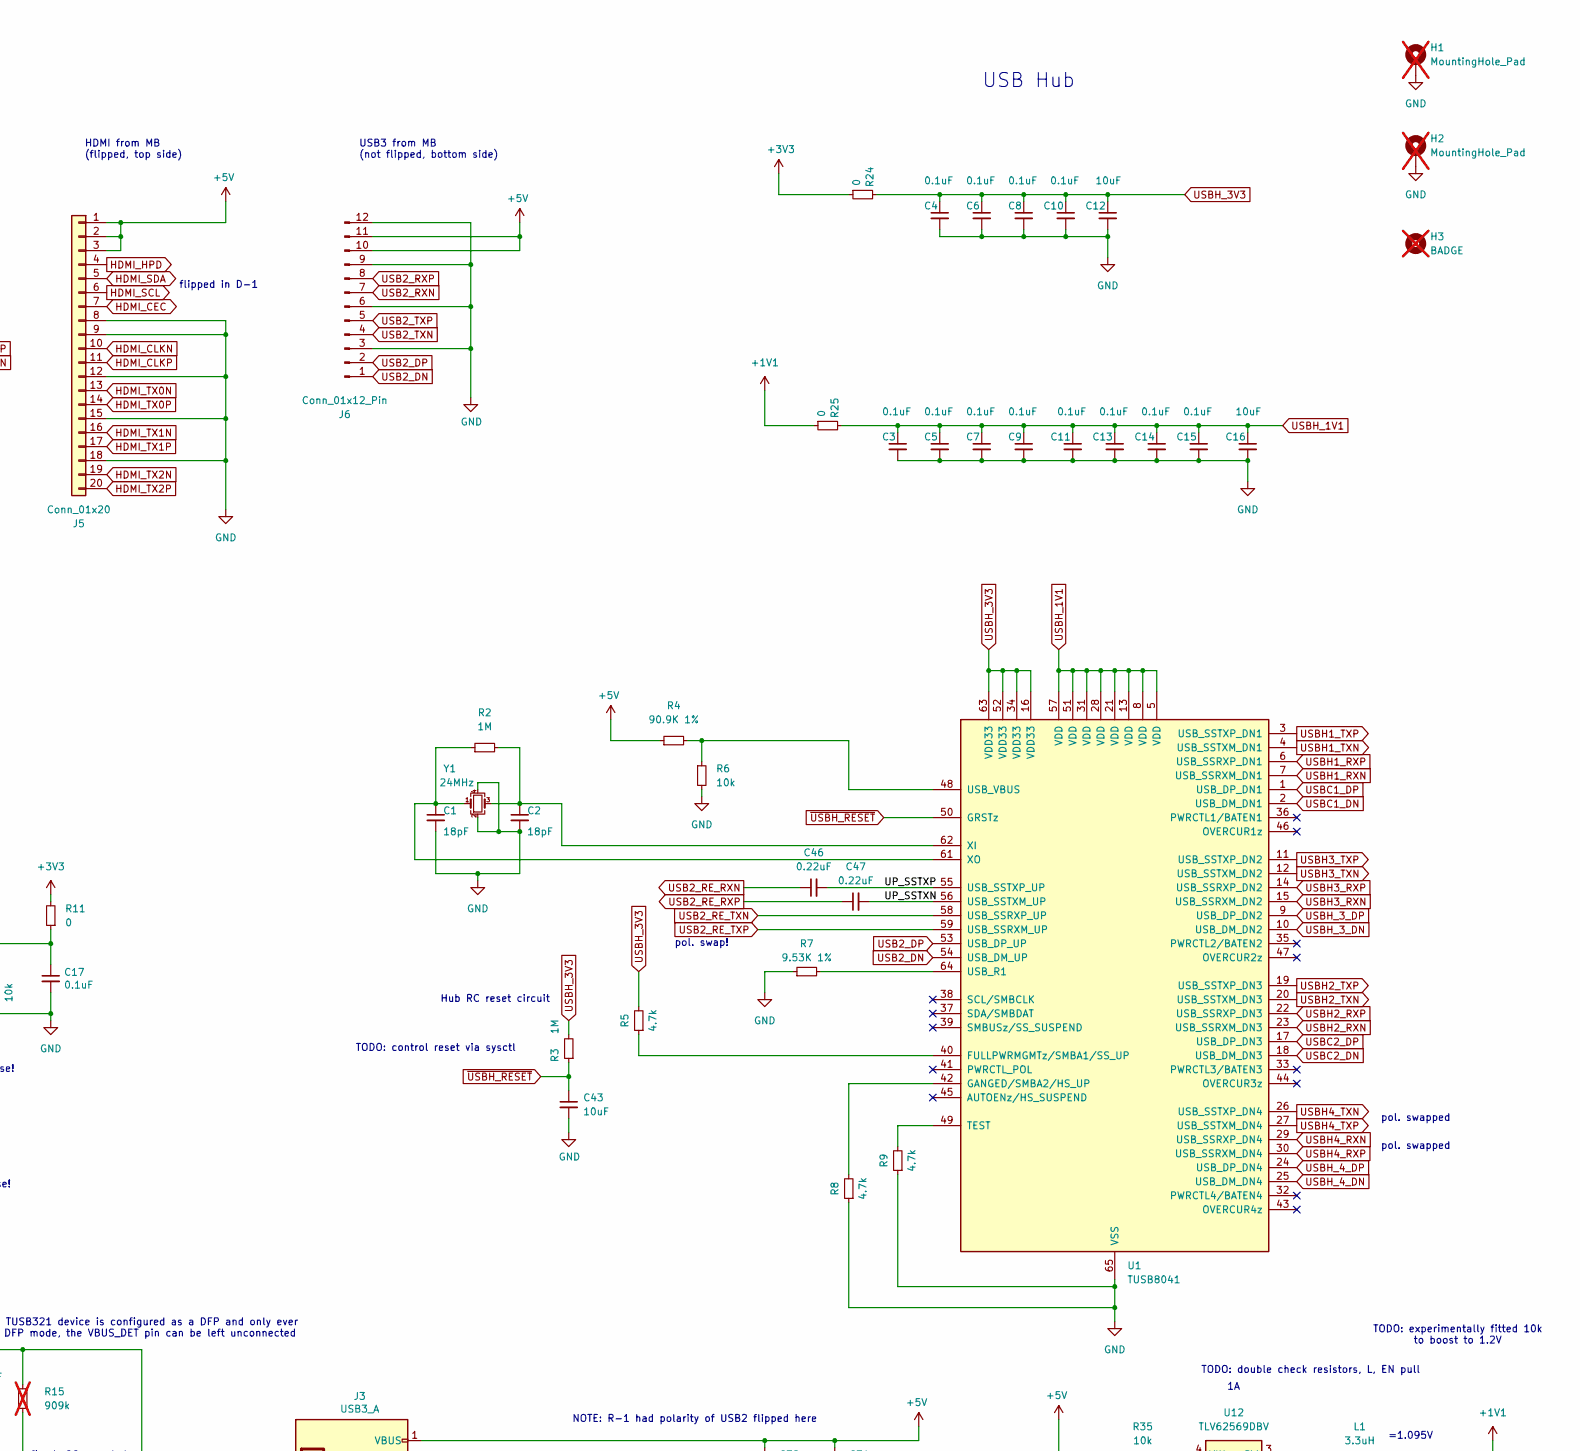
[picture p183: schematic nref-ports-two.kicad_sch, MNT Reform Next Port Board Two, part in row 1, column 2]

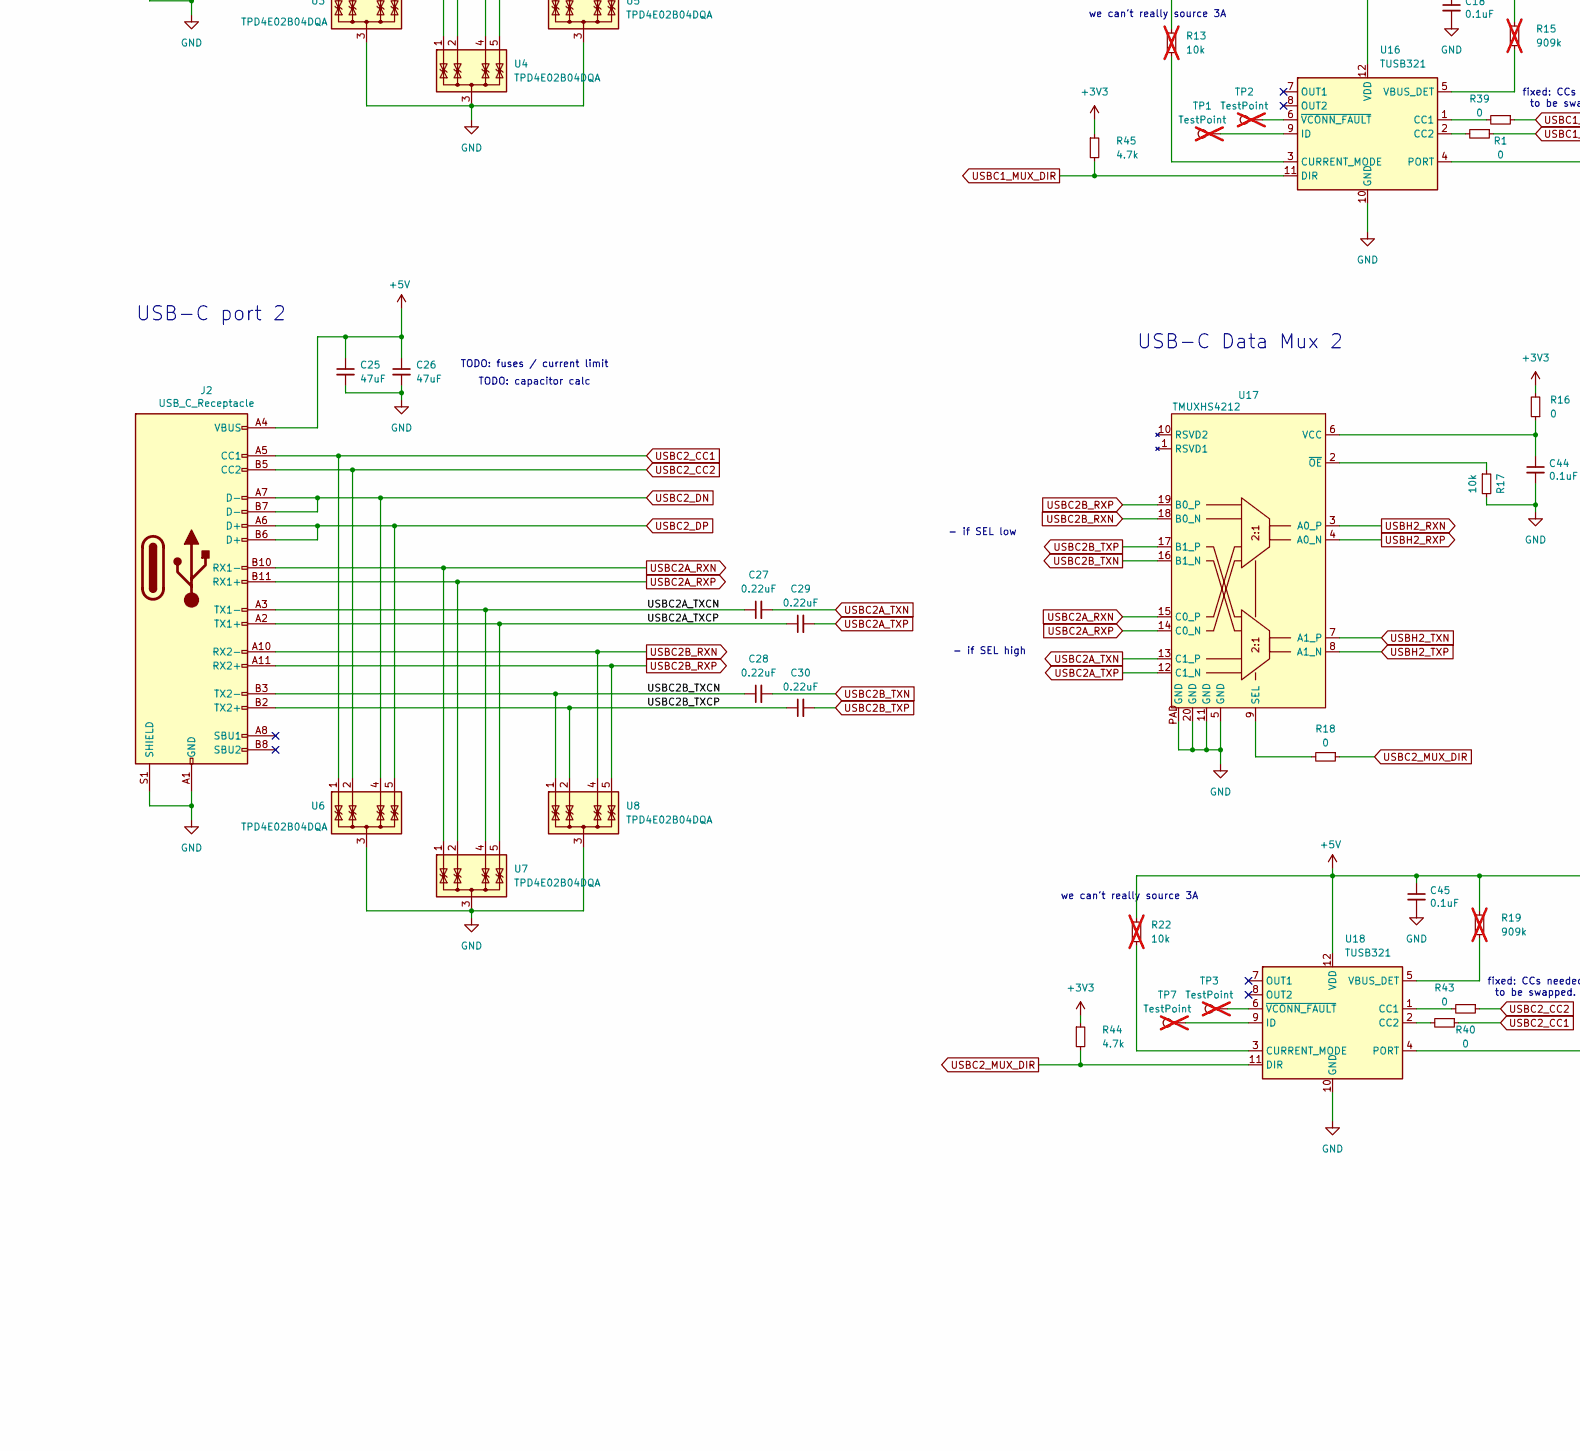
[picture p184: schematic nref-ports-two.kicad_sch, MNT Reform Next Port Board Two, part in row 2, column 1]

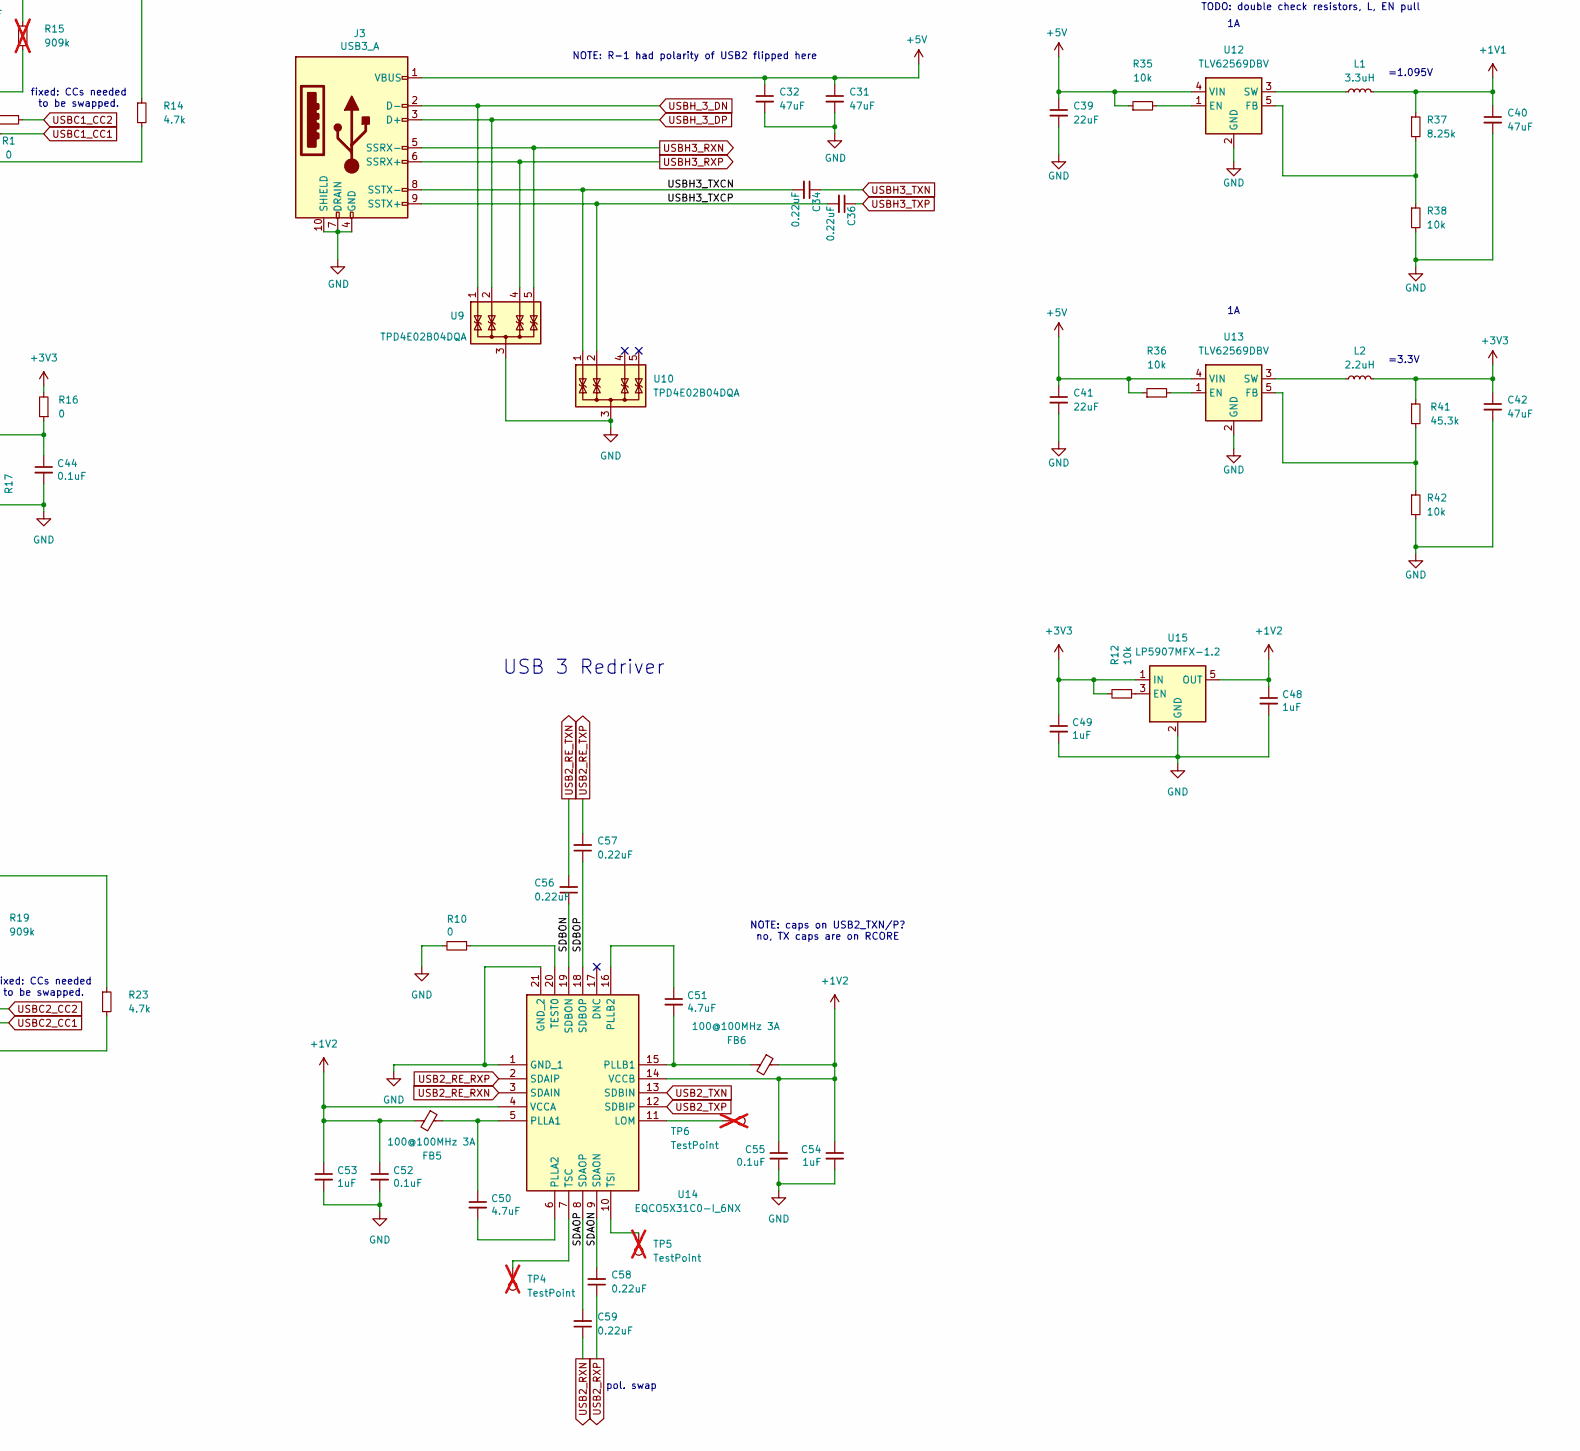
[picture p185: schematic nref-ports-two.kicad_sch, MNT Reform Next Port Board Two, part in row 2, column 2]

Parts:
C1, C2: 18pF; C_0402_1005Metric; LCSC C1549
C3, C4, C5, C6, C7, C8, C9, C10, C11, C13, C14, C15, C17, C18, C33, C35, C37, C38, C44, C45, C52, C55: 0.1uF; C_0402_1005Metric; LCSC C1525
C12, C16, C43: 10uF; C_0603_1608Metric; LCSC C96446
C19, C20, C25, C26, C31, C32, C40, C42: 47uF; C_1206_3216Metric; LCSC C96123
C21, C22, C23, C24, C27, C28, C29, C30, C34, C36, C46, C47, C56, C57, C58, C59, C60, C61: 0.22uF; C_0402_1005Metric; LCSC C16772
C39, C41: 22uF; C_0603_1608Metric; LCSC C59461
C48, C49, C53, C54: 1uF; C_0402_1005Metric; LCSC C52923
C50, C51: 4.7uF; C_0402_1005Metric; LCSC C23733
D1: SD0603S040S0R2; D_0603_1608Metric; LCSC C143772
FB5, FB6: 100@100MHz 3A; L_0402_1005Metric; LCSC C124089
H1, H2: MountingHole_Pad; MountingHole_2.2mm_M2_Pad; not fitted
H3: BADGE; nref-ports-two-badge; not fitted
J1, J2: USB_C_Receptacle; USB_C_Receptacle_Molex_105450-0101; LCSC C134092
J3: USB3_A; USB-A-SMD_HC-USB3.0-C225-P; LCSC C7501855
J4: A71-05H8-111N2; HDMI-TH_A71-05H8-111N2; LCSC C2880638
J5: Conn_01x20; FPC-SMD_AFC07-S20ECC-00; LCSC C11090
J6, J8: Conn_01x12_Pin; Hirose_FH12-12S-0.5SH_1x12-1MP_P0.50mm_Horizontal; LCSC C262661
L1: 3.3uH; L_1210_3225Metric; LCSC C29780744
L2: 2.2uH; L_1210_3225Metric; LCSC C5832378
R1, R10, R11, R16, R18, R21, R24, R25, R39, R40, R43: 0; R_0402_1005Metric; LCSC C17168
R2, R3: 1M; R_0402_1005Metric; LCSC C26083
R4: 90.9K 1%; R_0402_1005Metric; LCSC C163452
R5, R8, R9, R14, R23, R27, R29, R44, R45: 4.7k; R_0402_1005Metric; LCSC C25900
R6, R12, R17, R20, R26, R30, R31, R35, R36, R38, R42: 10k; R_0402_1005Metric; LCSC C25744
R7: 9.53K 1%; R_0402_1005Metric; LCSC C96273
R13, R22: 10k; R_0402_1005Metric; LCSC C25744; not fitted
R15, R19: 909k; R_0402_1005Metric; LCSC C25799; not fitted
R28: 27k; R_0402_1005Metric; LCSC C25771
R32, R33, R34: 47k; R_0402_1005Metric; LCSC C25792
R37: 8.25k; R_0402_1005Metric; LCSC C5126132
R41: 45.3k; R_0402_1005Metric; LCSC C2933099
TP1, TP2, TP3, TP4, TP5, TP6, TP7: TestPoint; TestPoint_Pad_D1.0mm; not fitted
U1: TUSB8041; QFN-64-1EP_9x9mm_P0.5mm_EP6x6mm_ThermalVias; LCSC C544686
U2, U17: TMUXHS4212; Texas-VQFN20_2.5x4.5mm_RKS; LCSC C2869871
U3, U4, U5, U6, U7, U8, U9, U10: TPD4E02B04DQA; USON-10_2.5x1.0mm_P0.5mm; LCSC C2841426
U11: TPD12S521; TSSOP50P640X120-38N; LCSC C126920
U12, U13: TLV62569DBV; SOT-23-5; LCSC C141836
U14: EQCO5X31C0-I_6NX; QFN50P400X400X100-21N-D; LCSC C19729370
U15: LP5907MFX-1.2; SOT-23-5; LCSC C73478
U16, U18: TUSB321; Texas_X2QFN-12_1.6x1.6mm_P0.4mm; LCSC C2674046
Y1: 24MHz; Crystal_SMD_Abracon_ABM8G-4Pin_3.2x2.5mm; LCSC C91744

Connections:
+1V1: C40.1, L1.2, R25.1, R37.1
+1V2: C48.1, C52.1, C53.1, C54.1, C55.1, FB5.2, FB6.1, U14.4 (VCCA), U14.14 (VCCB), U15.5 (OUT)
+3V3: C37.1, C42.1, C49.1, L2.2, R11.2, R12.2, R16.2, R24.1, R26.1, R28.1, R31.2, R32.2, R33.2, R34.2, R41.1, R44.1, R45.1, U15.1 (IN)
+5V: C18.1, C19.1, C20.1, C25.1, C26.1, C31.1, C32.1, C35.2, C39.1, C41.1, C45.1, D1.2 (A), J1.A4 (VBUS), J1.A9 (VBUS), J1.B4 (VBUS), J1.B9 (VBUS), J2.A4 (VBUS), J2.A9 (VBUS), J2.B4 (VBUS), J2.B9 (VBUS), J3.1 (VBUS), J5.1, J5.2, J5.3, J6.10, J6.11, J8.10, J8.11, R4.1, R13.1, R14.1, R15.1, R19.1, R22.1, R23.1, R35.1, R36.1, U11.1 (5V_SUPPLY), U12.4 (VIN), U13.4 (VIN), U16.12 (VDD), U18.12 (VDD)
/SDAON: C58.2, U14.9 (SDAON)
/SDAOP: C59.2, U14.8 (SDAOP)
/SDBON: C56.1, U14.19 (SDBON)
/SDBOP: C57.1, U14.18 (SDBOP)
/UP_SSTXN: C47.2, U1.56 (USB_SSTXM_UP)
/UP_SSTXP: C46.2, U1.55 (USB_SSTXP_UP)
/USBC1A_TXCN: C21.1, J1.A3 (TX1-), U4.4 (IO3), U4.7 (IO3)
/USBC1A_TXCP: C23.1, J1.A2 (TX1+), U4.5 (IO4), U4.6 (IO4)
/USBC1B_TXCN: C22.1, J1.B3 (TX2-), U5.1 (IO1), U5.10 (IO1)
/USBC1B_TXCP: C24.1, J1.B2 (TX2+), U5.2 (IO2), U5.9 (IO2)
/USBC2A_TXCN: C27.1, J2.A3 (TX1-), U7.4 (IO3), U7.7 (IO3)
/USBC2A_TXCP: C29.1, J2.A2 (TX1+), U7.5 (IO4), U7.6 (IO4)
/USBC2B_TXCN: C28.1, J2.B3 (TX2-), U8.1 (IO1), U8.10 (IO1)
/USBC2B_TXCP: C30.1, J2.B2 (TX2+), U8.2 (IO2), U8.9 (IO2)
/USBH3_TXCN: C34.2, J3.8 (SSTX-), U10.1 (IO1), U10.10 (IO1)
/USBH3_TXCP: C36.2, J3.9 (SSTX+), U10.2 (IO2), U10.9 (IO2)
/USBH4_AC_TXN: C61.1, J8.4
/USBH4_AC_TXP: C60.1, J8.5
GND: C1.2, C2.2, C3.2, C4.2, C5.2, C6.2, C7.2, C8.2, C9.2, C10.2, C11.2, C12.2, C13.2, C14.2, C15.2, C16.2, C17.2, C18.2, C19.2, C20.2, C25.2, C26.2, C31.2, C32.2, C33.1, C35.1, C37.2, C38.2, C39.2, C40.2, C41.2, C42.2, C43.2, C44.2, C45.2, C48.2, C49.2, C52.2, C53.2, C54.2, C55.2, H1.1 (1_1), H2.1 (1_1), J1.A1 (GND), J1.A12 (GND), J1.B1 (GND), J1.B12 (GND), J1.S1 (SHIELD), J2.A1 (GND), J2.A12 (GND), J2.B1 (GND), J2.B12 (GND), J2.S1 (SHIELD), J3.4 (GND), J3.7 (DRAIN), J3.10 (SHIELD), J4.2 (D2S), J4.5 (D1S), J4.8 (D0S), J4.11 (CKS), J4.17 (GND), J4.SH, J5.8, J5.9, J5.12, J5.15, J5.18, J6.3, J6.6, J6.9, J6.12, J8.3, J8.6, J8.9, J8.12, R6.2, R7.1, R8.1, R9.1, R10.2, R17.2, R20.1, R30.2, R38.2, R42.2, U1.65 (VSS), U2.5 (GND), U2.11 (GND), U2.20 (GND), U2.PAD (GND), U3.3 (G), U3.8 (G), U4.3 (G), U4.8 (G), U5.3 (G), U5.8 (G), U6.3 (G), U6.8 (G), U7.3 (G), U7.8 (G), U8.3 (G), U8.8 (G), U9.3 (G), U9.8 (G), U10.3 (G), U10.8 (G), U11.3 (GND), U11.5 (TMDS_GND), U11.8 (TMDS_GND), U11.11 (TMDS_GND), U11.14 (TMDS_GND), U11.25 (TMDS_GND), U11.28 (TMDS_GND), U11.31 (TMDS_GND), U11.34 (TMDS_GND), U11.36 (GND), U12.2 (GND), U13.2 (GND), U14.1 (GND_1), U14.21 (GND_2), U15.2 (GND), U16.10 (GND), U17.5 (GND), U17.11 (GND), U17.20 (GND), U17.PAD (GND), U18.10 (GND), Y1.2, Y1.4
HDMI_CEC: J5.7, R34.1, U11.16 (CE_REMOTE_IN)
HDMI_CLKN: J4.12 (CK-), J5.10, U11.15 (TMDS_CK-), U11.24 (TMDS_CK-)
HDMI_CLKP: J4.10 (CK+), J5.11, U11.13 (TMDS_CK+), U11.26 (TMDS_CK+)
HDMI_HPD: J5.4, R31.1, U11.19 (HOTPLUG_DET_IN)
HDMI_SCL: J5.6, R32.1, U11.17 (DDC_CLK_IN)
HDMI_SDA: J5.5, R33.1, U11.18 (DDC_DAT_IN)
HDMI_TX0N: J4.9 (D0-), J5.13, U11.12 (TMDS_D0-), U11.27 (TMDS_D0-)
HDMI_TX0P: J4.7 (D0+), J5.14, U11.10 (TMDS_D0+), U11.29 (TMDS_D0+)
HDMI_TX1N: J4.6 (D1-), J5.16, U11.9 (TMDS_D1-), U11.30 (TMDS_D1-)
HDMI_TX1P: J4.4 (D1+), J5.17, U11.7 (TMDS_D1+), U11.32 (TMDS_D1+)
HDMI_TX2N: J4.3 (D2-), J5.19, U11.6 (TMDS_D2-), U11.33 (TMDS_D2-)
HDMI_TX2P: J4.1 (D2+), J5.20, U11.4 (TMDS_D2+), U11.35 (TMDS_D2+)
unnamed: D1.1 (K), R27.1, R29.1
unnamed: C38.1, J4.18 (+5V), U11.38 (5V_OUT)
unnamed: J4.13 (CEC), R28.2, U11.23 (CE_REMOTE_OUT)
unnamed: J4.19 (HPD), R30.1, U11.20 (HOTPLUG_DET_OUT)
unnamed: J4.15 (SCL), R27.2, U11.22 (DDC_CLK_OUT)
unnamed: J4.16 (SDA), R29.2, U11.21 (DDC_DAT_OUT)
unnamed: R5.1, U1.40 (FULLPWRMGMTz/SMBA1/SS_UP)
unnamed: R8.2, U1.42 (GANGED/SMBA2/HS_UP)
unnamed: R9.2, U1.49 (TEST)
unnamed: R7.2, U1.64 (USB_R1)
unnamed: R4.2, R6.1, U1.48 (USB_VBUS)
unnamed: C2.1, R2.2, U1.62 (XI), Y1.3
unnamed: C1.1, R2.1, U1.61 (XO), Y1.1
unnamed: R21.2, U2.9 (SEL)
unnamed: C17.1, R11.1, U2.6 (VCC)
unnamed: R20.2, U2.2 (~OE)
unnamed: C33.2, U11.37 (ESD_BYP)
unnamed: R26.2, U11.2 (LV_SUPPLY)
unnamed: R35.2, U12.1 (EN)
unnamed: R37.2, R38.1, U12.5 (FB)
unnamed: L1.1, U12.3 (SW)
unnamed: R36.2, U13.1 (EN)
unnamed: R41.2, R42.1, U13.5 (FB)
unnamed: L2.1, U13.3 (SW)
unnamed: TP6.1 (1_1), U14.11 (LOM)
unnamed: C50.1, FB5.1, U14.5 (PLLA1)
unnamed: C50.2, U14.6 (PLLA2)
unnamed: C51.2, FB6.2, U14.15 (PLLB1)
unnamed: C51.1, U14.16 (PLLB2)
unnamed: R10.1, U14.20 (TEST0)
unnamed: TP4.1 (1_1), U14.7 (TSC)
unnamed: TP5.1 (1_1), U14.10 (TSI)
unnamed: R12.1, U15.3 (EN)
unnamed: R1.2, U16.1 (CC1)
unnamed: R39.2, U16.2 (CC2)
unnamed: R13.2, U16.3 (CURRENT_MODE)
unnamed: TP1.1 (1_1), U16.9 (ID)
unnamed: R14.2, U16.4 (PORT)
unnamed: R15.2, U16.5 (VBUS_DET)
unnamed: TP2.1 (1_1), U16.6 (~VCONN_FAULT)
unnamed: R18.2, U17.9 (SEL)
unnamed: C44.1, R16.1, U17.6 (VCC)
unnamed: R17.1, U17.2 (~OE)
unnamed: R40.2, U18.1 (CC1)
unnamed: R43.2, U18.2 (CC2)
unnamed: R22.2, U18.3 (CURRENT_MODE)
unnamed: TP7.1 (1_1), U18.9 (ID)
unnamed: R23.2, U18.4 (PORT)
unnamed: R19.2, U18.5 (VBUS_DET)
unnamed: TP3.1 (1_1), U18.6 (~VCONN_FAULT)
USB2_DN: J6.1, U1.54 (USB_DM_UP)
USB2_DP: J6.2, U1.53 (USB_DP_UP)
USB2_RE_RXN: C46.1, U14.3 (SDAIN)
USB2_RE_RXP: C47.1, U14.2 (SDAIP)
USB2_RE_TXN: C56.2, U1.58 (USB_SSRXP_UP)
USB2_RE_TXP: C57.2, U1.59 (USB_SSRXM_UP)
USB2_RXN: C59.1, J6.7
USB2_RXP: C58.1, J6.8
USB2_TXN: J6.4, U14.13 (SDBIN)
USB2_TXP: J6.5, U14.12 (SDBIP)
USBC1A_RXN: J1.B10 (RX1-), U2.15 (C0_P), U4.1 (IO1), U4.10 (IO1)
USBC1A_RXP: J1.B11 (RX1+), U2.14 (C0_N), U4.2 (IO2), U4.9 (IO2)
USBC1A_TXN: C21.2, U2.13 (C1_P)
USBC1A_TXP: C23.2, U2.12 (C1_N)
USBC1B_RXN: J1.A10 (RX2-), U2.18 (B0_N), U5.4 (IO3), U5.7 (IO3)
USBC1B_RXP: J1.A11 (RX2+), U2.19 (B0_P), U5.5 (IO4), U5.6 (IO4)
USBC1B_TXN: C22.2, U2.16 (B1_N)
USBC1B_TXP: C24.2, U2.17 (B1_P)
USBC1_CC1: J1.A5 (CC1), R39.1, U3.1 (IO1), U3.10 (IO1)
USBC1_CC2: J1.B5 (CC2), R1.1, U3.2 (IO2), U3.9 (IO2)
USBC1_DN: J1.A7 (D-), J1.B7 (D-), U1.2 (USB_DM_DN1), U3.4 (IO3), U3.7 (IO3)
USBC1_DP: J1.A6 (D+), J1.B6 (D+), U1.1 (USB_DP_DN1), U3.5 (IO4), U3.6 (IO4)
USBC1_MUX_DIR: R21.1, R45.2, U16.11 (DIR)
USBC2A_RXN: J2.B10 (RX1-), U7.1 (IO1), U7.10 (IO1), U17.15 (C0_P)
USBC2A_RXP: J2.B11 (RX1+), U7.2 (IO2), U7.9 (IO2), U17.14 (C0_N)
USBC2A_TXN: C27.2, U17.13 (C1_P)
USBC2A_TXP: C29.2, U17.12 (C1_N)
USBC2B_RXN: J2.A10 (RX2-), U8.4 (IO3), U8.7 (IO3), U17.18 (B0_N)
USBC2B_RXP: J2.A11 (RX2+), U8.5 (IO4), U8.6 (IO4), U17.19 (B0_P)
USBC2B_TXN: C28.2, U17.16 (B1_N)
USBC2B_TXP: C30.2, U17.17 (B1_P)
USBC2_CC1: J2.A5 (CC1), R43.1, U6.1 (IO1), U6.10 (IO1)
USBC2_CC2: J2.B5 (CC2), R40.1, U6.2 (IO2), U6.9 (IO2)
USBC2_DN: J2.A7 (D-), J2.B7 (D-), U1.18 (USB_DM_DN3), U6.4 (IO3), U6.7 (IO3)
USBC2_DP: J2.A6 (D+), J2.B6 (D+), U1.17 (USB_DP_DN3), U6.5 (IO4), U6.6 (IO4)
USBC2_MUX_DIR: R18.1, R44.2, U18.11 (DIR)
USBH1_RXN: U1.7 (USB_SSRXM_DN1), U2.3 (A0_P)
USBH1_RXP: U1.6 (USB_SSRXP_DN1), U2.4 (A0_N)
USBH1_TXN: U1.4 (USB_SSTXM_DN1), U2.7 (A1_P)
USBH1_TXP: U1.3 (USB_SSTXP_DN1), U2.8 (A1_N)
USBH2_RXN: U1.23 (USB_SSRXM_DN3), U17.3 (A0_P)
USBH2_RXP: U1.22 (USB_SSRXP_DN3), U17.4 (A0_N)
USBH2_TXN: U1.20 (USB_SSTXM_DN3), U17.7 (A1_P)
USBH2_TXP: U1.19 (USB_SSTXP_DN3), U17.8 (A1_N)
USBH3_RXN: J3.5 (SSRX-), U1.15 (USB_SSRXM_DN2), U9.5 (IO4), U9.6 (IO4)
USBH3_RXP: J3.6 (SSRX+), U1.14 (USB_SSRXP_DN2), U9.4 (IO3), U9.7 (IO3)
USBH3_TXN: C34.1, U1.12 (USB_SSTXM_DN2)
USBH3_TXP: C36.1, U1.11 (USB_SSTXP_DN2)
USBH4_RXN: J8.7, U1.29 (USB_SSRXP_DN4)
USBH4_RXP: J8.8, U1.30 (USB_SSRXM_DN4)
USBH4_TXN: C61.2, U1.26 (USB_SSTXP_DN4)
USBH4_TXP: C60.2, U1.27 (USB_SSTXM_DN4)
USBH_1V1: C3.1, C5.1, C7.1, C9.1, C11.1, C13.1, C14.1, C15.1, C16.1, R25.2, U1.5 (VDD), U1.8 (VDD), U1.13 (VDD), U1.21 (VDD), U1.28 (VDD), U1.31 (VDD), U1.51 (VDD), U1.57 (VDD)
USBH_3V3: C4.1, C6.1, C8.1, C10.1, C12.1, R3.2, R5.2, R24.2, U1.16 (VDD33), U1.34 (VDD33), U1.52 (VDD33), U1.63 (VDD33)
USBH_3_DN: J3.2 (D-), U1.10 (USB_DM_DN2), U9.1 (IO1), U9.10 (IO1)
USBH_3_DP: J3.3 (D+), U1.9 (USB_DP_DN2), U9.2 (IO2), U9.9 (IO2)
USBH_4_DN: J8.1, U1.25 (USB_DM_DN4)
USBH_4_DP: J8.2, U1.24 (USB_DP_DN4)
~USBH_RESET: C43.1, R3.1, U1.50 (GRSTz)

Notes on the sheet:
TODO: fuses / current limit
USB3 from MB (not flipped, bottom side)
NOTE: caps on USB2_TXN/P? no, TX caps are on RCORE
- if SEL low
NOTE: changed to 10k
Hub RC reset circuit
pol. swapped
=1.095V
USB-C Data Mux 2
> if the TUSB321 device is configured as a DFP and only ever used in DFP mode, the VBUS_DET pin can be left unconnected
- if SEL high
fixed: CCs needed to be swapped.
=3.3V
pol. swapped on purpose!
we can't really source 3A
flipped in D-1
NOTE: R-1 had polarity of USB2 flipped here
pol. swap!
USB-C port 1
USB 3 Redriver
HDMI from MB (flipped, top side)
TODO: double check resistors, L, EN pull
USB-C Data Mux 1
TODO: control reset via sysctl
fixed: tx caps were missing
USB to camera
pol. swap
TODO: experimentally fitted 10k to boost to 1.2V
HDMI
USB-C port 2
Port Protection
USB Hub
TODO: capacitor calc. at least 120uF?!
TODO: capacitor calc

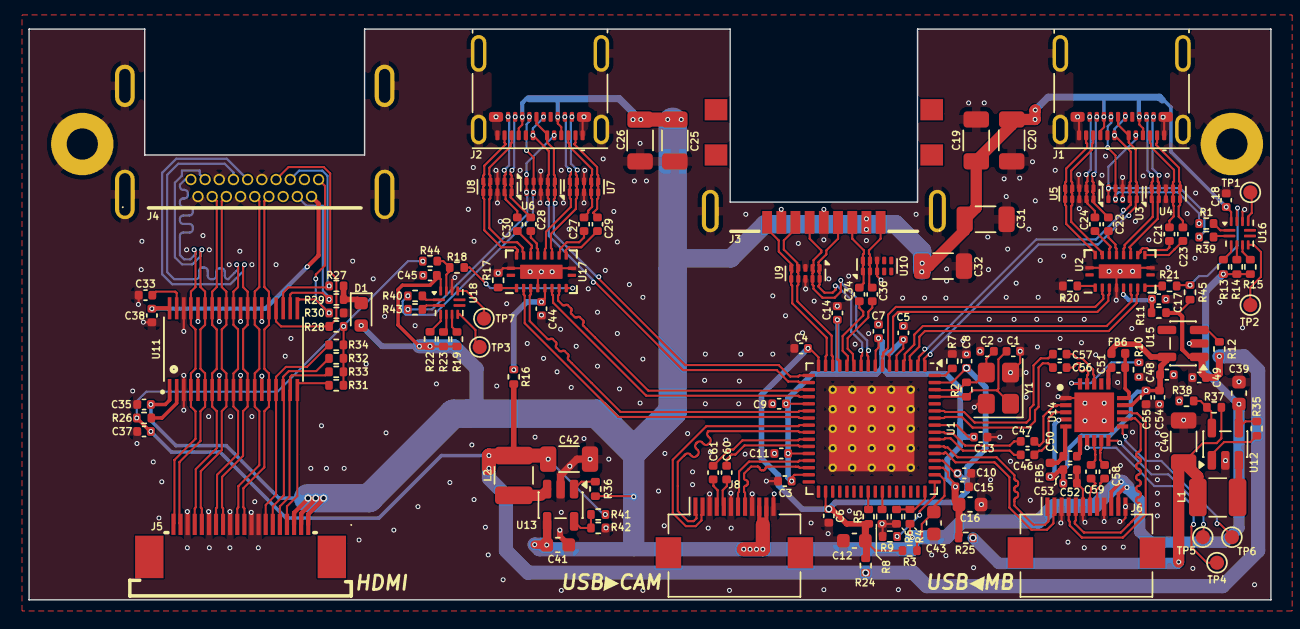
[picture p186: board nref-ports-two.kicad_pcb from above]

Board: 4 copper layers, 87.5 x 40.2 mm, 147 parts (1 on the bottom side), 144 nets.
