cetola/reform-next-mirror/nref-flex/nref-flex-hdmi/nref-flex-hdmi.kicad_pcb

## KiCad design nref-flex/nref-flex-hdmi/nref-flex-hdmi.kicad_pcb (2026-09-02)

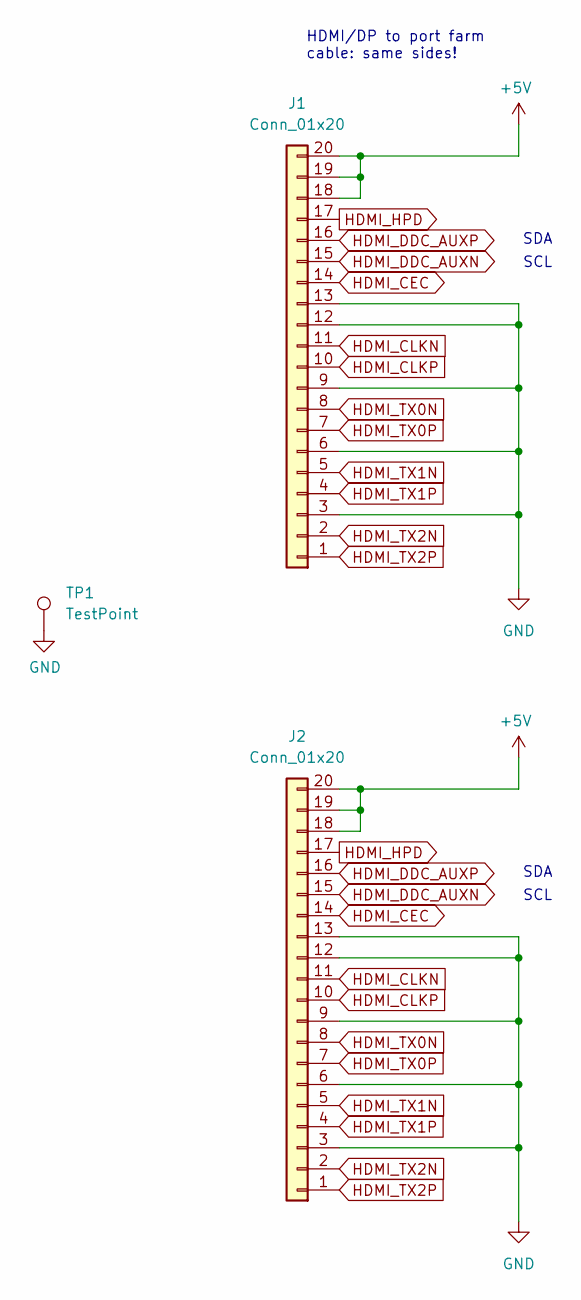
[picture p187: schematic nref-flex-hdmi.kicad_sch]

Parts:
J1, J2: Conn_01x20; Hirose_FH12-20S-0.5SH_1x20-1MP_P0.50mm_Horizontal
TP1: TestPoint; TestPoint_Pad_D1.0mm

Connections:
+5V: J1.18, J1.19, J1.20, J2.18, J2.19, J2.20
GND: J1.3, J1.6, J1.9, J1.12, J1.13, J2.3, J2.6, J2.9, J2.12, J2.13, TP1.1
HDMI_CEC: J1.14, J2.14
HDMI_CLKN: J1.11, J2.11
HDMI_CLKP: J1.10, J2.10
HDMI_DDC_AUXN: J1.15, J2.15
HDMI_DDC_AUXP: J1.16, J2.16
HDMI_HPD: J1.17, J2.17
HDMI_TX0N: J1.8, J2.8
HDMI_TX0P: J1.7, J2.7
HDMI_TX1N: J1.5, J2.5
HDMI_TX1P: J1.4, J2.4
HDMI_TX2N: J1.2, J2.2
HDMI_TX2P: J1.1, J2.1

Notes on the sheet:
SDA
SCL
HDMI/DP to port farm cable: same sides!

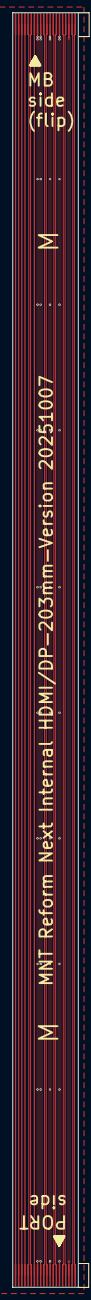
[picture p188: board nref-flex-hdmi.kicad_pcb from above]

Board: 2 copper layers, 10.5 x 203.0 mm, 3 parts (1 on the bottom side), 14 nets.
