cetola/reform-next-mirror/nref-trackpad/nref-trackpad.kicad_pcb

## KiCad design nref-trackpad/nref-trackpad.kicad_pcb (2026-05-07)

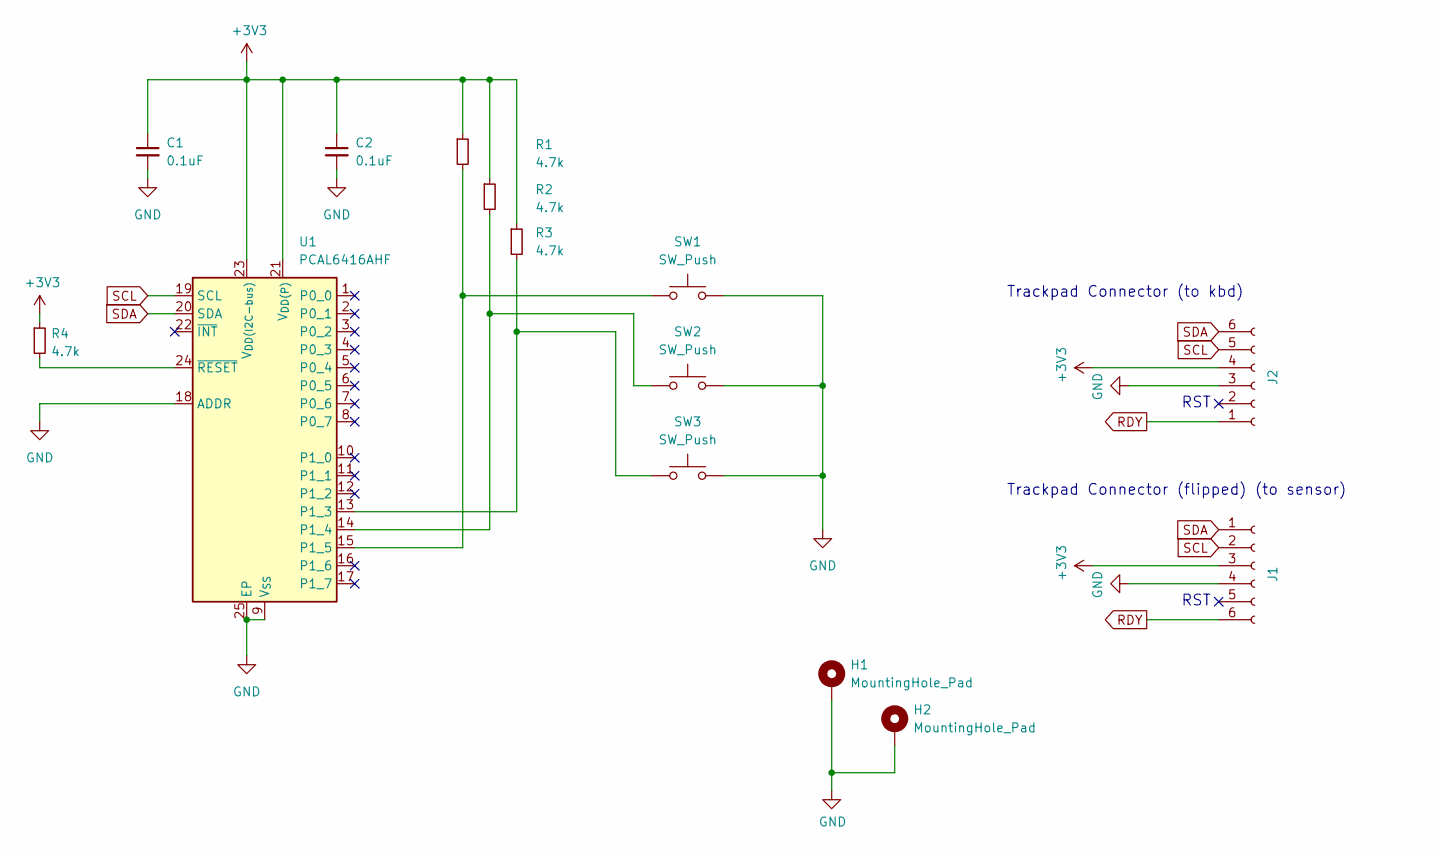
[picture p189: schematic nref-trackpad.kicad_sch]

Parts:
C1, C2: 0.1uF; C_0402_1005Metric
H1, H2: MountingHole_Pad; MountingHole_3.2mm_M3_Pad
J1, J2: Conn_01x06_Female; Hirose_FH12-6S-0.5SH_1x06-1MP_P0.50mm_Horizontal; LCSC C202118
R1, R2, R3, R4: 4.7k; R_0402_1005Metric
SW1, SW2, SW3: SW_Push; Cherry_ULP_SMD
U1: PCAL6416AHF; HVQFN-24-1EP_4x4mm_P0.5mm_EP2.1x2.1mm

Connections:
+3V3: C1.1, C2.1, J1.3, J2.4, R1.1, R2.1, R3.1, R4.1, U1.21 (V_{DD(P)}), U1.23 (V_{DD(I2C-bus)})
GND: C1.2, C2.2, H1.1, H2.1, J1.4, J2.3, SW1.2, SW2.2, SW3.2, U1.9 (V_{SS}), U1.18 (ADDR), U1.25 (EP)
unnamed: R3.2, SW3.1, U1.13 (P1_3)
unnamed: R2.2, SW2.1, U1.14 (P1_4)
unnamed: R1.2, SW1.1, U1.15 (P1_5)
unnamed: R4.2, U1.24 (~RESET)
RDY: J1.6, J2.1
SCL: J1.2, J2.5, U1.19 (SCL)
SDA: J1.1, J2.6, U1.20 (SDA)

Notes on the sheet:
Trackpad Connector (to kbd)
RST
Trackpad Connector (flipped) (to sensor)

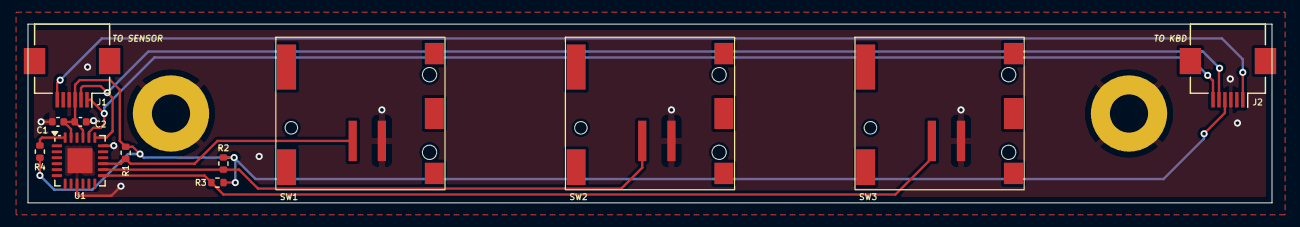
[picture p190: board nref-trackpad.kicad_pcb from above]

Board: 2 copper layers, 104.4 x 15.0 mm, 14 parts (0 on the bottom side), 9 nets.
