cetola/reform-next-mirror/nref-flex/nref-flex-usb3-one/nref-flex-usb3-one.kicad_pcb

## KiCad design nref-flex/nref-flex-usb3-one/nref-flex-usb3-one.kicad_pcb (2026-05-07)

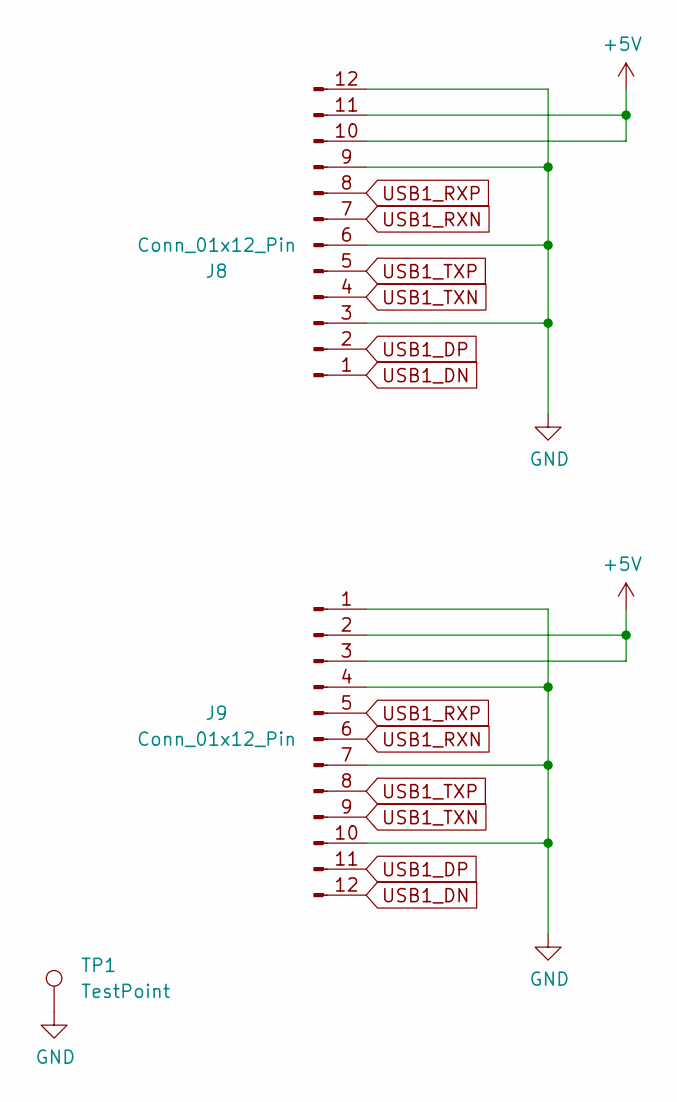
[picture p191: schematic nref-flex-usb3-one.kicad_sch]

Parts:
J8, J9: Conn_01x12_Pin; FPC_12
TP1: TestPoint; TestPoint_Pad_D1.0mm

Connections:
+5V: J8.10, J8.11, J9.2, J9.3
GND: J8.3, J8.6, J8.9, J8.12, J9.1, J9.4, J9.7, J9.10, TP1.1
USB1_DN: J8.1, J9.12
USB1_DP: J8.2, J9.11
USB1_RXN: J8.7, J9.6
USB1_RXP: J8.8, J9.5
USB1_TXN: J8.4, J9.9
USB1_TXP: J8.5, J9.8

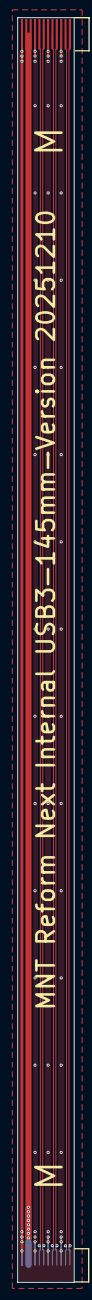
[picture p192: board nref-flex-usb3-one.kicad_pcb from above]

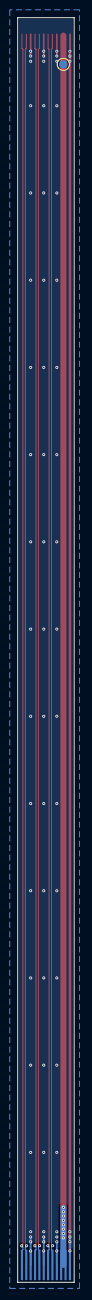
[picture p193: board nref-flex-usb3-one.kicad_pcb from below]

Board: 2 copper layers, 6.5 x 145.0 mm, 3 parts (2 on the bottom side), 8 nets.
