cetola/reform-next-mirror/nref-usb3-redriver/nref-usb3-redriver.kicad_pcb

## KiCad design nref-usb3-redriver/nref-usb3-redriver.kicad_pcb (2025-11-19)

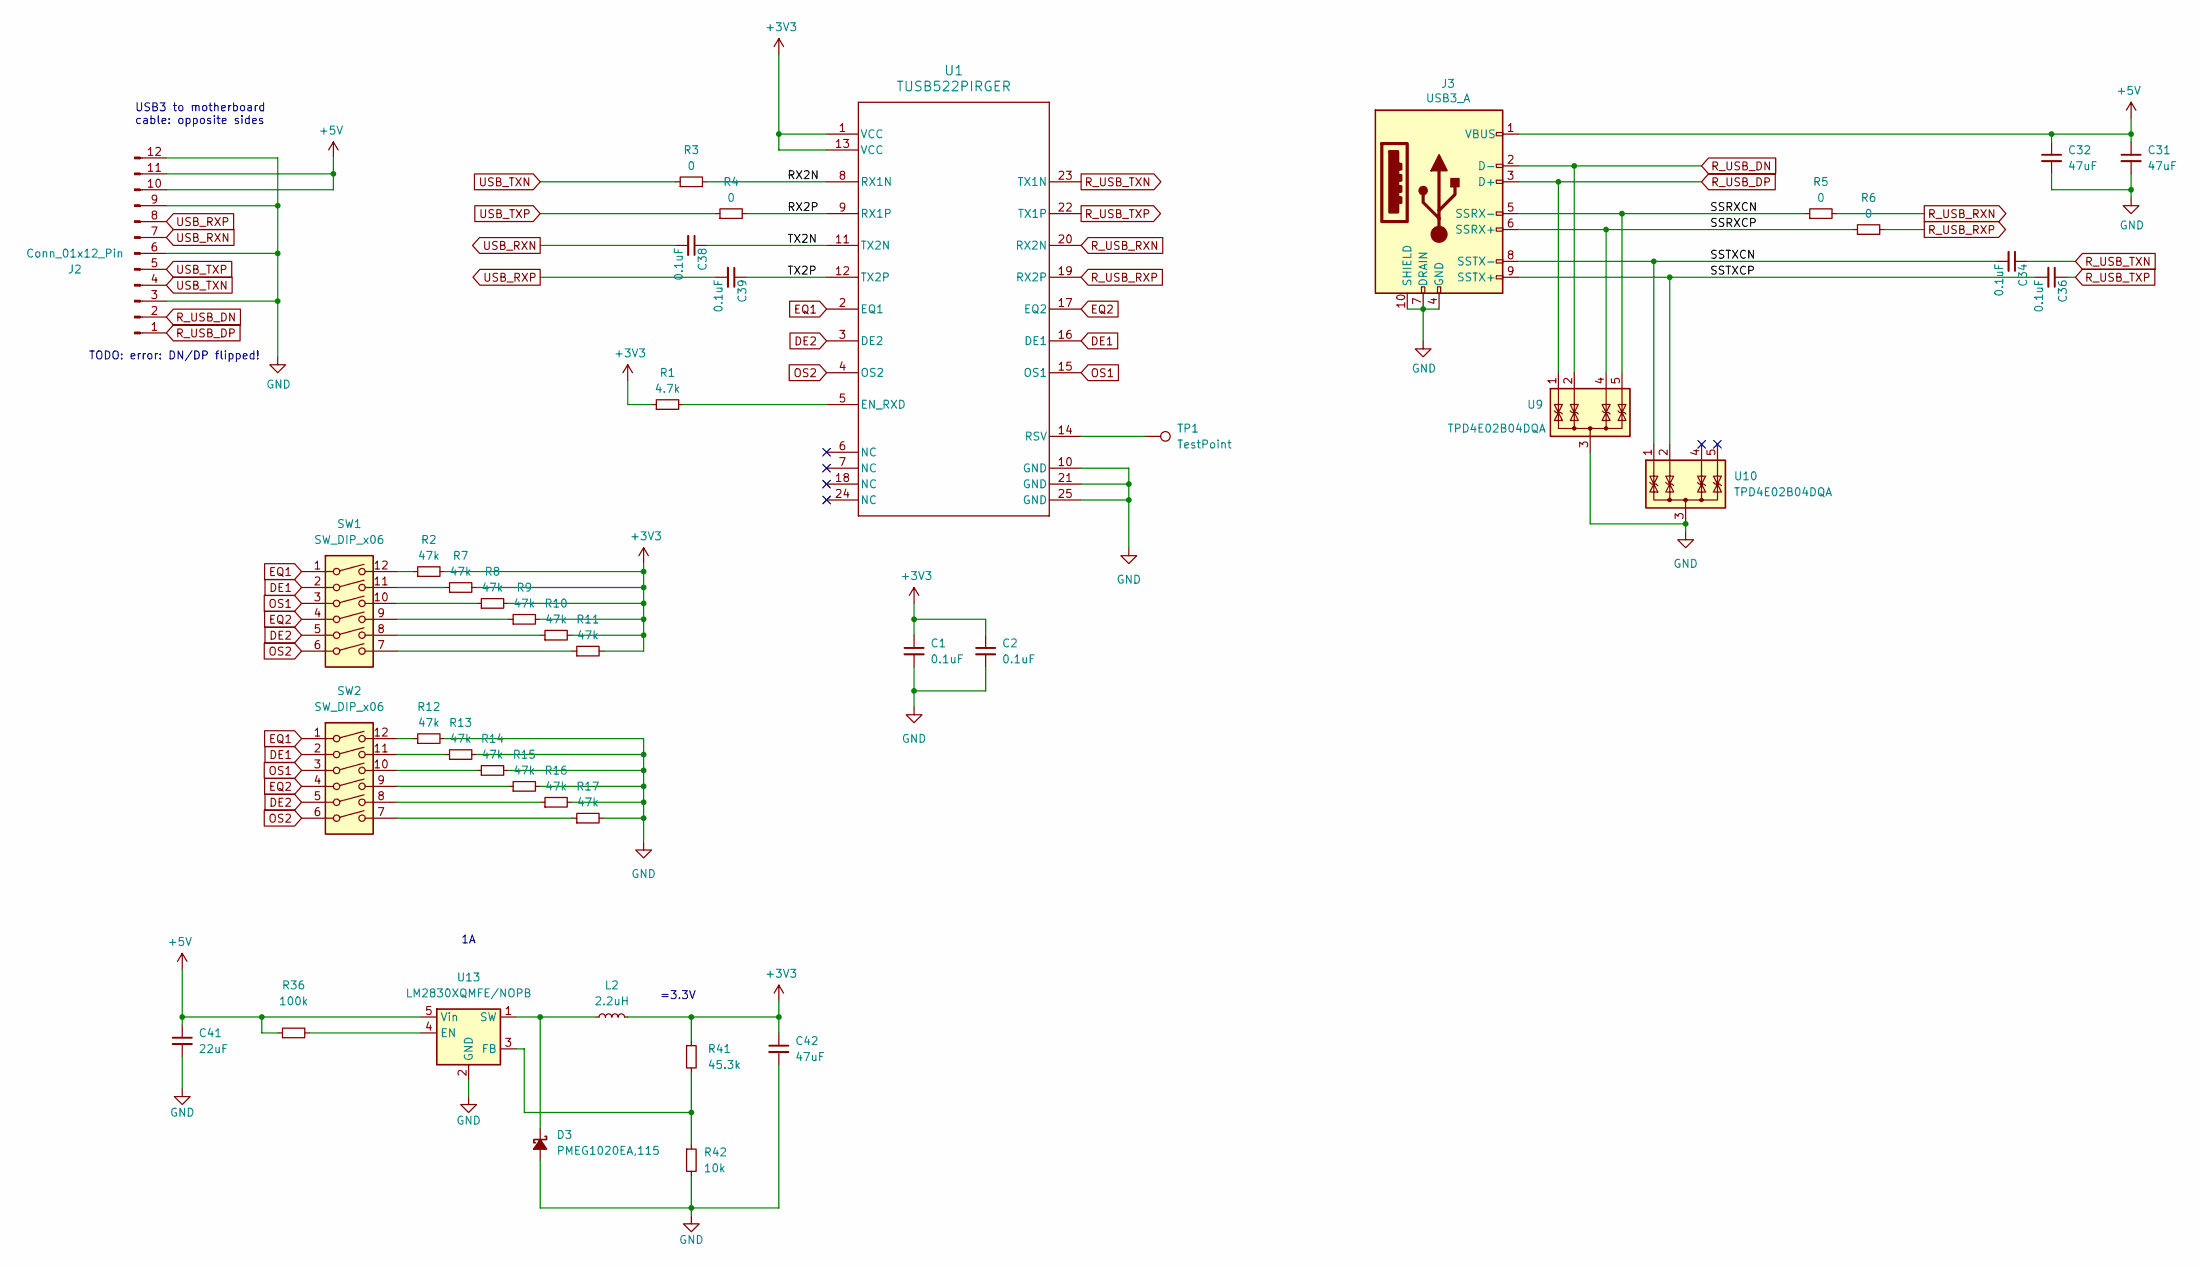
[picture p194: schematic nref-usb3-redriver.kicad_sch]

Parts:
C1, C2, C34, C36, C38, C39: 0.1uF; C_0402_1005Metric
C31, C32, C42: 47uF; C_1206_3216Metric
C41: 22uF; C_1206_3216Metric
D3: PMEG1020EA,115; D_SOD-323
J2: Conn_01x12_Pin; Hirose_FH12-12S-0.5SH_1x12-1MP_P0.50mm_Horizontal
J3: USB3_A; USB3_A_Receptacle_Wuerth_692122030100
L2: 2.2uH; L_1210_3225Metric
R1: 4.7k; R_0402_1005Metric
R2, R7, R8, R9, R10, R11, R12, R13, R14, R15, R16, R17: 47k; R_0402_1005Metric
R3, R4, R5, R6: 0; R_0402_1005Metric
R36: 100k; R_0402_1005Metric
R41: 45.3k; R_0402_1005Metric
R42: 10k; R_0402_1005Metric
SW1, SW2: SW_DIP_x06; SW_DIP_SPSTx06_Slide_Omron_A6H-6101_W6.15mm_P1.27mm
TP1: TestPoint; TestPoint_Pad_D1.0mm
U1: TUSB522PIRGER; RGE0024C
U9, U10: TPD4E02B04DQA; USON-10_2.5x1.0mm_P0.5mm
U13: LM2830XQMFE/NOPB; SOT-23-5

Connections:
+3V3: C1.1, C2.1, C42.1, L2.2, R1.1, R2.2, R7.2, R8.2, R9.2, R10.2, R11.2, R41.1, U1.1 (VCC), U1.13 (VCC)
+5V: C31.1, C32.1, C41.1, J2.10, J2.11, J3.1 (VBUS), R36.1, U13.5 (Vin)
/RX2N: R3.2, U1.8 (RX1N)
/RX2P: R4.2, U1.9 (RX1P)
/SSRXCN: J3.5 (SSRX-), R5.1, U9.5 (IO4), U9.6 (IO4)
/SSRXCP: J3.6 (SSRX+), R6.1, U9.4 (IO3), U9.7 (IO3)
/SSTXCN: C34.2, J3.8 (SSTX-), U10.1 (IO1), U10.10 (IO1)
/SSTXCP: C36.2, J3.9 (SSTX+), U10.2 (IO2), U10.9 (IO2)
/TX2N: C38.1, U1.11 (TX2N)
/TX2P: C39.1, U1.12 (TX2P)
DE1: SW1.2, SW2.2, U1.16 (DE1)
DE2: SW1.5, SW2.5, U1.3 (DE2)
EQ1: SW1.1, SW2.1, U1.2 (EQ1)
EQ2: SW1.4, SW2.4, U1.17 (EQ2)
GND: C1.2, C2.2, C31.2, C32.2, C41.2, C42.2, D3.2 (A), J2.3, J2.6, J2.9, J2.12, J3.4 (GND), J3.7 (DRAIN), J3.10 (SHIELD), R12.2, R13.2, R14.2, R15.2, R16.2, R17.2, R42.2, U1.10 (GND), U1.21 (GND), U1.25 (GND), U9.3 (G), U9.8 (G), U10.3 (G), U10.8 (G), U13.2 (GND)
unnamed: D3.1 (K), L2.1, U13.1 (SW)
unnamed: R2.1, SW1.12
unnamed: R7.1, SW1.11
unnamed: R8.1, SW1.10
unnamed: R9.1, SW1.9
unnamed: R10.1, SW1.8
unnamed: R11.1, SW1.7
unnamed: R12.1, SW2.12
unnamed: R13.1, SW2.11
unnamed: R14.1, SW2.10
unnamed: R15.1, SW2.9
unnamed: R16.1, SW2.8
unnamed: R17.1, SW2.7
unnamed: R1.2, U1.5 (EN_RXD)
unnamed: TP1.1, U1.14 (RSV)
unnamed: R36.2, U13.4 (EN)
unnamed: R41.2, R42.1, U13.3 (FB)
OS1: SW1.3, SW2.3, U1.15 (OS1)
OS2: SW1.6, SW2.6, U1.4 (OS2)
R_USB_DN: J2.2, J3.2 (D-), U9.2 (IO2), U9.9 (IO2)
R_USB_DP: J2.1, J3.3 (D+), U9.1 (IO1), U9.10 (IO1)
R_USB_RXN: R5.2, U1.20 (RX2N)
R_USB_RXP: R6.2, U1.19 (RX2P)
R_USB_TXN: C34.1, U1.23 (TX1N)
R_USB_TXP: C36.1, U1.22 (TX1P)
USB_RXN: C38.2, J2.7
USB_RXP: C39.2, J2.8
USB_TXN: J2.4, R3.1
USB_TXP: J2.5, R4.1

Notes on the sheet:
TODO: error: DN/DP flipped!
=3.3V
USB3 to motherboard cable: opposite sides

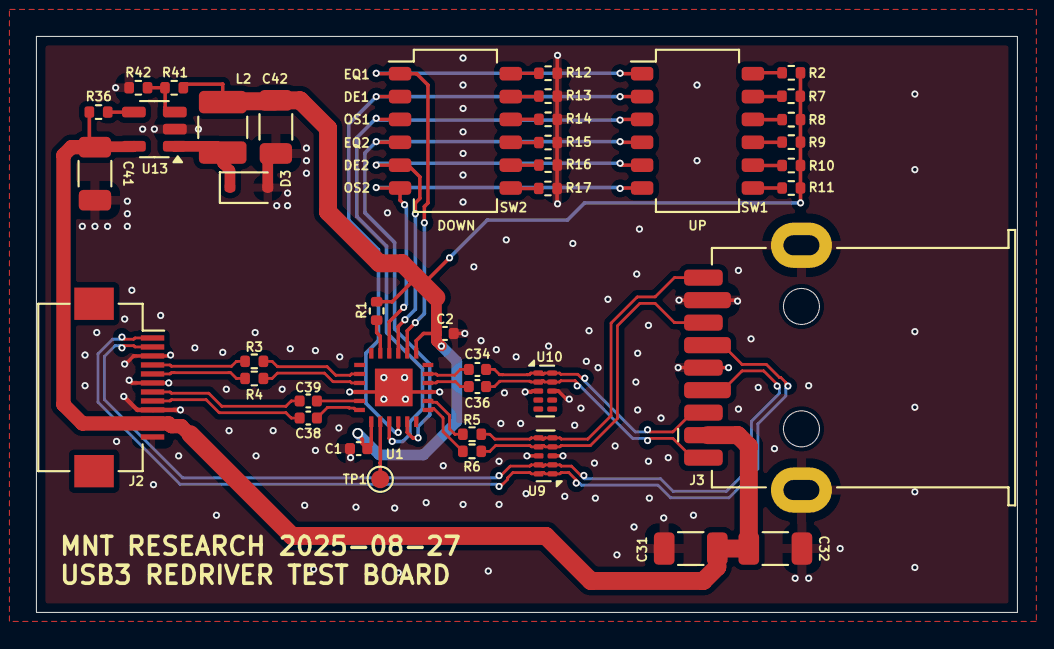
[picture p195: board nref-usb3-redriver.kicad_pcb from above]

Board: 4 copper layers, 54.5 x 32.0 mm, 41 parts (0 on the bottom side), 44 nets.
