cetola/reform-next-mirror/nref-camera-adapter/nref-camera-adapter.kicad_pcb

## KiCad design nref-camera-adapter/nref-camera-adapter.kicad_pcb (2025-10-22)

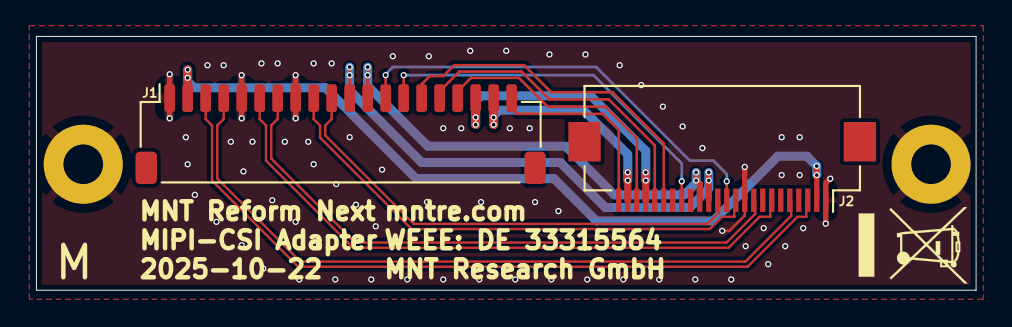
[picture p196: board nref-camera-adapter.kicad_pcb from above]

Board: 4 copper layers, 52.2 x 14.1 mm, 4 parts (0 on the bottom side), 18 nets.

Parts:
H1, H1#2: MountingHole_Pad; MountingHole_2.2mm_M2_Pad
J1: Conn_01x20; JST_SH_SM20B-SRSS-TB_1x20-1MP_P1.00mm_Horizontal
J2: Conn_01x24; Hirose_FH12-24S-0.5SH_1x24-1MP_P0.50mm_Horizontal

Connections:
/CAM_AF_VCC: J1.2, J2.2
/CAM_AGND: J1.19, J2.23
/CAM_AVDD: J1.18, J2.21
/CAM_DOVDD: J1.11, J2.14
/CAM_DVDD: J1.12, J2.15
/CAM_MCLK: J1.13, J2.12
/CAM_MIPI_CN: J1.6, J2.7
/CAM_MIPI_CP: J1.7, J2.9
/CAM_MIPI_D0N: J1.3, J2.3
/CAM_MIPI_D0P: J1.4, J2.5
/CAM_MIPI_D1N: J1.9, J2.11
/CAM_MIPI_D1P: J1.10, J2.13
/CAM_PWDNB: J1.14, J2.17
/CAM_RST: J1.15, J2.19
/CAM_SCL: J1.16, J2.20
/CAM_SDA: J1.17, J2.22
/CAM_STROBE: J1.20, J2.24
GND: H1.1, H1#2.1, J1.1, J1.5, J1.8, J2.1, J2.10
