cetola/reform-next-mirror/nref-camera/reform-camera.kicad_pcb

## KiCad design nref-camera/reform-camera.kicad_pcb (2024-12-27)

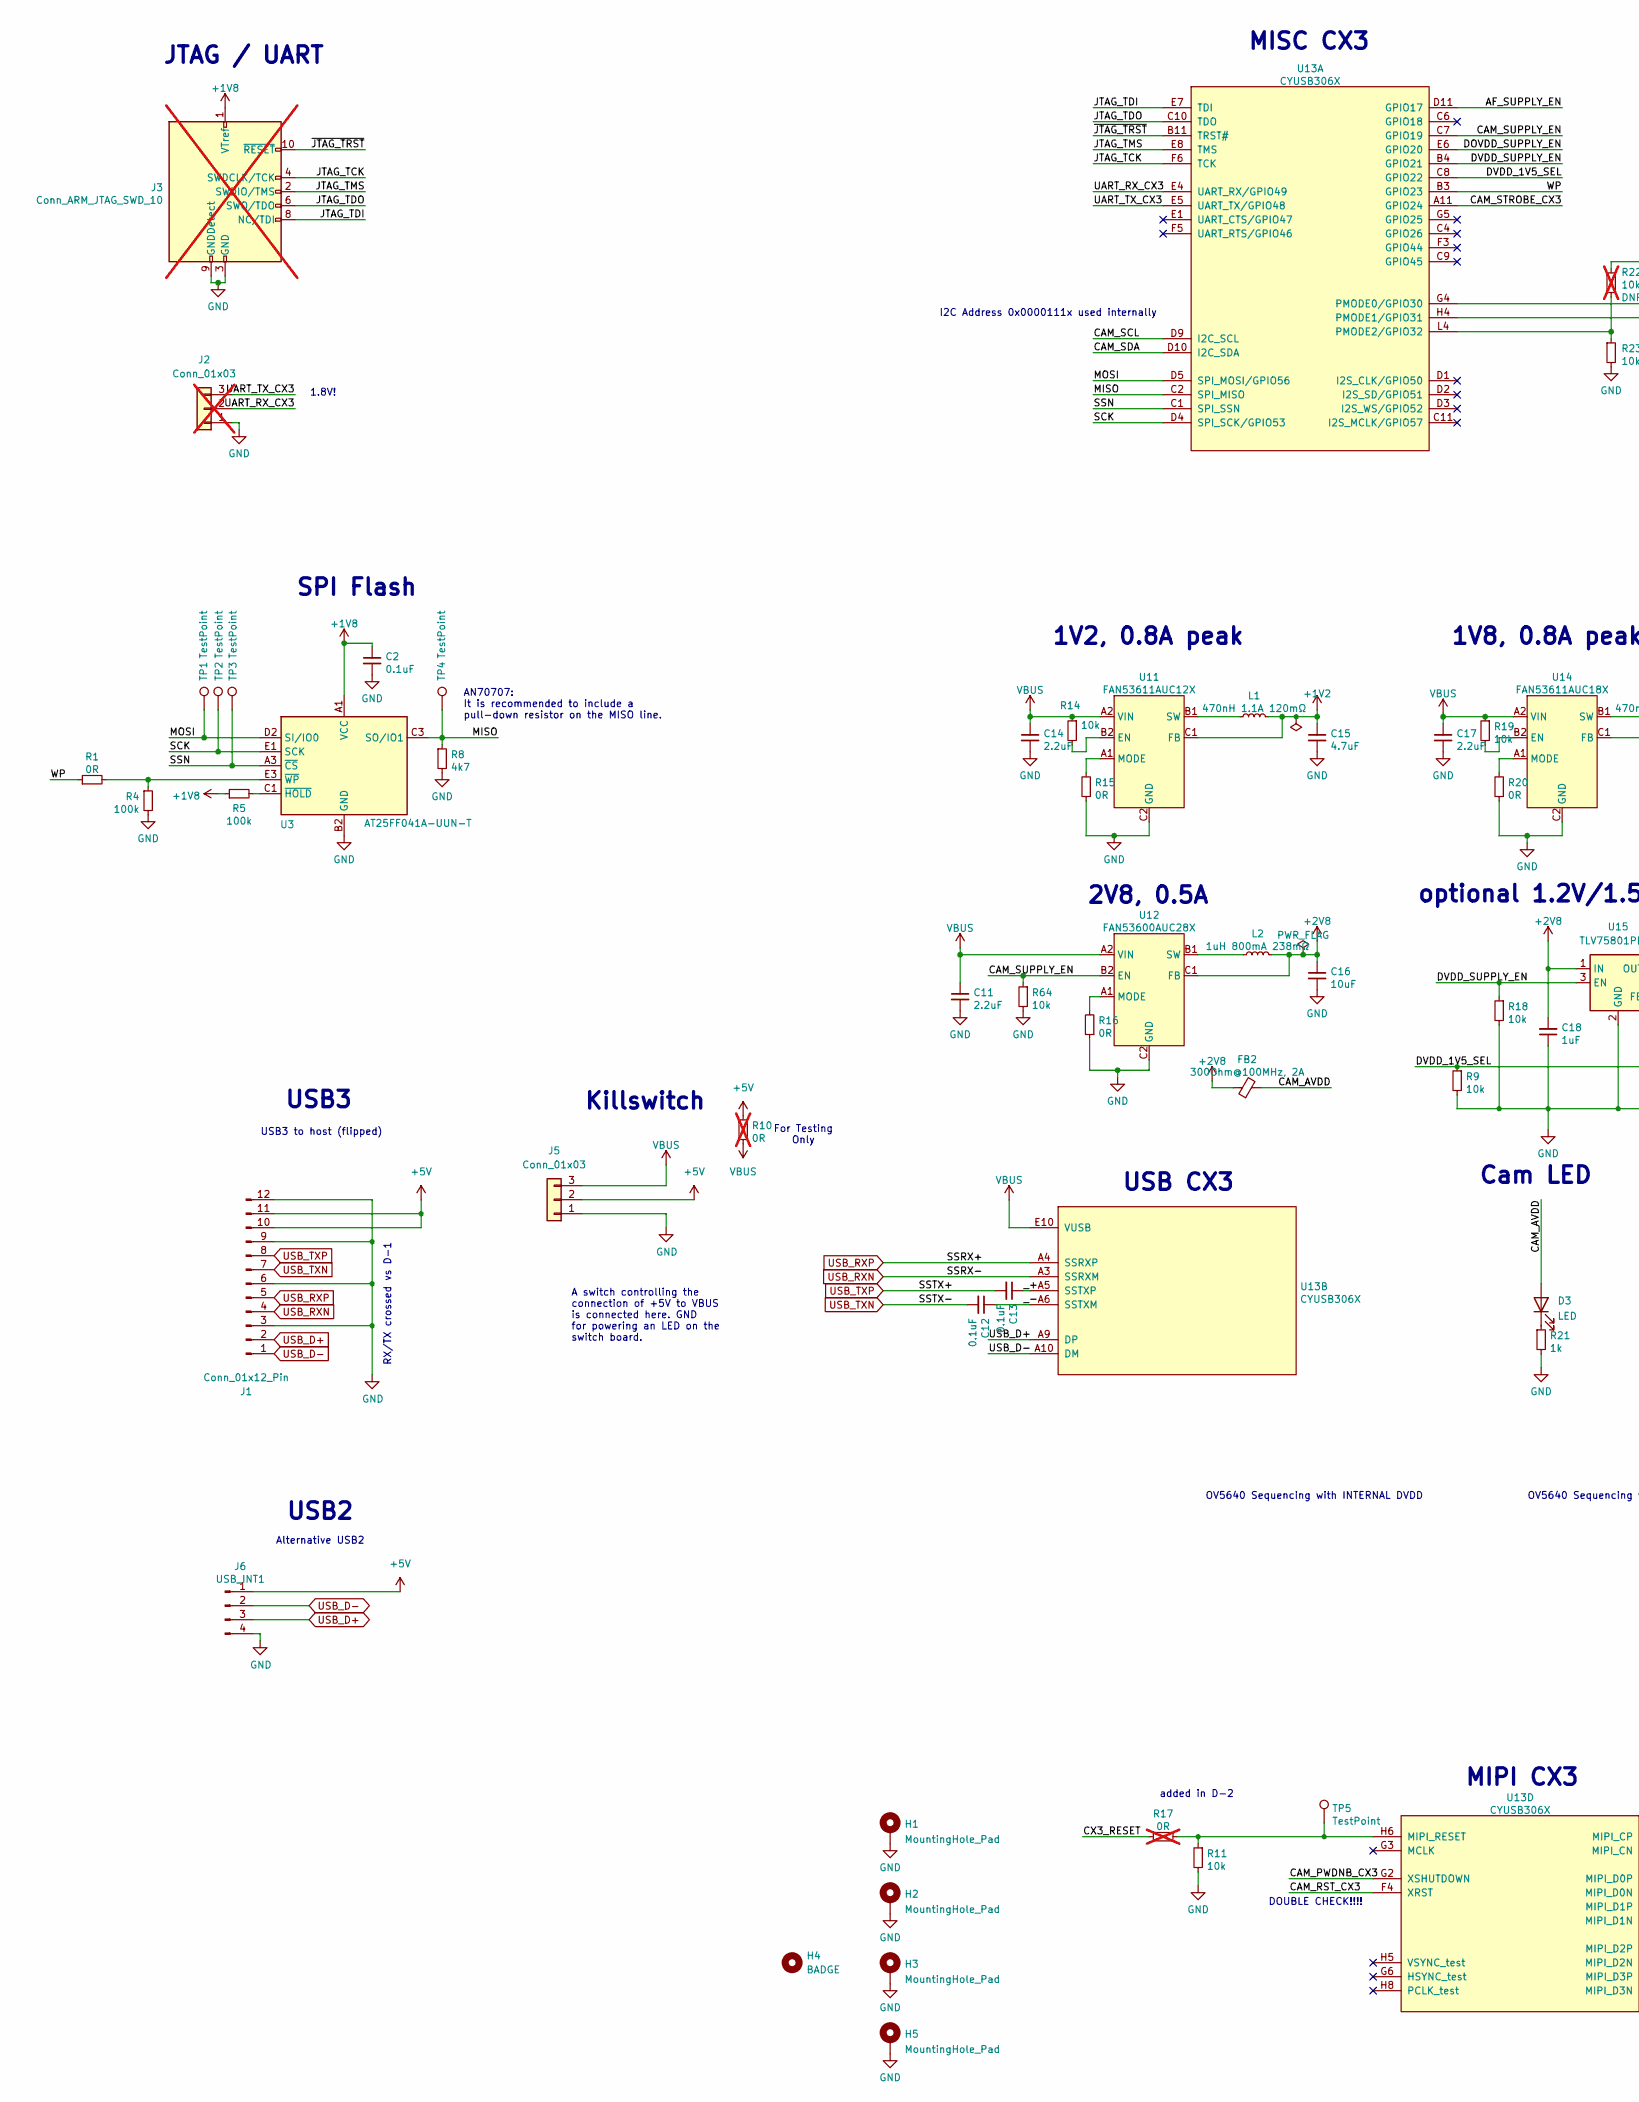
[picture p197: schematic reform-camera.kicad_sch, MNT Reform Camera, part in row 1, column 1]

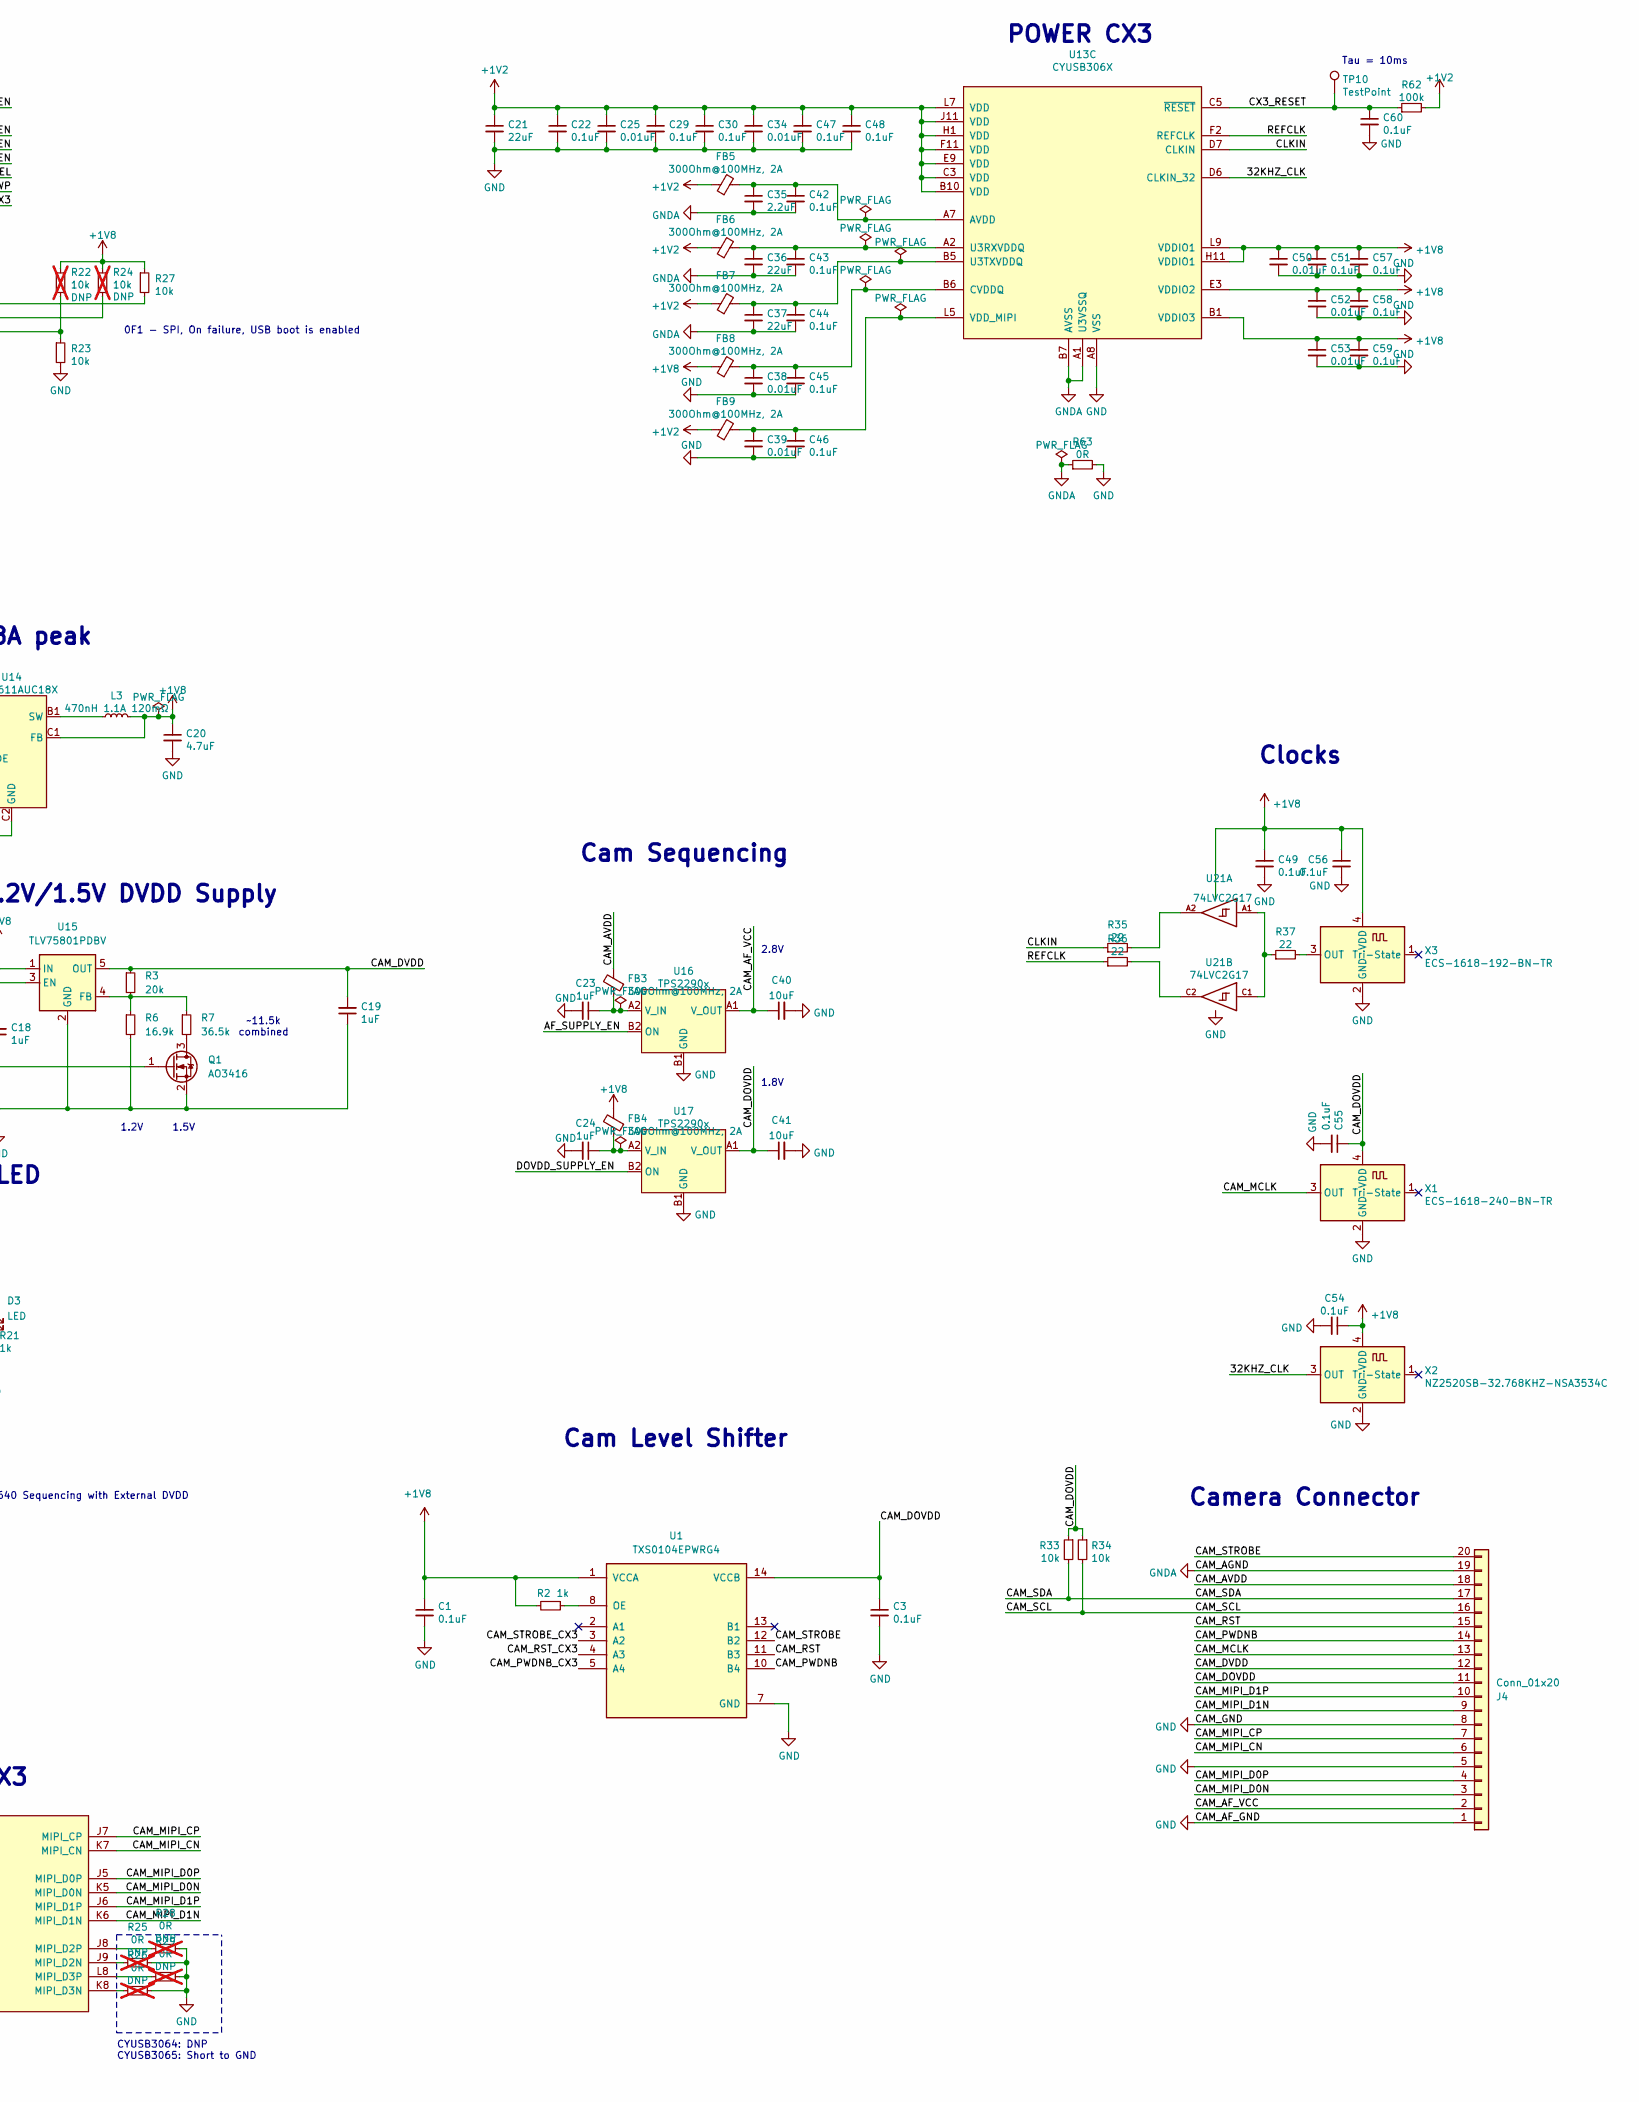
[picture p198: schematic reform-camera.kicad_sch, MNT Reform Camera, part in row 1, column 2]

Parts:
C1, C3: 0.1uF; C_0402_1005Metric; MPN GRM155R71C104KA88J; LCSC C60474
C2, C12, C13, C22, C29, C30, C42, C43, C44, C45, C46, C47, C48, C49, C51, C54, C55, C56, C57, C58, C59, C60: 0.1uF; C_0402_1005Metric; MPN GRM155R71C104KA88J
C11, C14, C17, C35: 2.2uF; C_0402_1005Metric; MPN GRT155C81C225KE13D
C15, C20: 4.7uF; C_0402_1005Metric; MPN GRT155C81A475ME13J
C16, C40, C41: 10uF; C_0603_1608Metric; MPN C0603C106M8PAC7411
C18, C19, C23, C24: 1uF; C_0402_1005Metric; MPN GMK105CC6105KV-F
C21, C36, C37: 22uF; C_0603_1608Metric; MPN MSASJ168BC6226MTNA01
C25, C34, C38, C39, C50, C52, C53: 0.01uF; C_0402_1005Metric; MPN C0402C103K8RAC7411
D3: LED; LED_0603_1608Metric; MPN TLHR5400-AS12Z
FB2, FB3, FB4, FB5, FB6, FB7, FB8, FB9: 300Ohm@100MHz, 2A; C_0603_1608Metric; MPN MI0603L301R-10
H1, H2, H3, H5: MountingHole_Pad; MountingHole_2.2mm_M2_Pad; MPN DNP
H4: BADGE; nref-camera-badge; MPN DNP
J1: Conn_01x12_Pin; Hirose_FH12-12S-0.5SH_1x12-1MP_P0.50mm_Horizontal; MPN FH12-12S-0.5SH(55)
J2: Conn_01x03; PinSocket_1x03_P2.54mm_Vertical; MPN DNP; not fitted
J3: Conn_ARM_JTAG_SWD_10; PinHeader_2x05_P1.27mm_Vertical; MPN 62201021121 (DNP); not fitted
J4: Conn_01x20; JST_SH_SM20B-SRSS-TB_1x20-1MP_P1.00mm_Horizontal; MPN SM20B-SRSS-TB
J5: Conn_01x03; JST_SH_SM03B-SRSS-TB_1x03-1MP_P1.00mm_Horizontal; MPN SM03B-SRSS-TB
J6: USB_INT1; JST_SH_SM04B-SRSS-TB_1x04-1MP_P1.00mm_Horizontal; MPN SM04B-SRSS-TB; LCSC C160404
L1, L3: 470nH 1.1A 120mΩ; L_0805_2012Metric; MPN LQM21PNR47MC0D; Mouser 81-LQM21PNR47MC0D
L2: 1uH 800mA 238mΩ; L_0805_2012Metric; MPN LQM21PN1R0MC0D; Digikey 490-4992-1-ND
Q1: AO3416; SOT-23; MPN DMN2024U-7
R1, R15, R16, R20: 0R; R_0402_1005Metric; MPN CRCW04020000Z0EDC
R2, R21: 1k; R_0402_1005Metric; MPN CRCW04021K00FKEDC
R3: 20k; R_0402_1005Metric; MPN RC0402FR-7D20KL
R4, R5, R62: 100k; R_0402_1005Metric; MPN RC0402FR-07100KL
R6: 16.9k; R_0402_1005Metric; MPN CRCW040216K9FKTD
R7: 36.5k; R_0402_1005Metric; MPN RP0402BRD0736K5L
R8: 4k7; R_0402_1005Metric; MPN RC0402FR-074K7L
R9, R11, R14, R18, R19, R23, R27, R33, R34, R64: 10k; R_0402_1005Metric; MPN RC0402FR-7D10KL
R10, R17, R25, R26, R28, R29: 0R; R_0402_1005Metric; MPN CRCW04020000Z0EDC; not fitted
R22, R24: 10k; R_0402_1005Metric; MPN RC0402FR-7D10KL; not fitted
R35, R36, R37: 22; R_0402_1005Metric; MPN RC0402FR-7D22RL
R63: 0R; R_0603_1608Metric; MPN CRCW060320K0FKEAC
TP1, TP2, TP3, TP4, TP5, TP10: TestPoint; TestPoint_Pad_D0.7mm; MPN DNP
U1: TXS0104EPWRG4; SOP65P640X120-14N; MPN TXS0104EPWRG4
U3: AT25FF041A-UUN-T; WLCSP-8_1.58x1.63x0.35mm_Layout3x5_P0.35x0.4mm_Ball0.25mm_P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; MPN AT25FF041A-UUN-T
U11: FAN53611AUC12X; WLCSP-6_2x3_0.8x1.2mm; MPN FAN53611AUC12X
U12: FAN53600AUC28X; WLCSP-6_2x3_0.8x1.2mm; MPN FAN53600AUC28X
U13: CYUSB306X; XBGA-121_10x10mm_Layout11x11_P0.8mm; MPN CYUSB3064-BZXI
U14: FAN53611AUC18X; WLCSP-6_2x3_0.8x1.2mm; MPN FAN53611AUC18X
U15: TLV75801PDBV; SOT-23-5; MPN TLV75801PDBV
U16, U17: TPS2290x; Texas-DSBGA4_2x2_0.8x0.8mm_YFP; MPN TPS22902YFPR
U21: 74LVC2G17; Texas-DSBGA6_2x3_1.39x0.9mm_YZP; MPN SN74LVC2G17YZPR
X1: ECS-1618-240-BN-TR; ECS-1618; MPN ECS-1618-240-BN-TR
X2: NZ2520SB-32.768KHZ-NSA3534C; Crystal_SMD_EuroQuartz_X22-4Pin_2.5x2.0mm; MPN NZ2520SB-32.768KHZ-NSA3534C; Digikey 644-1197-2-ND
X3: ECS-1618-192-BN-TR; ECS-1618; MPN ECS-1618-192-BN-TR; Digikey XC1964CT-ND

Connections:
+1V2: C15.1, C21.1, C22.1, C25.1, C29.1, C30.1, C34.1, C47.1, C48.1, FB5.1, FB6.1, FB7.1, FB9.1, L1.2, R62.2, U11.C1 (FB), U13.B10 (VDD), U13.C3 (VDD), U13.E9 (VDD), U13.F11 (VDD), U13.H1 (VDD), U13.J11 (VDD), U13.L7 (VDD)
+1V8: C1.1, C2.1, C20.1, C49.1, C50.1, C51.1, C52.1, C53.1, C54.1, C56.1, C57.1, C58.1, C59.1, FB4.2, FB8.1, J3.1 (VTref), L3.2, R2.2, R5.1, R22.1, R24.1, R27.1, U1.1 (VCCA), U3.A1 (VCC), U13.B1 (VDDIO3), U13.E3 (VDDIO2), U13.H11 (VDDIO1), U13.L9 (VDDIO1), U14.C1 (FB), U21.B2 (VCC), X2.4 (VDD), X3.4 (VDD)
+2V8: C16.1, C18.2, FB2.1, L2.2, U12.C1 (FB), U15.1 (IN)
+5V: J1.10, J1.11, J5.2, J6.1, R10.2
/32KHZ_CLK: U13.D6 (CLKIN_32), X2.3 (OUT)
/AF_SUPPLY_EN: U13.D11 (GPIO17), U16.B2 (ON)
/CAM_AF_VCC: C40.1, J4.2, U16.A1 (V_OUT)
/CAM_AVDD: D3.2 (A), FB2.2, FB3.2, J4.18
/CAM_DOVDD: C3.1, C41.1, C55.1, J4.11, R33.1, R34.1, U1.14 (VCCB), U17.A1 (V_OUT), X1.4 (VDD)
/CAM_DVDD: C19.2, J4.12, R3.1, U15.5 (OUT)
/CAM_MCLK: J4.13, X1.3 (OUT)
/CAM_MIPI_CN: J4.6, U13.K7 (MIPI_CN)
/CAM_MIPI_CP: J4.7, U13.J7 (MIPI_CP)
/CAM_MIPI_D0N: J4.3, U13.K5 (MIPI_D0N)
/CAM_MIPI_D0P: J4.4, U13.J5 (MIPI_D0P)
/CAM_MIPI_D1N: J4.9, U13.K6 (MIPI_D1N)
/CAM_MIPI_D1P: J4.10, U13.J6 (MIPI_D1P)
/CAM_PWDNB: J4.14, U1.10 (B4)
/CAM_PWDNB_CX3: U1.5 (A4), U13.G2 (XSHUTDOWN)
/CAM_RST: J4.15, U1.11 (B3)
/CAM_RST_CX3: U1.4 (A3), U13.F4 (XRST)
/CAM_SCL: J4.16, R34.2, U13.D9 (I2C_SCL)
/CAM_SDA: J4.17, R33.2, U13.D10 (I2C_SDA)
/CAM_STROBE: J4.20, U1.12 (B2)
/CAM_STROBE_CX3: U1.3 (A2), U13.A11 (GPIO24)
/CAM_SUPPLY_EN: R64.1, U12.B2 (EN), U13.C7 (GPIO19)
/CLKIN: R35.1, U13.D7 (CLKIN)
/CX3_RESET: C60.1, R17.1, R62.1, TP10.1, U13.C5 (~RESET)
/DOVDD_SUPPLY_EN: U13.E6 (GPIO20), U17.B2 (ON)
/DVDD_1V5_SEL: Q1.1 (G), R9.1, U13.C8 (GPIO22)
/DVDD_SUPPLY_EN: R18.1, U13.B4 (GPIO21), U15.3 (EN)
/JTAG_TCK: J3.4 (SWDCLK/TCK), U13.F6 (TCK)
/JTAG_TDI: J3.8 (NC/TDI), U13.E7 (TDI)
/JTAG_TDO: J3.6 (SWO/TDO), U13.C10 (TDO)
/JTAG_TMS: J3.2 (SWDIO/TMS), U13.E8 (TMS)
/MISO: R8.1, TP4.1, U3.C3 (SO/IO1), U13.C2 (SPI_MISO)
/MOSI: TP1.1, U3.D2 (SI/IO0), U13.D5 (SPI_MOSI/GPIO56)
/REFCLK: R36.1, U13.F2 (REFCLK)
/SCK: TP2.1, U3.E1 (SCK), U13.D4 (SPI_SCK/GPIO53)
/SSN: TP3.1, U3.A3 (~CS), U13.C1 (SPI_SSN)
/UART_RX_CX3: J2.2, U13.E4 (UART_RX/GPIO49)
/UART_TX_CX3: J2.3, U13.E5 (UART_TX/GPIO48)
/WP: R1.1, U13.B3 (GPIO23)
/_+: C13.1, U13.A5 (SSTXP)
/_-: C12.1, U13.A6 (SSTXM)
/~JTAG_TRST: J3.10 (~RESET), U13.B11 (TRST#)
GND: C1.2, C2.2, C3.2, C11.2, C14.2, C15.2, C16.2, C17.2, C18.1, C19.1, C20.2, C21.2, C22.2, C23.2, C24.2, C25.2, C29.2, C30.2, C34.2, C38.2, C39.2, C40.2, C41.2, C45.2, C46.2, C47.2, C48.2, C49.2, C50.2, C51.2, C52.2, C53.2, C54.2, C55.2, C56.2, C57.2, C58.2, C59.2, C60.2, H1.1, H2.1, H3.1, H5.1, J1.3, J1.6, J1.9, J1.12, J2.1, J3.3 (GND), J3.5 (GND), J3.9 (GNDDetect), J4.1, J4.5, J4.8, J5.1, J6.4, Q1.2 (S), R4.2, R6.2, R8.2, R9.2, R11.2, R15.1, R16.1, R18.2, R20.1, R21.2, R23.2, R25.1, R26.1, R28.1, R29.1, R63.2, R64.2, U1.7 (GND), U3.B2 (GND), U11.C2 (GND), U12.C2 (GND), U13.A8 (VSS), U13.B2 (VSS), U13.B8 (VSS), U13.B9 (VSS), U13.D8 (VSS), U13.E2 (VSS), U13.E11 (VSS), U13.G1 (VSS), U13.G11 (VSS), U13.K3 (VSS), U13.K4 (VSS), U13.L1 (VSS), U13.L2 (VSS), U13.L3 (VSS), U13.L6 (VSS), U13.L11 (VSS), U14.C2 (GND), U15.2 (GND), U16.B1 (GND), U17.B1 (GND), U21.B1 (GND), X1.2 (GND), X2.2 (GND), X3.2 (GND)
GNDA: C35.2, C36.2, C37.2, C42.2, C43.2, C44.2, J4.19, R63.1, U13.A1 (U3VSSQ), U13.B7 (AVSS)
unnamed: D3.1 (K), R21.1
unnamed: Q1.3 (D), R7.2
unnamed: R35.2, U21.A2
unnamed: R36.2, U21.C2
unnamed: R37.1, U21.A1, U21.C1
unnamed: R2.1, U1.8 (OE)
unnamed: R5.2, U3.C1 (~HOLD)
unnamed: R1.2, R4.1, U3.E3 (~WP)
unnamed: R14.2, U11.B2 (EN)
unnamed: R15.2, U11.A1 (MODE)
unnamed: L1.1, U11.B1 (SW)
unnamed: R16.2, U12.A1 (MODE)
unnamed: L2.1, U12.B1 (SW)
unnamed: R27.2, U13.G4 (PMODE0/GPIO30)
unnamed: R24.2, U13.H4 (PMODE1/GPIO31)
unnamed: R22.2, R23.1, U13.L4 (PMODE2/GPIO32)
unnamed: C35.1, C42.1, FB5.2, U13.A7 (AVDD)
unnamed: C38.1, C45.1, FB8.2, U13.B6 (CVDDQ)
unnamed: C36.1, C43.1, FB6.2, U13.A2 (U3RXVDDQ)
unnamed: C37.1, C44.1, FB7.2, U13.B5 (U3TXVDDQ)
unnamed: C39.1, C46.1, FB9.2, U13.L5 (VDD_MIPI)
unnamed: R25.2, U13.J9 (MIPI_D2N)
unnamed: R28.2, U13.J8 (MIPI_D2P)
unnamed: R26.2, U13.K8 (MIPI_D3N)
unnamed: R29.2, U13.L8 (MIPI_D3P)
unnamed: R11.1, R17.2, TP5.1, U13.H6 (MIPI_RESET)
unnamed: R19.2, U14.B2 (EN)
unnamed: R20.2, U14.A1 (MODE)
unnamed: L3.1, U14.B1 (SW)
unnamed: R3.2, R6.1, R7.1, U15.4 (FB)
unnamed: C23.1, FB3.1, U16.A2 (V_IN)
unnamed: C24.1, FB4.1, U17.A2 (V_IN)
unnamed: R37.2, X3.3 (OUT)
USB_D+: J1.2, J6.3, U13.A9 (DP)
USB_D-: J1.1, J6.2, U13.A10 (DM)
USB_RXN: J1.4, U13.A3 (SSRXM)
USB_RXP: J1.5, U13.A4 (SSRXP)
USB_TXN: C12.2, J1.7
USB_TXP: C13.2, J1.8
VBUS: C11.1, C14.1, C17.1, J5.3, R10.1, R14.1, R19.1, U11.A2 (VIN), U12.A2 (VIN), U13.E10 (VUSB), U14.A2 (VIN)

Notes on the sheet:
Tau = 10ms
SPI Flash
added in D-2
Cam Level Shifter
OV5640 Sequencing with External DVDD
1V2, 0.8A peak
Clocks
1.2V
OV5640 Sequencing with INTERNAL DVDD
MISC CX3
2.8V
Cam Sequencing
1.8V
USB3
A switch controlling the connection of +5V to VBUS is connected here. GND for powering an LED on the switch board.
~11.5k combined
POWER CX3
Alternative USB2
AN70707: It is recommended to include a pull-down resistor on the MISO line.
optional 1.2V/1.5V DVDD Supply
0F1 - SPI, On failure, USB boot is enabled
I2C Address 0x0000111x used internally
JTAG / UART
CYUSB3064: DNP CYUSB3065: Short to GND
For Testing Only
Killswitch
1.8V!
RX/TX crossed vs D-1
2V8, 0.5A
DOUBLE CHECK!!!!
Cam LED
USB3 to host (flipped)
USB CX3
USB2
1.5V
Camera Connector
1V8, 0.8A peak
MIPI CX3

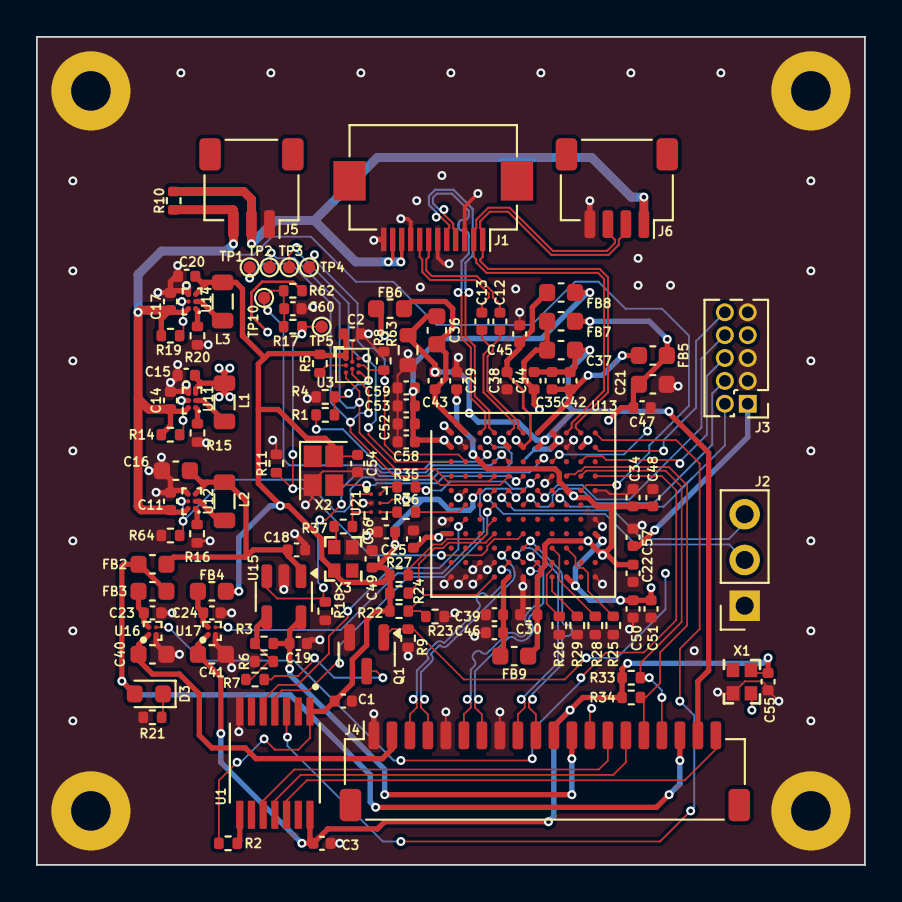
[picture p199: board reform-camera.kicad_pcb from above]

Board: 4 copper layers, 46.0 x 46.0 mm, 125 parts (1 on the bottom side), 88 nets.
