cetola/reform-next-mirror/nref-wifi/nref-wifi.kicad_pcb

## KiCad design nref-wifi/nref-wifi.kicad_pcb (2024-12-27)

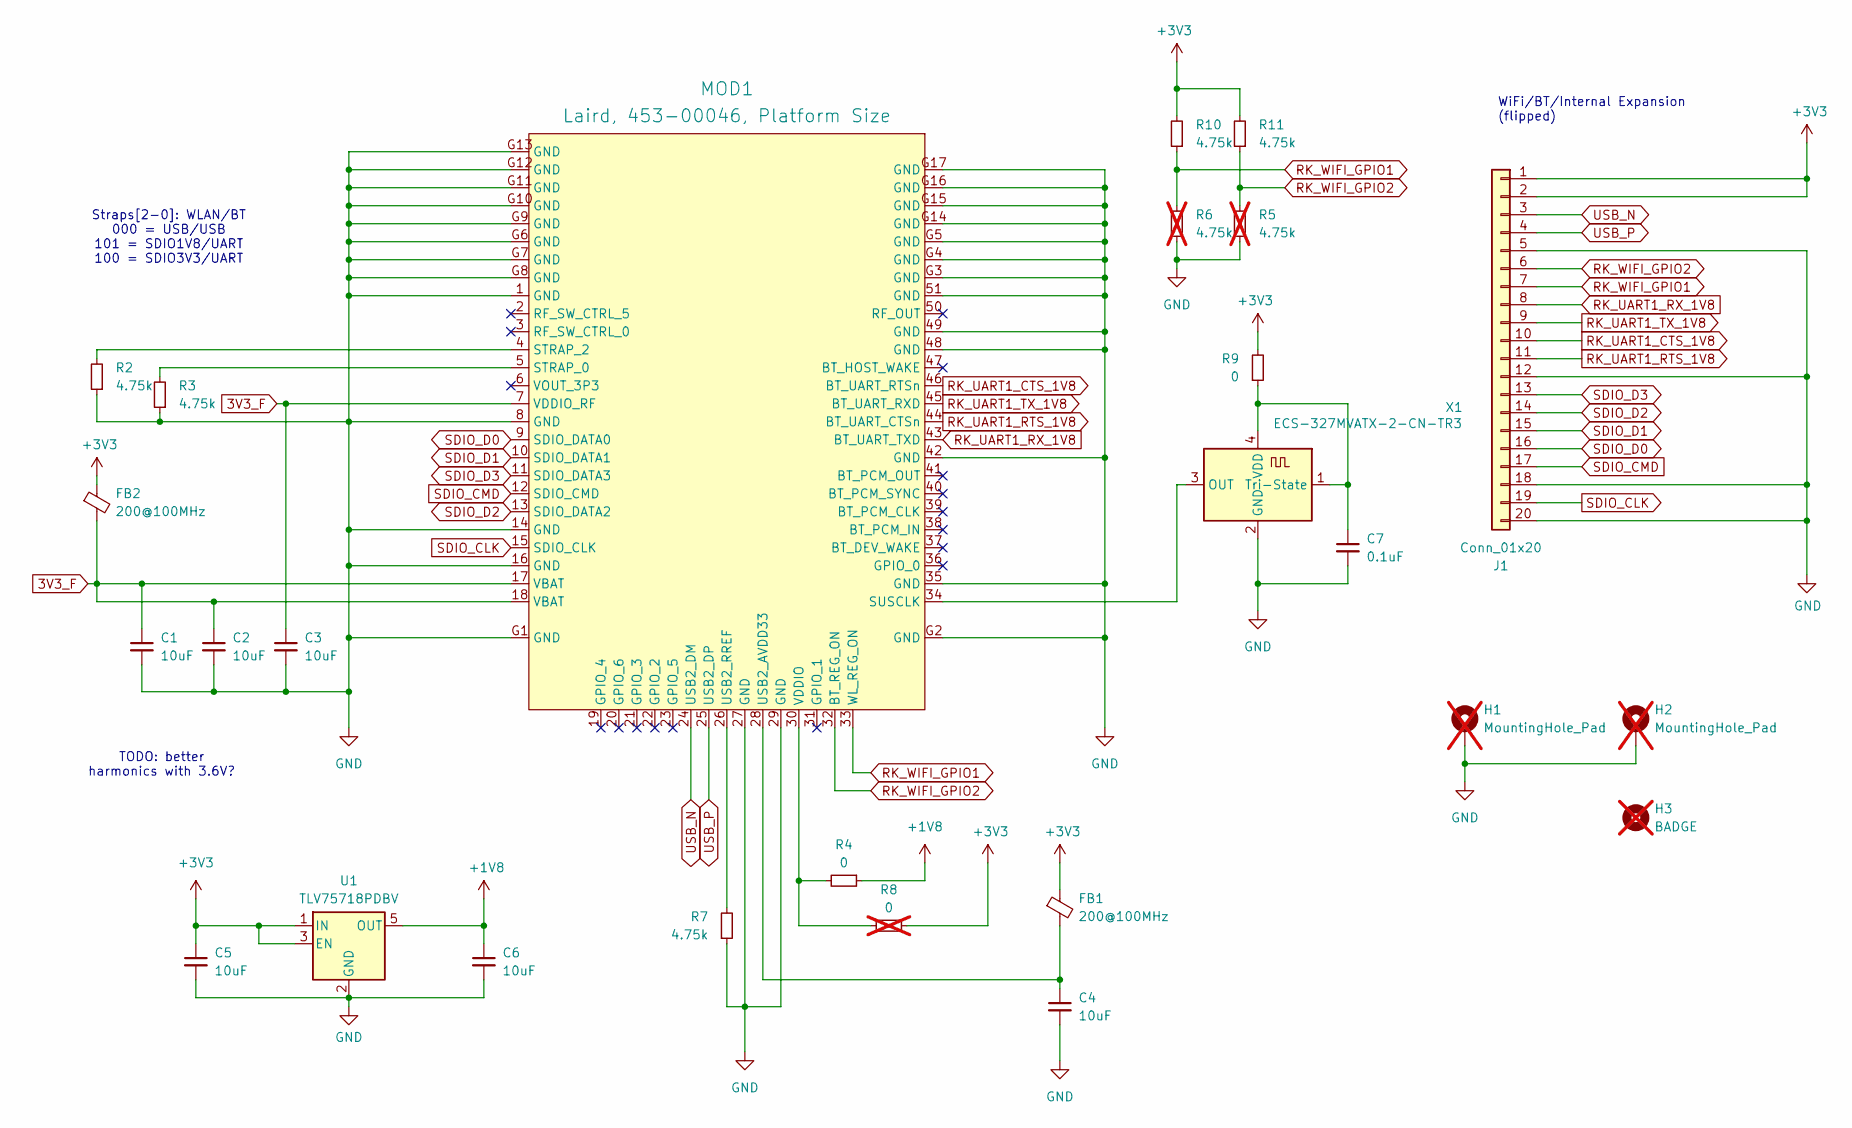
[picture p200: schematic nref-wifi.kicad_sch]

Parts:
C1, C2, C3, C4, C5, C6: 10uF; C_0603_1608Metric
C7: 0.1uF; C_0603_1608Metric
FB1, FB2: 200@100MHz; L_0603_1608Metric
H1, H2: MountingHole_Pad; MountingHole_2.2mm_M2_Pad; not fitted
H3: BADGE; nref-wifi-badge; not fitted
J1: Conn_01x20; Hirose_FH12-20S-0.5SH_1x20-1MP_P0.50mm_Horizontal
MOD1: Laird, 453-00046, Platform Size; Laird, Sterling LWB5+ Module, Platform Side
R2, R3, R7, R10, R11: 4.75k; R_0603_1608Metric
R4, R9: 0; R_0603_1608Metric
R5, R6: 4.75k; R_0603_1608Metric; not fitted
R8: 0; R_0603_1608Metric; not fitted
U1: TLV75718PDBV; SOT-23-5
X1: ECS-327MVATX-2-CN-TR3; Oscillator_SMD_ECS_2520MV-xxx-xx-4Pin_2.5x2.0mm

Connections:
3V3_F: C1.1, C2.1, C3.1, FB2.2, MOD1.7 (VDDIO_RF), MOD1.17 (VBAT), MOD1.18 (VBAT)
+1V8: C6.1, R4.1, U1.5 (OUT)
+3V3: C5.1, FB1.1, FB2.1, J1.1, J1.2, R8.1, R9.2, R10.2, R11.2, U1.1 (IN), U1.3 (EN)
GND: C1.2, C2.2, C3.2, C4.2, C5.2, C6.2, C7.2, H1.1, H2.1, J1.5, J1.12, J1.18, J1.20, MOD1.1 (GND), MOD1.8 (GND), MOD1.14 (GND), MOD1.16 (GND), MOD1.27 (GND), MOD1.29 (GND), MOD1.35 (GND), MOD1.42 (GND), MOD1.48 (GND), MOD1.49 (GND), MOD1.51 (GND), MOD1.G1 (GND), MOD1.G2 (GND), MOD1.G3 (GND), MOD1.G4 (GND), MOD1.G5 (GND), MOD1.G6 (GND), MOD1.G7 (GND), MOD1.G8 (GND), MOD1.G9 (GND), MOD1.G10 (GND), MOD1.G11 (GND), MOD1.G12 (GND), MOD1.G13 (GND), MOD1.G14 (GND), MOD1.G15 (GND), MOD1.G16 (GND), MOD1.G17 (GND), R2.1, R3.1, R5.1, R6.1, R7.1, U1.2 (GND), X1.2 (GND)
unnamed: MOD1.5 (STRAP_0), R3.2
unnamed: MOD1.4 (STRAP_2), R2.2
unnamed: MOD1.34 (SUSCLK), X1.3 (OUT)
unnamed: C4.1, FB1.2, MOD1.28 (USB2_AVDD33)
unnamed: MOD1.26 (USB2_RREF), R7.2
unnamed: MOD1.30 (VDDIO), R4.2, R8.2
unnamed: C7.1, R9.1, X1.1 (Tri-State), X1.4 (VDD)
RK_UART1_CTS_1V8: J1.10, MOD1.46 (BT_UART_RTSn)
RK_UART1_RTS_1V8: J1.11, MOD1.44 (BT_UART_CTSn)
RK_UART1_RX_1V8: J1.8, MOD1.43 (BT_UART_TXD)
RK_UART1_TX_1V8: J1.9, MOD1.45 (BT_UART_RXD)
RK_WIFI_GPIO1: J1.7, MOD1.33 (WL_REG_ON), R6.2, R10.1
RK_WIFI_GPIO2: J1.6, MOD1.32 (BT_REG_ON), R5.2, R11.1
SDIO_CLK: J1.19, MOD1.15 (SDIO_CLK)
SDIO_CMD: J1.17, MOD1.12 (SDIO_CMD)
SDIO_D0: J1.16, MOD1.9 (SDIO_DATA0)
SDIO_D1: J1.15, MOD1.10 (SDIO_DATA1)
SDIO_D2: J1.14, MOD1.13 (SDIO_DATA2)
SDIO_D3: J1.13, MOD1.11 (SDIO_DATA3)
USB_N: J1.3, MOD1.24 (USB2_DM)
USB_P: J1.4, MOD1.25 (USB2_DP)

Notes on the sheet:
WiFi/BT/Internal Expansion (flipped)
Straps[2-0]: WLAN/BT 000 = USB/USB 101 = SDIO1V8/UART 100 = SDIO3V3/UART
TODO: better harmonics with 3.6V?
