cetola/reform-next-mirror/nref-wifi/nref-wifi.kicad_pcb

## KiCad design nref-wifi/nref-wifi.kicad_pcb (continued)

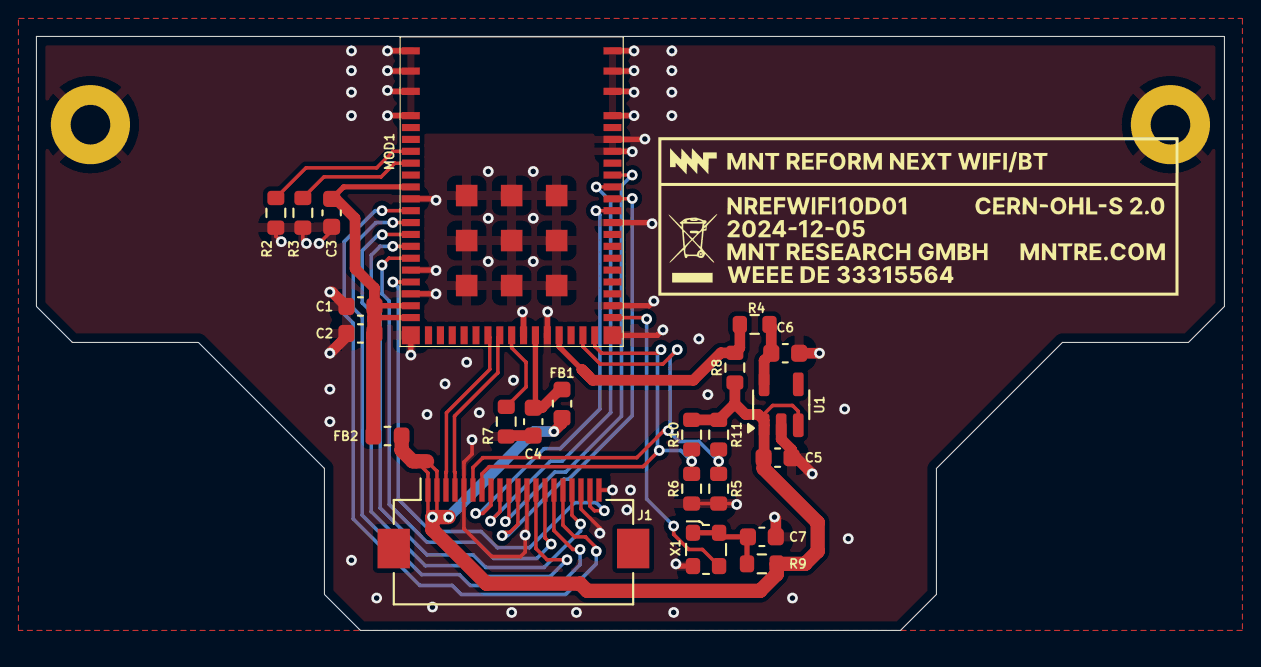
[picture p201: board nref-wifi.kicad_pcb from above]

Board: 2 copper layers, 66.0 x 33.0 mm, 26 parts (0 on the bottom side), 25 nets.
