cetola/reform-next-mirror/hdmi-edp2/hdmi-edp2.kicad_pcb

## KiCad design hdmi-edp2/hdmi-edp2.kicad_pcb (2024-08-20)

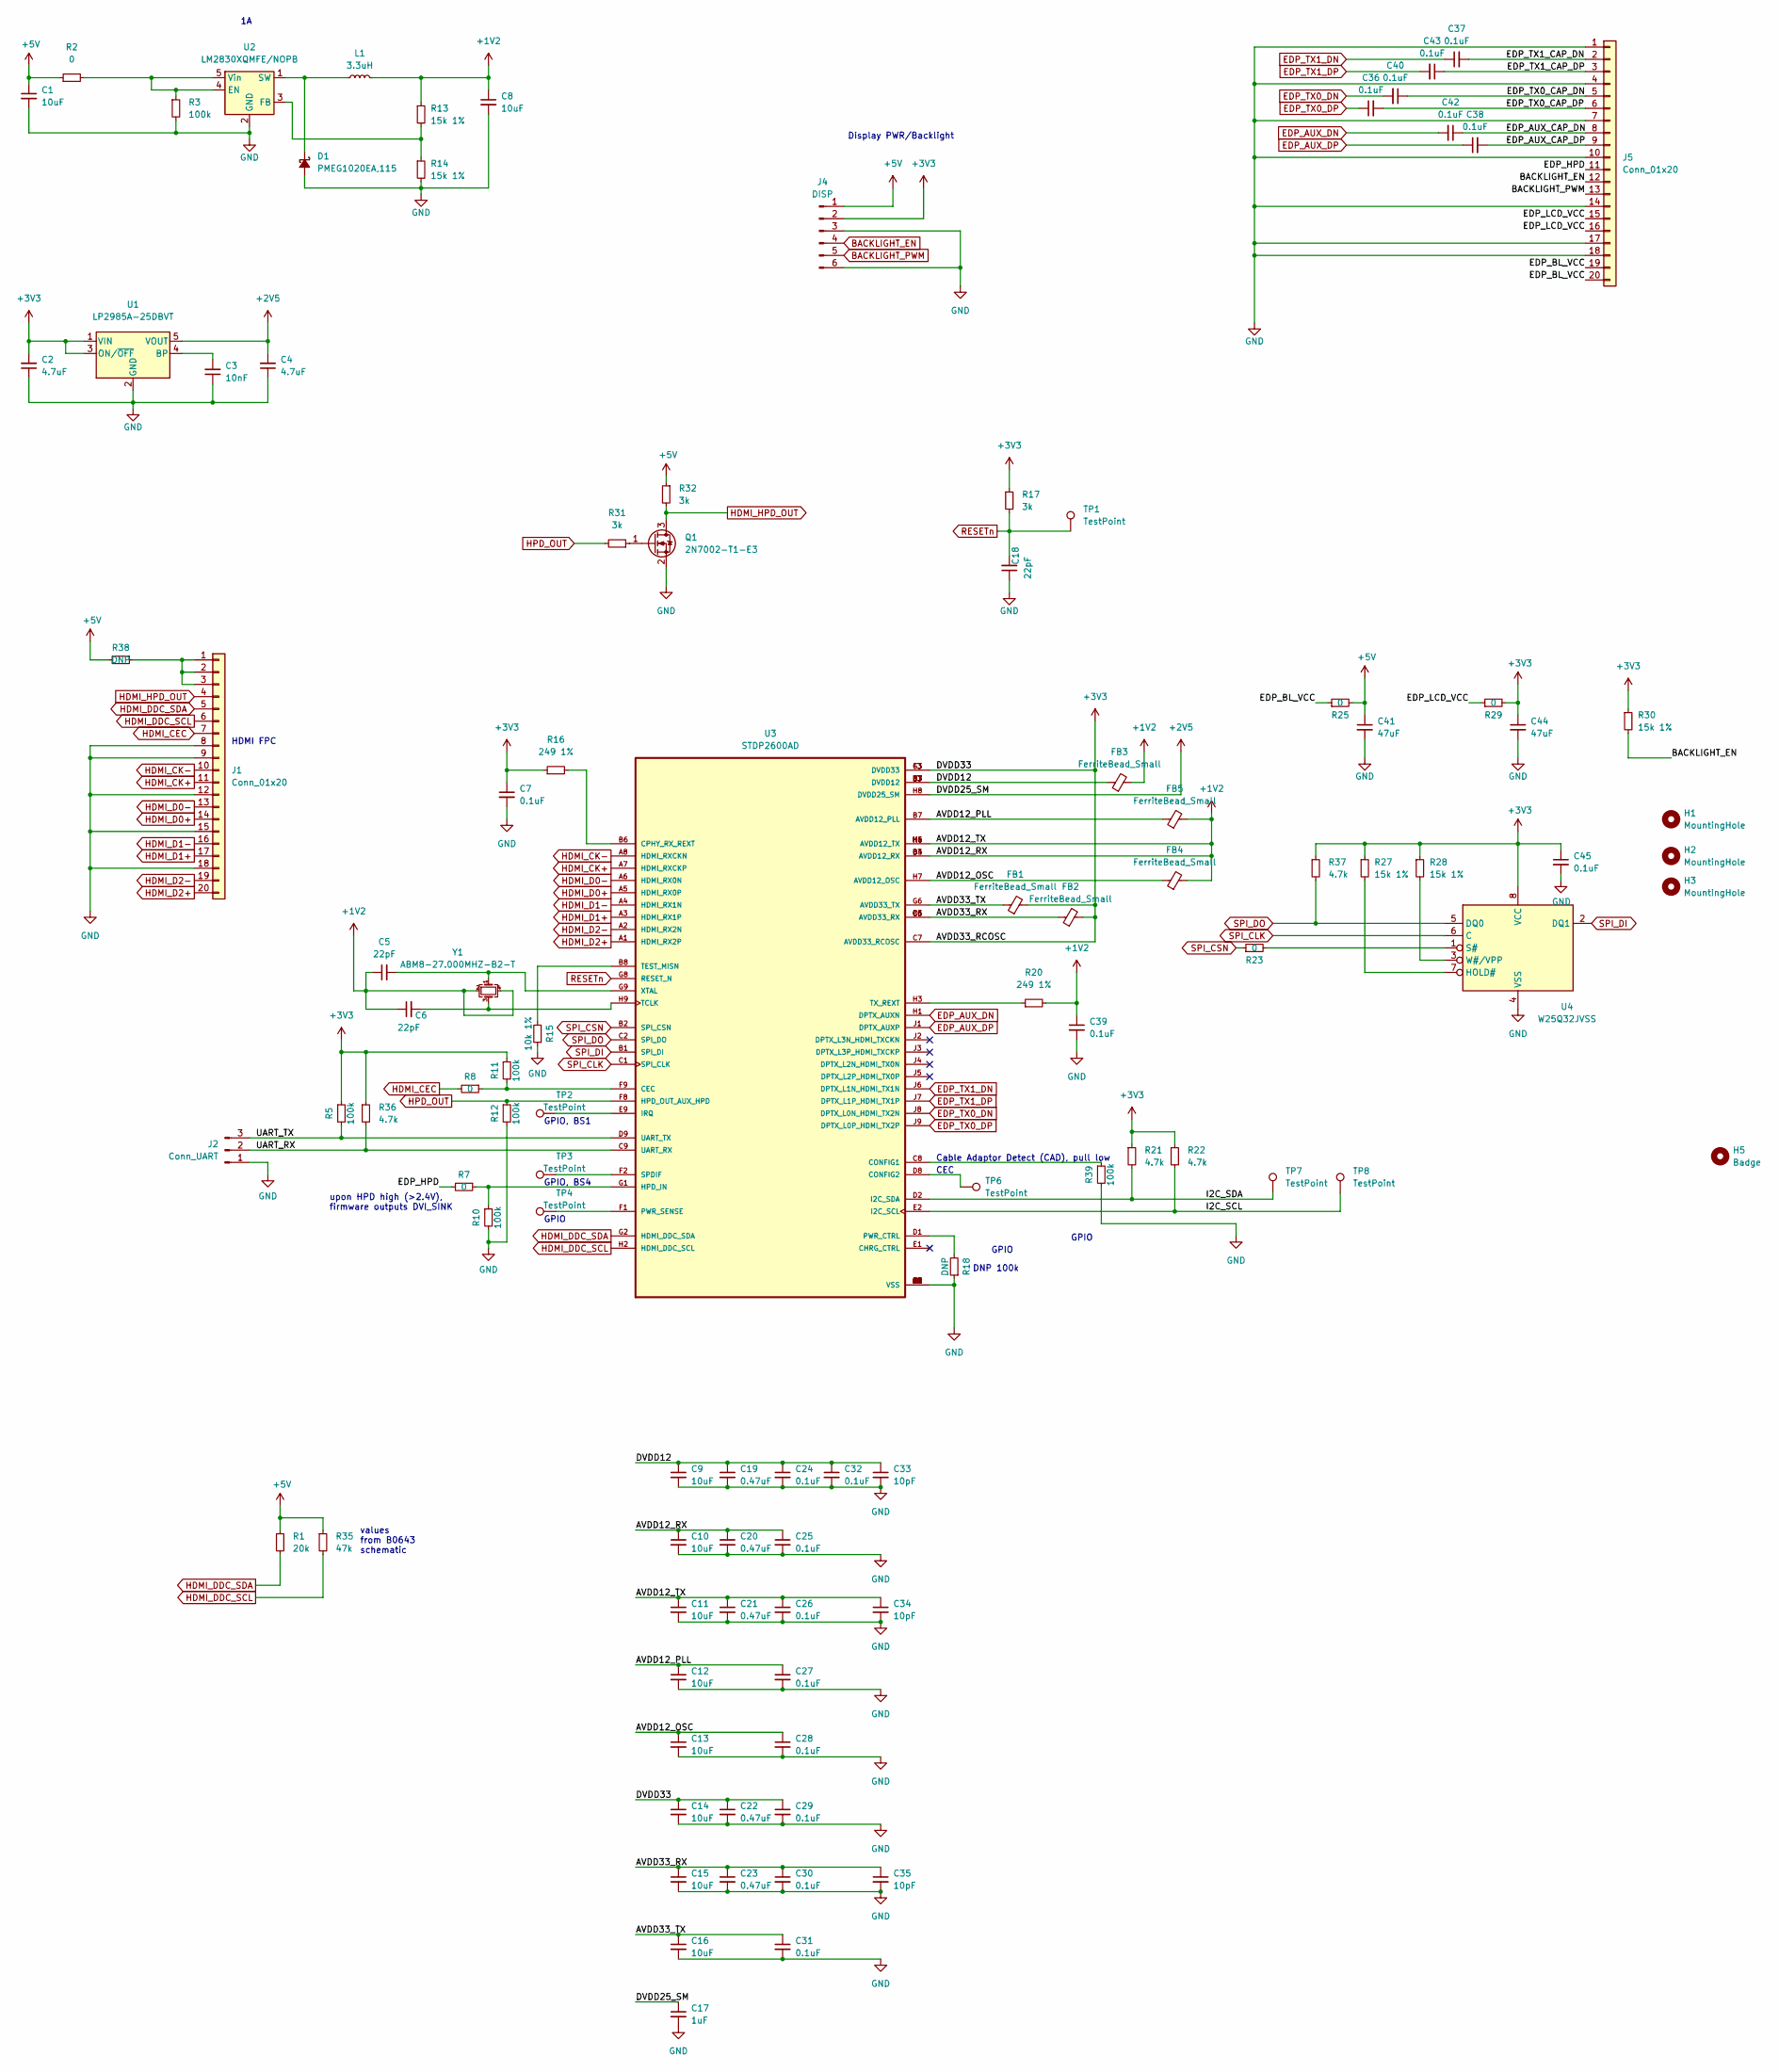
[picture p202: schematic hdmi-edp2.kicad_sch, MNT Reform HDMI to eDP Converter]

Parts:
C1, C8: 10uF; C_0603_1608Metric
C2, C4: 4.7uF; C_0402_1005Metric
C3: 10nF; C_0402_1005Metric
C5, C6, C18: 22pF; C_0402_1005Metric
C7, C24, C25, C26, C27, C28, C29, C30, C31, C32, C36, C37, C38, C39, C40, C42, C43, C45: 0.1uF; C_0402_1005Metric
C9, C10, C11, C12, C13, C14, C15, C16: 10uF; C_0402_1005Metric
C17: 1uF; C_0402_1005Metric
C19, C20, C21, C22, C23: 0.47uF; C_0402_1005Metric
C33, C34, C35: 10pF; C_0402_1005Metric
C41, C44: 47uF; C_0805_2012Metric
D1: PMEG1020EA,115; D_SOD-323
FB1, FB2, FB3, FB4, FB5: FerriteBead_Small; R_0603_1608Metric
H1, H2, H3: MountingHole; MountingHole_2.2mm_M2
H5: Badge; mnt-rhdp-badge-d1
J1: Conn_01x20; Hirose_FH12-20S-0.5SH_1x20-1MP_P0.50mm_Horizontal
J2: Conn_UART; PinHeader_1x03_P2.54mm_Vertical
J4: DISP; JST_SH_SM06B-SRSS-TB_1x06-1MP_P1.00mm_Horizontal
J5: Conn_01x20; JST_SH_SM20B-SRSS-TB_1x20-1MP_P1.00mm_Horizontal
L1: 3.3uH; L_1210_3225Metric
Q1: 2N7002-T1-E3; SOT-23
R1: 20k; R_0603_1608Metric
R2, R7, R8, R23, R25, R29: 0; R_0603_1608Metric
R3, R5, R10, R11, R12, R39: 100k; R_0603_1608Metric
R13, R14, R27, R28, R30: 15k 1%; R_0603_1608Metric
R15: 10k 1%; R_0603_1608Metric
R16, R20: 249 1%; R_0603_1608Metric
R17, R31, R32: 3k; R_0603_1608Metric
R18, R38: DNP; R_0603_1608Metric
R21, R22, R36, R37: 4.7k; R_0603_1608Metric
R35: 47k; R_0603_1608Metric
TP1, TP2, TP3, TP4, TP6, TP7, TP8: TestPoint; TestPoint_Pad_D1.0mm
U1: LP2985A-25DBVT; SOT-23-5
U2: LM2830XQMFE/NOPB; SOT-23-5
U3: STDP2600AD; BGA81C80P9X9_800X800X140N
U4: W25Q32JVSS; SOIC-8W_5.3x5.3mm_P1.27mm
Y1: ABM8-27.000MHZ-B2-T; Crystal_SMD_3225-4Pin_3.2x2.5mm

Connections:
+1V2: C5.1, C6.1, C8.1, C10.1, C11.1, C20.1, C21.1, C25.1, C26.1, C34.1, C39.1, FB3.2, FB4.2, FB5.2, L1.2, R13.1, R20.2, U3.B3 (AVDD12_RX), U3.B4 (AVDD12_RX), U3.H4 (AVDD12_TX), U3.H5 (AVDD12_TX), U3.H6 (AVDD12_TX), Y1.2, Y1.4
+2V5: C4.2, C17.1, U1.5 (VOUT), U3.H8 (DVDD25_SM)
+3V3: C2.2, C7.1, C14.1, C22.1, C29.1, C44.1, C45.1, FB1.2, FB2.2, J4.2, R5.1, R11.1, R16.1, R17.1, R21.1, R22.1, R27.1, R28.1, R29.2, R30.1, R36.1, R37.1, U1.1 (VIN), U1.3 (ON/~OFF), U3.C7 (AVDD33_RCOSC), U3.F3 (DVDD33), U3.G3 (DVDD33), U4.8 (VCC)
+5V: C1.1, C41.1, J4.1, R1.1, R2.1, R25.2, R32.1, R35.1, R38.2
/AVDD12_OSC: C13.1, C28.1, FB4.1, U3.H7 (AVDD12_OSC)
/AVDD12_PLL: C12.1, C27.1, FB5.1, U3.B7 (AVDD12_PLL)
/AVDD33_RX: C15.1, C23.1, C30.1, C35.1, FB2.1, U3.B5 (AVDD33_RX), U3.C5 (AVDD33_RX), U3.C6 (AVDD33_RX)
/AVDD33_TX: C16.1, C31.1, FB1.1, U3.G6 (AVDD33_TX)
/DVDD12: C9.1, C19.1, C24.1, C32.1, C33.1, FB3.1, U3.D3 (DVDD12), U3.D7 (DVDD12), U3.E3 (DVDD12), U3.E7 (DVDD12)
/EDP_AUX_CAP_DN: C42.1, J5.8
/EDP_AUX_CAP_DP: C38.2, J5.9
/EDP_BL_VCC: J5.19, J5.20, R25.1
/EDP_HPD: J5.11, R7.2
/EDP_LCD_VCC: J5.15, J5.16, R29.1
/EDP_TX0_CAP_DN: C40.1, J5.5
/EDP_TX0_CAP_DP: C36.2, J5.6
/EDP_TX1_CAP_DN: C37.2, J5.2
/EDP_TX1_CAP_DP: C43.1, J5.3
/I2C_SCL: R22.2, TP8.1, U3.E2 (I2C_SCL)
/I2C_SDA: R21.2, TP7.1, U3.D2 (I2C_SDA)
/UART_RX: J2.2, R36.2, U3.C9 (UART_RX)
/UART_TX: J2.3, R5.2, U3.D9 (UART_TX)
BACKLIGHT_EN: J4.4, J5.12, R30.2
BACKLIGHT_PWM: J4.5, J5.13
EDP_AUX_DN: C42.2, U3.H1 (DPTX_AUXN)
EDP_AUX_DP: C38.1, U3.J1 (DPTX_AUXP)
EDP_TX0_DN: C40.2, U3.J8 (DPTX_L0N_HDMI_TX2N)
EDP_TX0_DP: C36.1, U3.J9 (DPTX_L0P_HDMI_TX2P)
EDP_TX1_DN: C37.1, U3.J6 (DPTX_L1N_HDMI_TX1N)
EDP_TX1_DP: C43.2, U3.J7 (DPTX_L1P_HDMI_TX1P)
GND: C1.2, C2.1, C3.1, C4.1, C7.2, C8.2, C9.2, C10.2, C11.2, C12.2, C13.2, C14.2, C15.2, C16.2, C17.2, C18.1, C19.2, C20.2, C21.2, C22.2, C23.2, C24.2, C25.2, C26.2, C27.2, C28.2, C29.2, C30.2, C31.2, C32.2, C33.2, C34.2, C35.2, C39.2, C41.2, C44.2, C45.2, D1.2 (A), J1.8, J1.9, J1.12, J1.15, J1.18, J2.1, J4.3, J4.6, J5.1, J5.4, J5.7, J5.10, J5.14, J5.17, J5.18, Q1.2 (S), R3.2, R10.2, R12.2, R14.2, R15.1, R18.1, R39.2, U1.2 (GND), U2.2 (GND), U3.C3 (VSS), U3.C4 (VSS), U3.D4 (VSS), U3.D5 (VSS), U3.D6 (VSS), U3.E4 (VSS), U3.E5 (VSS), U3.E6 (VSS), U3.E8 (VSS), U3.F4 (VSS), U3.F5 (VSS), U3.F6 (VSS), U3.F7 (VSS), U3.G4 (VSS), U3.G5 (VSS), U3.G7 (VSS), U4.4 (VSS)
HDMI_CEC: J1.7, R8.2
HDMI_CK+: J1.11, U3.A7 (HDMI_RXCKP)
HDMI_CK-: J1.10, U3.A8 (HDMI_RXCKN)
HDMI_D0+: J1.14, U3.A5 (HDMI_RX0P)
HDMI_D0-: J1.13, U3.A6 (HDMI_RX0N)
HDMI_D1+: J1.17, U3.A3 (HDMI_RX1P)
HDMI_D1-: J1.16, U3.A4 (HDMI_RX1N)
HDMI_D2+: J1.20, U3.A1 (HDMI_RX2P)
HDMI_D2-: J1.19, U3.A2 (HDMI_RX2N)
HDMI_DDC_SCL: J1.6, R35.2, U3.H2 (HDMI_DDC_SCL)
HDMI_DDC_SDA: J1.5, R1.2, U3.G2 (HDMI_DDC_SDA)
HDMI_HPD_OUT: J1.4, Q1.3 (D), R32.2
HPD_OUT: R12.1, R31.2, U3.F8 (HPD_OUT_AUX_HPD)
unnamed: D1.1 (K), L1.1, U2.1 (SW)
unnamed: J1.1, J1.2, J1.3, R38.1
unnamed: Q1.1 (G), R31.1
unnamed: C3.2, U1.4 (BP)
unnamed: R2.2, R3.1, U2.4 (EN), U2.5 (Vin)
unnamed: R13.2, R14.1, U2.3 (FB)
unnamed: R8.1, R11.2, U3.F9 (CEC)
unnamed: R39.1, U3.C8 (CONFIG1)
unnamed: TP6.1, U3.D8 (CONFIG2)
unnamed: R16.2, U3.B6 (CPHY_RX_REXT)
unnamed: R7.1, R10.1, U3.G1 (HPD_IN)
unnamed: TP2.1, U3.E9 (IRQ)
unnamed: R18.2, U3.D1 (PWR_CTRL)
unnamed: TP4.1, U3.F1 (PWR_SENSE)
unnamed: TP3.1, U3.F2 (SPDIF)
unnamed: C6.2, U3.H9 (TCLK), Y1.3
unnamed: R15.2, U3.B8 (TEST_MISN)
unnamed: R20.1, U3.H3 (TX_REXT)
unnamed: C5.2, U3.G9 (XTAL), Y1.1
unnamed: R27.2, U4.7 (HOLD#)
unnamed: R23.2, U4.1 (S#)
unnamed: R28.2, U4.3 (W#/VPP)
RESETn: C18.2, R17.2, TP1.1, U3.G8 (RESET_N)
SPI_CLK: U3.C1 (SPI_CLK), U4.6 (C)
SPI_CSN: R23.1, U3.B2 (SPI_CSN)
SPI_DI: U3.B1 (SPI_DI), U4.2 (DQ1)
SPI_DO: R37.2, U3.C2 (SPI_DO), U4.5 (DQ0)

Notes on the sheet:
GPIO, BS4
GPIO
DNP 100k
GPIO, BS1
Display PWR/Backlight
Cable Adaptor Detect (CAD), pull low
values from B0643 schematic
CEC
upon HPD high (>2.4V), firmware outputs DVI_SINK
HDMI FPC

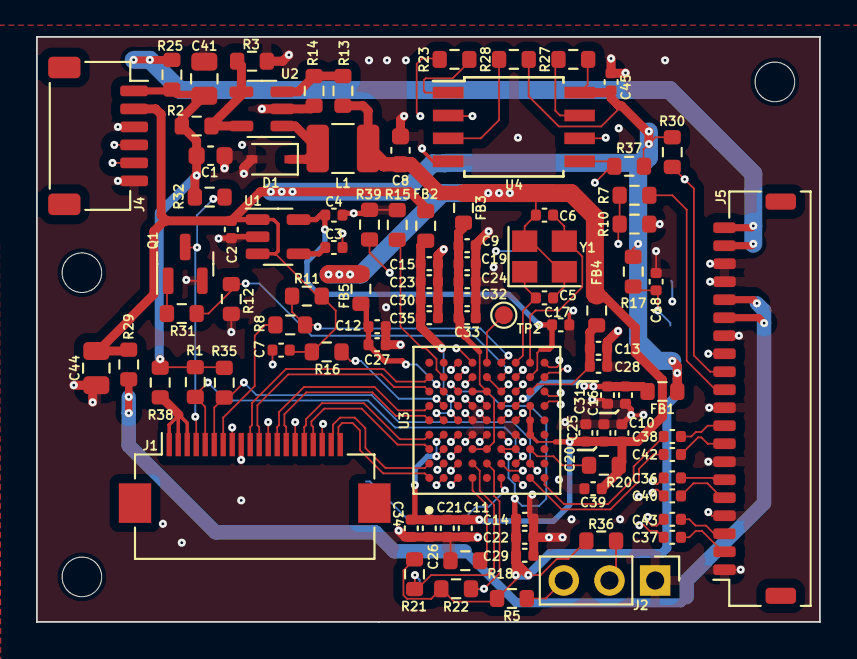
[picture p203: board hdmi-edp2.kicad_pcb from above]

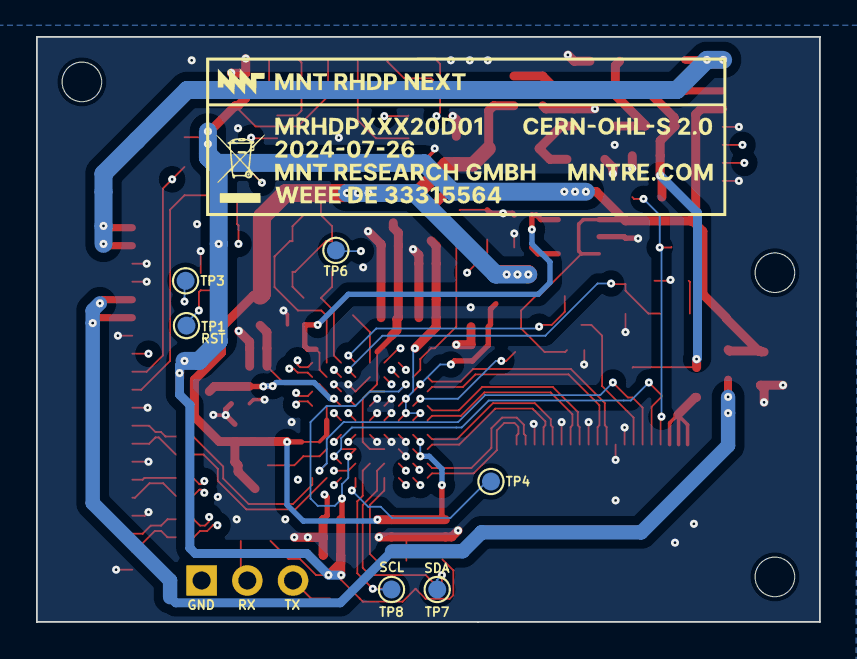
[picture p204: board hdmi-edp2.kicad_pcb from below]

Board: 4 copper layers, 43.5 x 32.5 mm, 104 parts (7 on the bottom side), 71 nets.
