cetola/reform-next-mirror/nref-flex/nref-flex-usb3-one/nref-flex-usb3-one-130mm.kicad_pcb

## KiCad design nref-flex/nref-flex-usb3-one/nref-flex-usb3-one-130mm.kicad_pcb (2025-10-03)

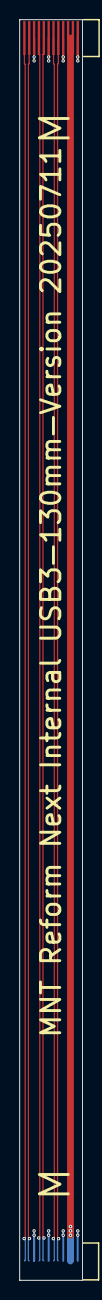
[picture p205: board nref-flex-usb3-one-130mm.kicad_pcb from above]

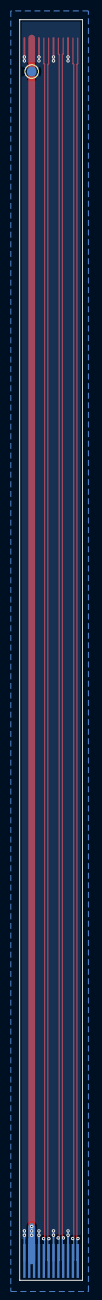
[picture p206: board nref-flex-usb3-one-130mm.kicad_pcb from below]

Board: 2 copper layers, 6.5 x 129.9 mm, 3 parts (2 on the bottom side), 8 nets.

Parts:
J8, J9: Conn_01x12_Pin; FPC_12
TP1: TestPoint; TestPoint_Pad_D1.0mm

Connections:
+5V: J8.2, J8.3, J9.10, J9.11
GND: J8.1, J8.4, J8.7, J8.10, J9.3, J9.6, J9.9, J9.12, TP1.1
USB1_DN: J8.12, J9.1
USB1_DP: J8.11, J9.2
USB1_RXN: J8.6, J9.7
USB1_RXP: J8.5, J9.8
USB1_TXN: J8.9, J9.4
USB1_TXP: J8.8, J9.5
