cetola/reform-next-mirror/nref-sysctl-fw/src/fusb302b.c

/*
 * PD Buddy Firmware Library - USB Power Delivery for everyone
 * Copyright 2017-2018 Clayton G. Hobbs
 *
 * Licensed under the Apache License, Version 2.0 (the "License");
 * you may not use this file except in compliance with the License.
 * You may obtain a copy of the License at
 *
 *     http://www.apache.org/licenses/LICENSE-2.0
 *
 * Unless required by applicable law or agreed to in writing, software
 * distributed under the License is distributed on an "AS IS" BASIS,
 * WITHOUT WARRANTIES OR CONDITIONS OF ANY KIND, either express or implied.
 * See the License for the specific language governing permissions and
 * limitations under the License.
 */

#include <stdio.h>

#include "fusb302b.h"
#include "hardware/i2c.h"
#include "machine.h"
#include "sysctl.h"

#include <pd.h>

uint8_t fusb_read_byte(uint8_t addr)
{
  sysctl_disable_irqs();
  uint8_t buf;
  i2c_write_blocking(i2c0, FUSB_ADDR, &addr, 1, true);
  i2c_read_blocking(i2c0, FUSB_ADDR, &buf, 1, false);
  sysctl_enable_irqs();
  return buf;
}

void fusb_read_buf(uint8_t addr, uint8_t size, uint8_t *buf)
{
  sysctl_disable_irqs();
  i2c_write_blocking(i2c0, FUSB_ADDR, &addr, 1, true);
  i2c_read_blocking(i2c0, FUSB_ADDR, buf, size, false);
  sysctl_enable_irqs();
}

void fusb_write_byte(uint8_t addr, uint8_t byte)
{
  sysctl_disable_irqs();
  uint8_t buf[2] = {addr, byte};
  i2c_write_blocking(i2c0, FUSB_ADDR, buf, 2, false);
  sysctl_enable_irqs();
}

void fusb_write_buf(uint8_t addr, uint8_t size, const uint8_t *buf)
{
  sysctl_disable_irqs();
  uint8_t txbuf[size + 1];
  txbuf[0] = addr;
  for (int i = 0; i < size; i++) {
    txbuf[i + 1] = buf[i];
  }
  i2c_write_blocking(i2c0, FUSB_ADDR, txbuf, size + 1, false);
  sysctl_enable_irqs();
}

void fusb_send_message(const union pd_msg *msg)
{
  /* Token sequences for the FUSB302B */
  static uint8_t sop_seq[5] = {
    FUSB_FIFO_TX_SOP1,
    FUSB_FIFO_TX_SOP1,
    FUSB_FIFO_TX_SOP1,
    FUSB_FIFO_TX_SOP2,
    FUSB_FIFO_TX_PACKSYM
  };
  static uint8_t eop_seq[4] = {
    FUSB_FIFO_TX_JAM_CRC,
    FUSB_FIFO_TX_EOP,
    FUSB_FIFO_TX_TXOFF,
    FUSB_FIFO_TX_TXON
  };

  /* Get the length of the message: a two-octet header plus NUMOBJ four-octet
   * data objects */
  uint8_t msg_len = 2 + 4 * PD_NUMOBJ_GET(msg);

  /* Set the number of bytes to be transmitted in the packet */
  sop_seq[4] = FUSB_FIFO_TX_PACKSYM | msg_len;

  /* Write all three parts of the message to the TX FIFO */
  fusb_write_buf(FUSB_FIFOS, 5, sop_seq);
  fusb_write_buf(FUSB_FIFOS, msg_len, msg->bytes);
  fusb_write_buf(FUSB_FIFOS, 4, eop_seq);
}

bool fusb_read_message(union pd_msg *msg)
{
  uint8_t garbage[4];

  /* If this isn't an SOP message, return error.
   * Because of our configuration, we should be able to assume this means the
   * buffer is empty, and not try to read past a non-SOP message. */
  // TODO: [zeha] check if the above comment is really true
  uint8_t rxb = fusb_read_byte(FUSB_FIFOS);
  if (rxb == 0) {
    return false;
  }
  if ((rxb & FUSB_FIFO_RX_TOKEN_BITS) != FUSB_FIFO_RX_SOP) {
    printf("# [fusb] rxb = 0x%02x - skipping\n", rxb);
    return false;
  }

  /* Read the message header into msg */
  fusb_read_buf(FUSB_FIFOS, 2, msg->bytes);
  /* Get the number of data objects */
  uint8_t numobj = PD_NUMOBJ_GET(msg);
  /* If there is at least one data object, read the data objects */
  printf("# [fusb] rxb 0x%02x msgtype 0x%02x msgid %d role %s numobj %d size %d\n",
          rxb, PD_MSGTYPE_GET(msg), PD_MESSAGEID_GET(msg), PD_POWERROLE_STR(msg), numobj, numobj * 4);
  if (numobj > 0) {
    fusb_read_buf(FUSB_FIFOS, numobj * 4, msg->bytes + 2);
  }
  /* Throw the CRC32 in the garbage, since the PHY already checked it. */
  fusb_read_buf(FUSB_FIFOS, 4, garbage);

  return true;
}
