cetola/reform-next-mirror/nref-sysctl-fw/inc/bq25792.h

#ifndef _BQ25792_H
#define _BQ25792_H

#include <stdint.h>

uint8_t bq25792_read_byte(uint8_t addr);
int16_t bq25792_read_word_signed(uint8_t addr);
uint16_t bq25792_read_word(uint8_t addr);
void bq25792_write_byte(uint8_t addr, uint8_t byte);
void bq25792_write_word(uint8_t addr, uint16_t word);
void bq25792_write_word_signed(uint8_t addr, int16_t word);
void bq25792_set_debug(int debug);

#endif
