cetola/reform-next-mirror/nref-sysctl-fw/src/utils.c

/*
  SPDX-License-Identifier: GPL-3.0-or-later
 */

#include <stdio.h>
#include "hardware/i2c.h"

void i2c_scan(i2c_inst_t* i2c) {
  int id = 0;
  if (i2c == i2c1) id = 1;

  printf("\nI2C Scan (I2C %d)\n", id);
  printf("   0  1  2  3  4  5  6  7  8  9  A  B  C  D  E  F\n");

  for (int addr = 0; addr < (1 << 7); ++addr) {
    if (addr % 16 == 0) {
      printf("%02x ", addr);
    }

    int ret;
    uint8_t rxdata;
    ret = i2c_read_blocking(i2c, addr, &rxdata, 1, false);

    printf(ret < 0 ? "." : "@");
    printf(addr % 16 == 15 ? "\n" : "  ");
  }
}
