cetola/reform-next-mirror/(commit log)

2024-02-22 add batterypack pcb sketch
    [18650-d18mm.step, BQ76905RGRR.step, S7131-45R.stp, SM07B-SRSS-TB.STEP, nref-batterypack.kicad_pcb, nref-batterypack.kicad_sch, s1741-46r.stp]
2024-02-22 add motherboard pcb early WIP
    [09452812561.stp, 105450-0101.step, 1747981-1.step, 19-337-R6GHBHC-A01-2T.STEP, 2199230-5.step, 3-2328724-1.step, 3215-crystal.step, 467650301.stp]
2024-02-22 add 202401 case proto and fc assembly
    [Reform Next_2024.01.29.step, bottom enclosure_2024.01.29.stl, closing keyboard_2024.01.29.stl, nref-case-20240201-assembly.FCStd, top enclosure_screen closing back_2024.01.29.stl, top enclosure_screen closing_2024.01.29.stl]
2024-03-25 add initial 4S battery pack with hs-switch
    [nref-batterypack.kicad_pcb, nref-batterypack.kicad_sch]
2024-04-28 motherboard: upgrade bucks to lm62460; some power layout
    [LM62460QRPHRQ1.step, nref-motherboard.kicad_pcb, nref-motherboard.kicad_sch]
2024-04-29 motherboard: lots of connector shuffling and schematics
    [FH12-12S-0.5SH.stp, FH12-14S-0.5SH.stp, FH12-20S-0.5SH.stp, SM02B-SRSS-TB.STEP, SM04B-SRSS-TB.STEP, SM06B-SRSS-TB.STEP, SM09B-SRSS-TB.STEP, SM10B-SRSS-TB.STEP]
2024-04-30 motherboard: continue design; almost feature complete
    [nref-motherboard.kicad_pcb, nref-motherboard.kicad_sch]
2024-05-24 motherboard: update battery pack connectors, pcie lanes
    [nref-motherboard.kicad_sch]
2024-05-25 motherboard: some initial routing, mostly power
    [nref-motherboard.kicad_pcb, nref-motherboard.kicad_sch]
2024-05-27 ports test
    [105450-0101.step, 467650301.stp, 692121230100.step, WE-692122030100.stp, nref-ports-one.kicad_pcb, nref-ports-one.kicad_sch]
2024-06-01 motherboard: drv_sup diodes, battery and charger i2c and alerts
    [nref-motherboard.kicad_sch]
2024-06-01 motherboard: consolidate switches and jumpers into one 8x1.27mm dip, liion/lifepo switch
    [nref-motherboard.kicad_pcb, nref-motherboard.kicad_sch]
2024-06-05 motherboard: connect extra pcie lanes
    [nref-motherboard.kicad_sch]
2024-06-05 motherboard: schematic done for d-1?
    [nref-motherboard.kicad_sch]
2024-06-05 lots of motherboard routing
    [nref-motherboard.kicad_pcb, nref-motherboard.kicad_sch]
2024-06-06 mb: swap some intersecting connectors; more routing
    [nref-motherboard.kicad_pcb, nref-motherboard.kicad_sch]
2024-06-07 mb routing snapshot
    [nref-motherboard.kicad_pcb, nref-motherboard.kicad_sch]
2024-06-07 mb silkscreen cleaned up
    [nref-motherboard.kicad_pcb, nref-motherboard.kicad_sch]
2024-06-07 mb fully routed, logo added
    [SM07B-SRSS-TB.STEP, nref-motherboard.kicad_pcb]
2024-06-11 ports-one WIP
    [09452812561.stp, 7498111120R.step, CUI_DEVICES_SJ-43614-SMT-TR.step, CUI_DEVICES_SJ2-3593D-SMT-TR.step, DM3AT-SF-PEJM5.stp, nref-ports-one.kicad_pcb, nref-ports-one.kicad_sch]
2024-06-11 ports-two initial
    [09452812561.stp, 105450-0101.step, 467650301.stp, 692121230100.step, 7498111120R.step, CUI_DEVICES_SJ-43614-SMT-TR.step, CUI_DEVICES_SJ2-3593D-SMT-TR.step, DM3AT-SF-PEJM5.stp]
2024-06-11 motherboard d-1 production snapshot
    [nref-motherboard.kicad_pcb, nref-motherboard.kicad_sch]
2024-06-12 ports one: some routing
    [nref-ports-one.kicad_pcb, nref-ports-one.kicad_sch]
2024-06-13 ports 1 routing, ports 2 location tweaks
    [nref-ports-one.kicad_pcb, nref-ports-one.kicad_sch, nref-ports-two.kicad_pcb]
2024-06-14 ports one: more design and more routing
    [FUSB302BMPX.STEP, HD3SS3220IRNHT.step, IND_TAIYO_NRH3012_TAY.step, SM09B-SRSS-TB.STEP, TLV320AIC3100IRHBR.STEP, nref-ports-one.kicad_pcb, nref-ports-one.kicad_sch]
2024-06-17 motherboard: specify all parts, complete BOM
    [nref-motherboard.csv, nref-motherboard.kicad_sch]
2024-06-20 ports-one snapshot
    [nref-ports-one.kicad_pcb, nref-ports-one.kicad_sch]
2024-06-20 ports two: initial (mostly complete) schematic
    [nref-ports-two.kicad_pcb, nref-ports-two.kicad_sch]
2024-06-21 ports two: rough placement of components
    [CM2020-00TR--3DModel-STEP-56544.STEP, HD3SS3220IRNHT.step, nref-ports-two.kicad_pcb]
2024-06-21 motherboard: add bringup notes to schematic
    [nref-motherboard.kicad_sch]
2024-06-21 batterypack and ports one snapshot
    [nref-batterypack.kicad_pcb, nref-ports-one.kicad_pcb, nref-ports-one.kicad_sch]
2024-07-04 ports-two: hdmi routing snapshot
    [nref-ports-two.kicad_pcb, nref-ports-two.kicad_sch]
2024-07-04 ports two: usb snapshot
    [nref-ports-two.kicad_pcb, nref-ports-two.kicad_sch]
2024-07-05 port board two fully routed
    [nref-ports-two.kicad_pcb, nref-ports-two.kicad_sch]
2024-07-25 ports two bom adjustments
    [nref-ports-two.kicad_pcb, nref-ports-two.kicad_sch]
2024-07-25 WIP batterypack-top polishing
    [SM02B-SRSS-TB.STEP, nref-batterypack.kicad_pcb, nref-batterypack.kicad_sch]
2024-07-26 batterypack: finish front d-1, add back d-1
    [nref-batterypack-backside.kicad_pcb, nref-batterypack-backside.kicad_sch, nref-batterypack.kicad_pcb]
2024-07-28 v2 of the bms now based on the final outline
    [nref-batterypack.kicad_pcb, nref-batterypack.kicad_sch]
2024-07-30 batterypack: pick parts
    [nref-batterypack-backside.kicad_pcb, nref-batterypack.kicad_pcb, nref-batterypack.kicad_sch]
2024-08-15 fix load switch nmos and gate prot diode polarity
    [nref-batterypack.kicad_pcb, nref-batterypack.kicad_sch]
2024-08-15 WIP camera board
    [68712414522 (rev1).stp, BGA_1R1YKAR_TEX.step, CYUSB3064-BZXI.STEP, DQN0004A.stp, ECS-1618.STEP, K3D-DX07S024WJ3-V2_JAE_Proprietary.STEP, Nexperia-WLCSP5_2-1-2_0.77x1.17mm.step, RKS0020A.stp]
2024-08-19 WIP trackpad
    [MX_ULP_Cap.step, nref-trackpad.kicad_pcb, nref-trackpad.kicad_sch]
2024-08-20 add port board three spec
    [nref-wifi.kicad_pcb, nref-wifi.kicad_sch]
2024-08-20 port boards spec: correct some links/images
2024-08-20 add photos, battery system docs
2024-08-20 sysctl: implement charger and pack monitor comms
2024-08-20 add hdmi-edp adapter v2 sources
    [467650301.stp, SM06B-SRSS-TB.STEP, SM20B-SRSS-TB.STEP, hdmi-edp2.kicad_pcb, hdmi-edp2.kicad_sch]
2024-08-22 trackpad: add first button board design d-1
    [MX_ULP_Cap.step, nref-trackpad.kicad_pcb, nref-trackpad.kicad_sch, nref_keycap_2024.08.20.step]
2024-08-22 camera: redesigned and fully routed
    [PW0014A.stp, SM20B-SRSS-TB.STEP, reform-camera.kicad_pcb, reform-camera.kicad_sch]
2024-08-23 camera: d-3 done, off to board house
    [reform-camera.kicad_pcb, reform-camera.kicad_sch]
2024-08-23 camera: add fpc adapter pcb
    [SM20B-SRSS-TB.STEP, nref-camera-adapter.kicad_pcb, nref-camera-adapter.kicad_sch]
2024-09-24 add full 2024-09-24 case assembly as STEP
2024-11-08 WIP mobo d2 snapshot
    [nref-motherboard.kicad_pcb, nref-motherboard.kicad_sch]
2024-11-12 motherboard: d-2 routing snapshot (0 unrouted)
    [nref-motherboard.kicad_pcb, nref-motherboard.kicad_sch]
2024-11-18 motherboard d-2 routing complete
    [10102166A812A.stp, nref-motherboard.kicad_pcb, nref-motherboard.kicad_sch]
2024-11-26 trackpad buttons: move left and right button further out
    [nref-trackpad.kicad_pcb, nref-trackpad.kicad_sch]
2024-11-26 batterypack front/back: update board outline/mounting holes
    [nref-batterypack-backside.kicad_pcb, nref-batterypack-backside.kicad_sch, nref-batterypack.kicad_pcb, nref-batterypack.kicad_sch]
2024-12-12 wip: sysctl-fw: add support for second battery pack
2024-12-27 add trackpad mount 20241202 stl
    [nref-trackpad-mount-20241202.stl]
2024-12-27 add WIP eDP cable schematic
    [nref-edp-display-cable.kicad_sch]
2024-12-27 add latest PCB updates
    [nref-batterypack.kicad_pcb, nref-batterypack.kicad_sch, nref-motherboard.kicad_pcb, nref-motherboard.kicad_sch, nref-ports-one.kicad_pcb, nref-ports-one.kicad_sch, nref-ports-two.kicad_pcb, nref-ports-two.kicad_sch]
2024-12-27 add latest case integration freecad file
2025-01-13 motherboard: add some notes
    [nref-motherboard.kicad_sch]
2025-01-20 update README about trackpad and camera
2025-02-25 add bq25792 charger to schematic
    [nref-motherboard.kicad_sch]
2025-02-26 remove old charger, add some cap values
    [nref-motherboard.kicad_sch]
2025-02-27 pick some more parts, connect everything
    [nref-motherboard.kicad_sch]
2025-02-27 mb: first routing for new charger ic
    [Part.step, nref-motherboard.kicad_pcb, nref-motherboard.kicad_sch]
2025-02-28 mb: tuning of new charger routing
    [nref-motherboard.kicad_pcb, nref-motherboard.kicad_sch]
2025-03-06 mb: rp2350a routed half the way
    [EAST1616RGBA3.step, RP2350_QFN60.step, nref-motherboard.kicad_pcb, nref-motherboard.kicad_sch]
2025-03-07 mb: fully routed, cleanup left to do
    [nref-motherboard.kicad_pcb]
2025-03-07 mb: wip
    [nref-motherboard.kicad_pcb, nref-motherboard.kicad_sch]
2025-03-08 mb: further pcb cleanups
    [nref-motherboard.kicad_pcb]
2025-03-10 mb: finished layout for d-3 sample production
    [nref-motherboard.kicad_pcb, nref-motherboard.kicad_sch]
2025-03-17 mb d-3: update BOM/parts for buying
    [nref-motherboard.kicad_sch]
2025-04-25 sysctl fw: initial WIP for new charger, rp2350a
2025-05-20 sysctl-fw: implement basic gauge, fix charger limits/controls
    [sysctl.c]
2025-05-21 sysctl: recognize full charge, tweak charging voltage/current
2025-05-23 initial version incl component choices
    [TPS62086RLTR.step, User Library-PCIe_M_2_Key-E_2230_RF.STEP, c-2199119-4-c-3d.stp, c-2199119-7-c-3d.stp, nref-wifi-m2.kicad_pcb, nref-wifi-m2.kicad_sch]
2025-07-02 batterypack: snapshot before merge
    [nref-batterypack.kicad_pcb, nref-batterypack.kicad_sch, s7271-45r.stp]
2025-07-02 snapshot before merge
    [nref-motherboard.kicad_pcb, nref-motherboard.kicad_sch, nref-ports-one.kicad_sch, nref-ports-two.kicad_sch, nref-wifi.kicad_sch, reform-camera.kicad_sch]
2025-07-02 bpack-v3 first snapshot
    [18650-d18mm.step, BQ76905RGRR.step, S7131-45R.stp, SM02B-SRSS-TB.STEP, SM07B-SRSS-TB.STEP, nref-batterypack-backside.kicad_pcb, nref-batterypack-backside.kicad_sch, nref-batterypack.kicad_pcb]
2025-07-03 battpack v3 snapshot
    [BM07B-SRSS-TB.STEP, nref-batterypack-backside.kicad_pcb, nref-batterypack.kicad_pcb, nref-batterypack.kicad_sch]
2025-07-03 battpack v3 (front) rerouting complete
    [nref-batterypack.kicad_pcb, nref-batterypack.kicad_sch]
2025-07-03 battpack v3 (front): routing polishing, 3d models
    [BQ76922RSNR.stp, CSD87501L.stp, L4CA0612LR015FNR.stp, S1741-46R.stp, S70-332002045R.stp, nref-batterypack.kicad_pcb, nref-batterypack.kicad_sch]
2025-07-03 battpack v3 (front) silkscreen
    [nref-batterypack.kicad_pcb]
2025-07-04 batterypack v3 front+back pcbs polished for ordering
    [nref-batterypack-backside.kicad_pcb, nref-batterypack-backside.kicad_sch, nref-batterypack.kicad_pcb, nref-batterypack.kicad_sch]
2025-07-29 add current notes on various schematics
    [nref-batterypack.kicad_sch, nref-motherboard.kicad_sch, nref-ports-one.kicad_sch, nref-ports-two.kicad_sch]
2025-08-01 usb3-redriver: add first pcb design
    [48393-0001.stp, 692121230100.stp, 692122030100.stp, RGE0024C.stp, nref-usb3-redriver.kicad_pcb, nref-usb3-redriver.kicad_sch]
2025-08-11 motherboard: snapshot before d4
    [nref-motherboard.kicad_sch]
2025-08-11 motherboard: WIP some TVS, more notes
    [nref-motherboard.kicad_sch]
2025-08-11 motherboard d4: WIP HS re-routing
    [nref-motherboard.kicad_pcb]
2025-08-15 WIP mb v4 re-routing snapshot
    [nref-motherboard.kicad_pcb, nref-motherboard.kicad_sch]
2025-08-18 WIP MB: add some notes
    [nref-motherboard.kicad_pcb]
2025-08-18 mb v4: WIP routing snapshot, 39 left
    [nref-motherboard.kicad_pcb, nref-motherboard.kicad_sch]
2025-08-20 WIP D-4 fully routed, still needs polishing
    [nref-motherboard.kicad_pcb, nref-motherboard.kicad_sch]
2025-08-21 WIP motherboard d-4: schematics fixes, some protection, hdmi sda/scl fix
    [nref-motherboard.kicad_sch]
2025-08-21 routing snapshot before deskew
    [nref-motherboard.kicad_pcb, nref-motherboard.kicad_sch]
2025-08-21 motherboard d-4: deskew done
    [nref-motherboard.kicad_pcb]
2025-08-21 motherboard d-4: lots of GND/copper/via polishing
    [nref-motherboard.kicad_pcb]
2025-08-22 motherboard d-4: fix some pcie/usb ground issues
    [nref-motherboard.kicad_pcb, nref-motherboard.kicad_sch]
2025-08-22 motherboard d-4: fix some more pcie/usb ground issues
    [nref-motherboard.kicad_pcb]
2025-08-22 motherboard d-4: deskew again
    [nref-motherboard.kicad_pcb]
2025-08-22 motherboard d-4: update silkscreen
    [nref-motherboard.kicad_pcb]
2025-08-22 motherboard d-4: final tweaks
    [nref-motherboard.kicad_pcb]
2025-08-22 motherboard d-4: ordered samples
2025-09-24 sysctl-fw2: get dual pack charging into shape, adjustable current
2025-09-24 Add Trackpad KiCad project
    [Trackpad_IQS9150.kicad_pcb, Trackpad_IQS9150.kicad_sch, Trackpad_IQS9150_1.kicad_sch]
2025-09-24 add various notes in schematics
    [nref-motherboard.kicad_sch, nref-ports-one.kicad_sch, nref-ports-two.kicad_sch, nref-usb3-redriver.kicad_pcb, nref-usb3-redriver.kicad_sch, reform-camera.kicad_sch]
2025-09-24 sysctl-fw2: fix spi reported voltage/amps calc
    [spi_com.c]
2025-09-26 sysctl-fw2: really fix spi reported voltage/amps calc
    [spi_com.c]
2025-09-28 next-sysctl-fw: replace sleep_ms calls in interrupt handlers
    [bq76922.c, next_pack.c, sysctl.c]
2025-10-03 add cable drawings (preliminary)
2025-10-03 flex: add WIP sound cable (6mm too short)
    [nref-flex-sound.kicad_pcb, nref-flex-sound.kicad_sch]
2025-10-03 flex: add WIP usb3 cable
    [nref-flex-usb3-one-130mm.kicad_pcb, nref-flex-usb3-one.kicad_pcb, nref-flex-usb3-one.kicad_sch]
2025-10-03 flex: add WIP pcie cable
    [nref-flex-pcie.kicad_pcb, nref-flex-pcie.kicad_sch]
2025-10-22 camera-adapter: mech. and routing update
    [nref-camera-adapter.kicad_pcb, nref-camera-adapter.kicad_sch]
2025-10-24 ports-one: snapshot before d2
    [nref-ports-one.kicad_sch]
2025-10-24 ports-one: WIP construction site
    [nref-ports-one.kicad_pcb, nref-ports-one.kicad_sch]
2025-10-31 ports-one: schematics with new mux, local 5v, hard reset switch
    [YBG0028_TEX.step, nref-ports-one.kicad_pcb, nref-ports-one.kicad_sch]
2025-10-31 ports-one: add redriver, routing WIP
    [B3U-3000P--3DModel-STEP-56544.STEP, EQCO5X31C0-I_6NX.stp, nref-ports-one.kicad_pcb, nref-ports-one.kicad_sch]
2025-11-04 ports-one: add redriver circuit
    [nref-ports-one.kicad_pcb, nref-ports-one.kicad_sch]
2025-11-05 ports-one: routing snapshot
    [nref-ports-one.kicad_pcb, nref-ports-one.kicad_sch]
2025-11-07 WIP nref-ports-one: routing done, 3d checks to do
    [nref-ports-one.kicad_pcb, nref-ports-one.kicad_sch]
2025-11-12 ports-one: exchange pca chip, polish, add sbu header
    [PCA9557RGVR.stp, SM02B-SRSS-TB.STEP, nref-ports-one.kicad_pcb, nref-ports-one.kicad_sch]
2025-11-14 ports-one: BOM update
    [nref-ports-one.kicad_sch]
2025-11-15 sysctl-fw2: clip uart reporting
2025-11-19 ports-one: polishing/part selections
    [nref-ports-one.kicad_pcb, nref-ports-one.kicad_sch]
2025-11-19 WIP ports-two redesign
    [nref-ports-two.kicad_pcb, nref-ports-two.kicad_sch]
2025-11-19 ports-two: footprints
    [SFV20R-2STE1HLF.step]
2025-11-20 ports-two: more routing
    [nref-ports-two.kicad_pcb, nref-ports-two.kicad_sch]
2025-11-25 commit various flex changes
    [nref-flex-sound.kicad_pcb, nref-flex-usb3-one.kicad_pcb, nref-flex-usb3-one.kicad_sch]
2025-11-25 commit various notes / polishing for ports-one and ports-two
    [nref-ports-one.kicad_sch, nref-ports-two.kicad_pcb, nref-ports-two.kicad_sch]
2025-12-09 ports-one: add TODOs after hw debugging
    [nref-ports-one.kicad_sch]
2025-12-09 ports-two: add TODOs after hw debugging
    [nref-ports-two.kicad_sch]
2025-12-16 ports-one: fix u9 pinout; remove r23
    [nref-ports-one.kicad_pcb, nref-ports-one.kicad_sch]
2026-01-10 sysctl-fw2: implement changes for new port board left incl usb-c power mux; fix battery pack shutdown/uv mode
    [bq25792.c, next_gpio.c, next_gpio.h, next_pack.c, pd_com.c, sysctl.c, sysctl.h]
2026-03-23 MB: add notes
    [nref-motherboard.kicad_sch]
2026-03-23 WIP: mb: 2280 SSD
    [SSD-2280-D2-M-B.STEP, nref-motherboard.kicad_pcb, nref-motherboard.kicad_sch]
2026-03-25 mainboard: finish R-1 routing
    [SM02B-SRSS-TB.STEP, SM03B-SRSS-TB_LF__SN_.stp, SM04B-SRSS-TB.STEP, SM06B-SRSS-TB.STEP, SM07B-SRSS-TB.STEP, SM09B-SRSS-TB.STEP, nref-motherboard.kicad_pcb, nref-motherboard.kicad_sch]
2026-03-27 sysctl-fw: experimentally accept datarole switch; turn off 5v usb host power when switching to power sink
2026-03-27 PCBs: add various notes
    [nref-batterypack.kicad_sch, nref-flex-usb3-one.kicad_pcb, nref-motherboard.kicad_pcb, nref-motherboard.kicad_sch, nref-ports-two.kicad_pcb, nref-ports-two.kicad_sch, nref-trackpad.kicad_pcb]
2026-03-27 MB WIP: one todo left (usb2 switcheroo)
    [nref-motherboard.kicad_sch]
2026-03-31 WIP mb: add countless usb muxes and usb uart
    [nref-motherboard.kicad_pcb, nref-motherboard.kicad_sch]
2026-04-01 mainboard: 1.0 r1 pcb done
    [AOTA-B201610S3R3-101-T.stp, SSD.STEP, nref-motherboard.kicad_pcb, nref-motherboard.kicad_sch]
2026-04-01 mainboard 1.0: part choices
    [nref-motherboard.kicad_sch]
2026-04-01 mainboard 1.0: pcb adjustment for part choices
    [nref-motherboard.kicad_pcb]
2026-04-09 batterypack back/front: polishing for production
    [nref-batterypack-backside.kicad_pcb, nref-batterypack-backside.kicad_sch, nref-batterypack.kicad_pcb, nref-batterypack.kicad_sch]
2026-04-09 mainboard: production parts
    [nref-motherboard.kicad_sch]
2026-04-09 trackpad sensor: redesign pcb shape for production
    [Trackpad_IQS9150.kicad_pcb, Trackpad_IQS9150_1.kicad_sch]
2026-05-21 SC: mb usb switches support, WIP debug stuff
2026-06-16 ports-two: snapshot of r2 before switch to nxp redriver
    [EQCO5X31C0-I_6NX.stp, FPC-SMD_L15.6-W5.4-H2.0-AFC07-S20ECC-00.step, RKS0020A.stp, USB-A-SMD_HC-USB3.0-C225-P.step, nref-ports-two.kicad_pcb, nref-ports-two.kicad_sch]
2026-07-24 tpsensor: adjust exposed GND areas
    [Trackpad_IQS9150.kicad_pcb]
2026-08-10 add trackpad mounting hex plugs
    [nref-20260419-hexplug.stl]
2026-08-11 sysctl: add checksum support, fix LEDs, fix warm state
    [bq25792.c, next_gpio.c, next_gpio.h, pd_com.c, spi_com.c, sysctl.c, sysctl.h]
2026-08-20 trackpad pcb update for tight outline
    [Trackpad_IQS9150.kicad_pcb]
2026-09-02 mainboard: clean up schematics for book
    [nref-motherboard.kicad_pcb, nref-motherboard.kicad_sch]
2026-09-02 trackpad: pcb traces adjustment for prod
    [Trackpad_IQS9150.kicad_pcb, Trackpad_IQS9150.kicad_sch, Trackpad_IQS9150_1.kicad_sch]
2026-09-02 cables cleanup
2026-09-02 more cable cleanup
2026-09-02 flex pcb files updates
    [nref-flex-dp-140mm.kicad_pcb, nref-flex-eth.kicad_pcb, nref-flex-eth.kicad_sch, nref-flex-hdmi.kicad_pcb, nref-flex-hdmi.kicad_sch, nref-flex-sdcard.kicad_pcb, nref-flex-sdcard.kicad_sch, nref-flex-usb3-camera.kicad_pcb]
2026-09-02 ports left/one fixes
    [634108150321.step, HX5084NLT.stp, RKS0020A.stp, nref-ports-one.kicad_pcb, nref-ports-one.kicad_sch]
2026-09-02 ports two/right smol updates
    [nref-ports-two.kicad_pcb, nref-ports-two.kicad_sch]
2026-09-02 batterypack production updates
    [2036-3-57-15-00-00-03-0.stp, BAT-SMD_MY-FJ-115.step, nref-batterypack-backside.kicad_pcb, nref-batterypack-backside.kicad_sch, nref-batterypack.kicad_pcb, nref-batterypack.kicad_sch]
2026-09-02 wifi/bt board prod updates
    [nref-wifi-m2.kicad_pcb, nref-wifi-m2.kicad_sch]
2026-09-02 clean up major schematics for book
    [Trackpad_IQS9150.kicad_sch, Trackpad_IQS9150_1.kicad_sch, nref-motherboard.kicad_sch, nref-ports-one.kicad_sch, nref-ports-two.kicad_sch]
2026-09-08 small schematic cleanups for book
    [nref-batterypack-backside.kicad_sch, nref-batterypack.kicad_sch, nref-ports-one.kicad_sch, nref-ports-two.kicad_sch, nref-wifi-m2.kicad_sch]
2026-09-08 sysctl-fw: fix cli inits, legacy kbd compat
    [cli_usb.c, cli_usb.h, machine_next.h, next_command.c, next_pack.h, sysctl.c]
2026-09-08 sysctl-fw: set up usb mux defaults on power on/off
2026-09-09 sysctl-fw: fix some bugs in next_command.c found by stephano
    [cli.c, next_command.c]
2026-09-09 sysctl-fw: rewrite gauge algorithm; snap to estimation by voltage at rest
    [machine_next.c, next_pack.c, next_pack.h]
2026-09-10 sysctl-fw: store machine pointer in cli context; fix UB struct access in legacy power on/off
    [cli.h, cli_usb.c, cli_usb.h, next_command.c, next_rail.c, spi_com.c]
2026-09-10 sysctl-fw: change spi handling to chip select irq like on pocket
2026-09-14 fix spi cli timing, legacy cmds, machine power specs, some restructuring
    [cli.h, machine_next.c, machine_next.h, next_charger.c, next_charger.h, next_command.c, next_gpio.c]
2026-09-14 fix power_calculations to handle any config of 0-2 packs
    [machine_next.c]
2026-09-15 more gauge refinements, command for setting cell capacity
2026-09-16 more charge estimation tweaks; estimate time to full in debug mode
2026-09-23 implement (shipmode) to turn off battery pack discharge for shipping
