cetola/reform-next-mirror/(notices)

Notices in the files:
nref-motherboard/3d-models/TSM-106-02-X-SH-A.step:
author */ ('License CC BY-ND 4.0'),
hdmi-edp2/hdmi-edp2.kicad_sch:
License: CERN-OHL-S 2.0
